OpenKNX/OpenKNX-REG1/doc/Pictures/Assembly-REG1-Dali/Originalgroesse/20240128_120950.jpg

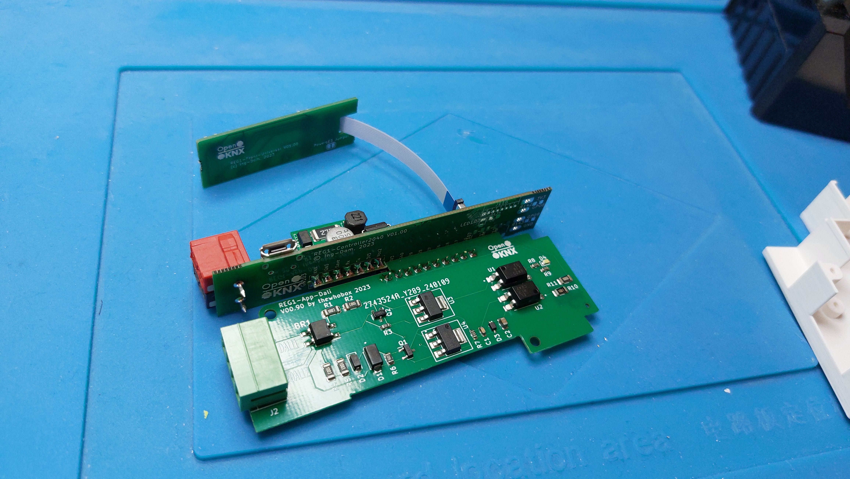
doc/Pictures/Assembly-REG1-Dali/Originalgroesse/20240128_120950.jpg
