OpenKNX/OpenKNX-REG1/doc/Pictures/Assembly-REG1-Eth/Originalgroesse/REG1-Eth_kit_RJ45soldered.jpg

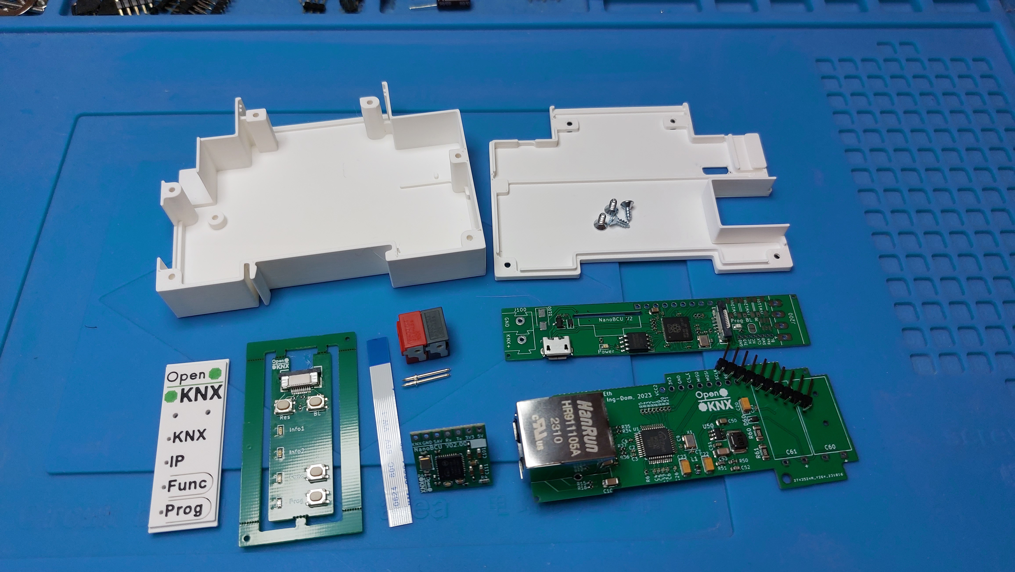
doc/Pictures/Assembly-REG1-Eth/Originalgroesse/REG1-Eth_kit_RJ45soldered.jpg
