OpenKNX/OpenKNX-REG1/README.md

# OpenKNX-REG1

see Wiki: https://github.com/OpenKNX/OpenKNX/wiki/OpenKNX-REG1
