OpenKNX/OpenKNX-REG1/doc/Labels/REG1-Dali_Label.png

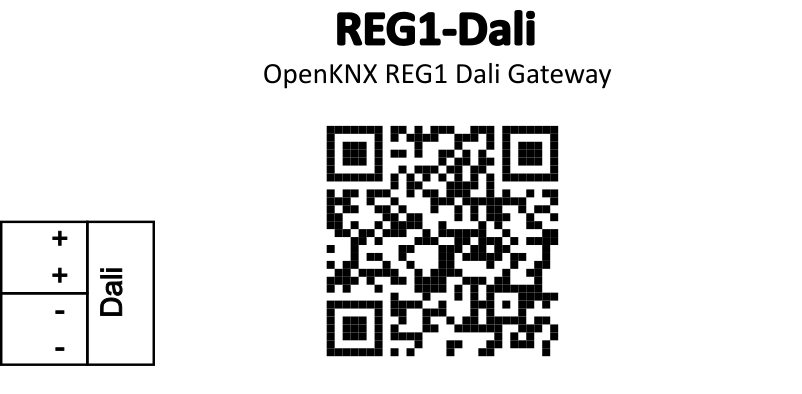
doc/Labels/REG1-Dali_Label.png
