OpenKNX/OpenKNX-REG1/doc/Labels/REG1-SA-4xSELV_Label.png

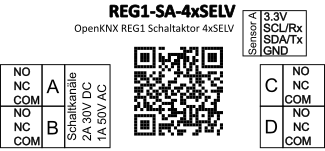
doc/Labels/REG1-SA-4xSELV_Label.png
