OpenKNX/OpenKNX-REG1/doc/Labels/REG1-SEN-Multi_Label.png

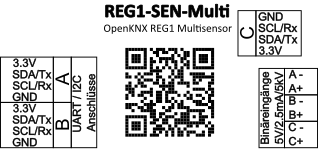
doc/Labels/REG1-SEN-Multi_Label.png
