OpenKNX/OpenKNX-REG1/doc/Pictures/REG1-Controller2040_V00.03_top.jpg

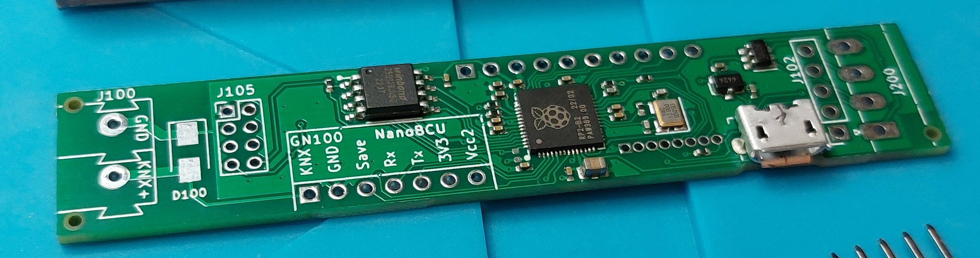
doc/Pictures/REG1-Controller2040_V00.03_top.jpg
