OpenKNX/OpenKNX-REG1/doc/Pictures/REG1-Controller2040_V1_top.jpg

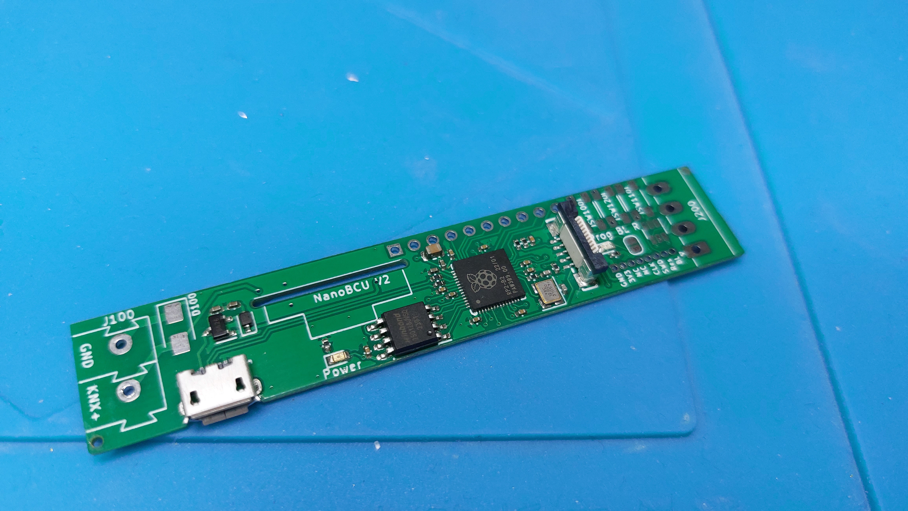
doc/Pictures/REG1-Controller2040_V1_top.jpg
