OpenKNX/OpenKNX-REG1/doc/Pictures/REG1-Frontabdeckung-IP-Router.jpg

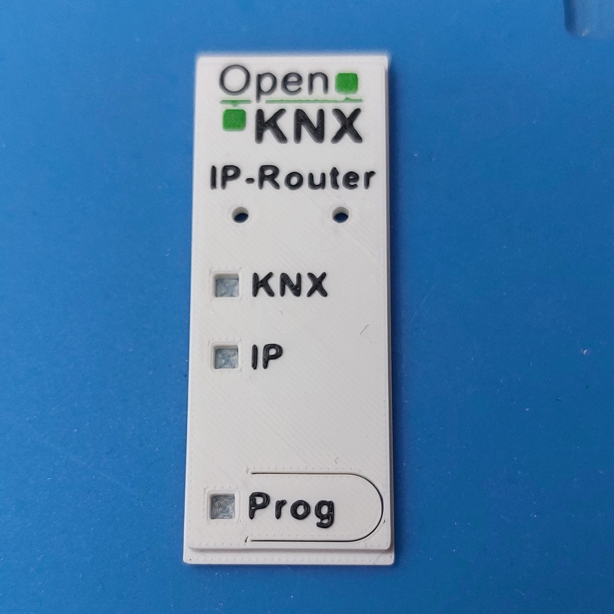
doc/Pictures/REG1-Frontabdeckung-IP-Router.jpg
