OpenKNX/OpenKNX-REG1/doc/Pictures/REG1-Frontabdeckung.jpg

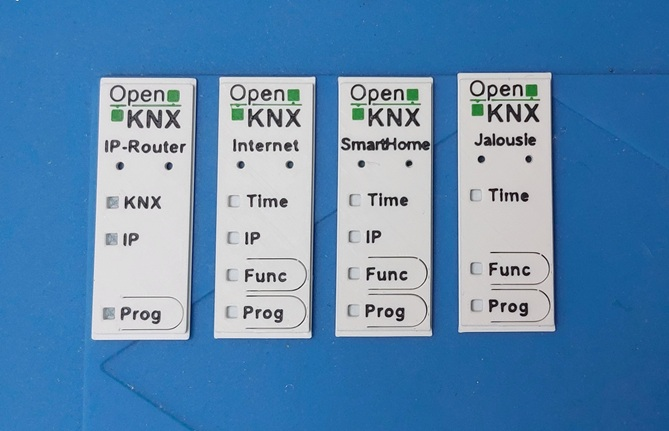
doc/Pictures/REG1-Frontabdeckung.jpg
