OpenKNX/OpenKNX-REG1/doc/REG1-Controller_Messpunkte.png

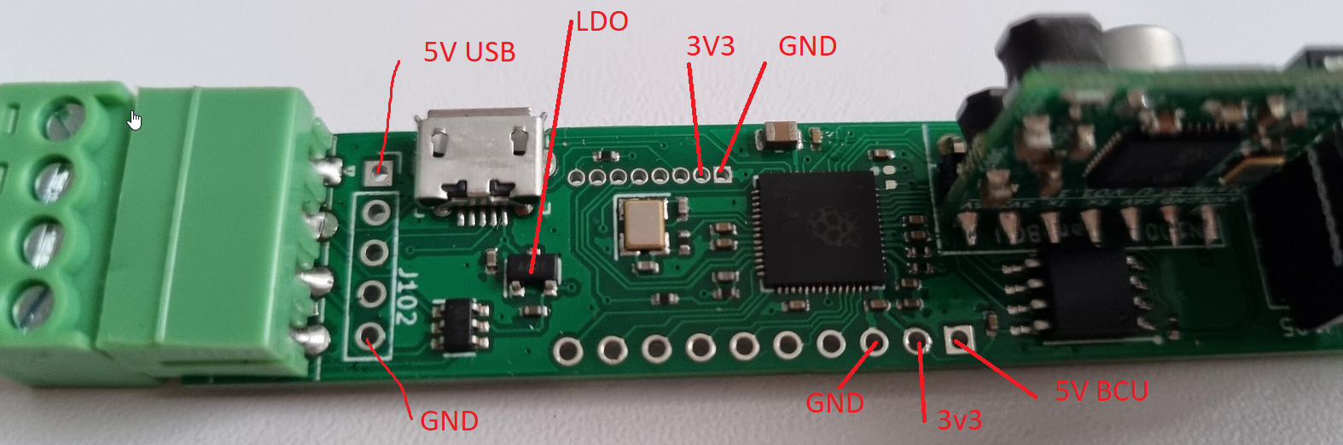
doc/REG1-Controller_Messpunkte.png
