OpenKNX/OpenKNX-REG1/doc/Renderings/OpenKNX_REG1_Base_and_App_Teaser_CATIA_open2.png

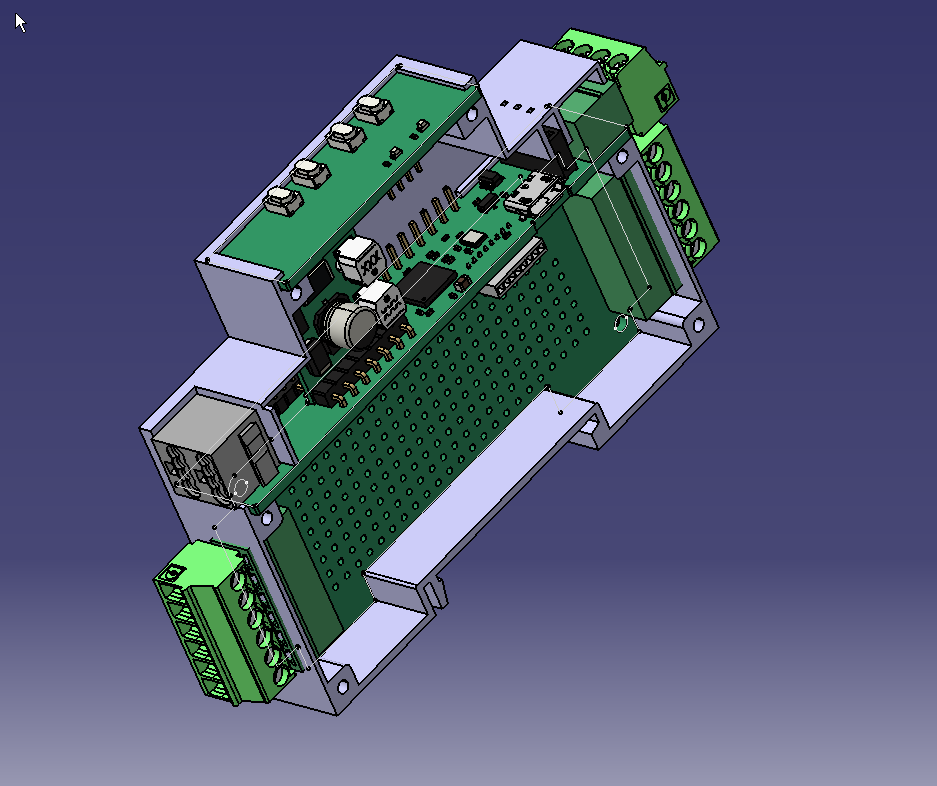
doc/Renderings/OpenKNX_REG1_Base_and_App_Teaser_CATIA_open2.png
