OpenKNX/OpenKNX-REG1/doc/Renderings/OpenKNX_REG1_Base_Teaser_CATIA.png

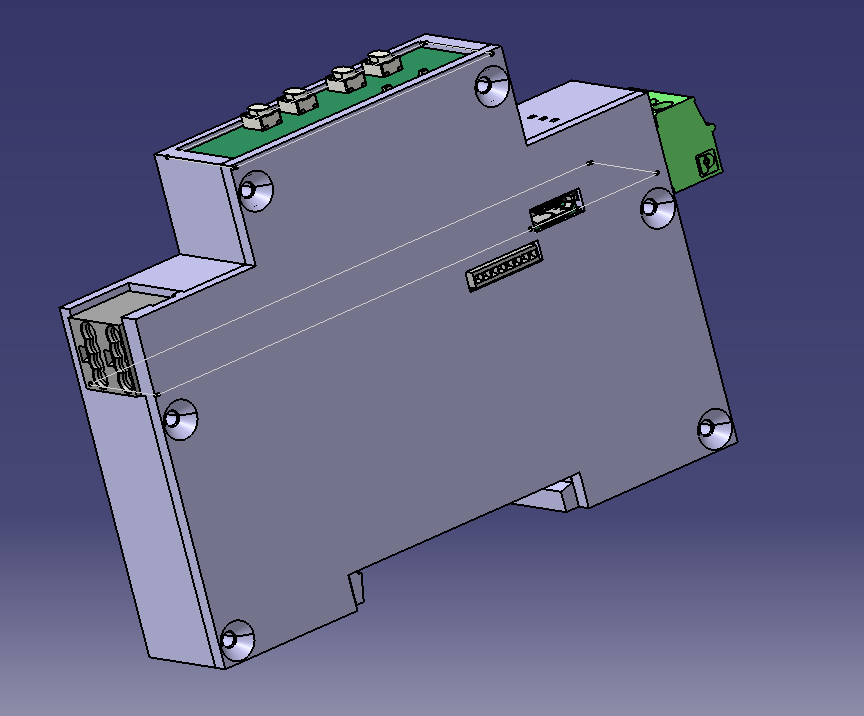
doc/Renderings/OpenKNX_REG1_Base_Teaser_CATIA.png
