OpenKNX/OpenKNX-REG1/doc/Renderings/OpenKNX_REG1_Module_Teaser_CATIA_open.png

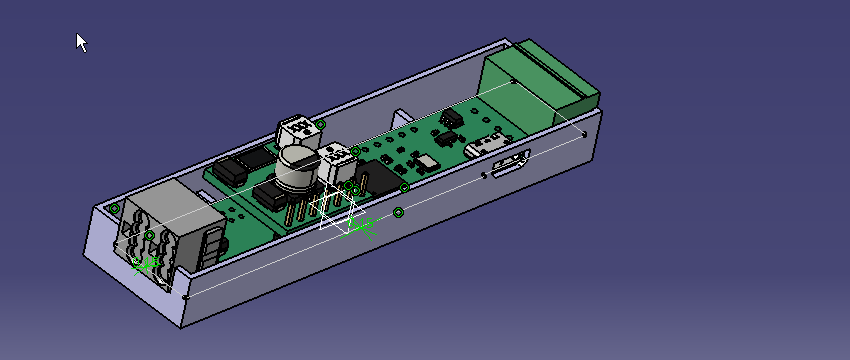
doc/Renderings/OpenKNX_REG1_Module_Teaser_CATIA_open.png
