OpenKNX/OpenKNX-REG1/doc/Renderings/REG1-App-Universal_V01.00_3D_PCB_TOP.png

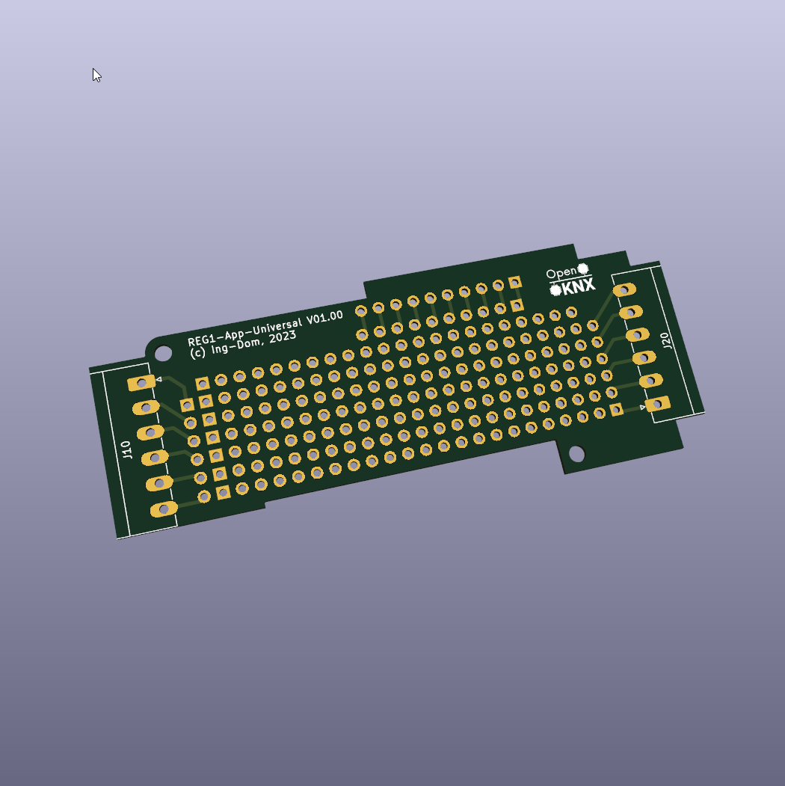
doc/Renderings/REG1-App-Universal_V01.00_3D_PCB_TOP.png
