OpenKNX/OpenKNX-REG1/doc/Renderings/REG1-Controller2040_V00.02_3D_BOT_wo_THT.png

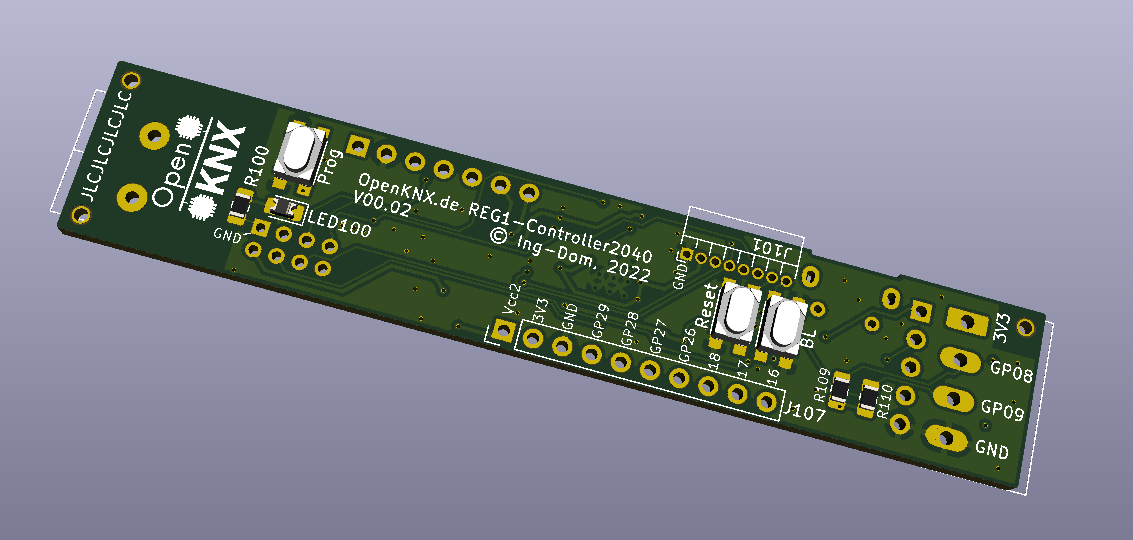
doc/Renderings/REG1-Controller2040_V00.02_3D_BOT_wo_THT.png
