OpenKNX/OpenKNX-REG1/doc/Renderings/REG1-Controller2040_V00.02_3D_TOP.png

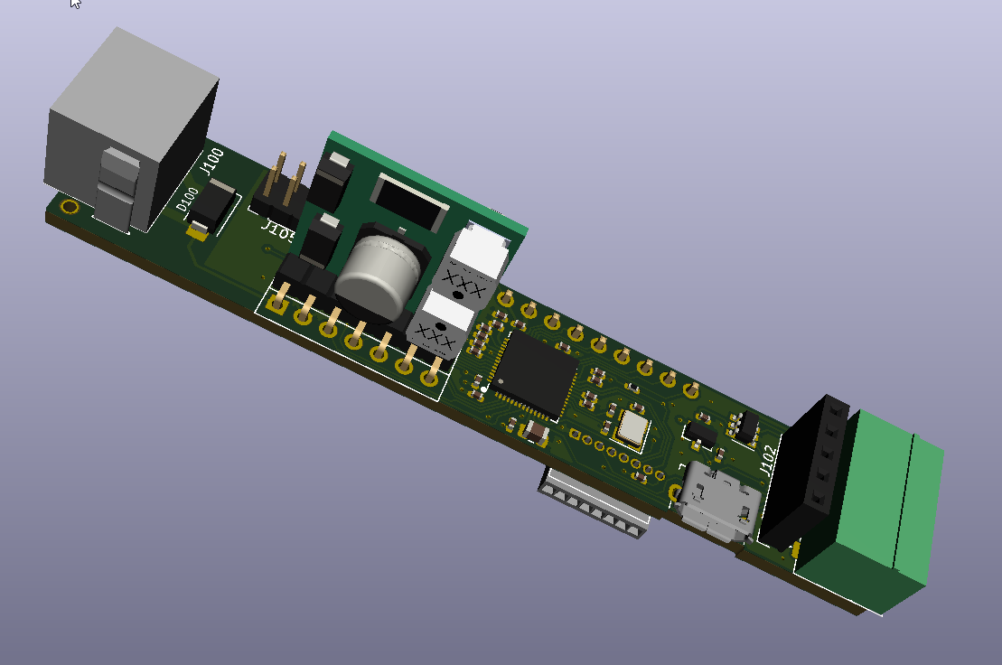
doc/Renderings/REG1-Controller2040_V00.02_3D_TOP.png
