OpenKNX/OpenKNX-REG1/doc/Renderings/REG1-Controller2040_V00.10_3D_wo_THT_BOT.png

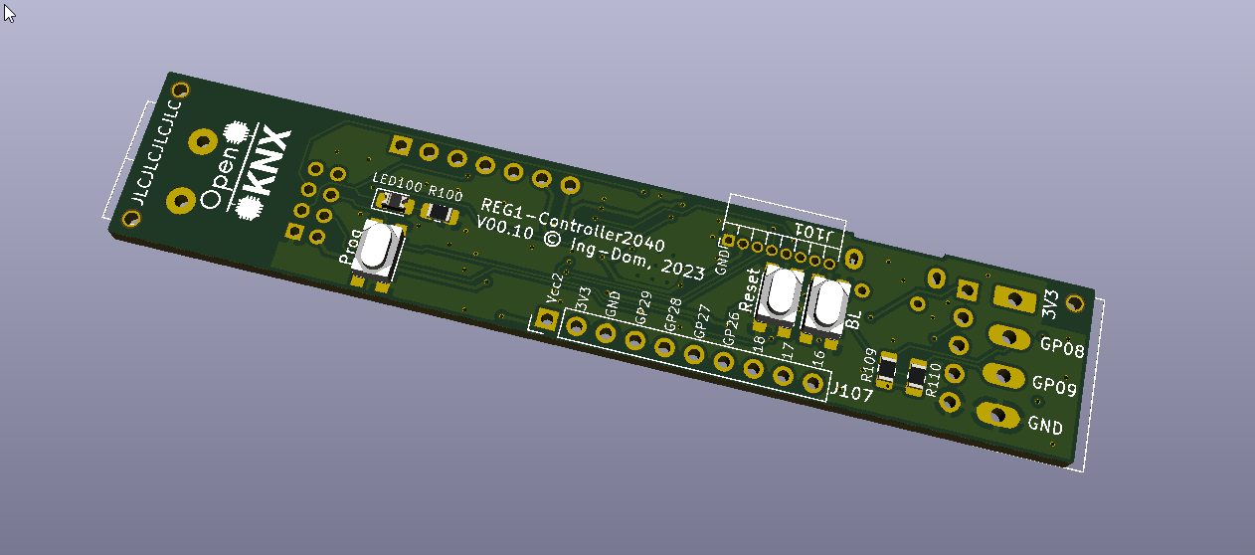
doc/Renderings/REG1-Controller2040_V00.10_3D_wo_THT_BOT.png
