OpenKNX/OpenKNX-REG1/hardware/CAD-Files/V01.2/Base/Reg1_Case_Main_wIO_V01.20.stl

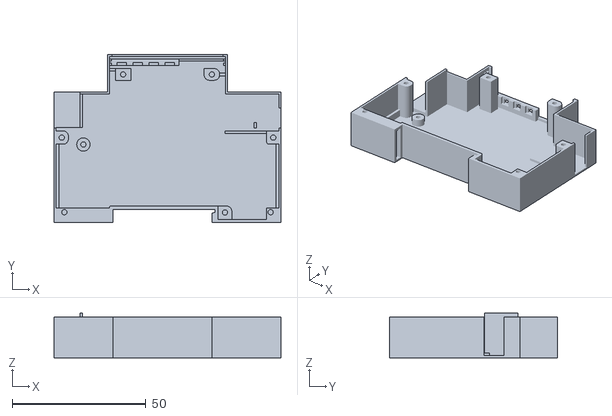
[picture p26: CAD file, 2025-07-13]
hardware/CAD-Files/V01.2/Base/Reg1_Case_Main_wIO_V01.20.stl
85.0 x 63.0 x 16.7
