OpenKNX/OpenKNX-REG1/hardware/CAD-Files/V01.2/LAN-Base/Reg1_CaseIP_Main_ESP_LAN_V01.20a.stl

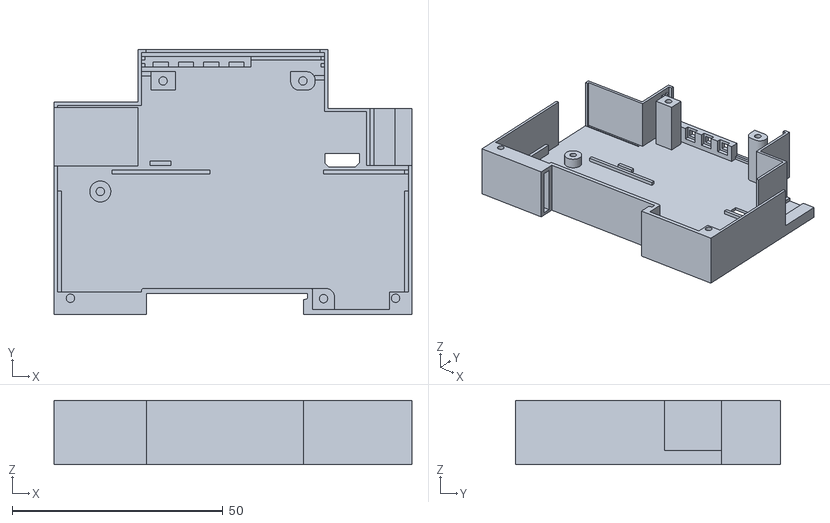
[picture p27: CAD file, 2025-07-31]
hardware/CAD-Files/V01.2/LAN-Base/Reg1_CaseIP_Main_ESP_LAN_V01.20a.stl
85.0 x 63.0 x 15.2
