OpenKNX/OpenKNX-REG1/hardware/CAD-Files/V01.2/SA-SELV/Reg1_Case_Main_wIO_SASELV_V01.20.stl

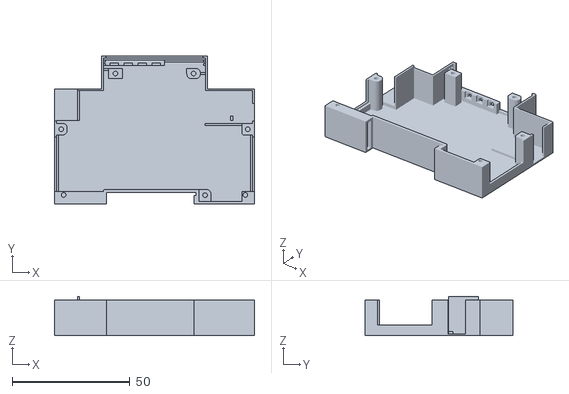
[picture p28: CAD file, 2025-08-14]
hardware/CAD-Files/V01.2/SA-SELV/Reg1_Case_Main_wIO_SASELV_V01.20.stl
85.0 x 63.0 x 16.7
