OpenKNX/OpenKNX-REG1/hardware/CAD-Files/V01.2/LAN-Base/Reg1_CaseIP_Main_ESP_LAN_v01.20.stl

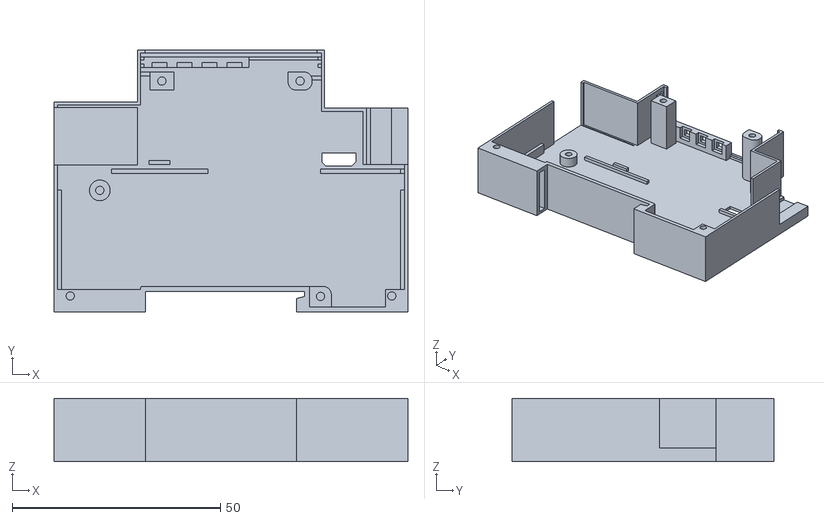
[picture p29: CAD file, 2025-07-13]
hardware/CAD-Files/V01.2/LAN-Base/Reg1_CaseIP_Main_ESP_LAN_v01.20.stl
85.0 x 63.0 x 15.2
