OpenKNX/OpenKNX-REG1/hardware/CAD-Files/V01.2/Dali/Reg1_Case_Cover_wDali_noDebug_noIO_V01.20.stl

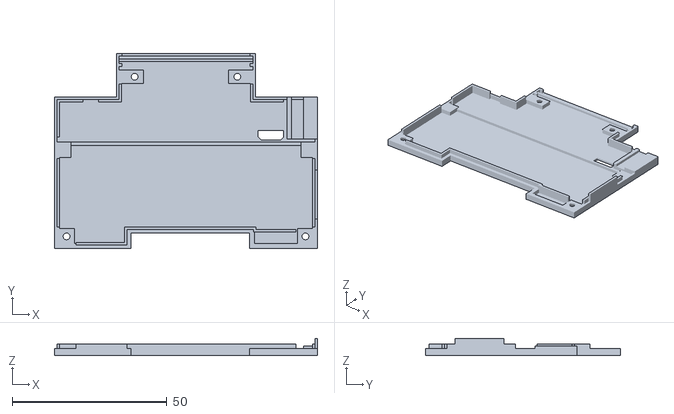
[picture p30: CAD file, 2025-02-02]
hardware/CAD-Files/V01.2/Dali/Reg1_Case_Cover_wDali_noDebug_noIO_V01.20.stl
85.0 x 63.0 x 5.60
