OpenKNX/OpenKNX-REG1/hardware/CAD-Files/V01.2/Reg1_Case_SpringClamp_V01.10.stl

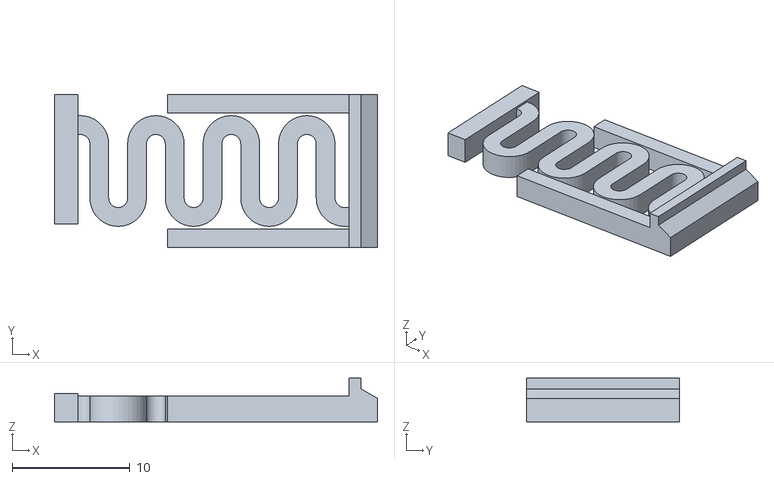
[picture p31: CAD file, 2025-08-14]
hardware/CAD-Files/V01.2/Reg1_Case_SpringClamp_V01.10.stl
27.4 x 13.0 x 3.70
