OpenKNX/OpenKNX-REG1/hardware/EDA-Files/NanoDCU/NanoDCU.step

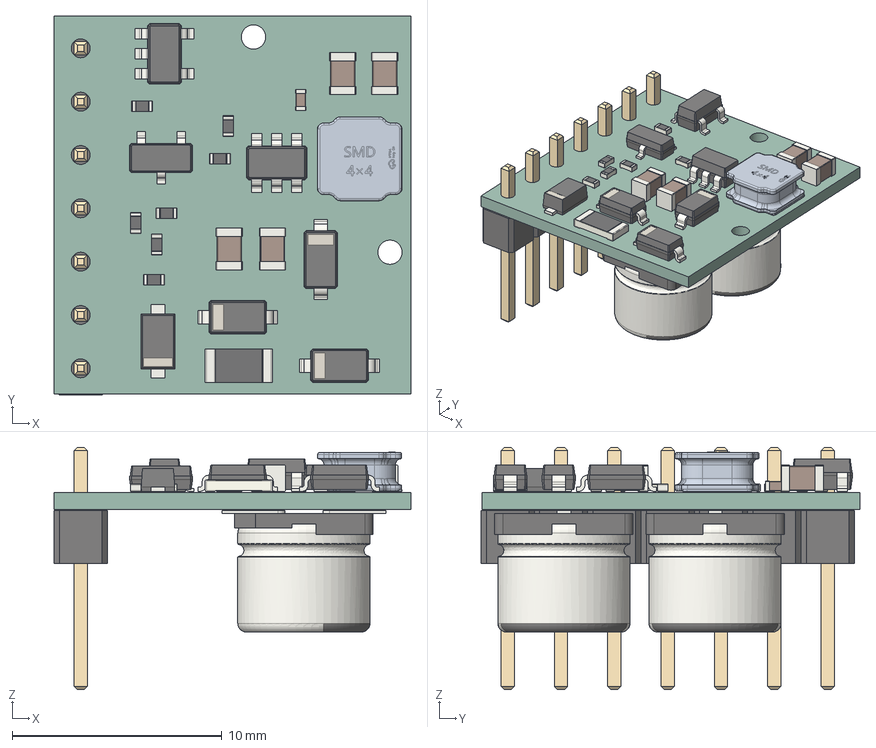
[picture p32: CAD file, 2026-04-14]
hardware/EDA-Files/NanoDCU/NanoDCU.step
17.0 x 18.0 x 11.5 mm
D_SOD_123 x 3
SOT_23_5
R_0402_1005Metric x 7
L1
C_0805_2012Metric x 4
SOT_23
SOT_23_6
Fuse_1206_3216Metric
C_0402_1005Metric
D_SOD_123F
PinHeader_1x07_P254mm_Vertical
CP_Elec_63x58 x 2
NanoDCU_PCB
