OpenKNX/OpenKNX-REG1/hardware/EDA-Files/REG1-App-2xDALI/REG1-App-2xDALI_V00.01.step

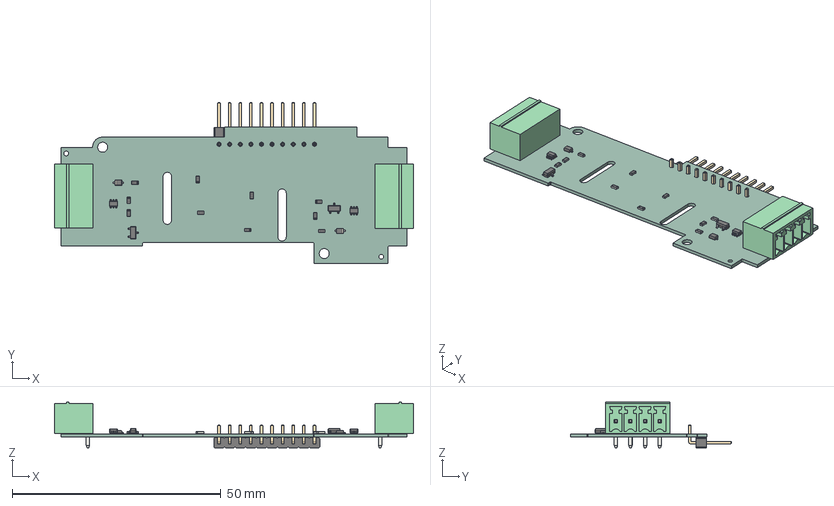
[picture p33: CAD file, 2025-02-02]
hardware/EDA-Files/REG1-App-2xDALI/REG1-App-2xDALI_V00.01.step
86.0 x 38.6 x 11.0 mm
SOT_363_SC_70_6 x 2
R_0603_1608Metric x 10
MC_01x04_G_3_5mm x 2
D_SOD_323F x 2
SOT_23 x 2
PinHeader_1x10_P254mm_Horizontal
REG1-App-2xDALI_PCB
