OpenKNX/OpenKNX-REG1/hardware/EDA-Files/REG1-App-GW-RF2G4/REG1-App-GW-RF2G4_V00.01.step

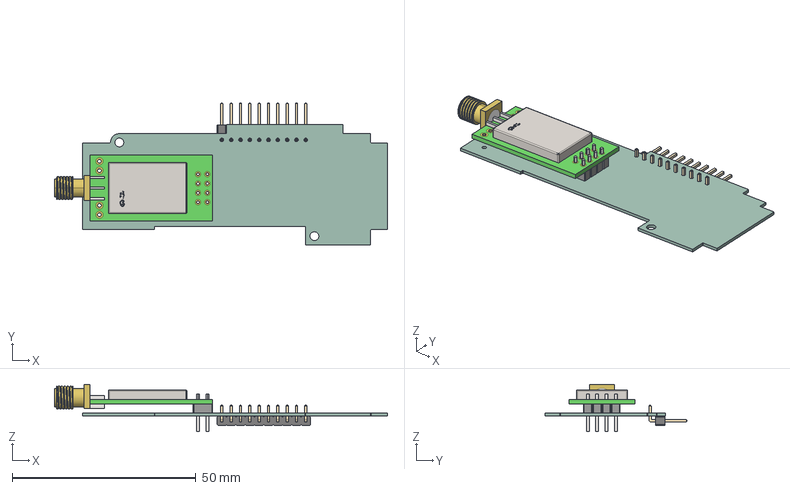
[picture p34: CAD file, 2024-08-03]
hardware/EDA-Files/REG1-App-GW-RF2G4/REG1-App-GW-RF2G4_V00.01.step
90.7 x 38.6 x 12.8 mm
REG1-App-GW-RF2G4 PCB
