OpenKNX/OpenKNX-REG1/hardware/EDA-Files/REG1-App-SA-4xSELV/REG1-App-SA-4xSELV.step

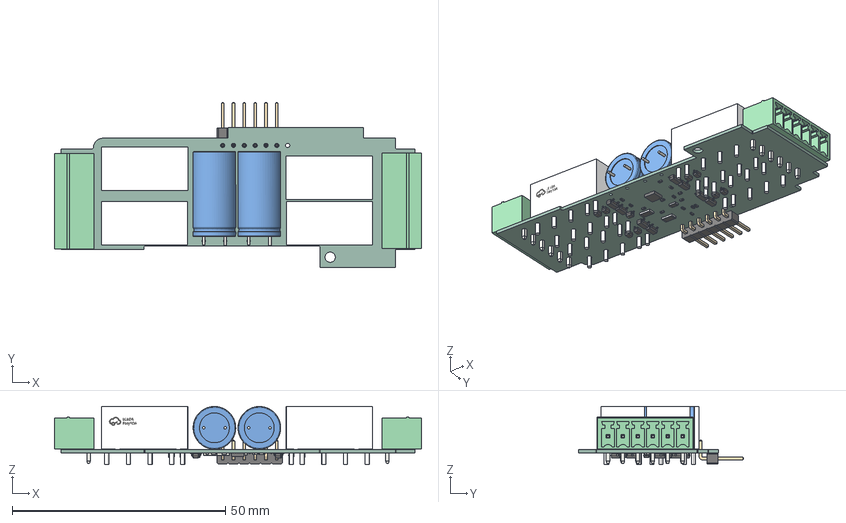
[picture p35: CAD file, 2025-08-14]
hardware/EDA-Files/REG1-App-SA-4xSELV/REG1-App-SA-4xSELV.step
86.0 x 38.6 x 13.6 mm
MC_01x06_G_3_5mm x 2
C_Radial_D100mm_H200mm_P500mm x 2
RELAY-TH_HFD2-X-X-L2-X x 4
PinHeader_1x06_P254mm_Horizontal
R_0402_1005Metric x 14
D_SOD_323 x 9
R_0805_2012Metric
SOT_23 x 8
R_1206_3216Metric x 2
QFN-16-1EP_3x3mm_P0.5mm_EP1.7x1.7mm
REG1-App-SA-4xSELV_PCB
