OpenKNX/OpenKNX-REG1/hardware/EDA-Files/REG1-App-Universal/REG1-App-Universal_V01.10.step

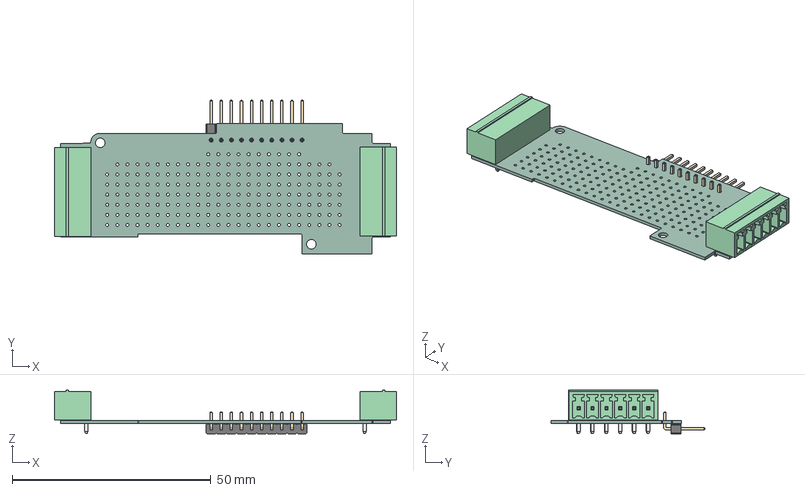
[picture p36: CAD file, 2024-12-03]
hardware/EDA-Files/REG1-App-Universal/REG1-App-Universal_V01.10.step
86.0 x 38.6 x 11.0 mm
MC_01x06_G_3_5mm x 2
PinHeader_1x10_P254mm_Horizontal
REG1-App-Universal_PCB
