OpenKNX/OpenKNX-REG1/hardware/CAD-Files/V01.2/Base/Reg1_Case_Cover_wIO_wDebug_V01.20.stl

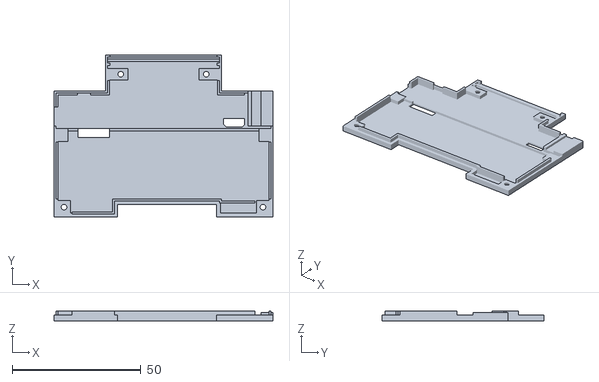
[picture p37: CAD file, 2025-07-13]
hardware/CAD-Files/V01.2/Base/Reg1_Case_Cover_wIO_wDebug_V01.20.stl
85.0 x 63.0 x 3.80
