OpenKNX/OpenKNX-REG1/hardware/CAD-Files/V01.2/Eth/Reg1_Case_Cover_wEth_noDebug_noIO_V01.20.stl

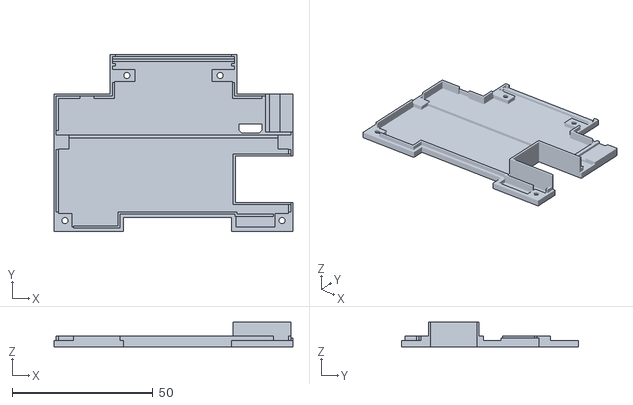
[picture p38: CAD file, 2025-07-13]
hardware/CAD-Files/V01.2/Eth/Reg1_Case_Cover_wEth_noDebug_noIO_V01.20.stl
85.0 x 63.0 x 8.80
