OpenKNX/OpenKNX-REG1/hardware/CAD-Files/V01.2/REG1-Case-Front-Universal_RGB_Diffusor_V01.20.stl

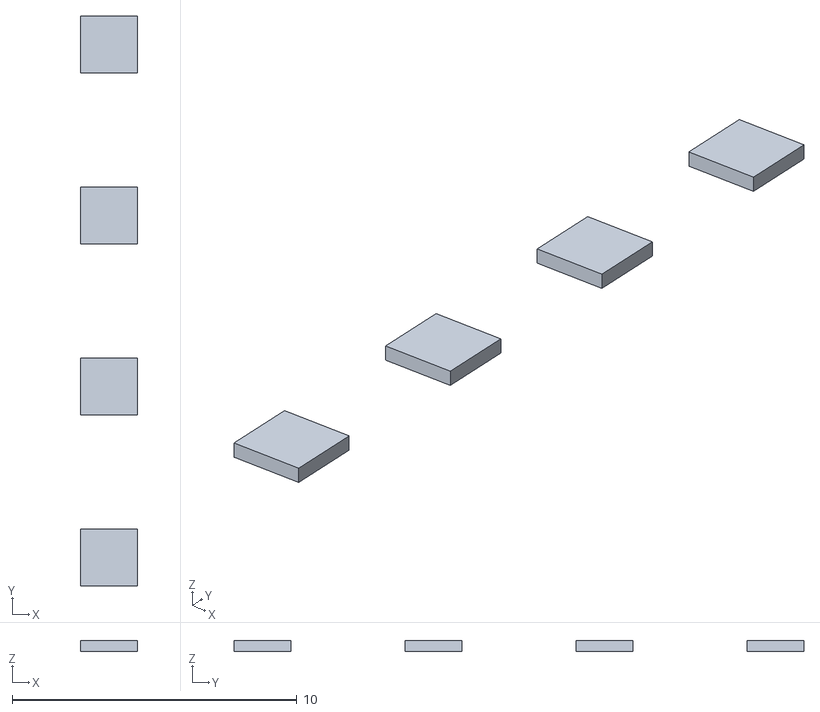
[picture p39: CAD file, 2025-07-13]
hardware/CAD-Files/V01.2/REG1-Case-Front-Universal_RGB_Diffusor_V01.20.stl
2.00 x 20.0 x 0.4
