OpenKNX/OpenKNX-REG1/hardware/CAD-Files/V01.2/REG1-Case-Front-Universal_RGB_V01.20.stl

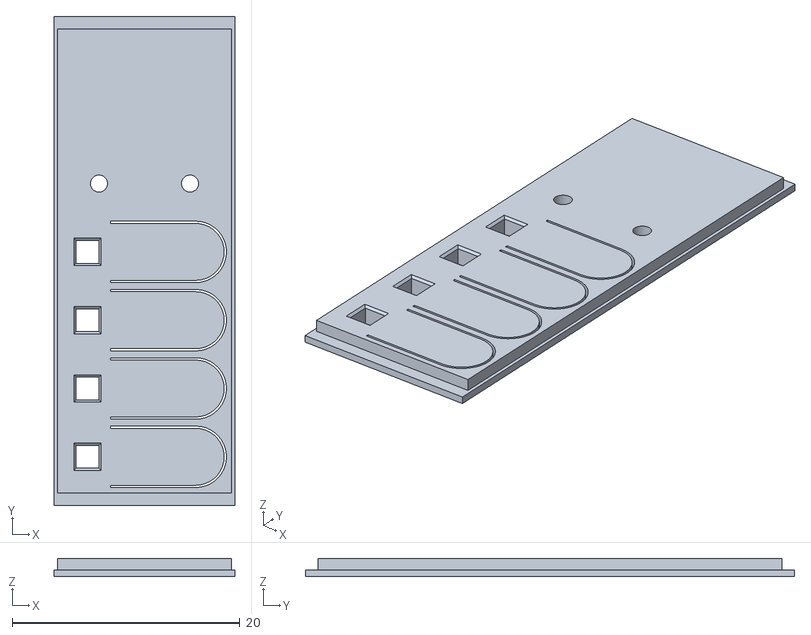
[picture p40: CAD file, 2025-02-02]
hardware/CAD-Files/V01.2/REG1-Case-Front-Universal_RGB_V01.20.stl
15.9 x 43.0 x 1.60
