OpenKNX/OpenKNX-REG1/(list of files, cad)

Other CAD files:
hardware/CAD-Files/V01.2/Eth/Reg1_Case_Main_wEth_noSD_noIO_V01.20.stl
hardware/CAD-Files/V01.2/LAN-Dali/Reg1_CaseIP_Main_LAN-Dali_V01.20.stl
hardware/CAD-Files/V01.2/Universal/Reg1_Case_Main_Universal_V01.20.stl
hardware/CAD-Files/V01.2/Dali/Reg1_Case_Main_wDali_noIO_V01.20.stl
hardware/CAD-Files/V01.2/SEN-Multi/Reg1_Case_Main_wIO_SENMULTI_wRJ11_V01.20.stl
hardware/CAD-Files/V01.2/SEN-Multi/Reg1_Case_Cover_wDebug_SEN-MULTI_RJ11_V01.20.stl
hardware/CAD-Files/V01.2/LAN-Base/Reg1_CaseIP_Cover_ESP_LAN_V01.20.stl
hardware/CAD-Files/V01.2/LAN-Dali/Reg1_CaseIP_Cover_LAN-Dali_V01.20.stl
hardware/CAD-Files/V01.2/SA-SELV/Reg1_Case_Cover_wIO_noDebug_SA-SELV_V01.20.stl
hardware/CAD-Files/V01.2/Universal/Reg1_Case_Cover_Universal_wDebug_V01.20.stl
hardware/CAD-Files/V01.2/Base/Reg1_Case_Cover_wIO_noDebug_V01.20.stl
hardware/CAD-Files/V01.2/Dali/Reg1_Case_Cover_wDali_wDebug_noIO_V01.20.stl
hardware/CAD-Files/V01.2/Eth/Reg1_Case_Cover_wEth_wDebug_noIO_V01.20.stl
hardware/CAD-Files/V01.2/SA-SELV/Reg1_Case_Cover_wIO_wDebug_SA-SELV_V01.20.stl
hardware/CAD-Files/V01.2/SEN-Multi/Reg1_Case_Cover_noDebug_SEN-MULTI_RJ11_V01.20.stl
hardware/CAD-Files/V01.2/Universal/Reg1_Case_Cover_Universal_V01.20.stl
hardware/CAD-Files/V0/REG1-Controller-Module-Case-Bottom.stl
hardware/CAD-Files/V0/REG1-Controller-Module-Case-Top.stl
hardware/CAD-Files/V0/Reg1_Case_Cover.stl
hardware/CAD-Files/V0/Reg1_Case_Cover_SWD.stl
hardware/CAD-Files/V0/Reg1_Main_Case.stl
hardware/CAD-Files/V01/REG1-Case-Front-Universal_V01.00.stl
hardware/CAD-Files/V01/REG1-Case-Front-Universal_V01.00_Base.3mf
hardware/CAD-Files/V01/REG1-Case-Front-Universal_V01.00_Dali.3mf
hardware/CAD-Files/V01/REG1-Case-Front-Universal_V01.00_Eth.3mf
hardware/CAD-Files/V01/REG1-Case-Front-Universal_V01.00_wLogo_wText_all.3mf
hardware/CAD-Files/V01/Reg1_CaseIP_Cover_V01.00.stl
hardware/CAD-Files/V01/Reg1_CaseIP_Cover_wApp_V01.00.stl
hardware/CAD-Files/V01/Reg1_CaseIP_Main_V01.00.stl
hardware/CAD-Files/V01/Reg1_CaseIP_Main_wApp_V01.00.stl
hardware/CAD-Files/V01/Reg1_Case_Cover_wApp_wDebug_wIO_V01.00.stl
hardware/CAD-Files/V01/Reg1_Case_Cover_wDali_noDebug_noIO_V01.00.stl
hardware/CAD-Files/V01/Reg1_Case_Cover_wEth_noDebug_noIO_V01.00.stl
hardware/CAD-Files/V01/Reg1_Case_Cover_wEth_noIO_V01.00.stl
hardware/CAD-Files/V01/Reg1_Case_Cover_wIO_noDebug_V01.00.stl
hardware/CAD-Files/V01/Reg1_Case_Cover_wIO_wDebug_V01.00.stl
hardware/CAD-Files/V01/Reg1_Case_Main_wApp_wIO_V01.00.stl
hardware/CAD-Files/V01/Reg1_Case_Main_wDali_noIO_V01.00.stl
hardware/CAD-Files/V01/Reg1_Case_Main_wEth_wIO_V01.00.stl
hardware/CAD-Files/V01/Reg1_Case_Main_wEth_wSD_noIO_V01.00.stl
hardware/CAD-Files/V01/Reg1_Case_Main_wIO_V01.00.stl
hardware/CAD-Files/V01/Reg1_Case_SpringClamp.stp
