OpenKNX/OpenKNX-REG1/doc/Pictures/Assembly-REG1-Base-IP/Originalgroesse/REG1-Base-IP_Assembly02.jpg

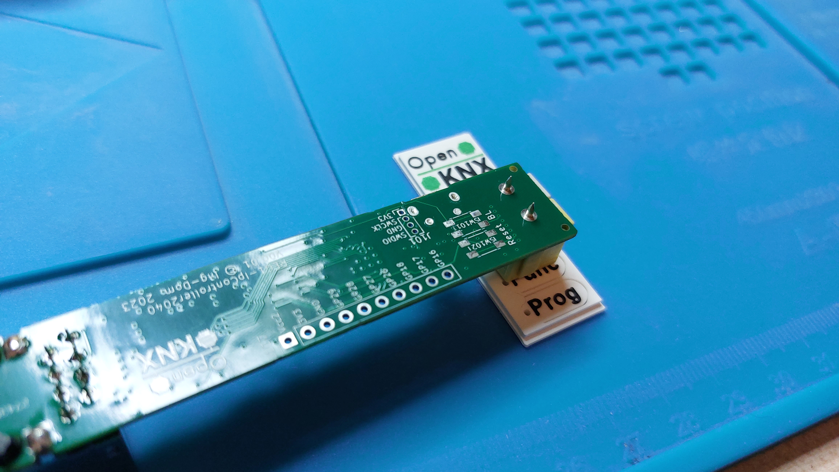
doc/Pictures/Assembly-REG1-Base-IP/Originalgroesse/REG1-Base-IP_Assembly02.jpg
