OpenKNX/OpenKNX-REG1/doc/Pictures/Assembly-REG1-Base-IP/Originalgroesse/REG1-Base-IP_Assembly03.jpg

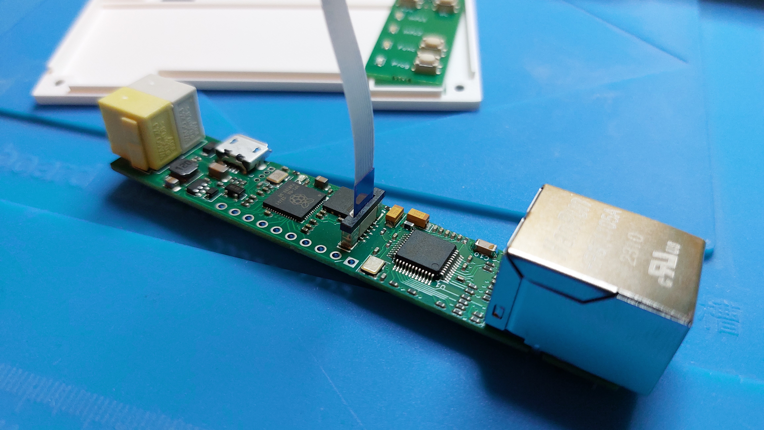
doc/Pictures/Assembly-REG1-Base-IP/Originalgroesse/REG1-Base-IP_Assembly03.jpg
