OpenKNX/OpenKNX-REG1/doc/Pictures/Assembly-REG1-Base-IP/REG1-Base-IP.jpg

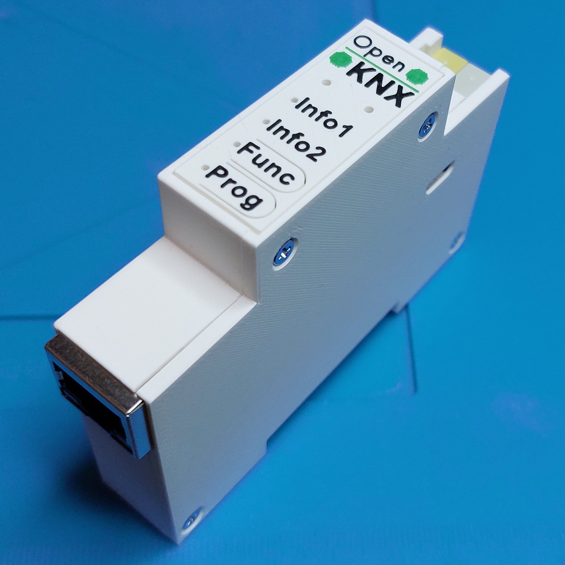
doc/Pictures/Assembly-REG1-Base-IP/REG1-Base-IP.jpg
