OpenKNX/OpenKNX-REG1/doc/Pictures/Assembly-REG1-Base/20221120_205541 (Mittel).jpg

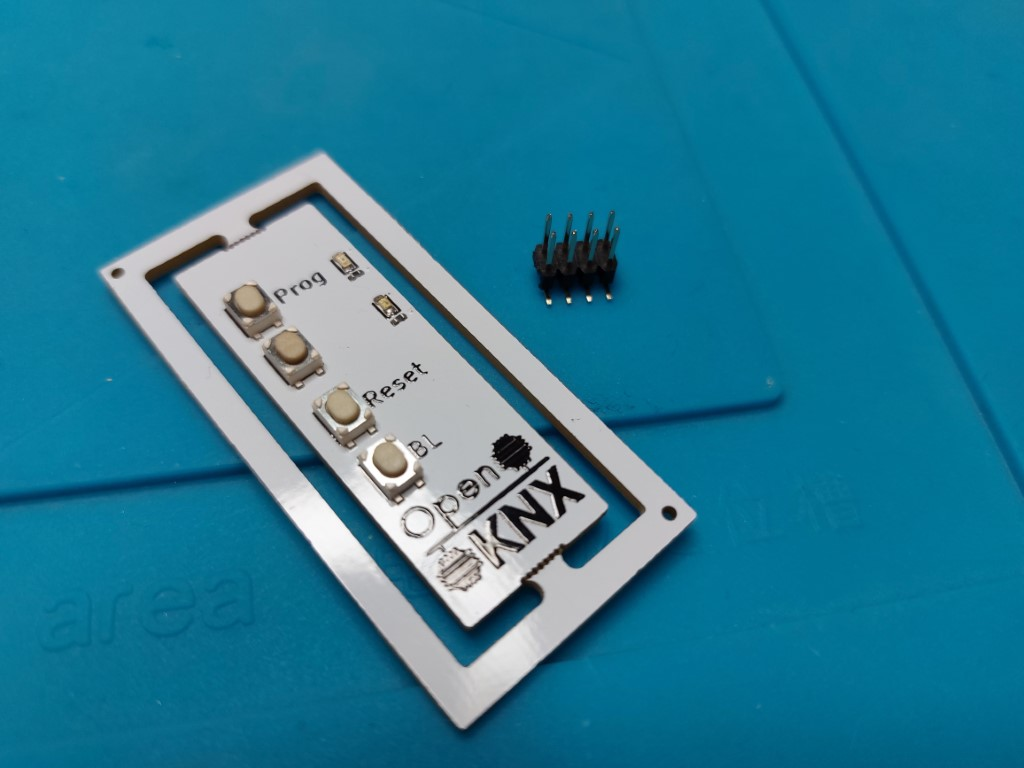
doc/Pictures/Assembly-REG1-Base/20221120_205541 (Mittel).jpg
