OpenKNX/OpenKNX-REG1/doc/Pictures/Assembly-REG1-Base/20221120_210241 (Mittel).jpg

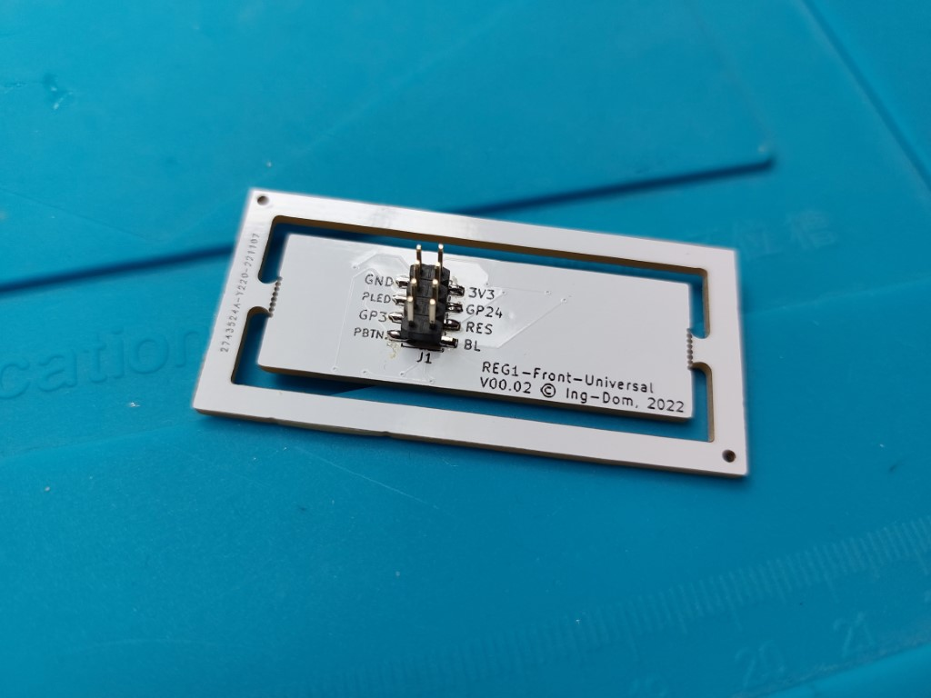
doc/Pictures/Assembly-REG1-Base/20221120_210241 (Mittel).jpg
