OpenKNX/OpenKNX-REG1/doc/Pictures/Assembly-REG1-Base/20221121_093125.jpg

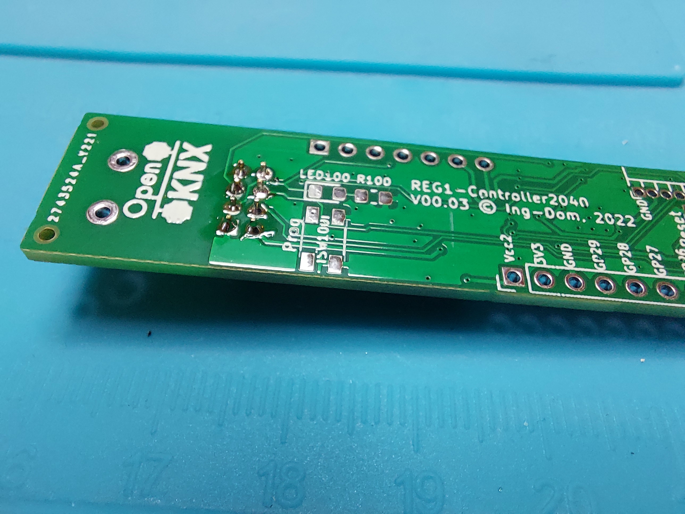
doc/Pictures/Assembly-REG1-Base/20221121_093125.jpg
