OpenKNX/OpenKNX-REG1/doc/Pictures/Assembly-REG1-Base/20221121_113550 (Mittel).jpg

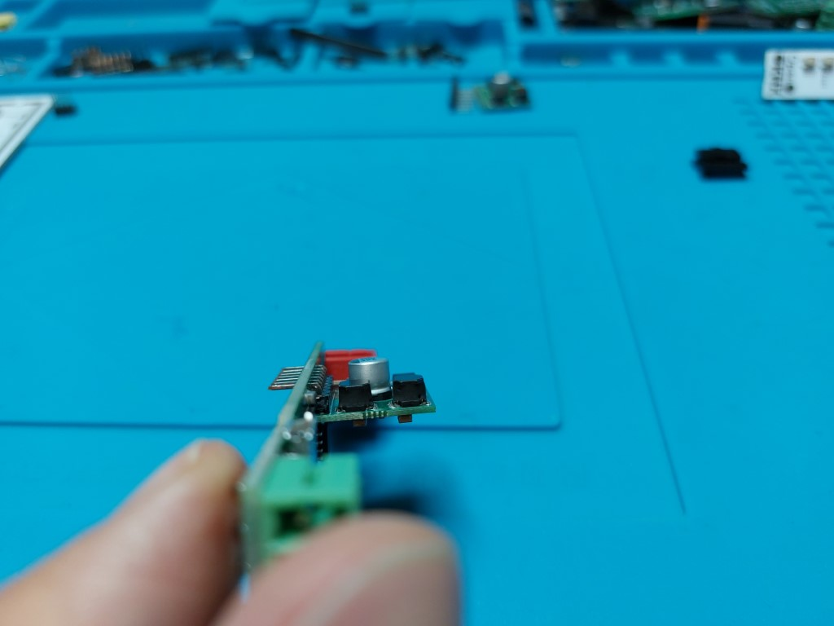
doc/Pictures/Assembly-REG1-Base/20221121_113550 (Mittel).jpg
