OpenKNX/OpenKNX-REG1/doc/Pictures/Assembly-REG1-Base/20221121_114242 (Mittel).jpg

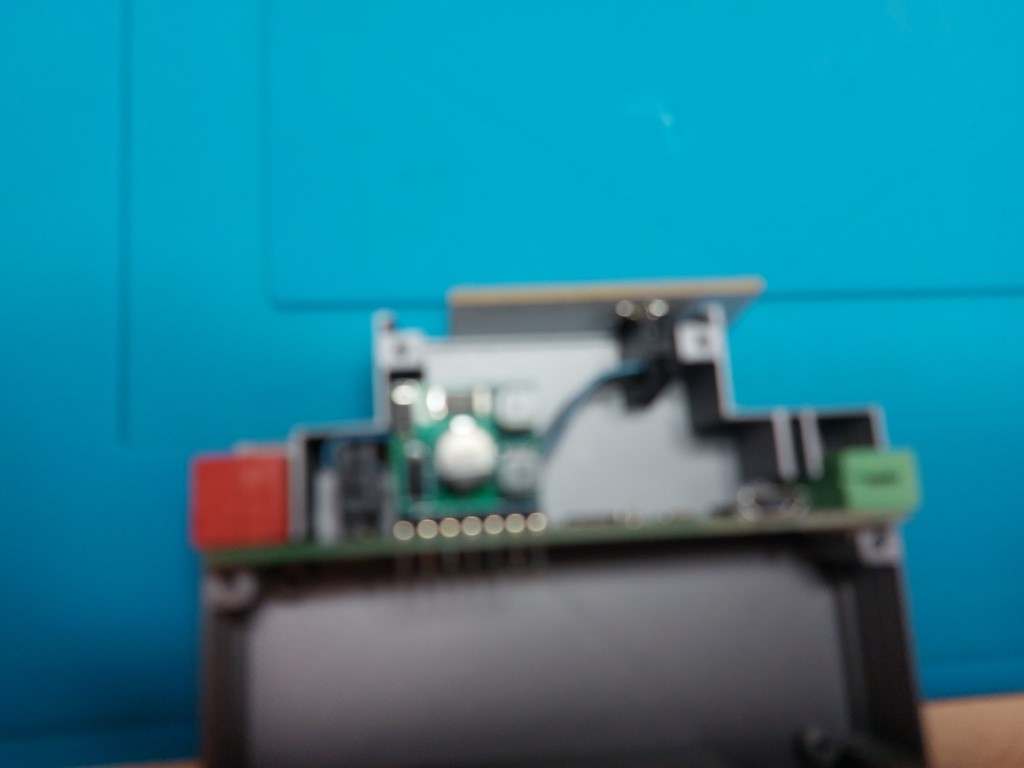
doc/Pictures/Assembly-REG1-Base/20221121_114242 (Mittel).jpg
