OpenKNX/OpenKNX-REG1/doc/Pictures/Assembly-REG1-Base/IMG_20221104_085111029 (Mittel).jpg

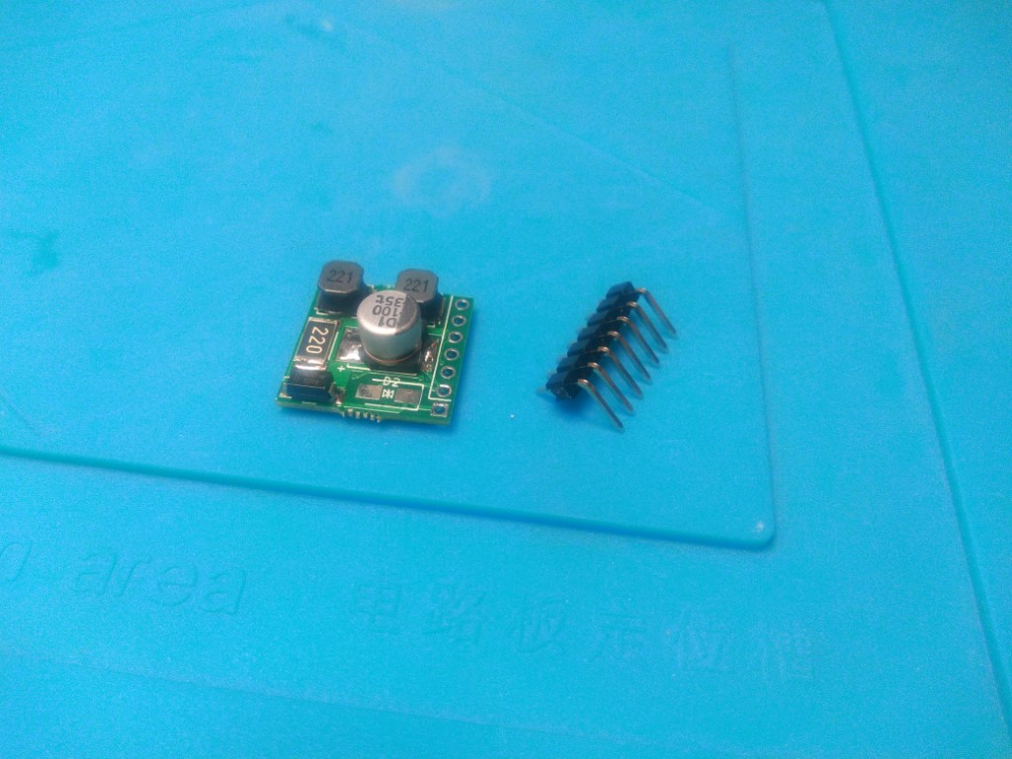
doc/Pictures/Assembly-REG1-Base/IMG_20221104_085111029 (Mittel).jpg
