OpenKNX/OpenKNX-REG1/doc/Pictures/Assembly-REG1-Base/REG1-Base-V0.jpg

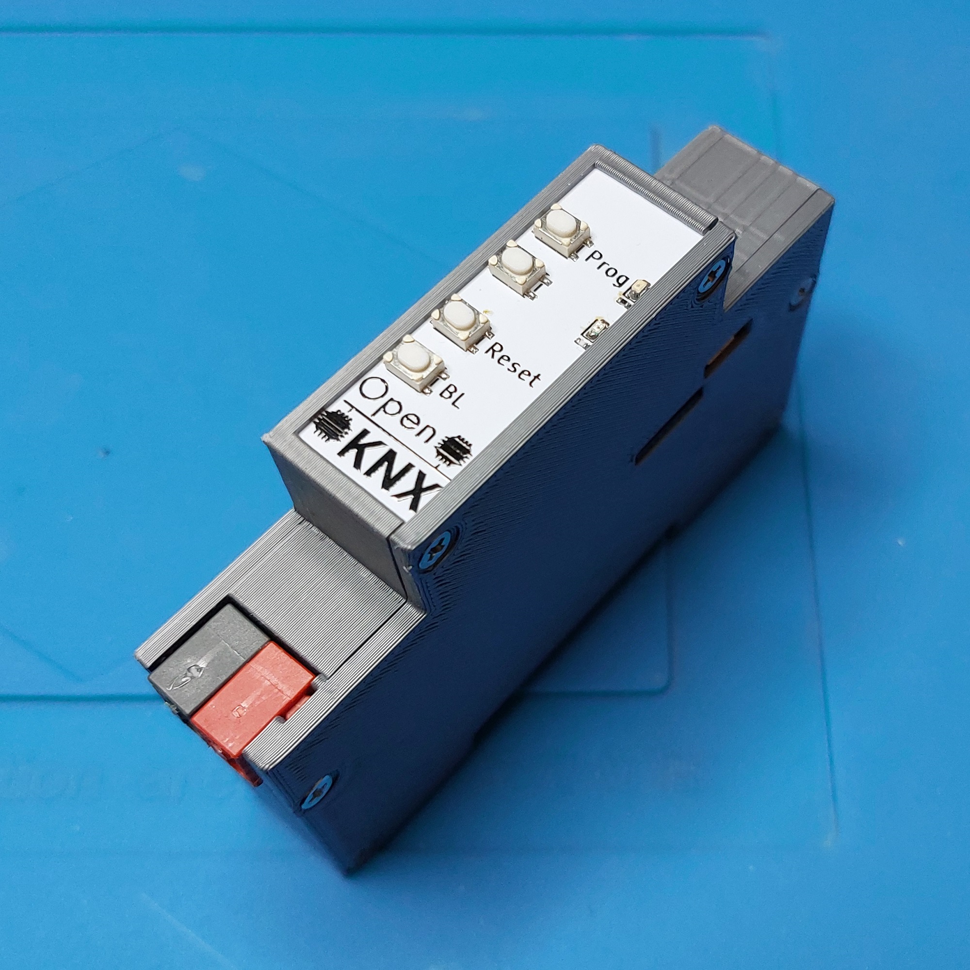
doc/Pictures/Assembly-REG1-Base/REG1-Base-V0.jpg
