OpenKNX/OpenKNX-REG1/doc/Pictures/Assembly-REG1-Dali/Originalgroesse/20231205_174253.jpg

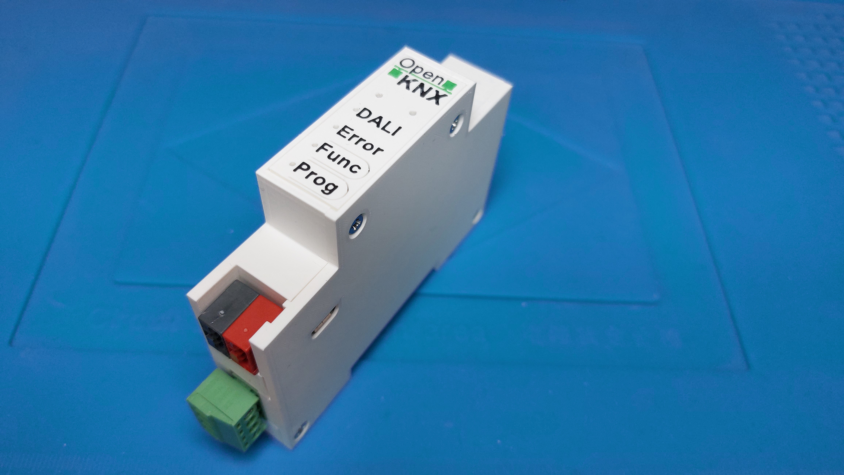
doc/Pictures/Assembly-REG1-Dali/Originalgroesse/20231205_174253.jpg
