OpenKNX/OpenKNX-REG1/doc/Pictures/Assembly-REG1-Dali/Originalgroesse/20240128_120023.jpg

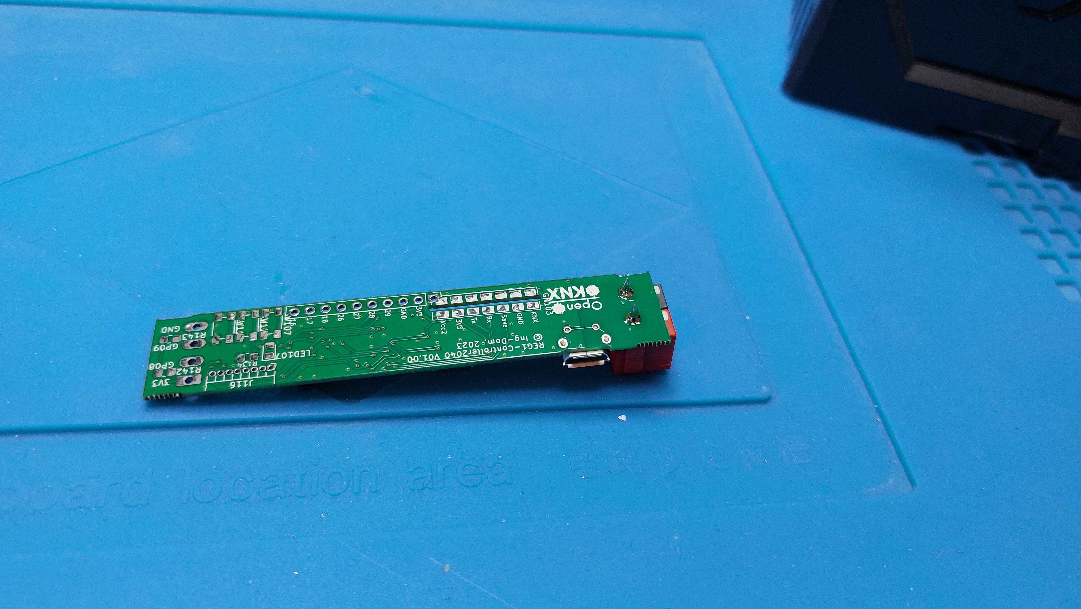
doc/Pictures/Assembly-REG1-Dali/Originalgroesse/20240128_120023.jpg
