OpenKNX/OpenKNX-REG1/doc/Pictures/Assembly-REG1-Dali/Originalgroesse/20240128_121149.jpg

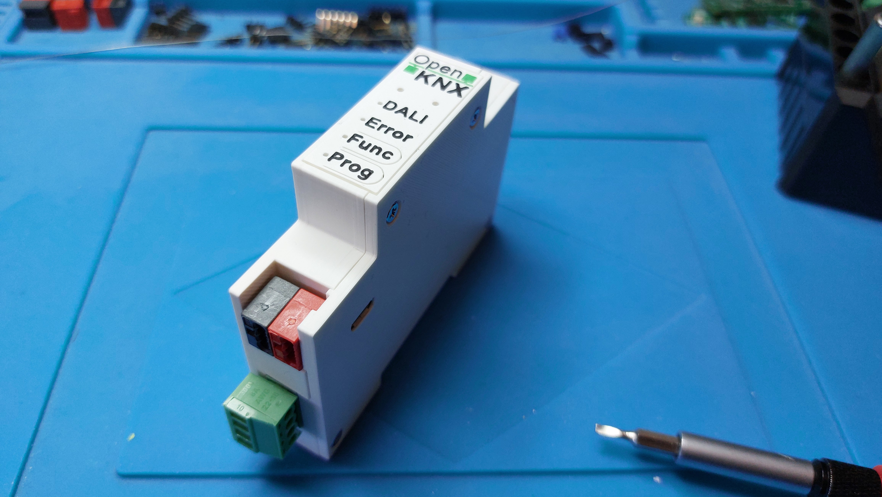
doc/Pictures/Assembly-REG1-Dali/Originalgroesse/20240128_121149.jpg
