OpenKNX/OpenKNX-REG1/doc/Pictures/Assembly-REG1-Dali/REG1-Dali.jpg

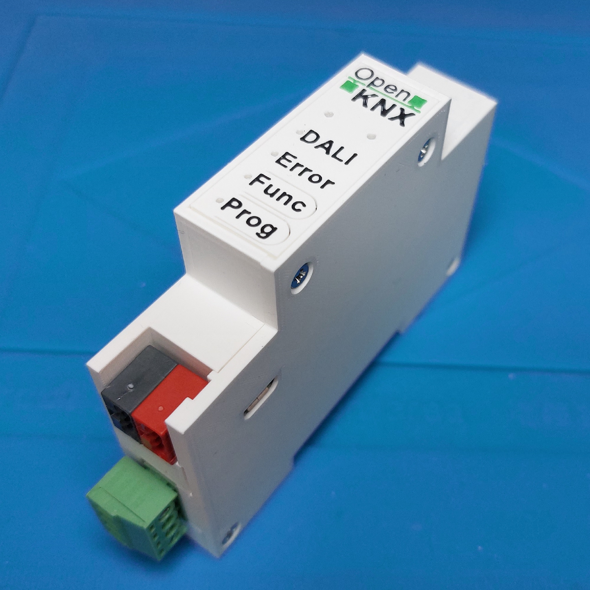
doc/Pictures/Assembly-REG1-Dali/REG1-Dali.jpg
