OpenKNX/OpenKNX-REG1/doc/Pictures/Assembly-REG1-Dali/REG1-Dali_V01.20.jpg

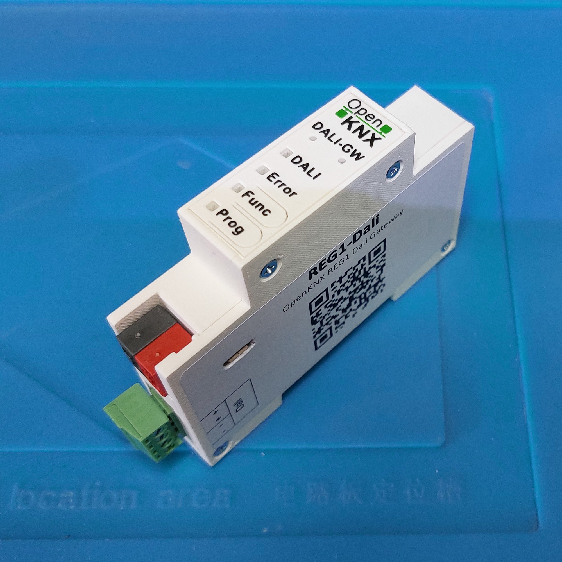
doc/Pictures/Assembly-REG1-Dali/REG1-Dali_V01.20.jpg
