OpenKNX/OpenKNX-REG1/doc/Pictures/Assembly-REG1-Eth/Originalgroesse/REG1-Eth_Assembly02.jpg

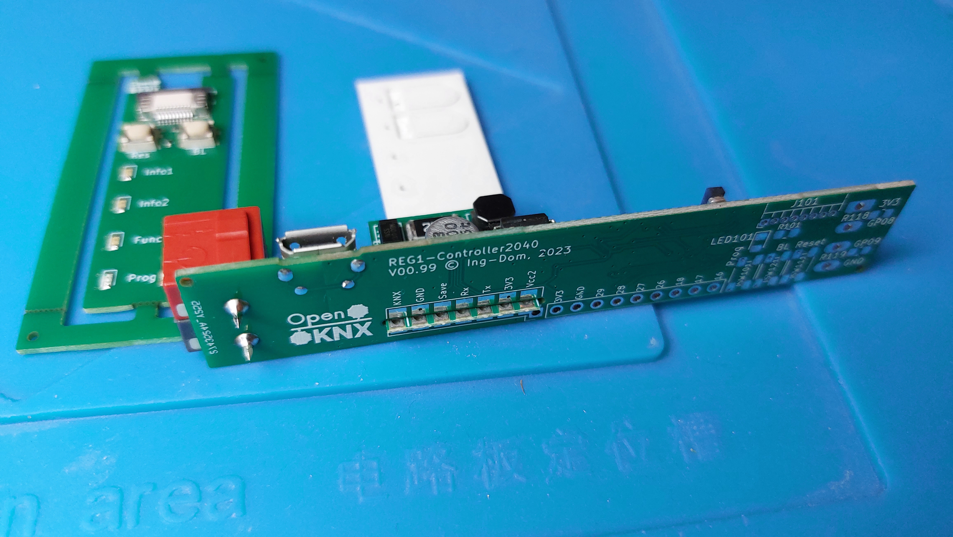
doc/Pictures/Assembly-REG1-Eth/Originalgroesse/REG1-Eth_Assembly02.jpg
