OpenKNX/OpenKNX-REG1/doc/Pictures/Assembly-REG1-Eth/Originalgroesse/REG1-Eth_Assembly03.jpg

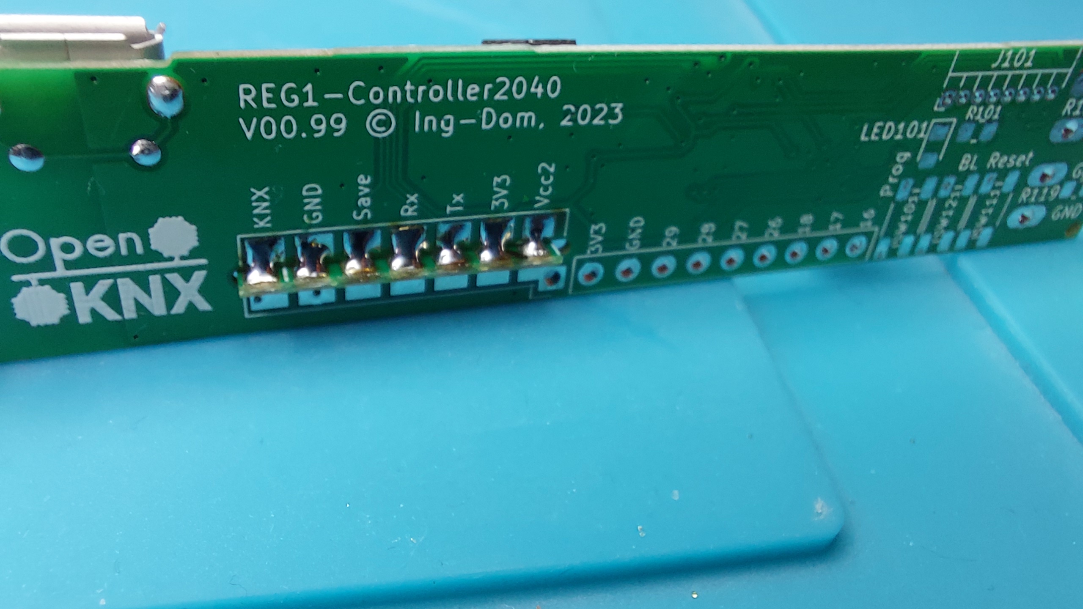
doc/Pictures/Assembly-REG1-Eth/Originalgroesse/REG1-Eth_Assembly03.jpg
