OpenKNX/OpenKNX-REG1/doc/Pictures/Assembly-REG1-Eth/REG1-Eth.jpg

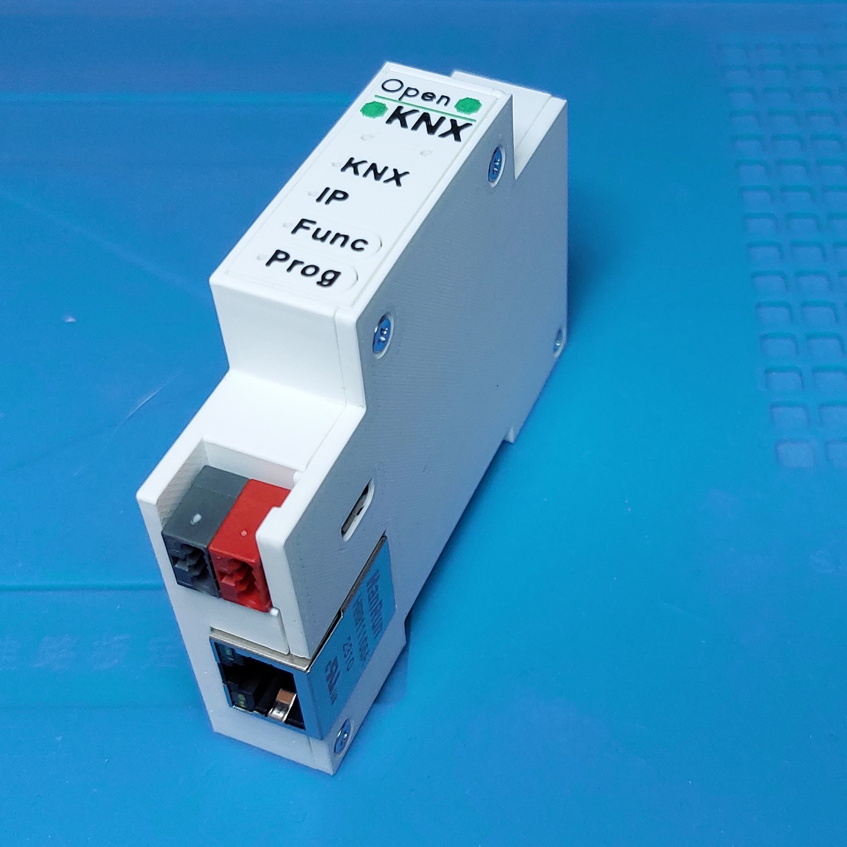
doc/Pictures/Assembly-REG1-Eth/REG1-Eth.jpg
