OpenKNX/OpenKNX-REG1/doc/Pictures/Assembly-REG1-LAN-Base/REG1-LAN-Base.jpg

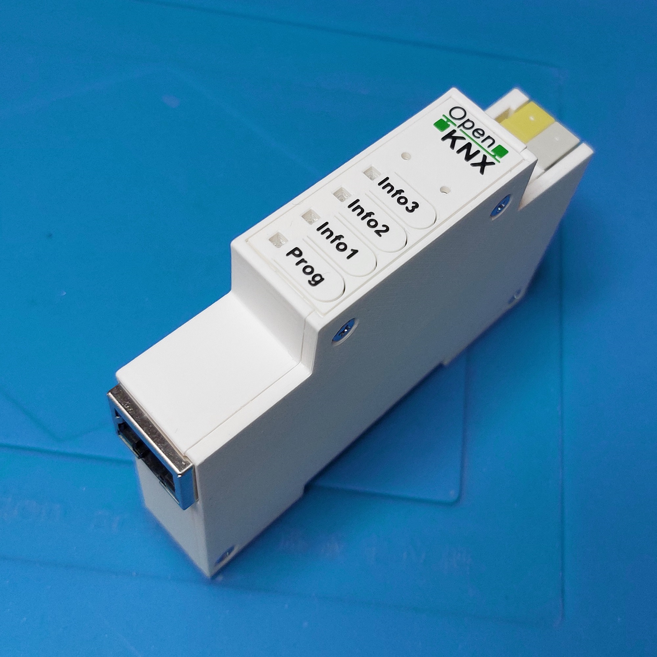
doc/Pictures/Assembly-REG1-LAN-Base/REG1-LAN-Base.jpg
