OpenKNX/OpenKNX-REG1/doc/Pictures/Assembly-REG1-LAN-Base/REG1-LAN-Base_kit.jpg

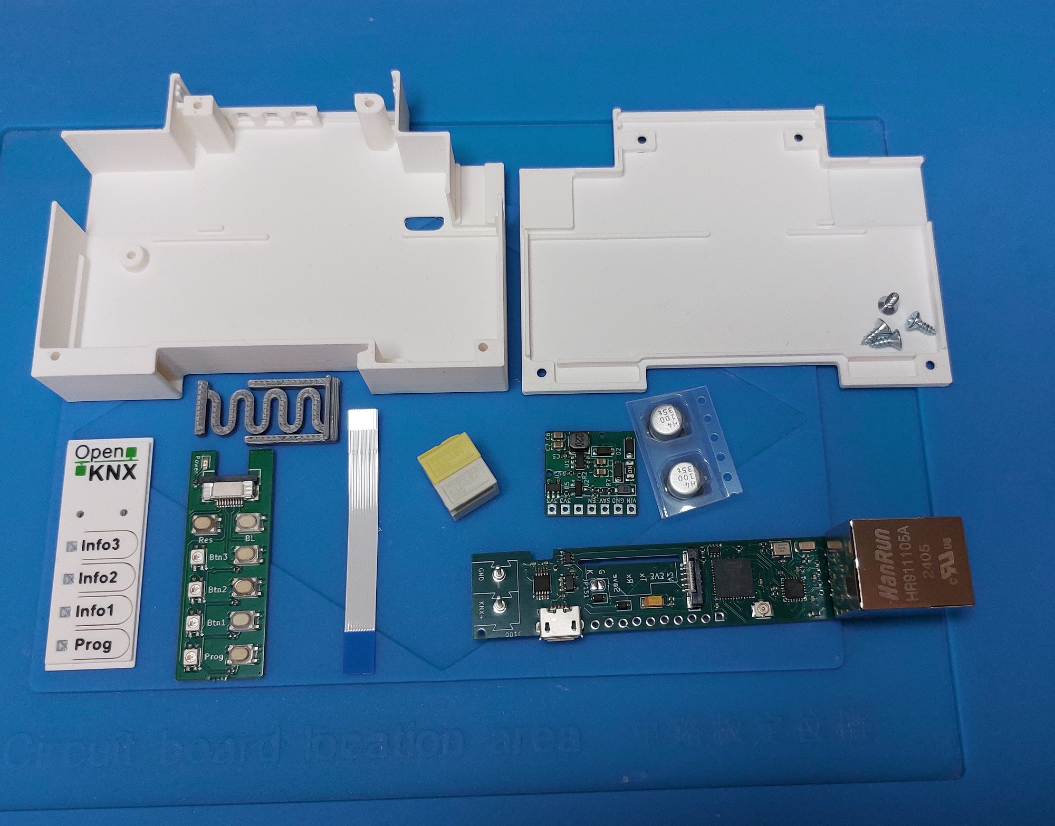
doc/Pictures/Assembly-REG1-LAN-Base/REG1-LAN-Base_kit.jpg
