OpenKNX/OpenKNX-REG1/doc/Pictures/Assembly-REG1-LAN-TP-Base/REG1-LAN-TP-Base.Assembly03.jpg

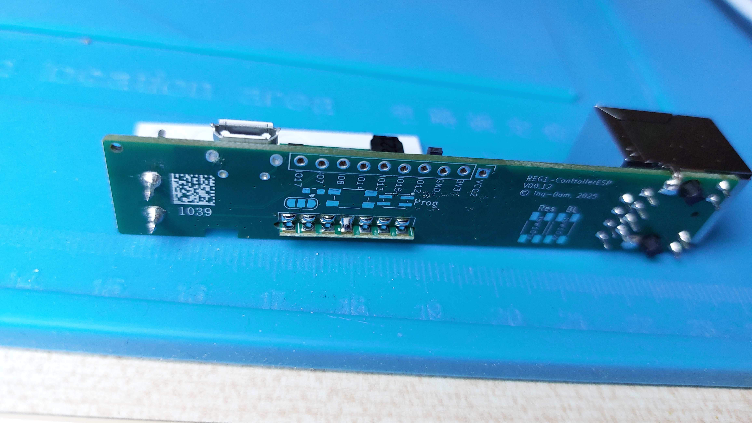
doc/Pictures/Assembly-REG1-LAN-TP-Base/REG1-LAN-TP-Base.Assembly03.jpg
