OpenKNX/OpenKNX-REG1/doc/Pictures/Assembly-REG1-LAN-TP-Base/REG1-LAN-TP-Base.Assembly05.jpg

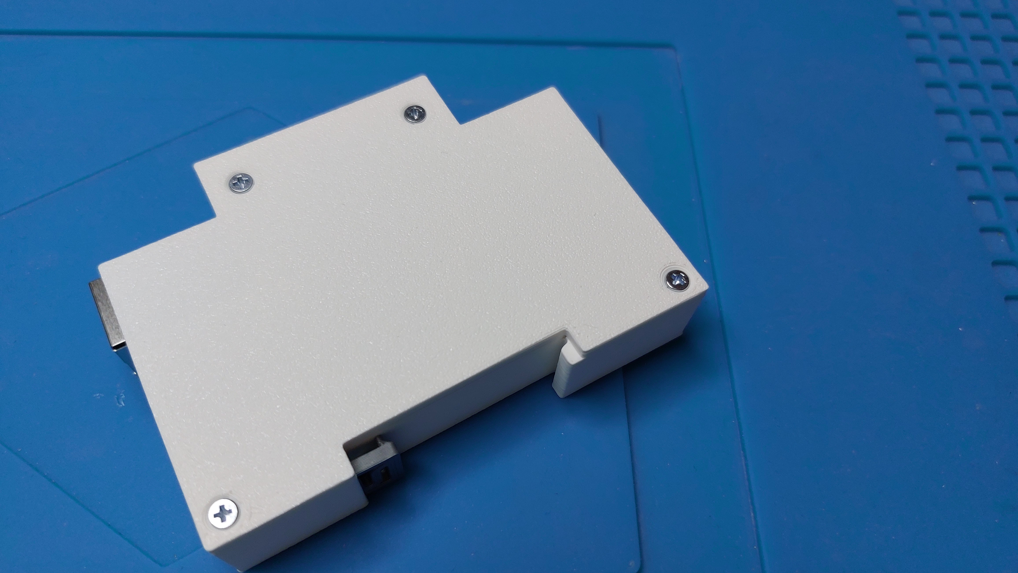
doc/Pictures/Assembly-REG1-LAN-TP-Base/REG1-LAN-TP-Base.Assembly05.jpg
