OpenKNX/OpenKNX-REG1/doc/Pictures/Assembly-REG1-SA-4xSELV/REG1-SA-4xSELV_Assembly20.jpg

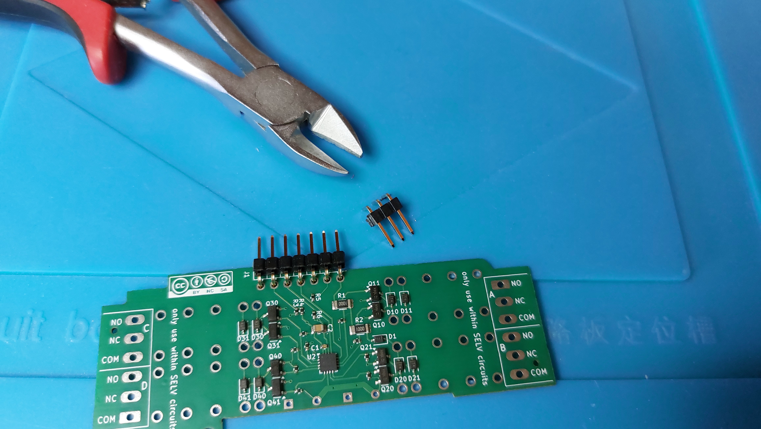
doc/Pictures/Assembly-REG1-SA-4xSELV/REG1-SA-4xSELV_Assembly20.jpg
