OpenKNX/OpenKNX-REG1/doc/Pictures/Assembly-REG1-SEN-Multi/Originalgroesse/REG1-SEN-Multi_Assembly01.jpg

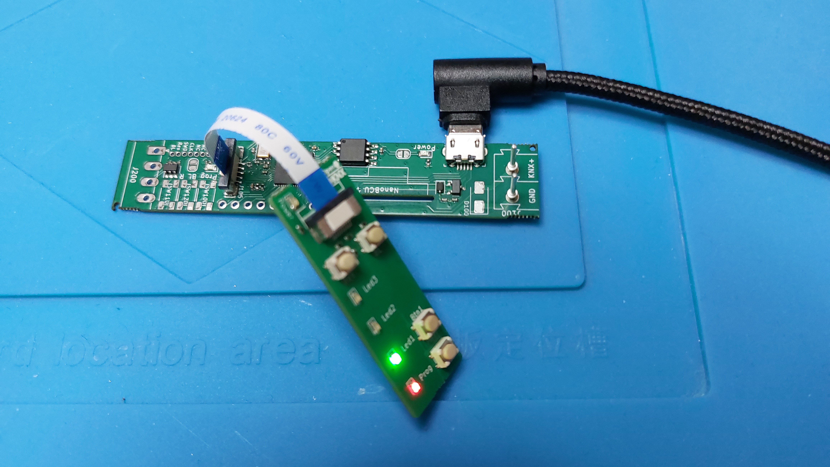
doc/Pictures/Assembly-REG1-SEN-Multi/Originalgroesse/REG1-SEN-Multi_Assembly01.jpg
