OpenKNX/OpenKNX-REG1/doc/Pictures/Assembly-REG1-SEN-Multi/Originalgroesse/REG1-SEN-Multi_Assembly11.jpg

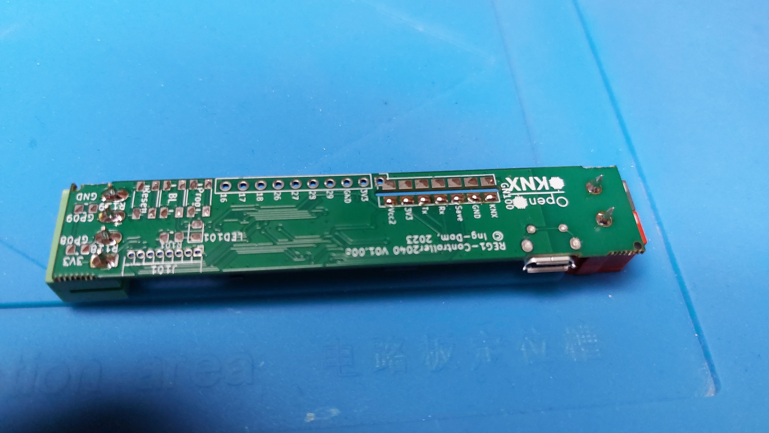
doc/Pictures/Assembly-REG1-SEN-Multi/Originalgroesse/REG1-SEN-Multi_Assembly11.jpg
