OpenKNX/OpenKNX-REG1/doc/Pictures/Assembly-REG1-SEN-Multi/REG1-SEN-Multi_kit.jpg

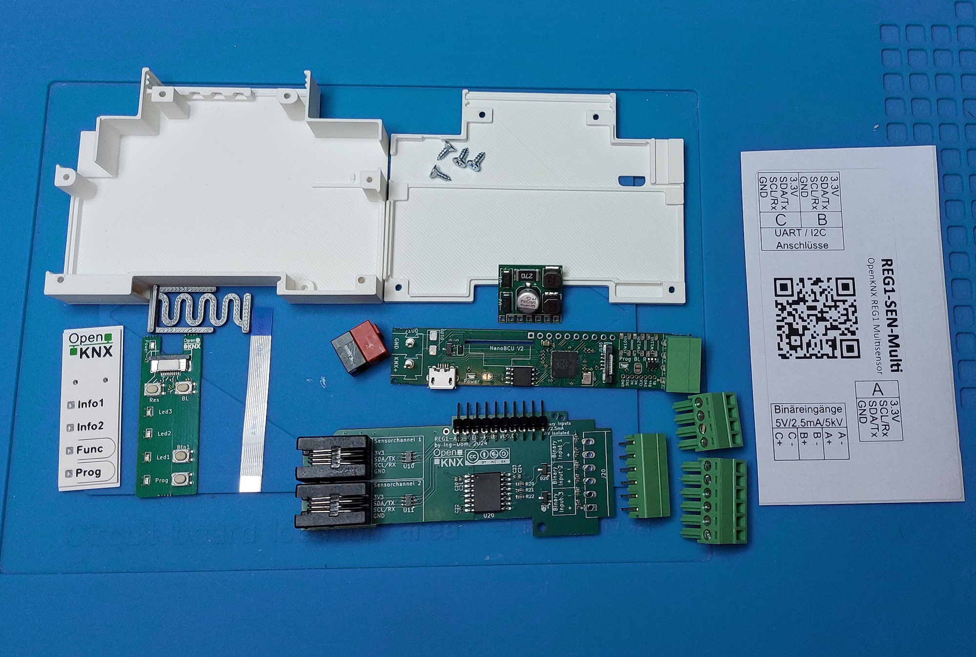
doc/Pictures/Assembly-REG1-SEN-Multi/REG1-SEN-Multi_kit.jpg
