OpenKNX/OpenKNX-REG1/doc/Pictures/Assembly-REG1-Universal/REG1-Universal_kit.jpg

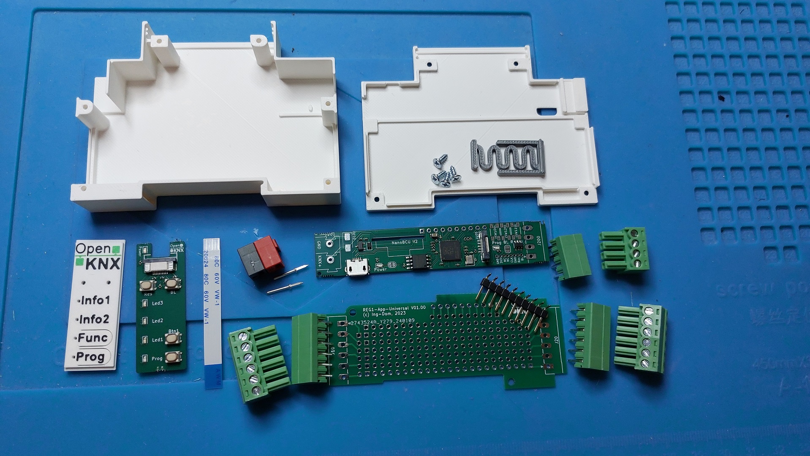
doc/Pictures/Assembly-REG1-Universal/REG1-Universal_kit.jpg
