OpenKNX/OpenKNX-REG1/doc/REG1-App-SEN-Multi_V01.00.sch.pdf

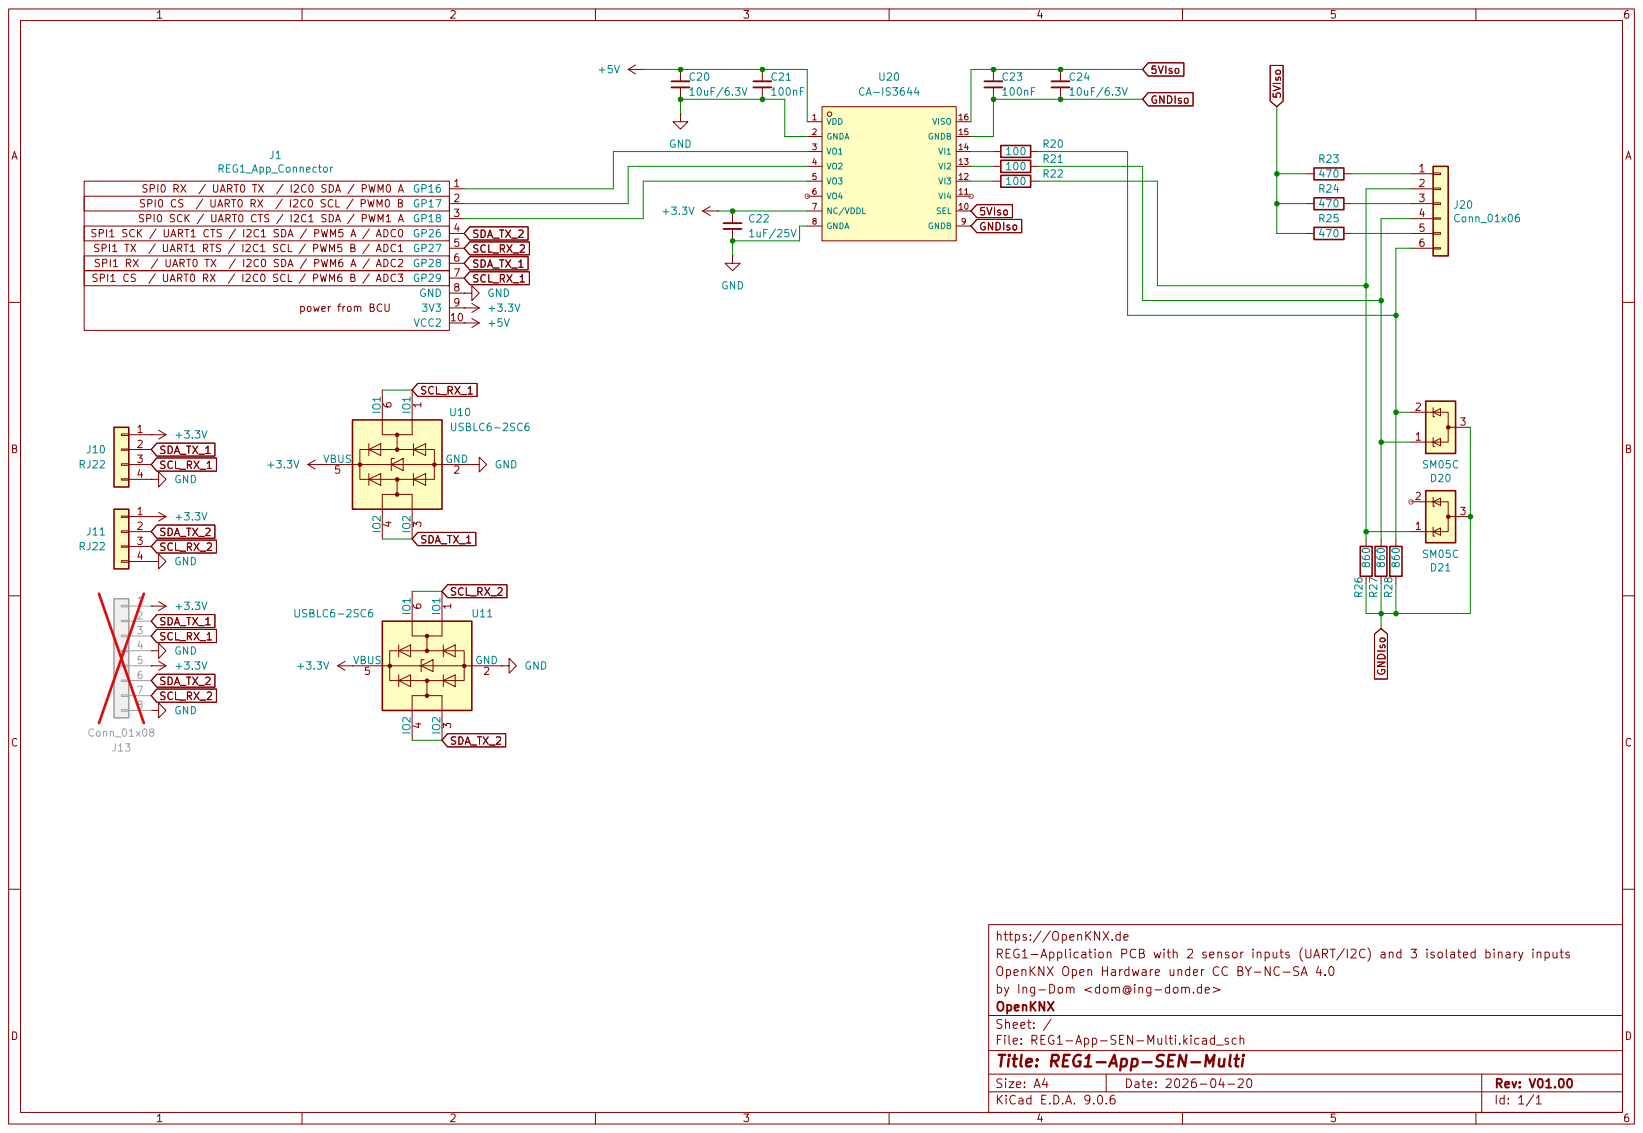
[picture p150: page 1]
