OpenKNX/OpenKNX-REG1/doc/REG1-Front-RGB_V00.01.sch.pdf

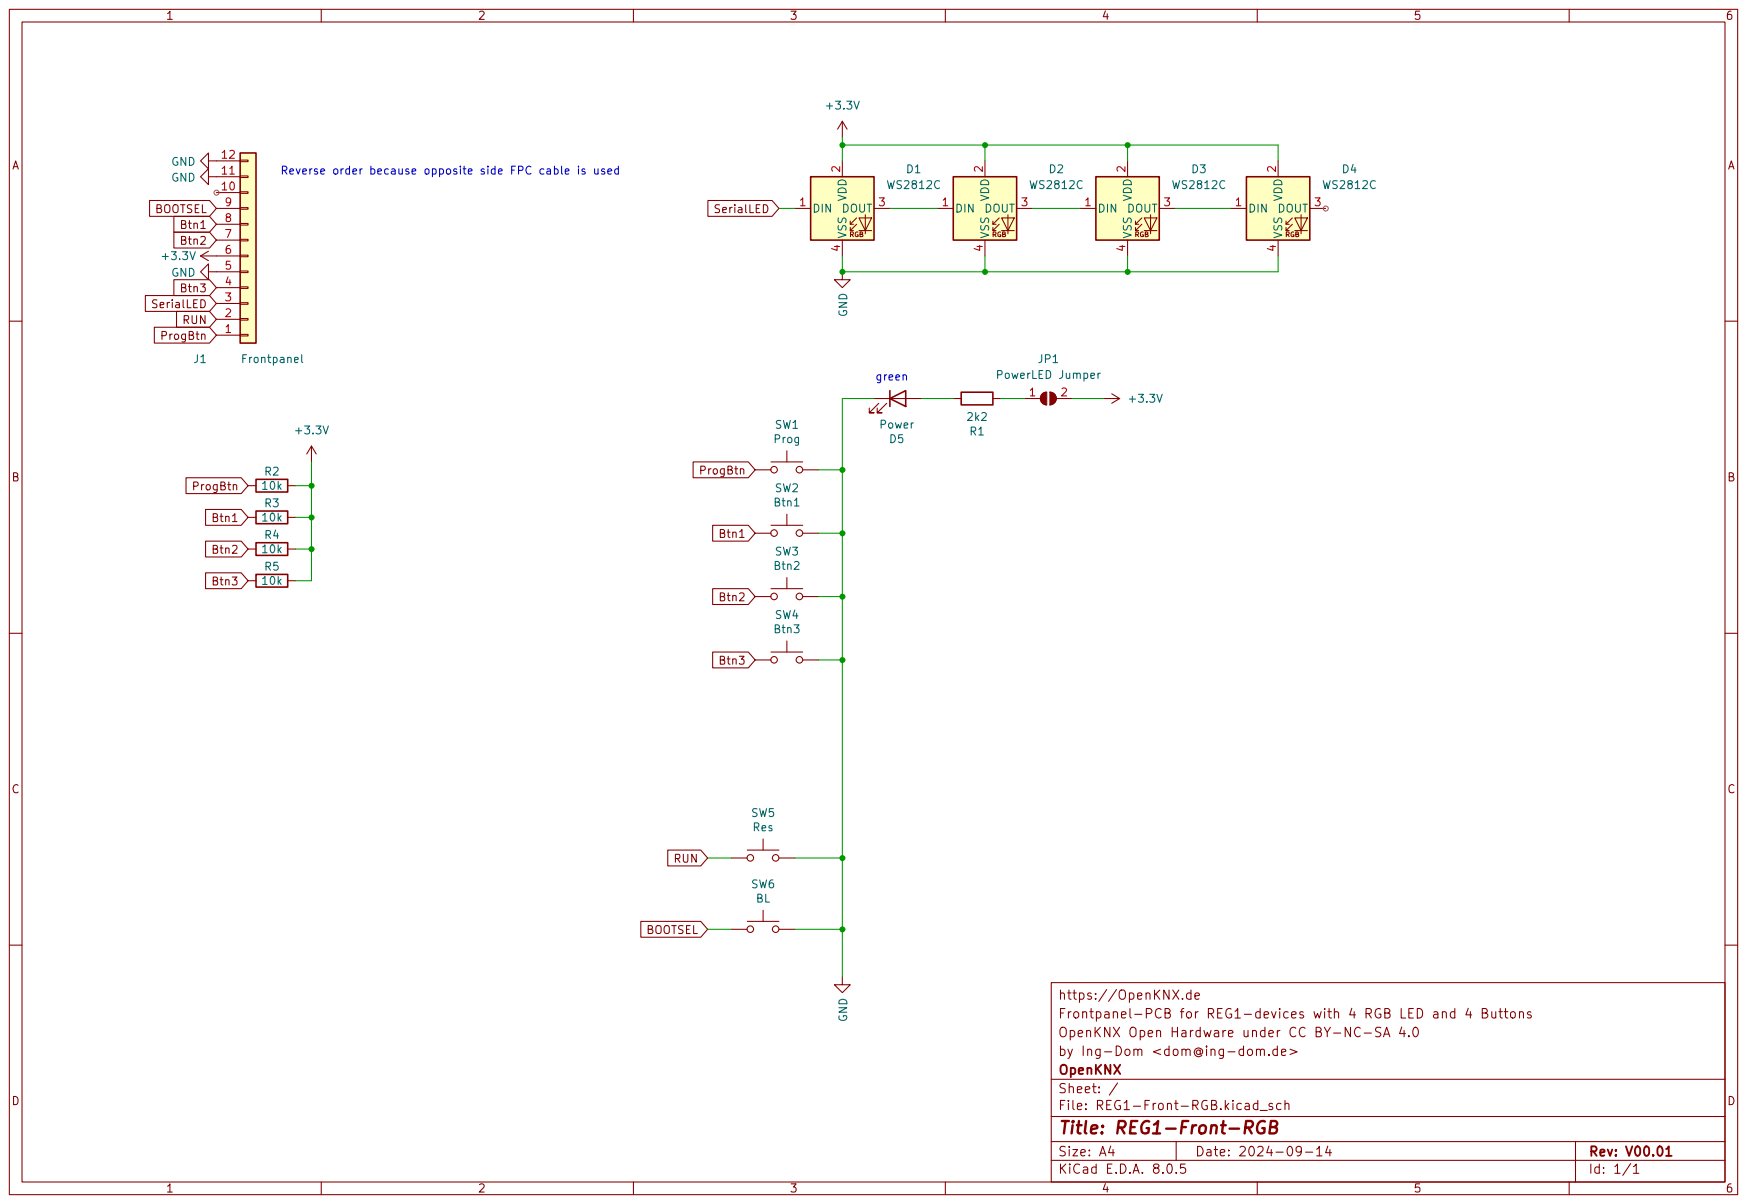
[picture p151: page 1]
