OpenKNX/OpenKNX-REG1/doc/NanoDCU_V00.02.sch.pdf

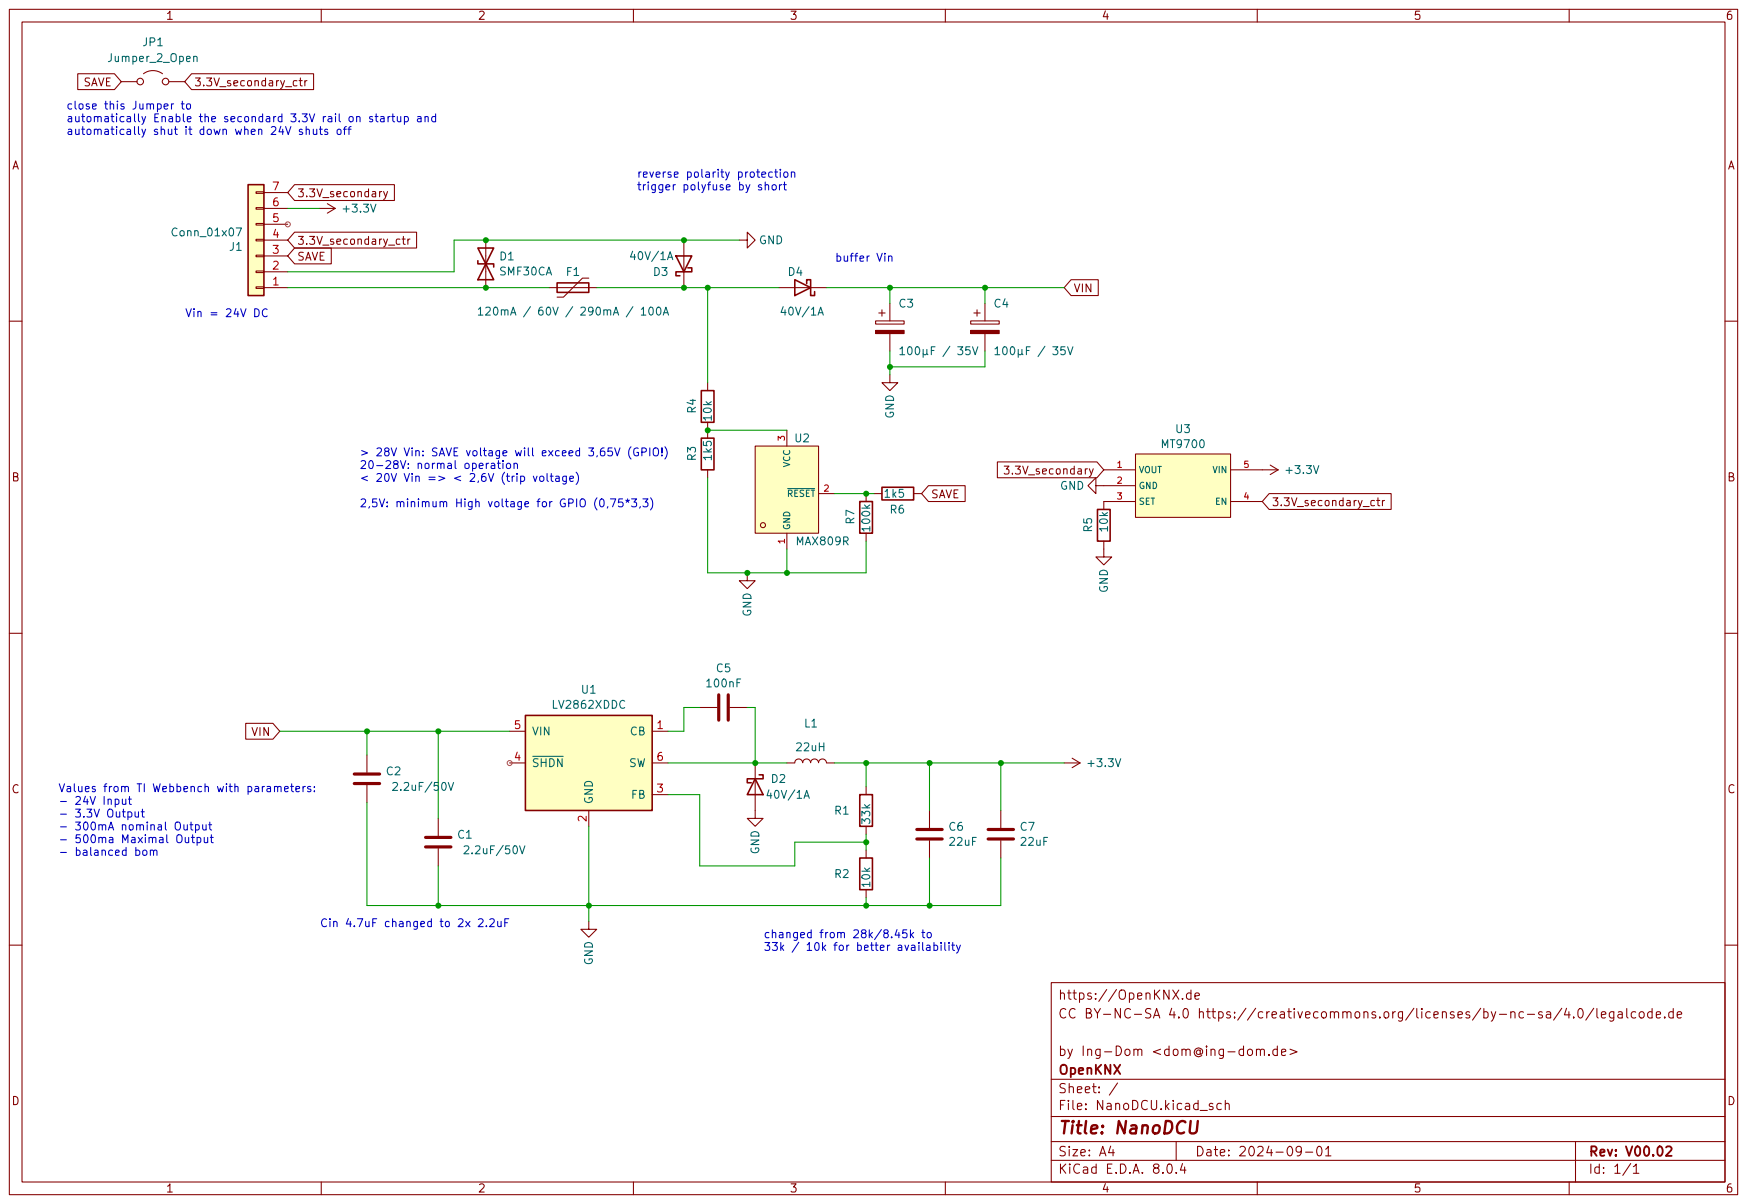
[picture p152: page 1]
