OpenKNX/OpenKNX-REG1/doc/REG1-App-SA-4xSELV_V00.02.sch.pdf

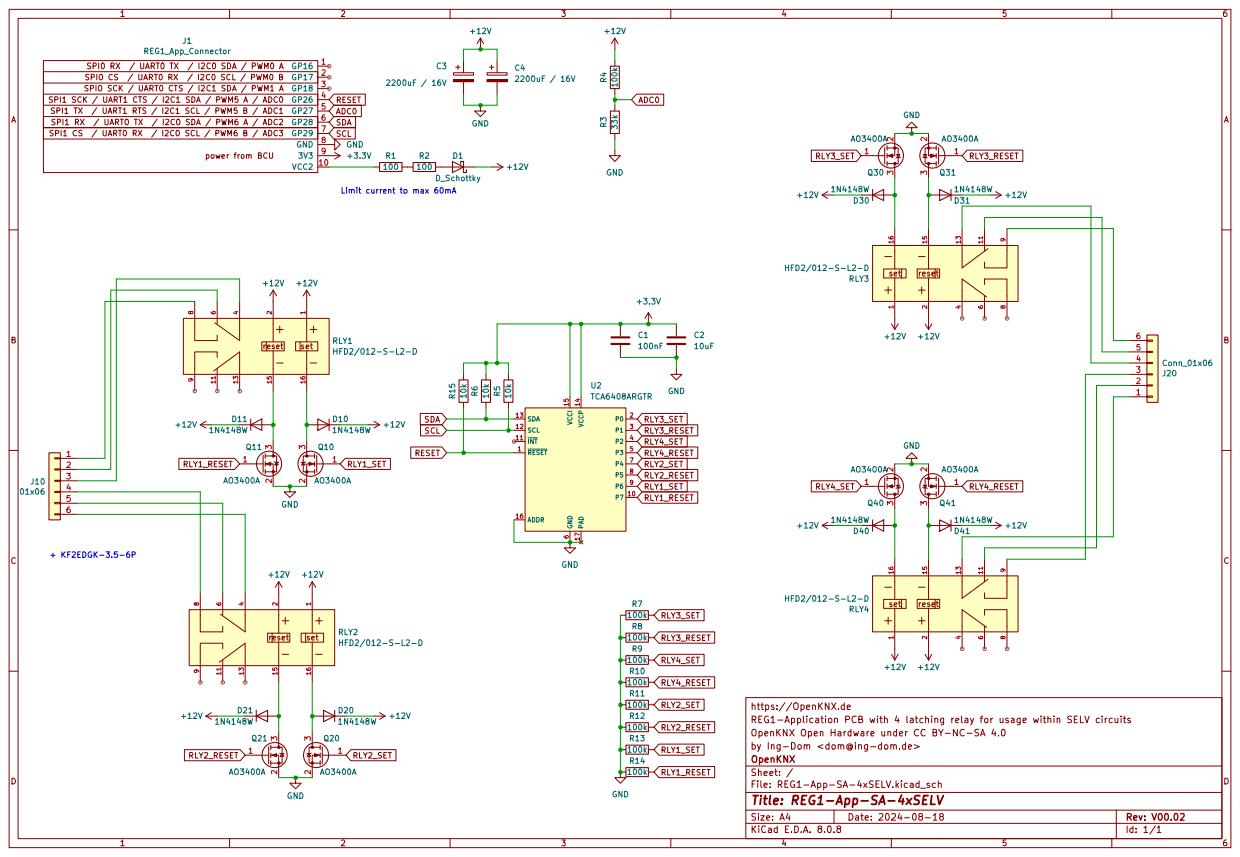
[picture p153: page 1]
