OpenKNX/OpenKNX-REG1/doc/REG1-Controller2040_V01.01.sch.pdf

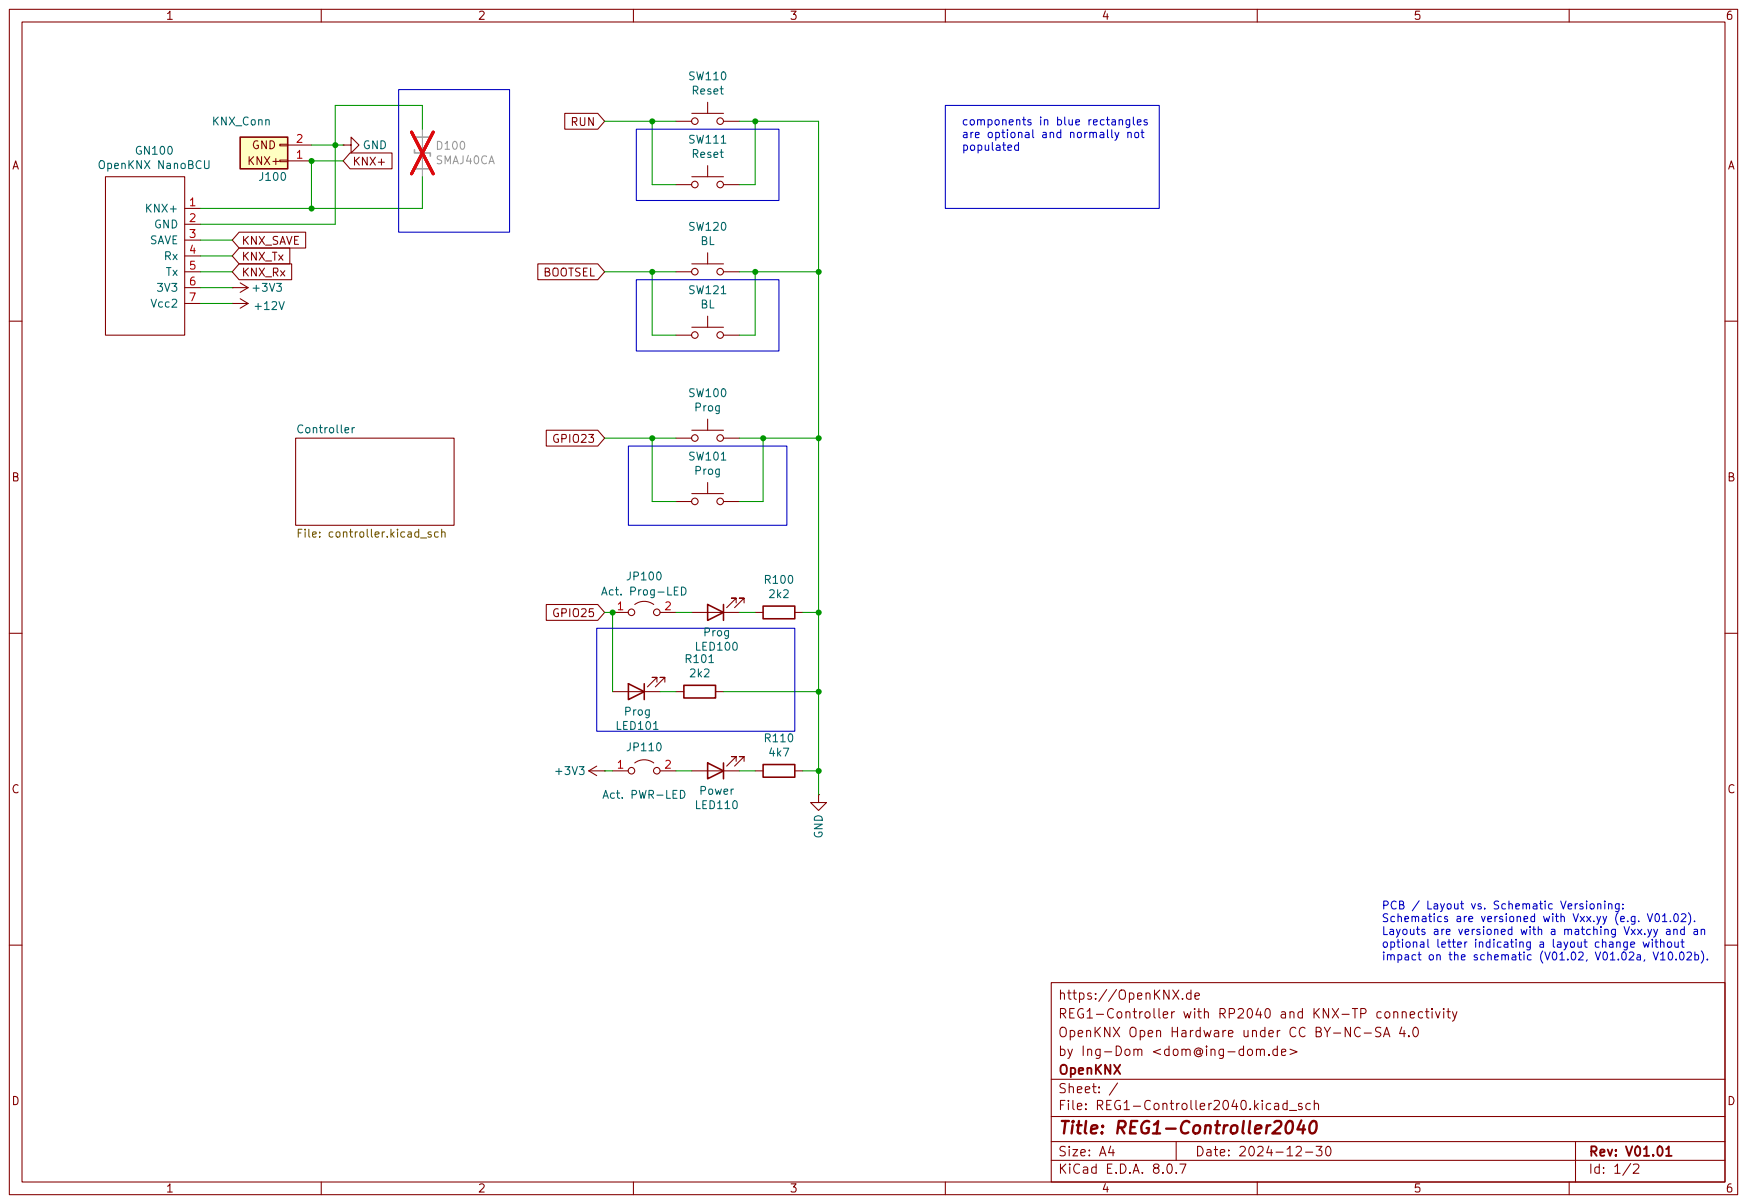
[picture p154: page 1]

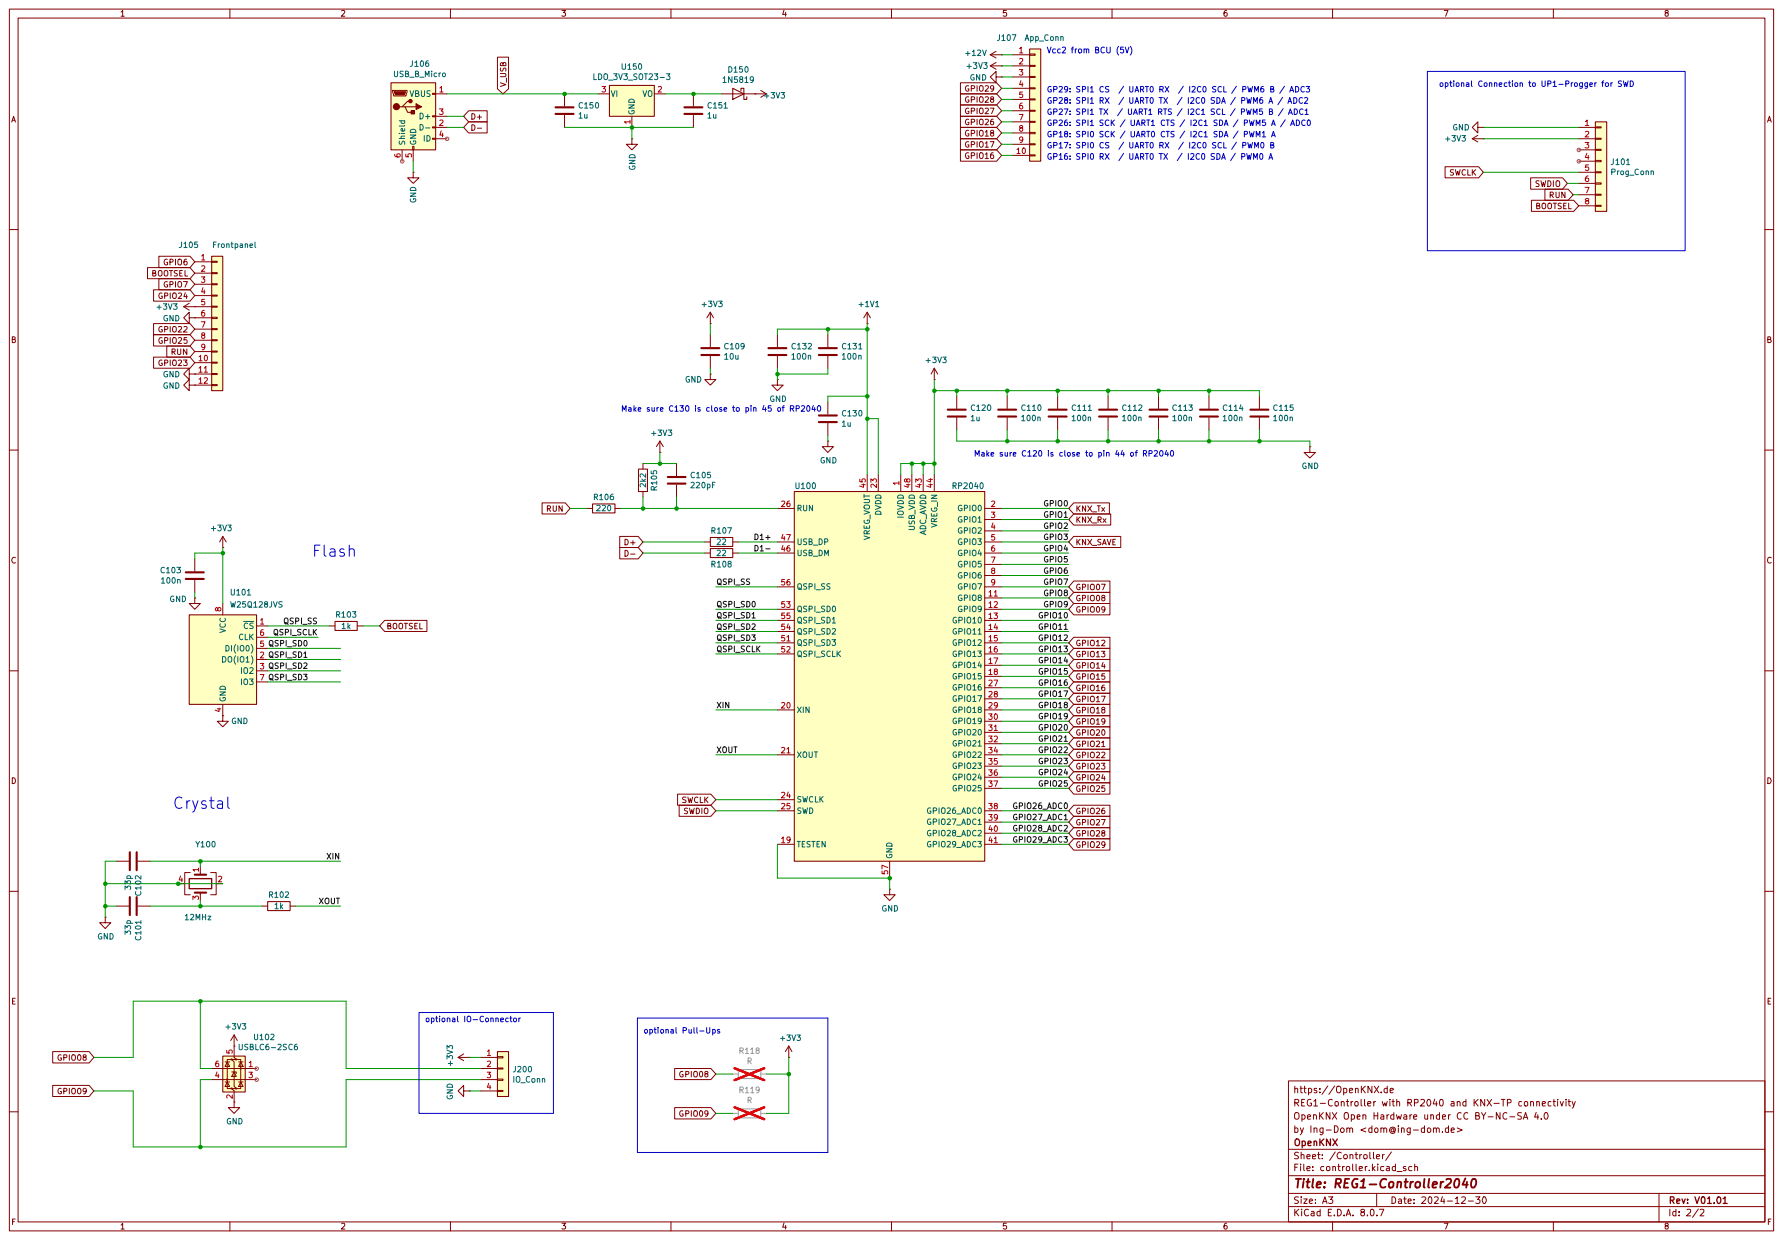
[picture p155: page 2]
