OpenKNX/OpenKNX-REG1/doc/REG1-App-2xDALI_V00.01.sch.pdf

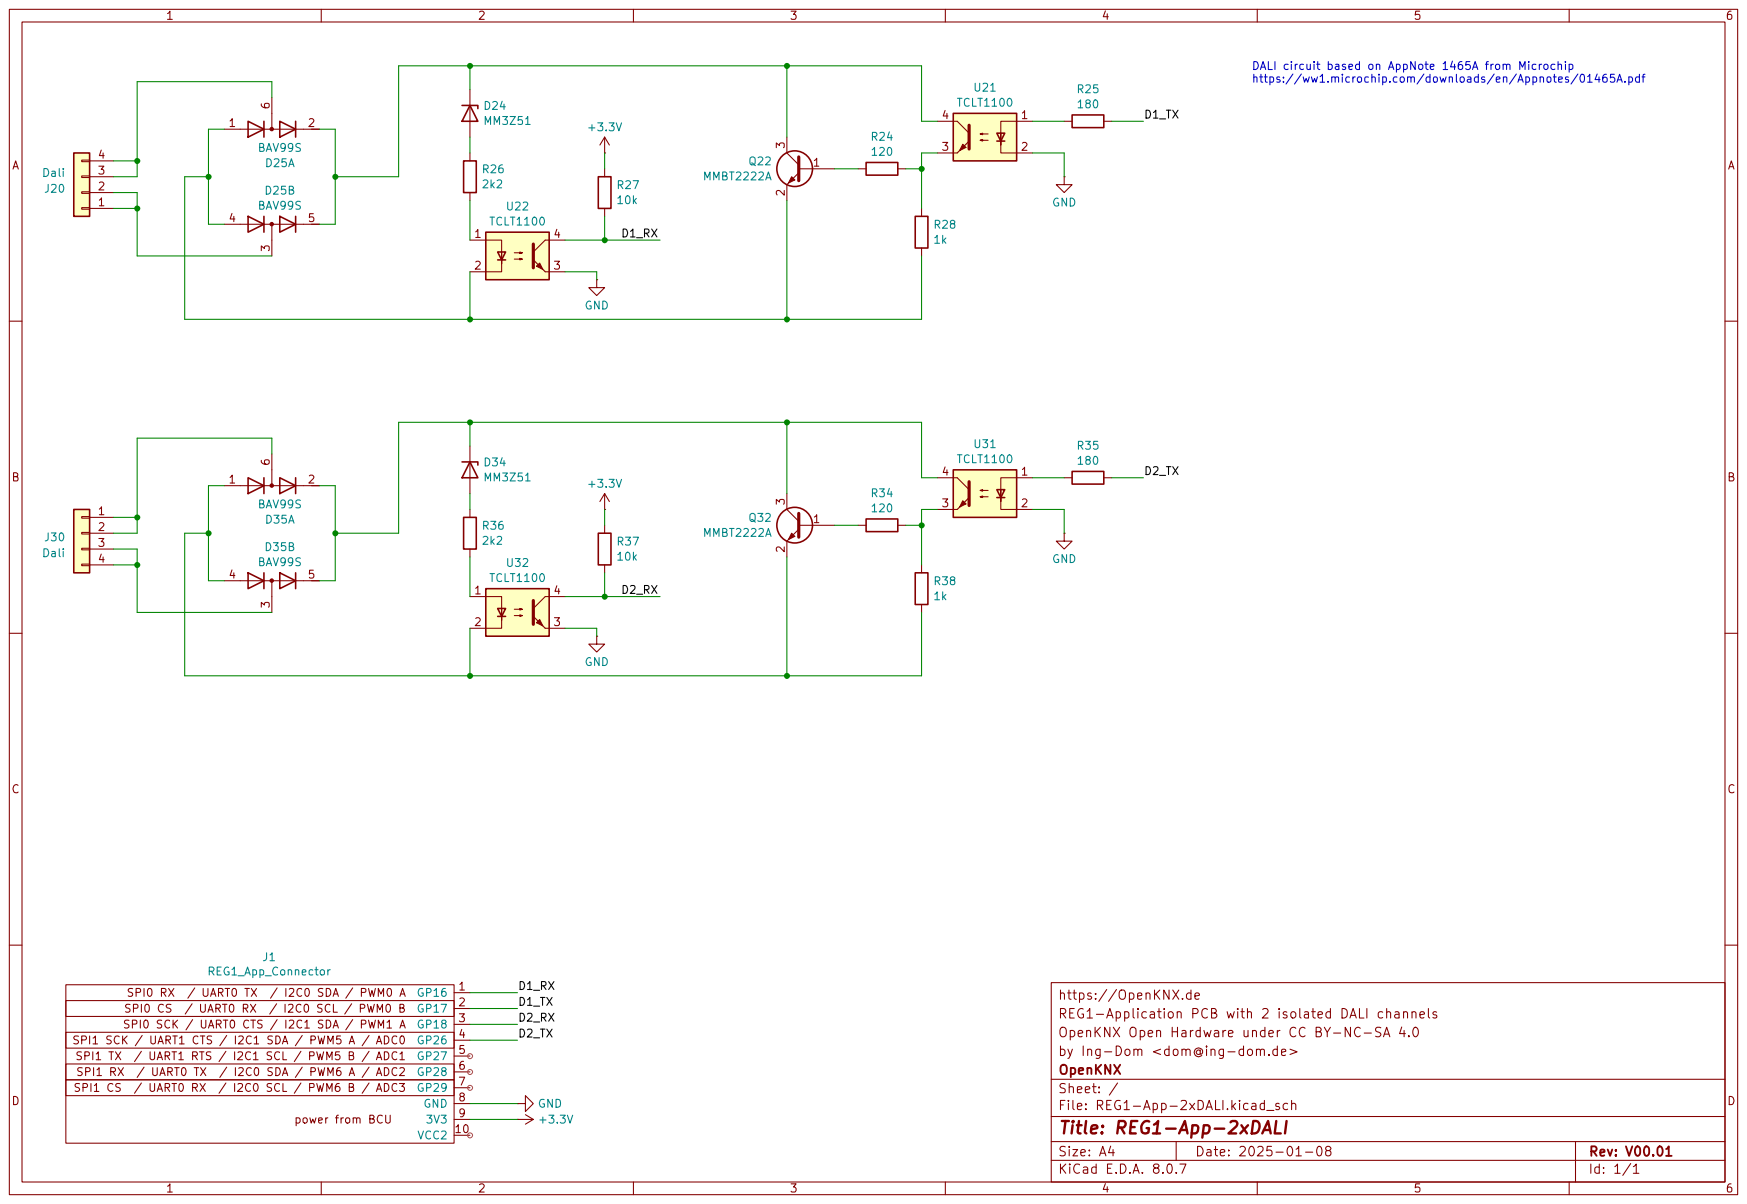
[picture p156: page 1]
