OpenKNX/OpenKNX-REG1/doc/REG1-Front-Universal_V01.01.sch.pdf

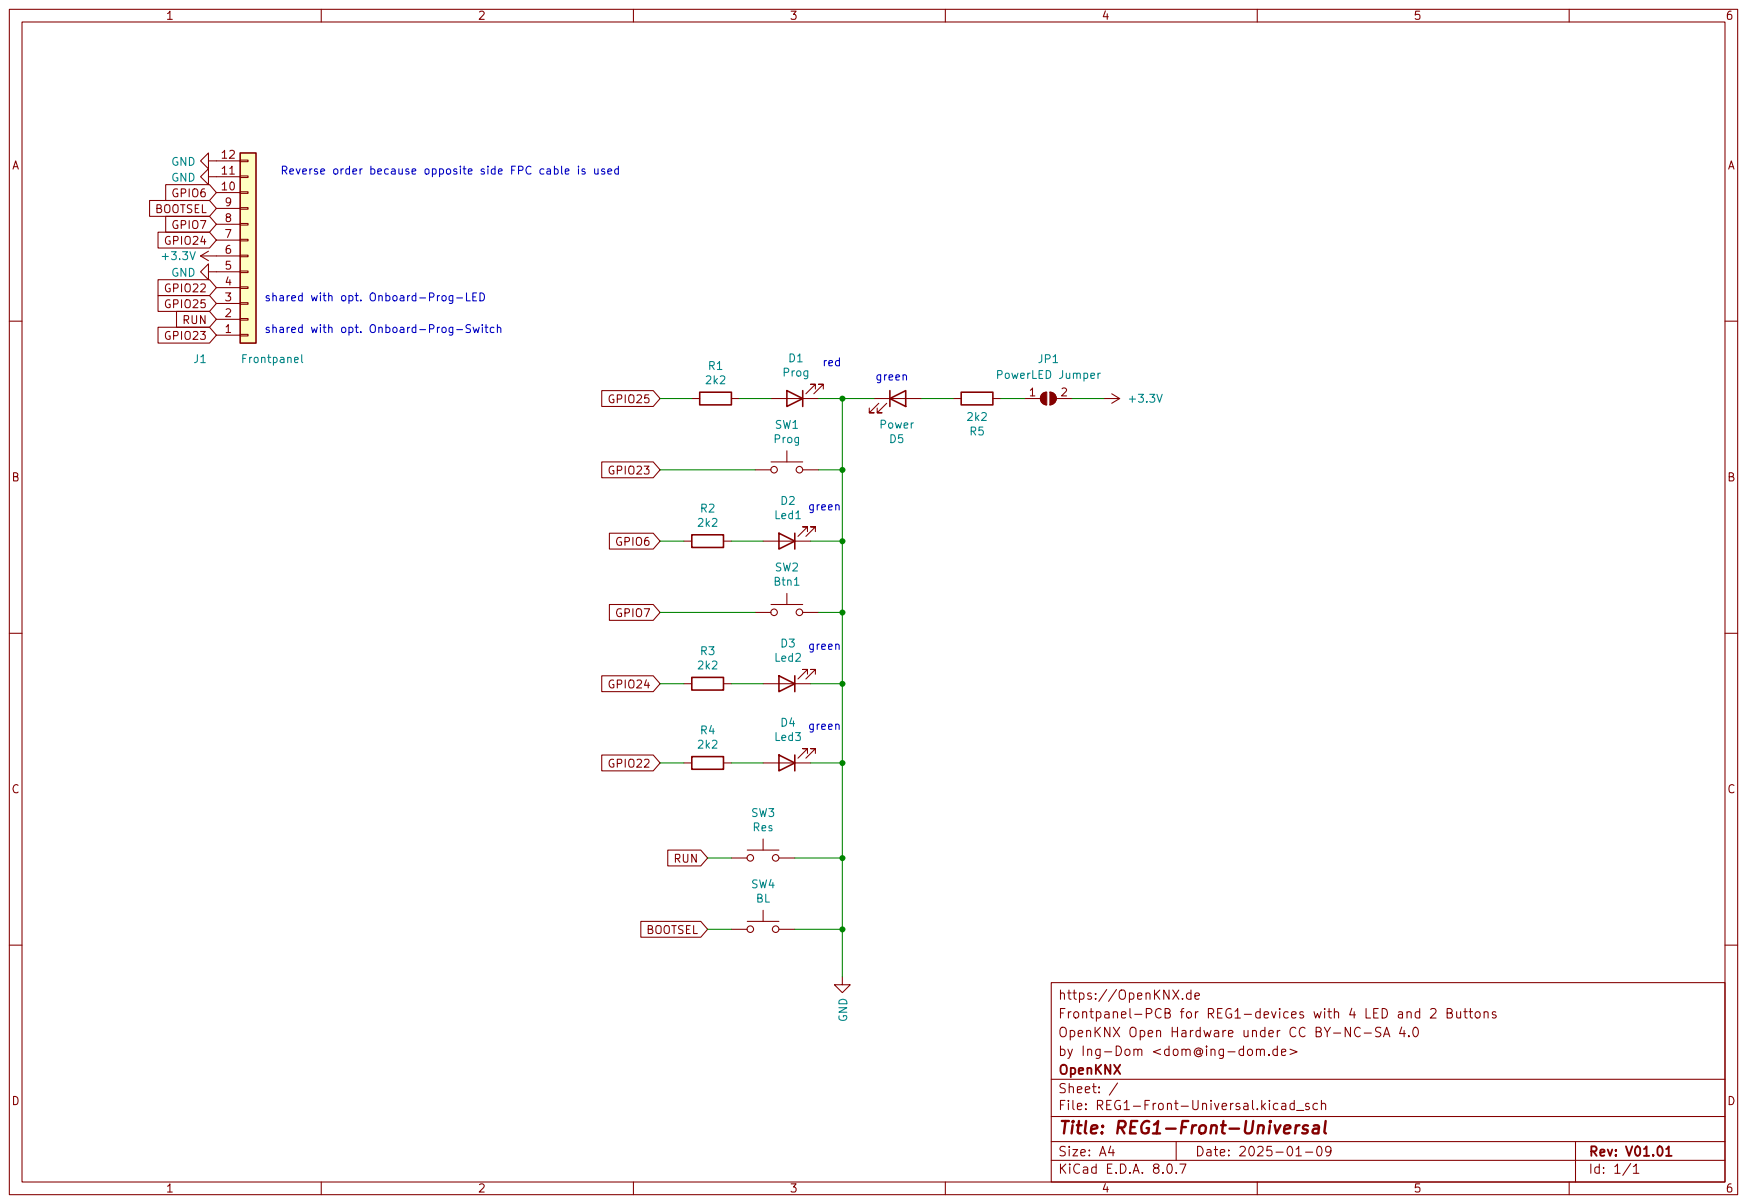
[picture p157: page 1]
