OpenKNX/OpenKNX-REG1/doc/REG1-App-Universal_V01.10.sch.pdf

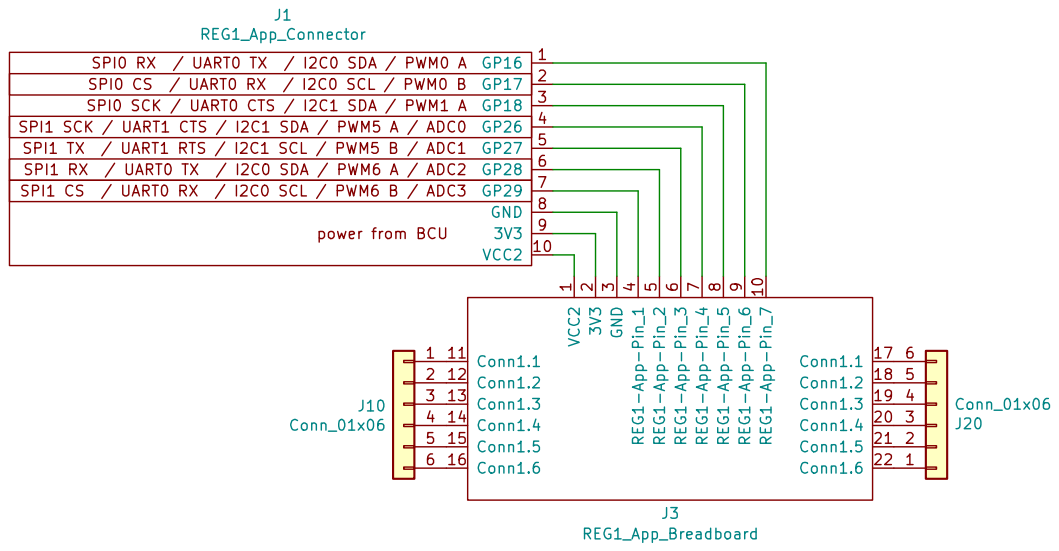
[picture p158: page 1]
