OpenKNX/OpenKNX-REG1/doc/REG1-App-GW-RF2G4_V00.01.sch.pdf

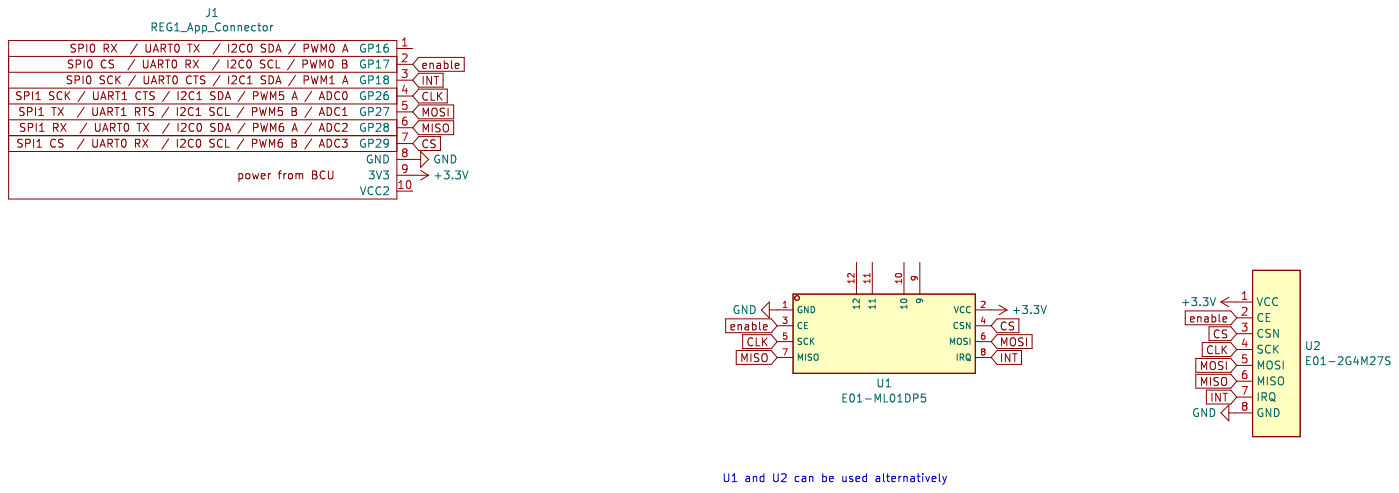
[picture p159: page 1]
