OpenKNX/OpenKNX-REG1/doc/REG1-App-Eth_V01.00.sch.pdf

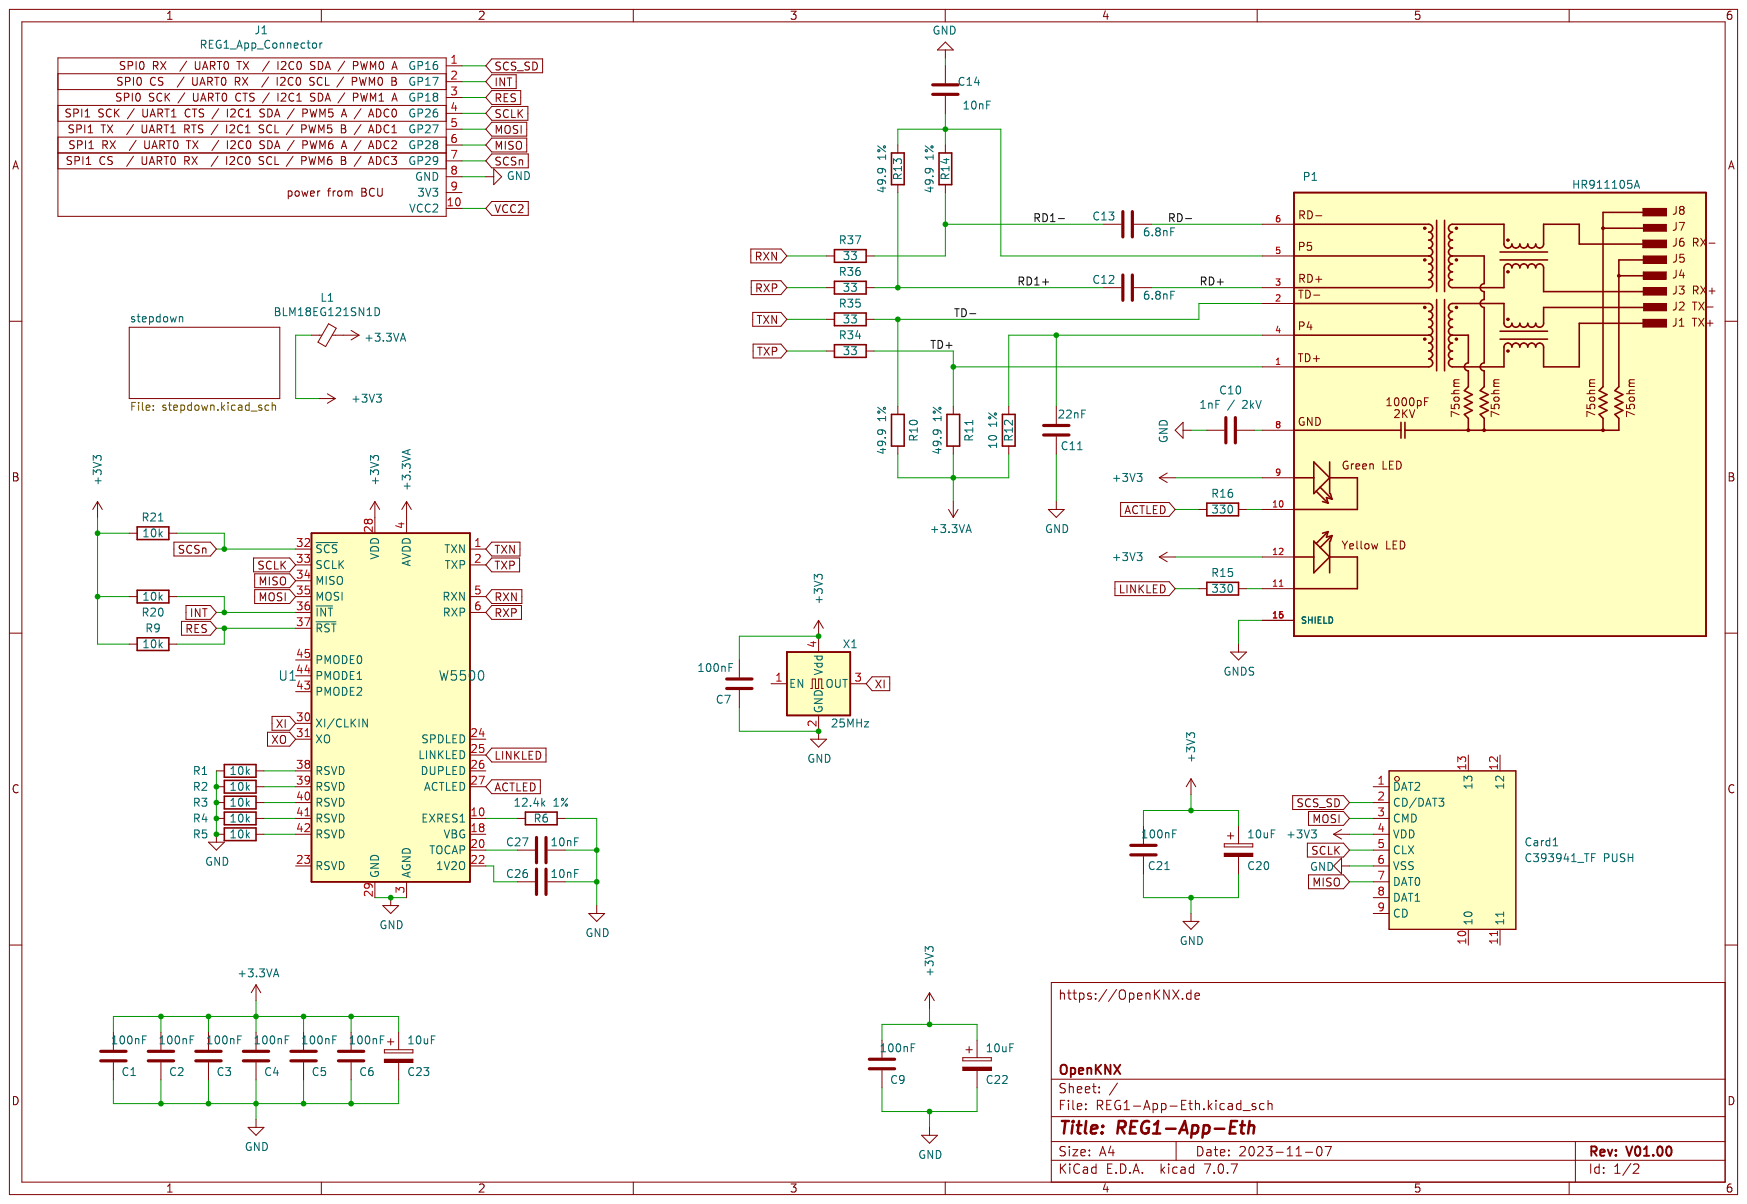
[picture p160: page 1]

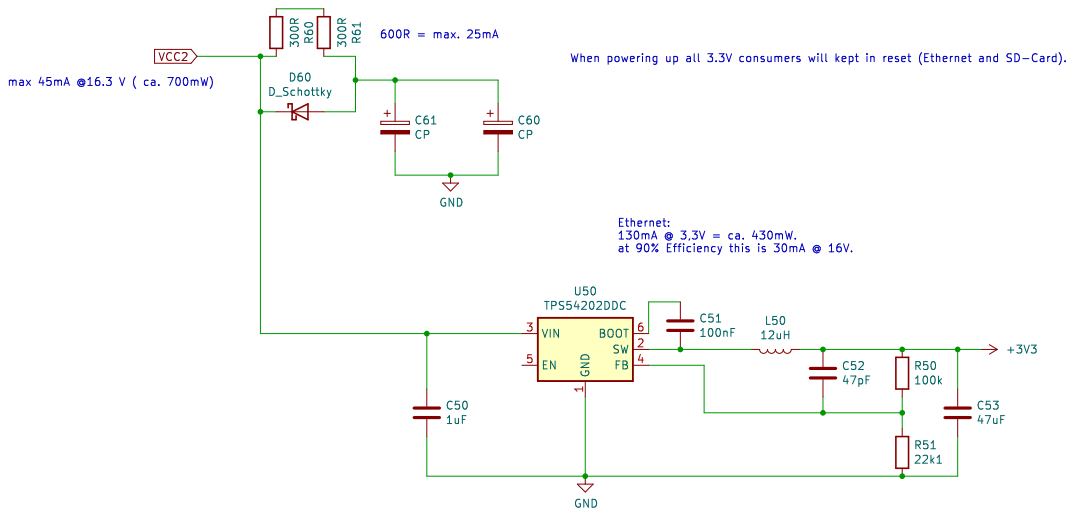
[picture p161: page 2]
