OpenKNX/OpenKNX-REG1/doc/REG1-IpController2040_V01.00.sch.pdf

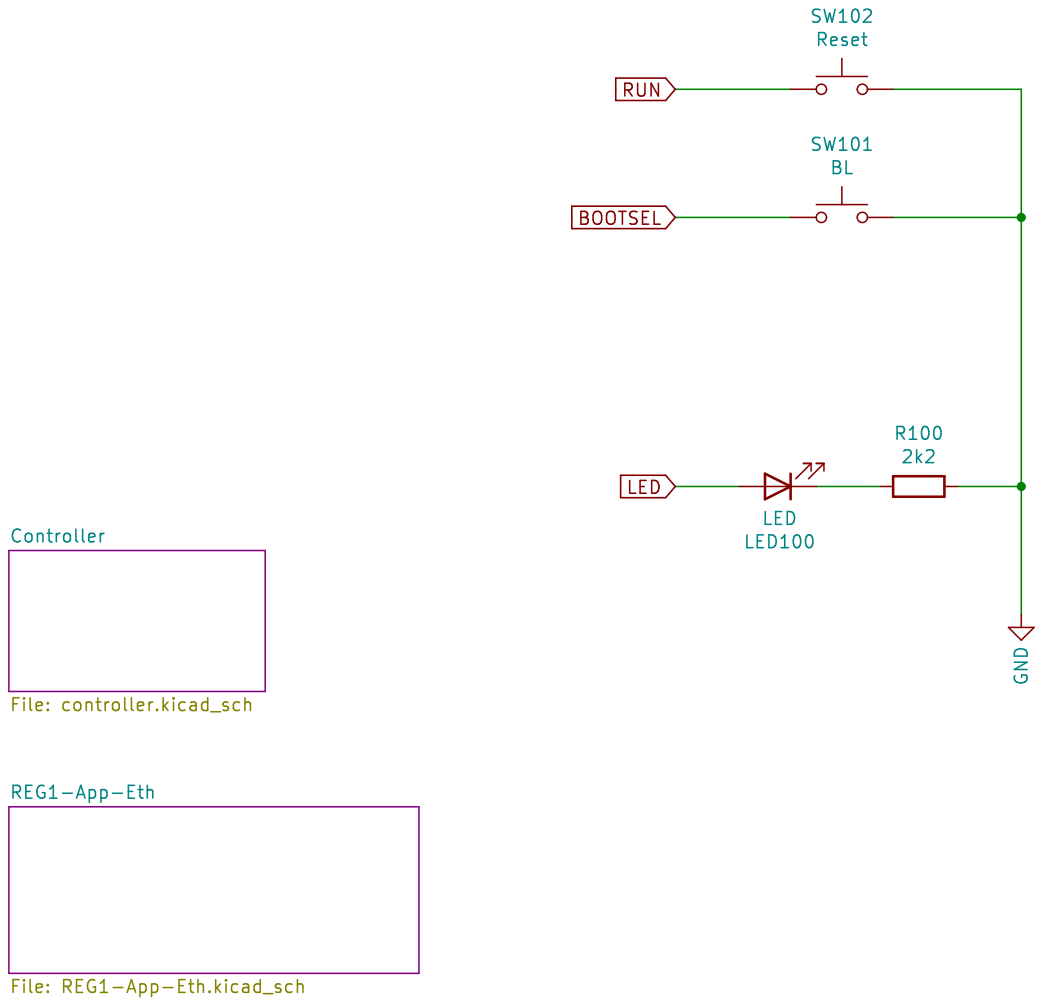
[picture p162: page 1]

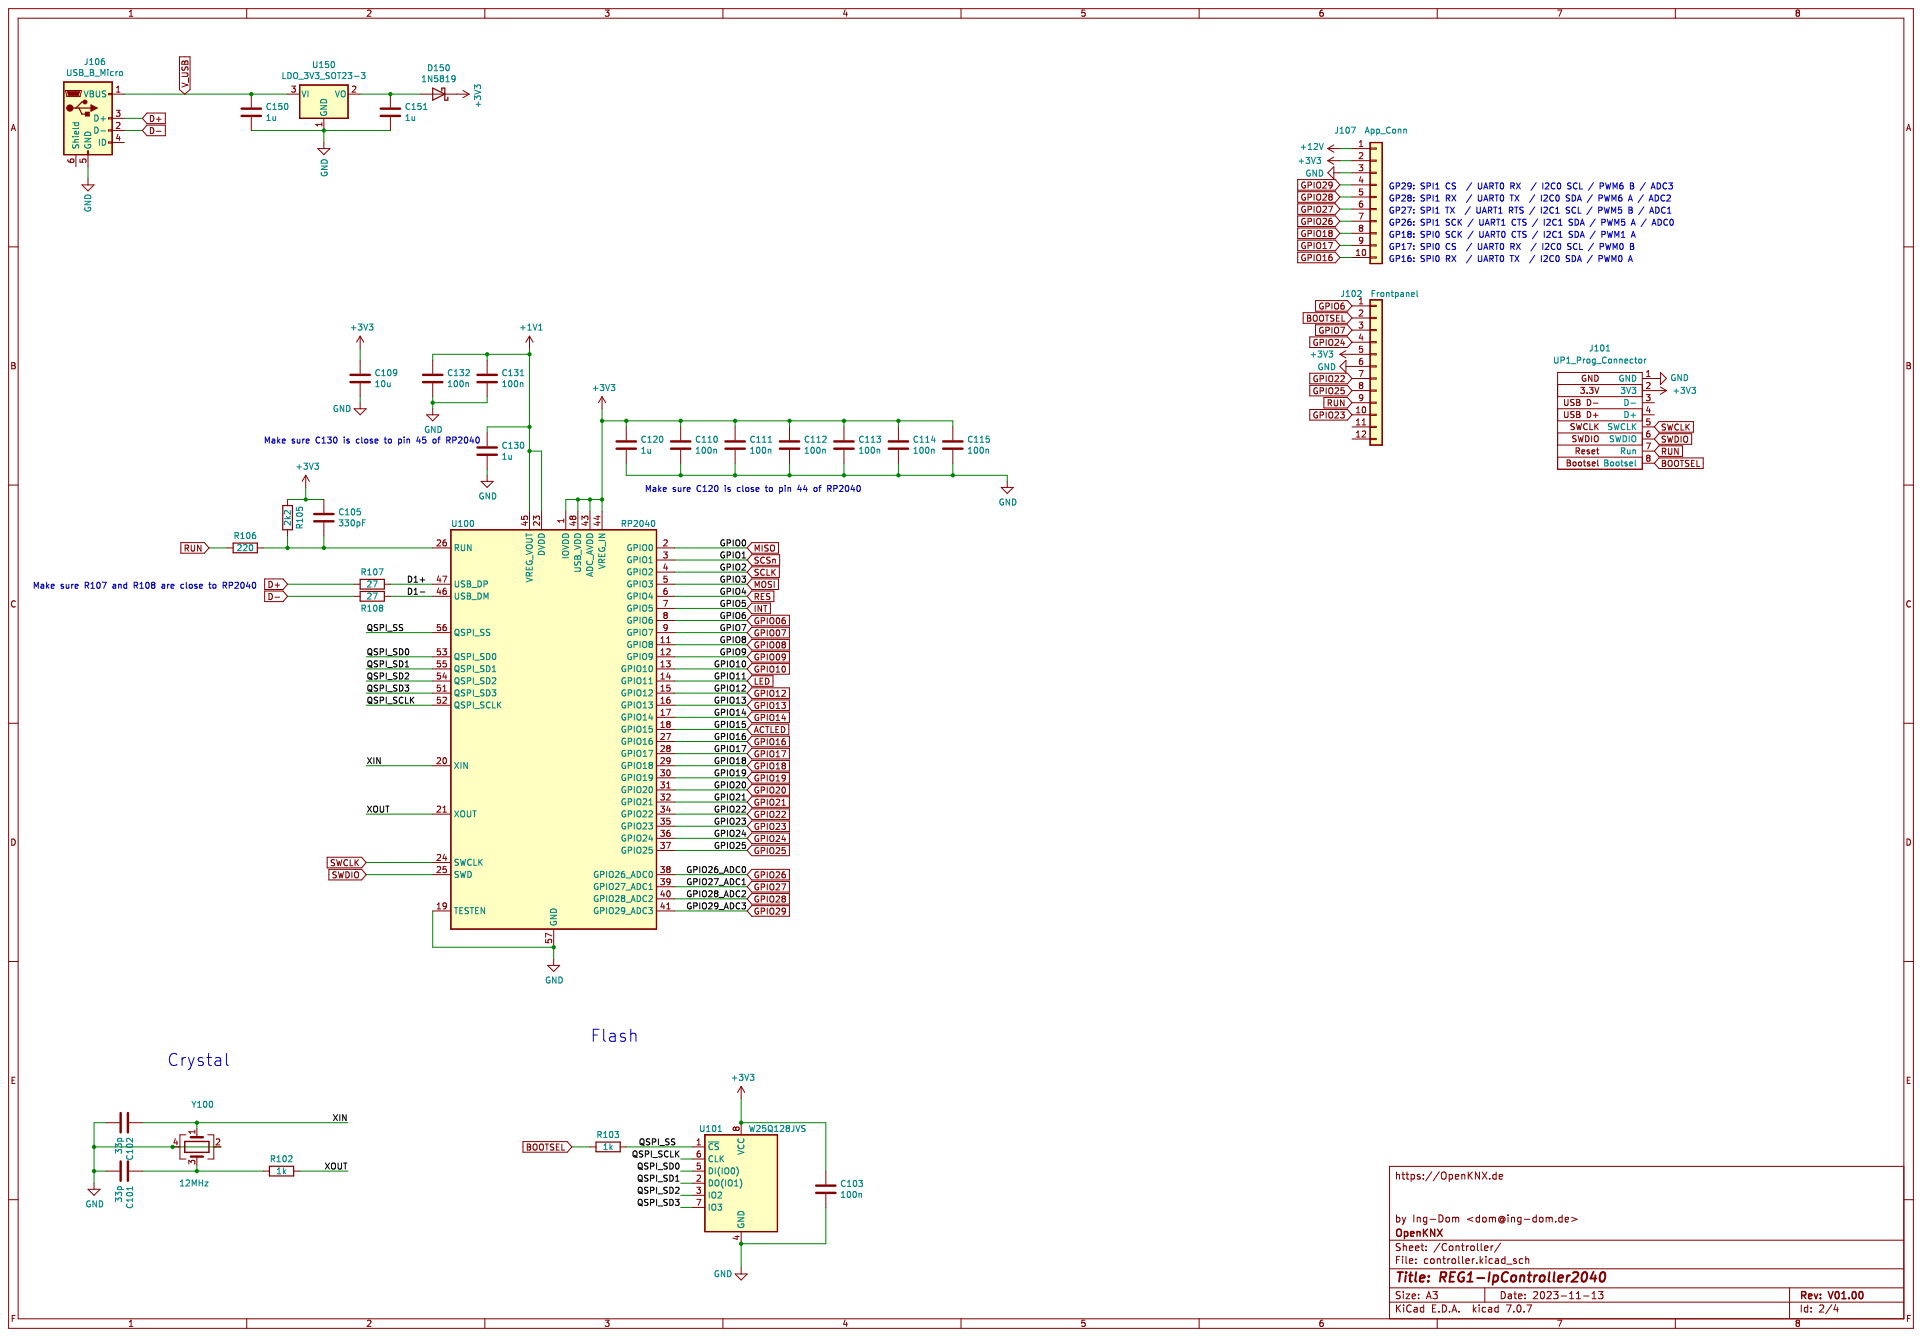
[picture p163: page 2]

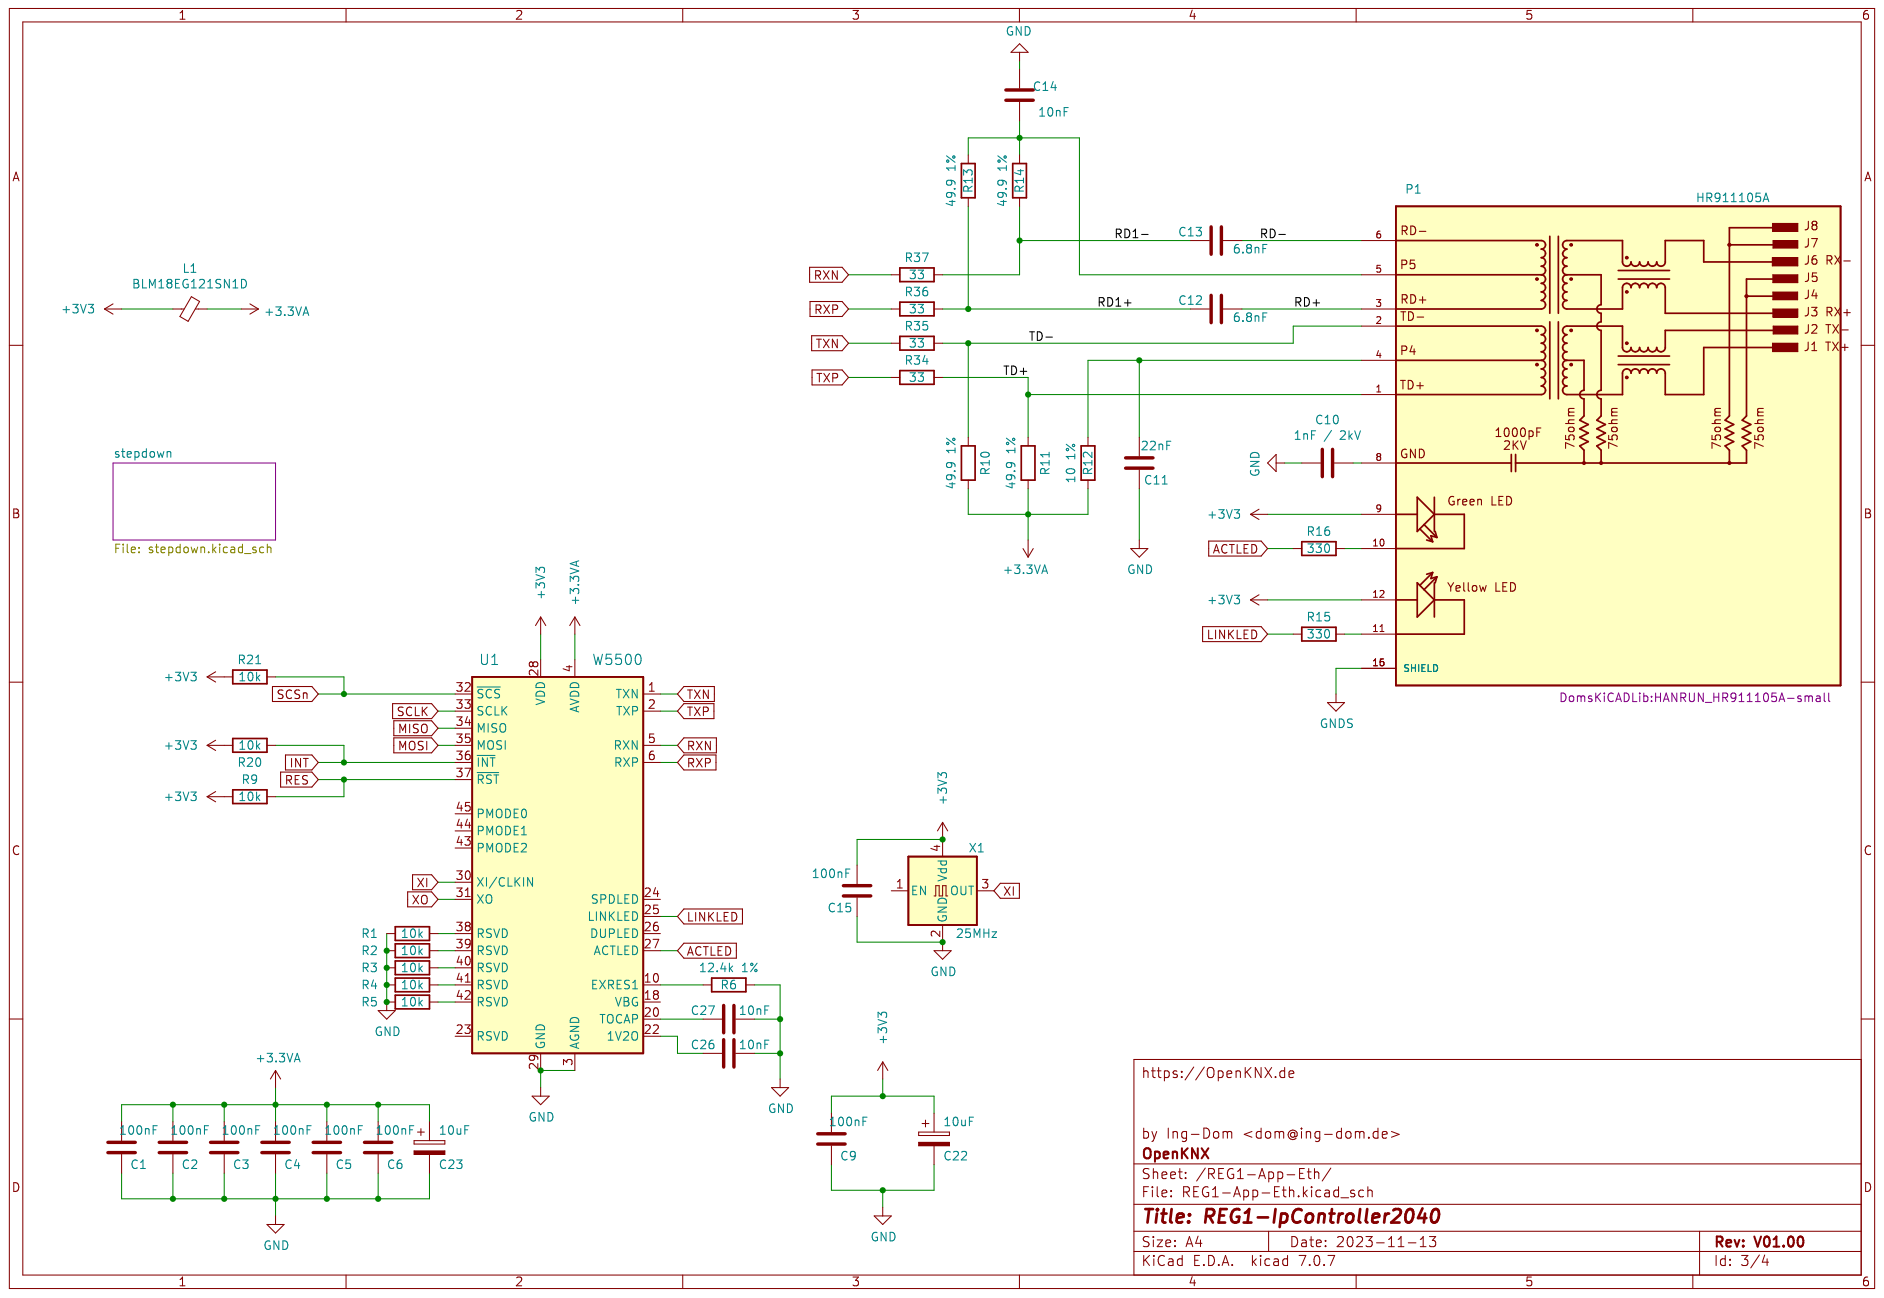
[picture p164: page 3]

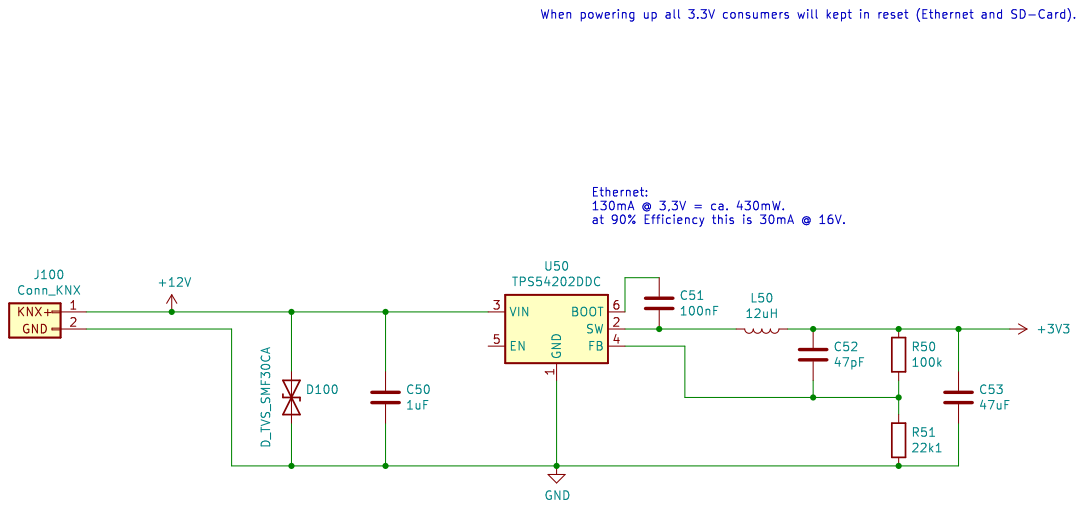
[picture p165: page 4]
