OpenKNX/OpenKNX-REG1/doc/REG1-Controller-ESP/REG1-ControllerESP_V00.30.sch.pdf

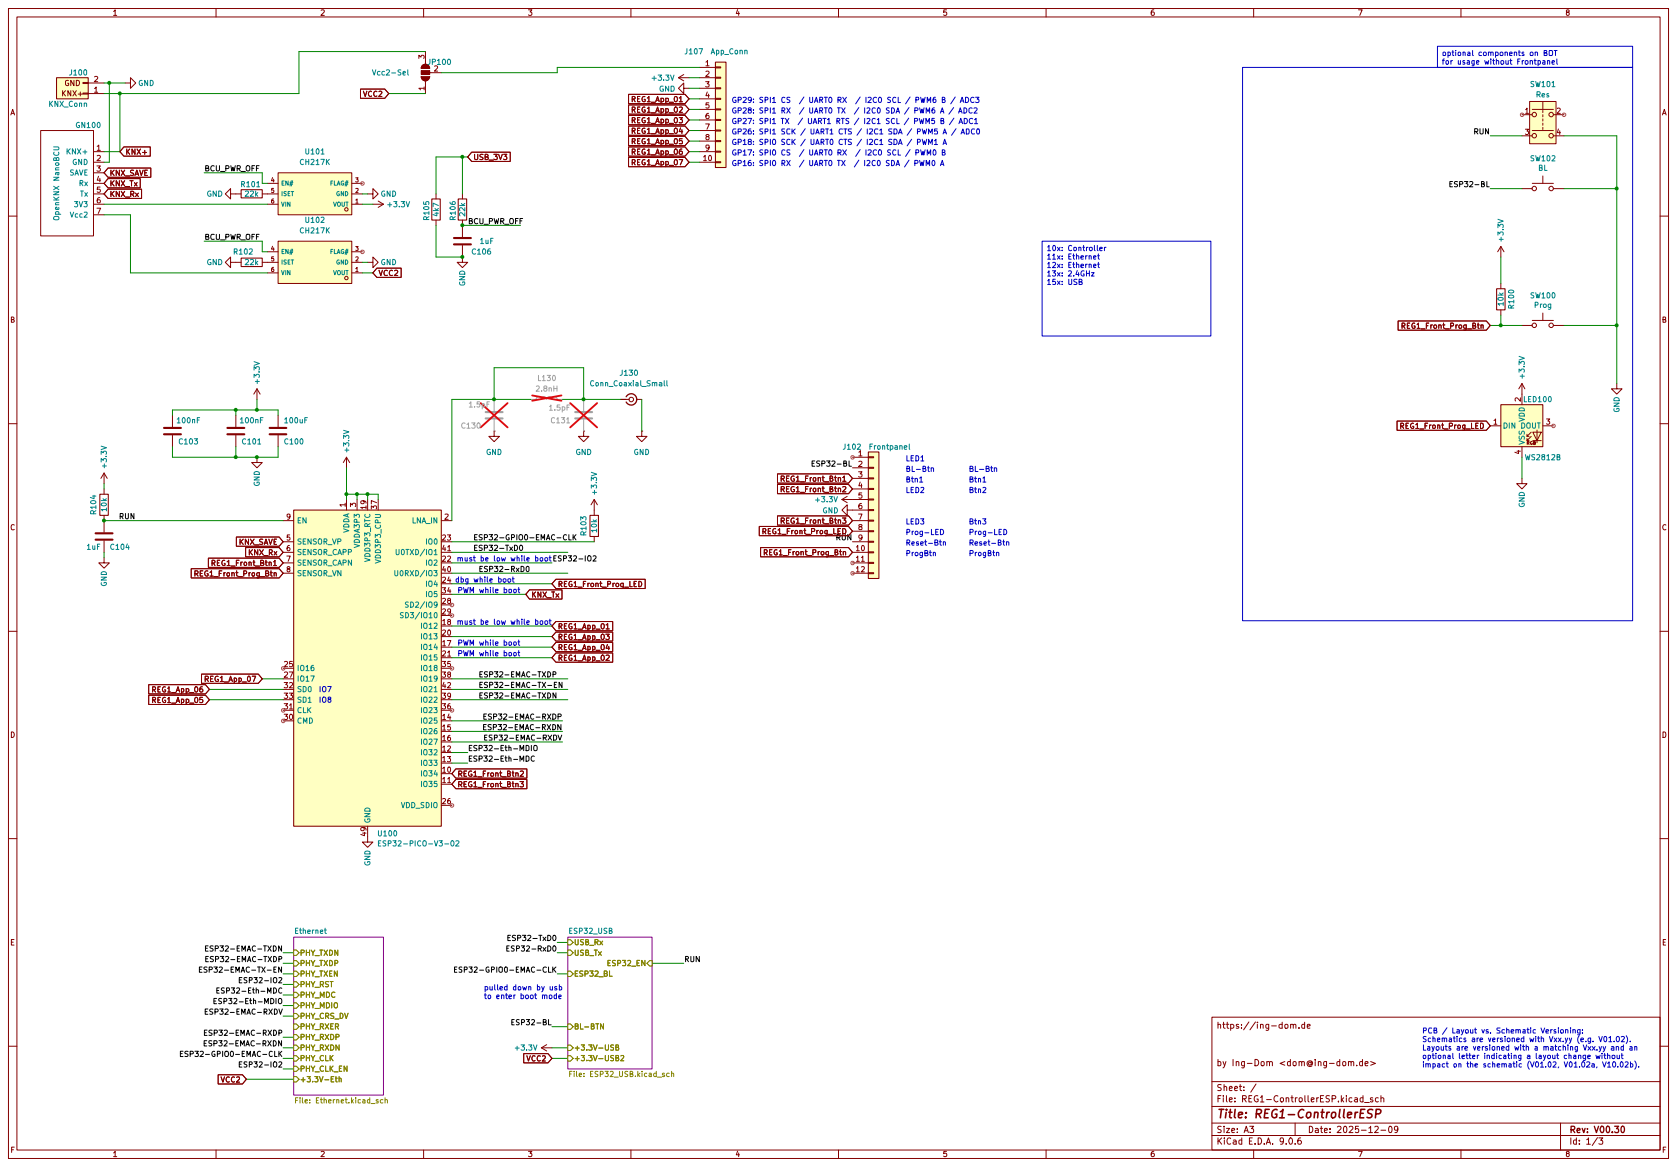
[picture p166: page 1]

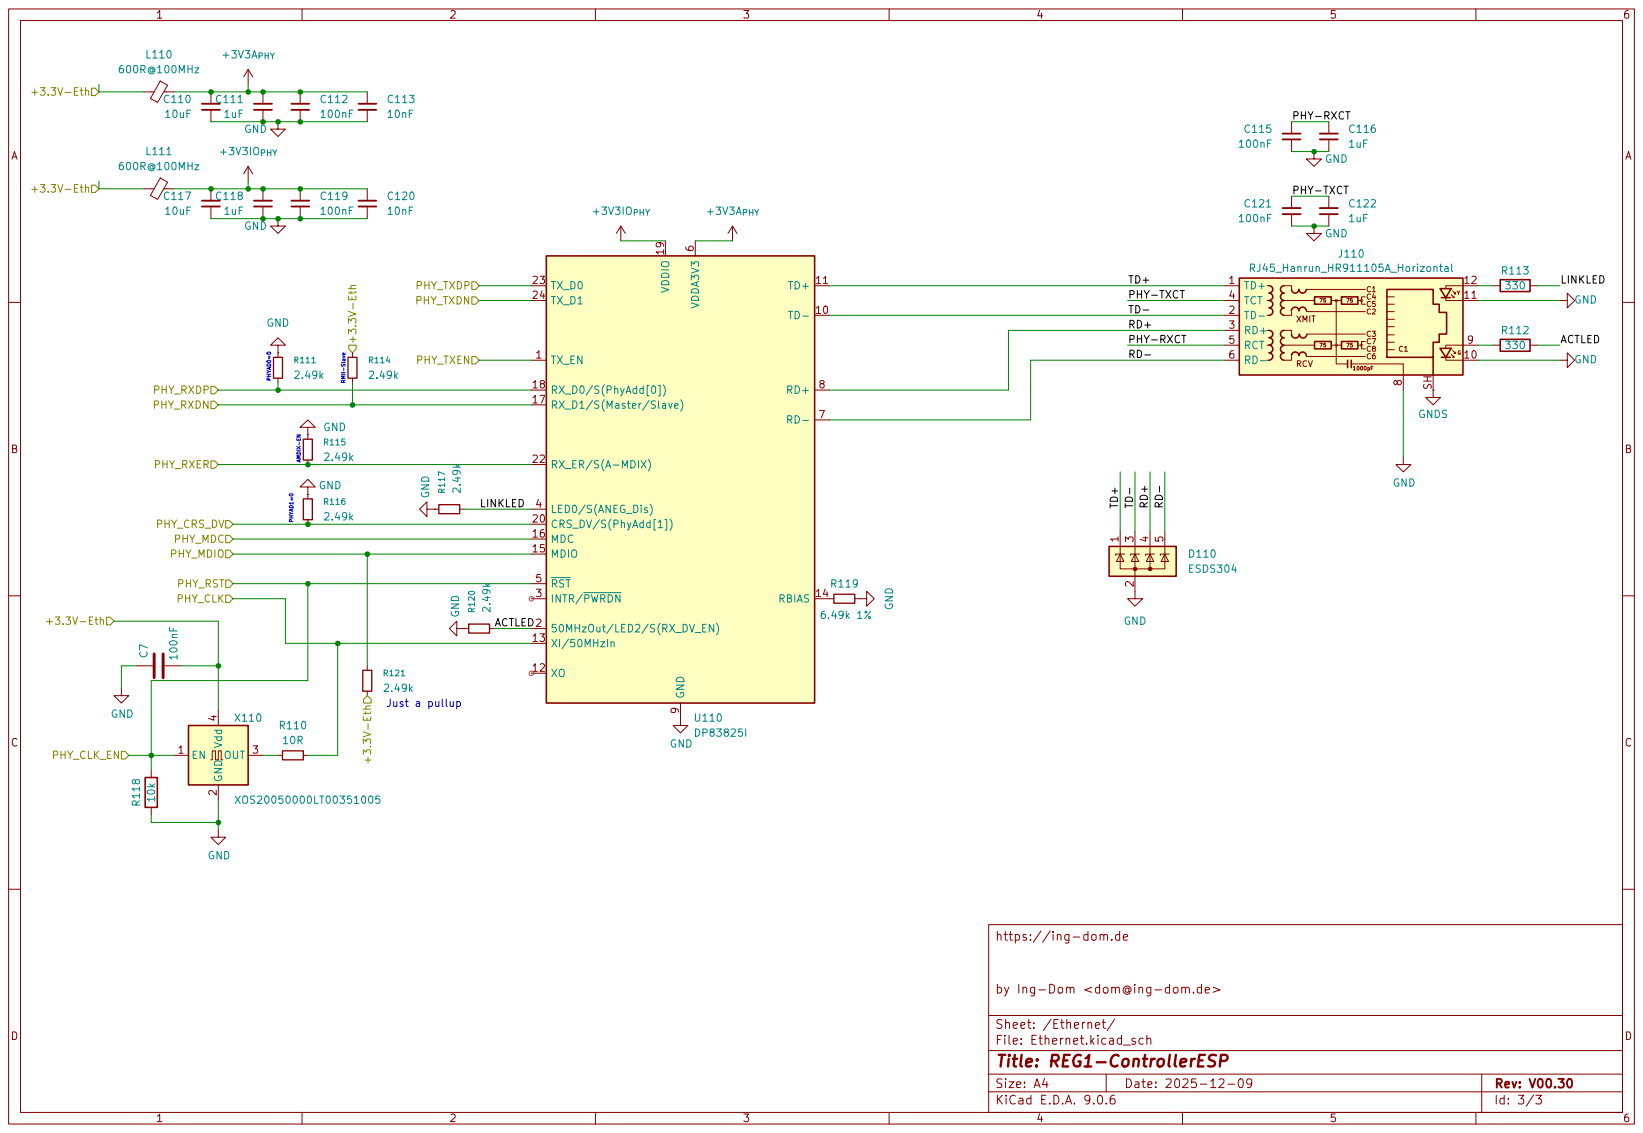
[picture p167: page 2]

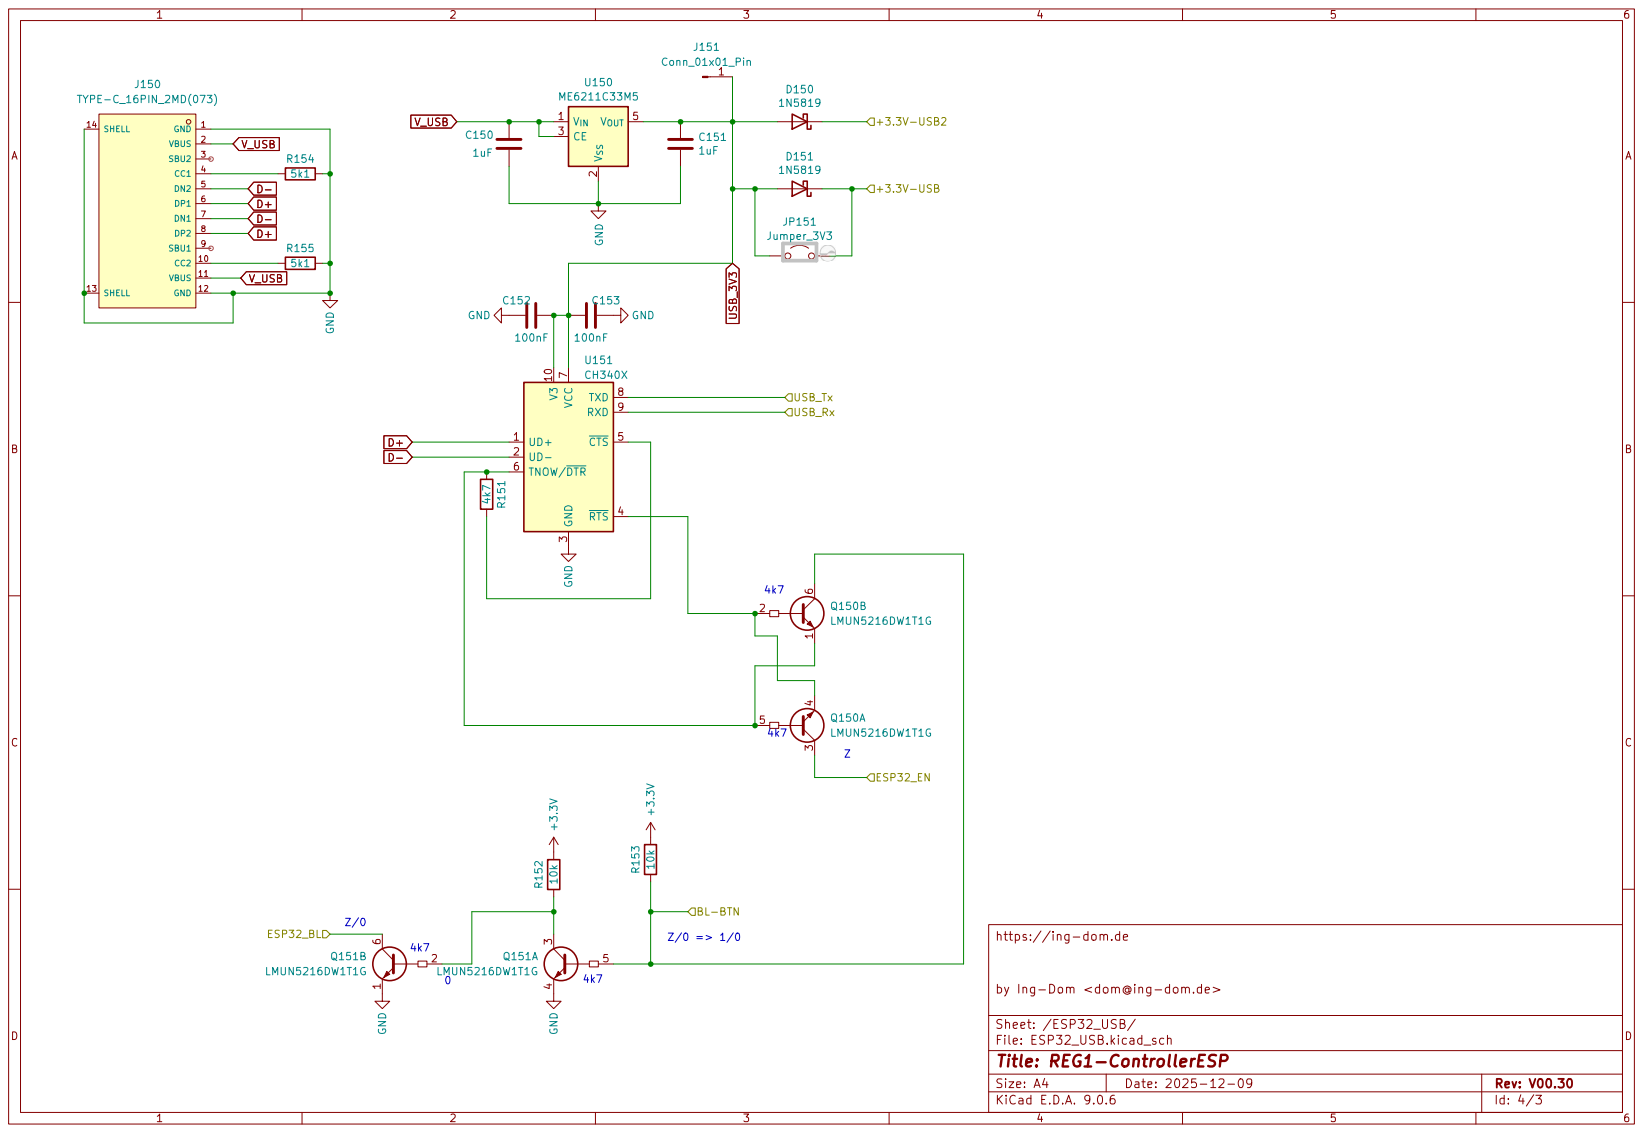
[picture p168: page 3]
