OpenKNX/OpenKNX-REG1/doc/REG1-Controller-ESP/REG1-IpTpControllerESP-Devboard_V00.11.sch.pdf

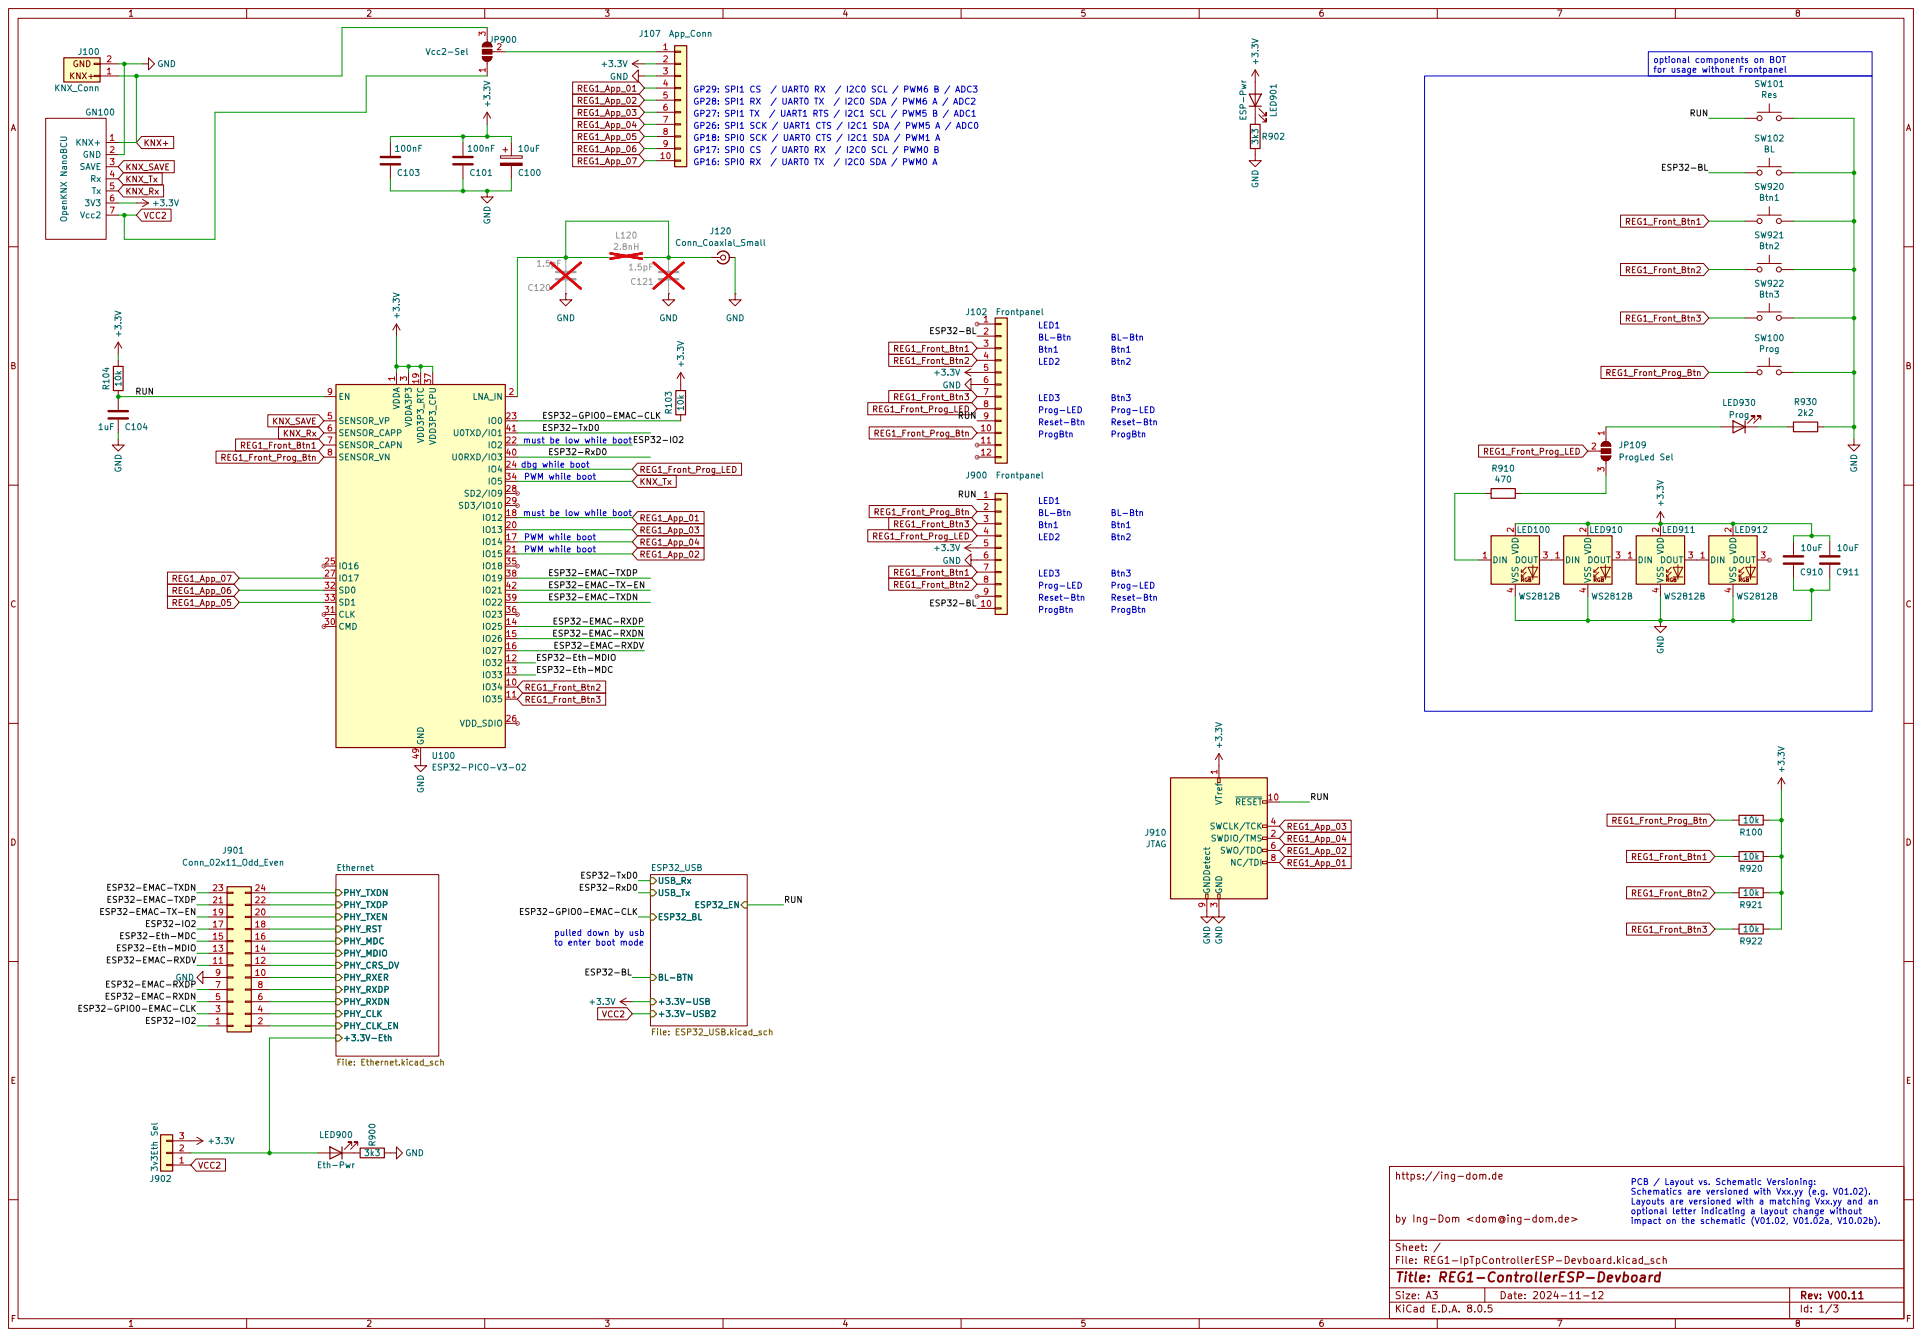
[picture p169: page 1]

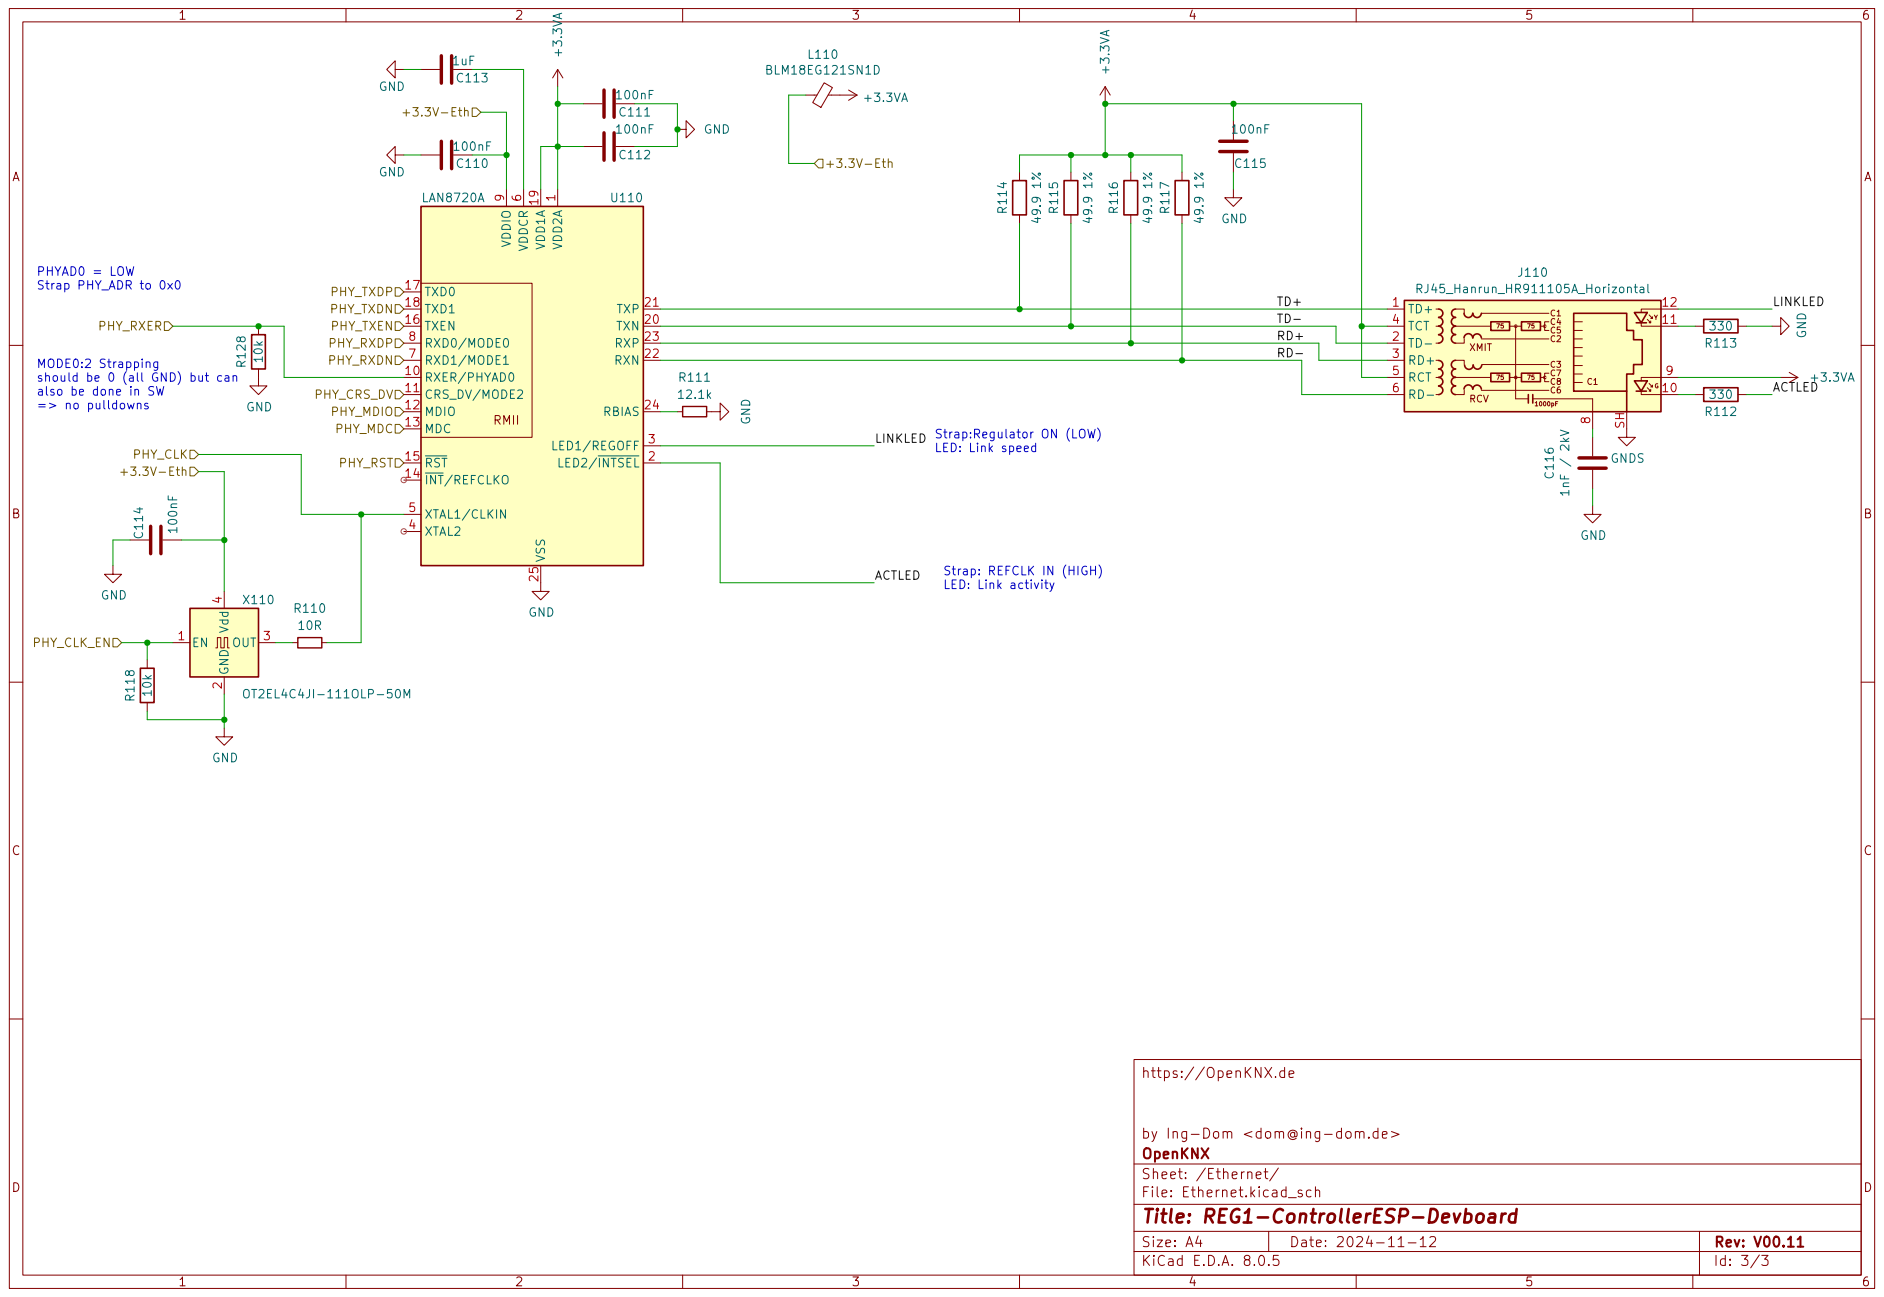
[picture p170: page 2]

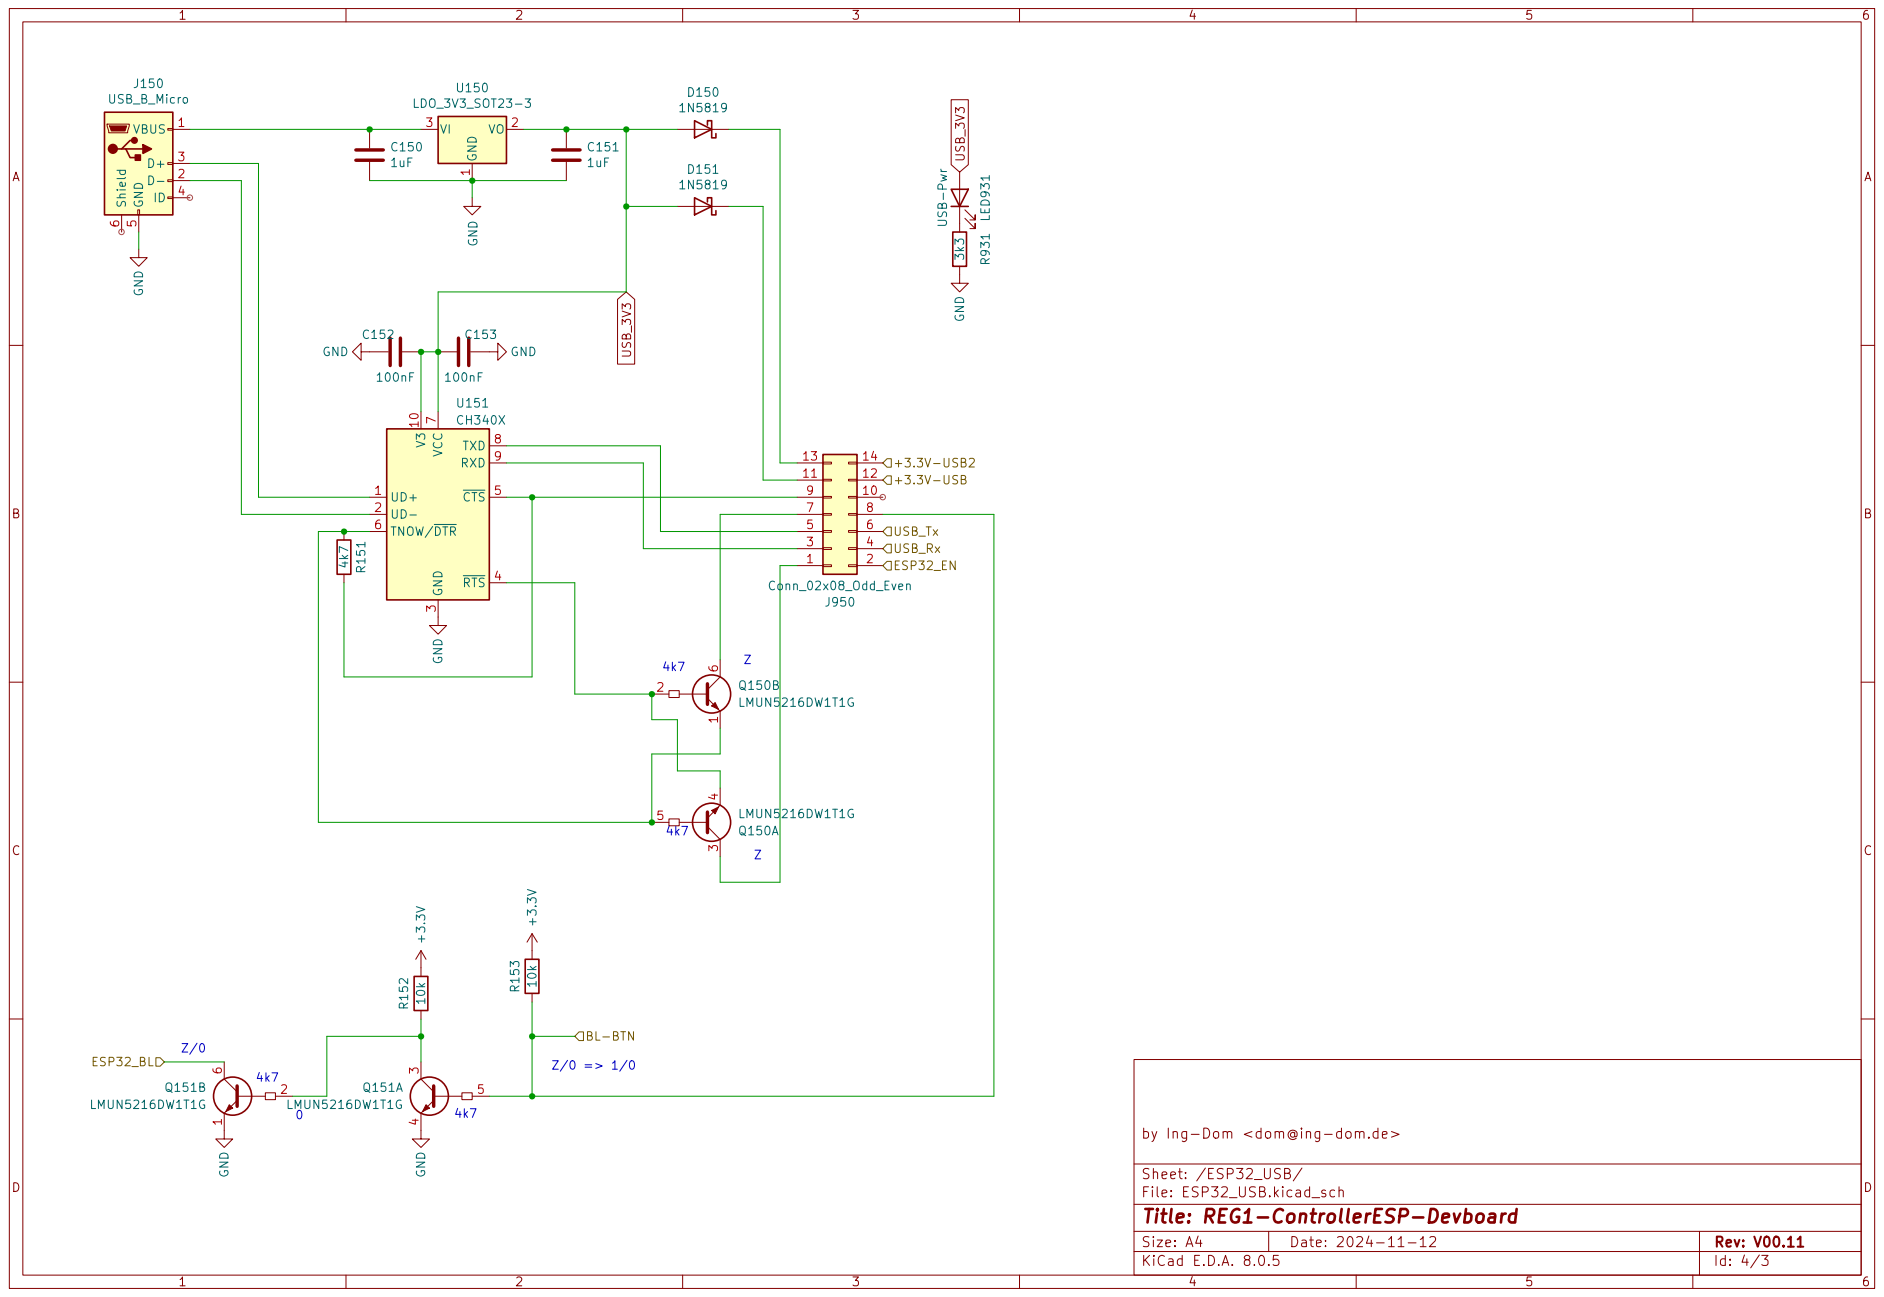
[picture p171: page 3]
