OpenKNX/OpenKNX-REG1/doc/REG1-App-SEN-Multi_V00.02.sch.pdf

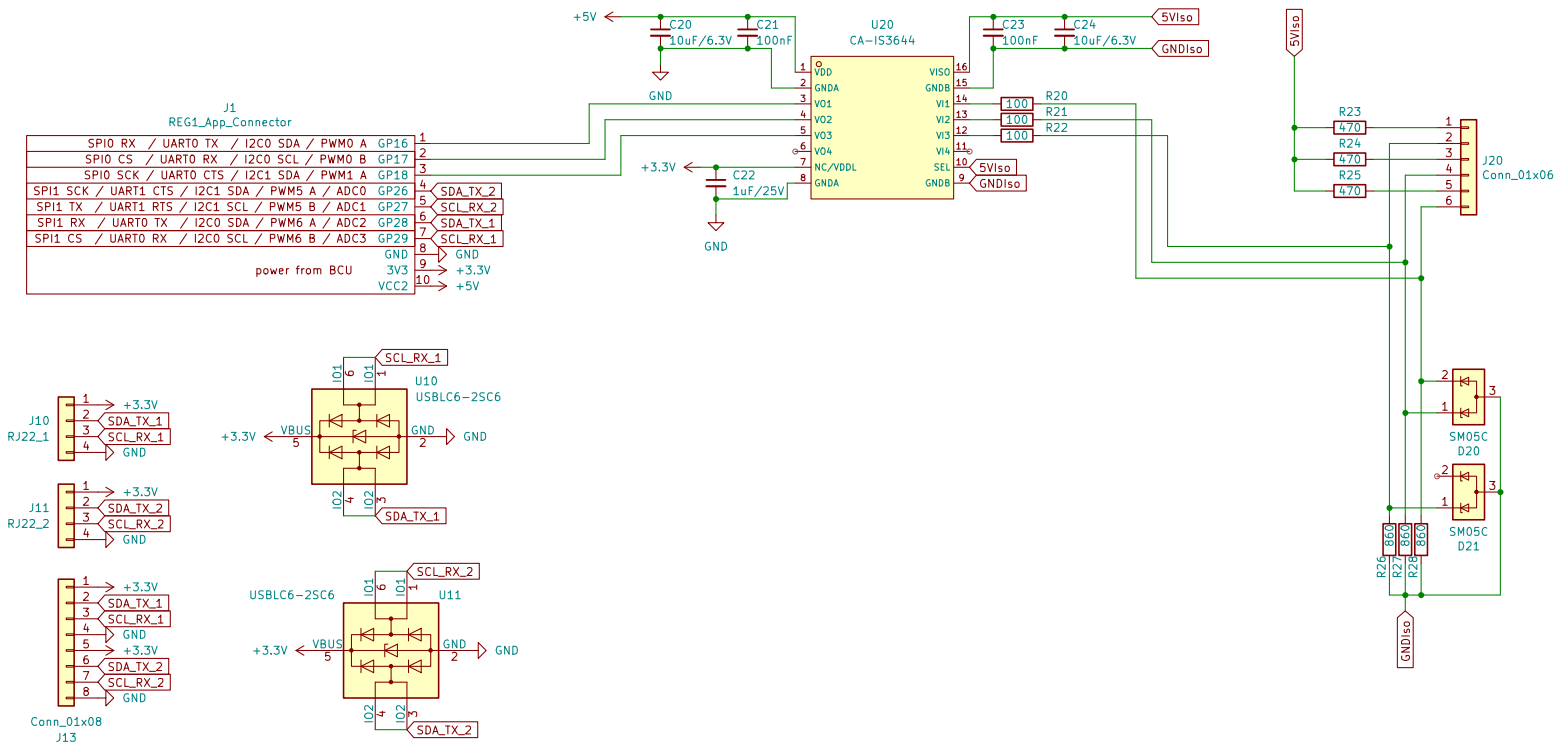
[picture p172: page 1]
