OpenKNX/OpenKNX-REG1/doc/REG1-Controller2040_V00.99.sch.pdf

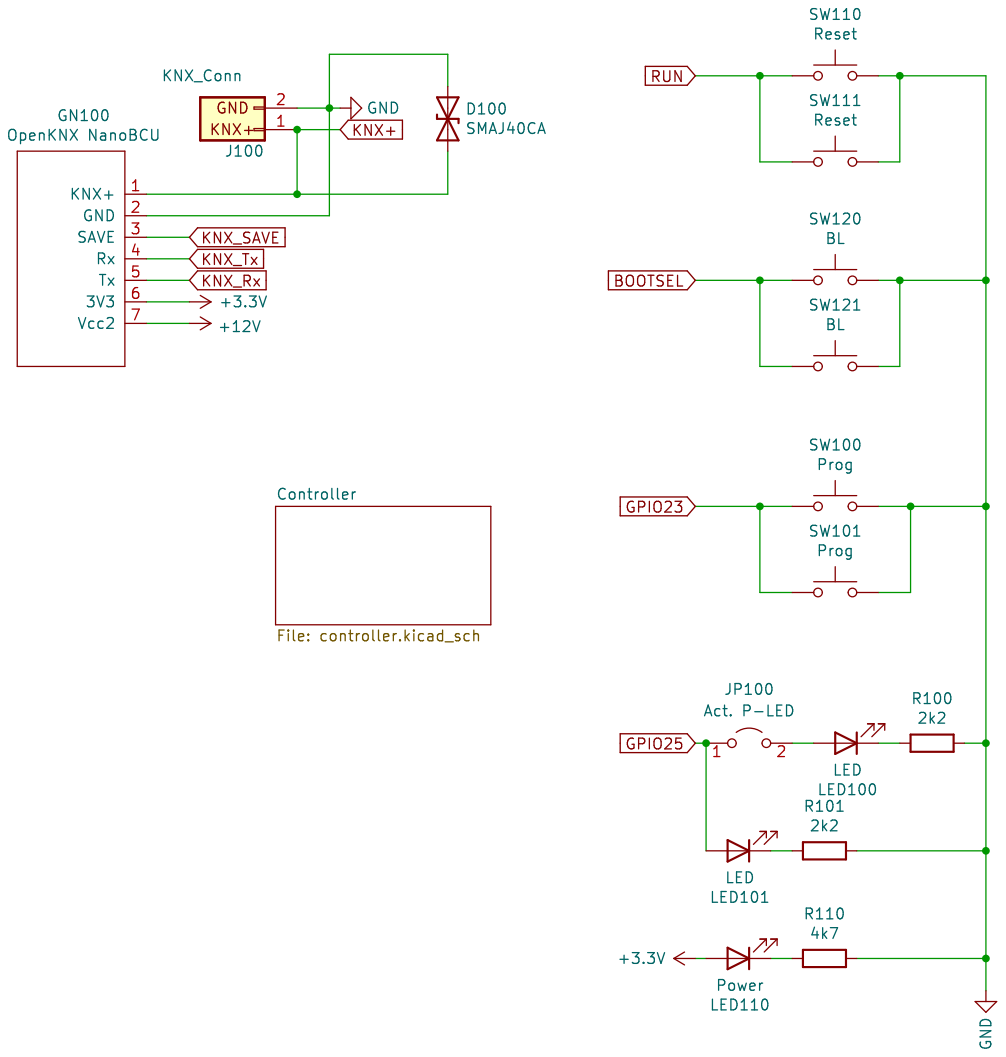
[picture p173: page 1]

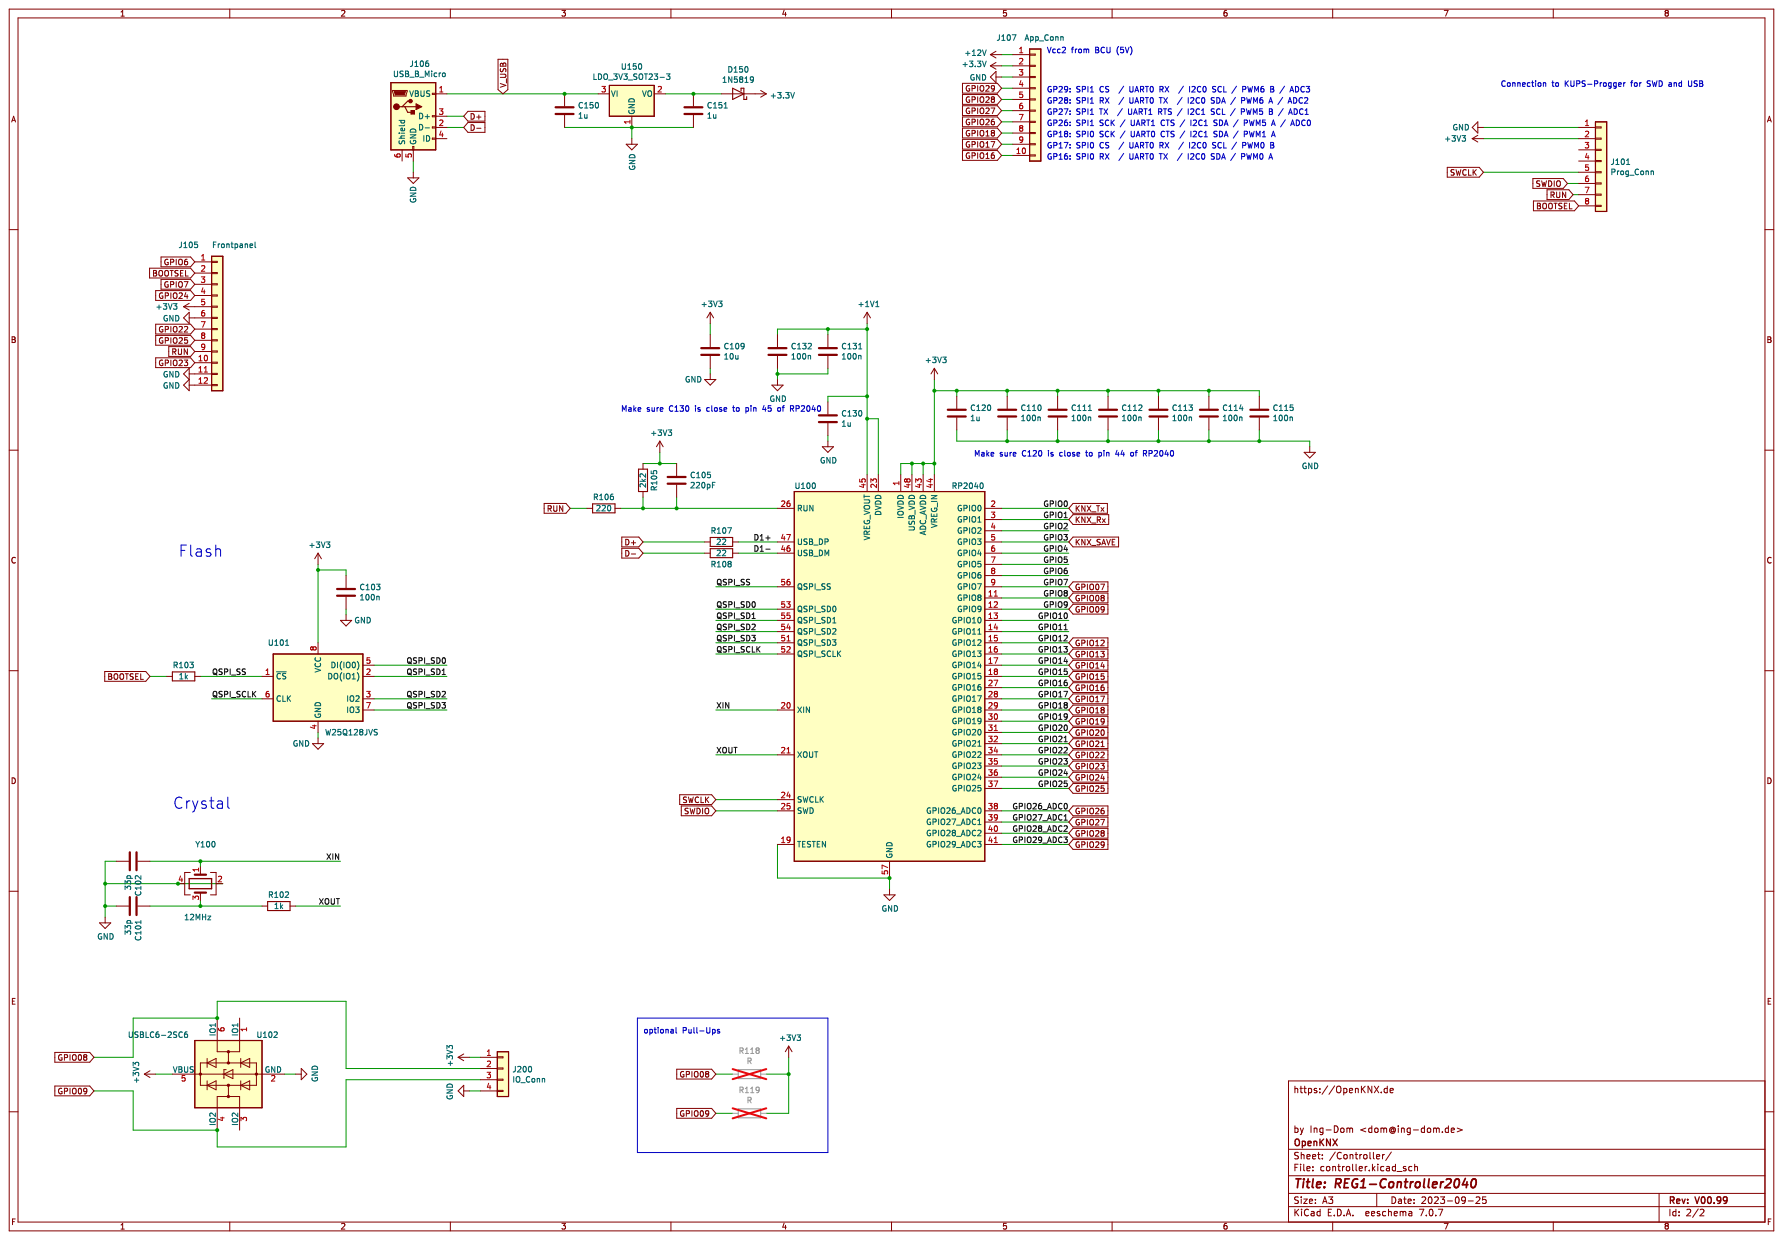
[picture p174: page 2]
