OpenKNX/OpenKNX-REG1/doc/REG1-Controller2040_V01.00.sch.pdf

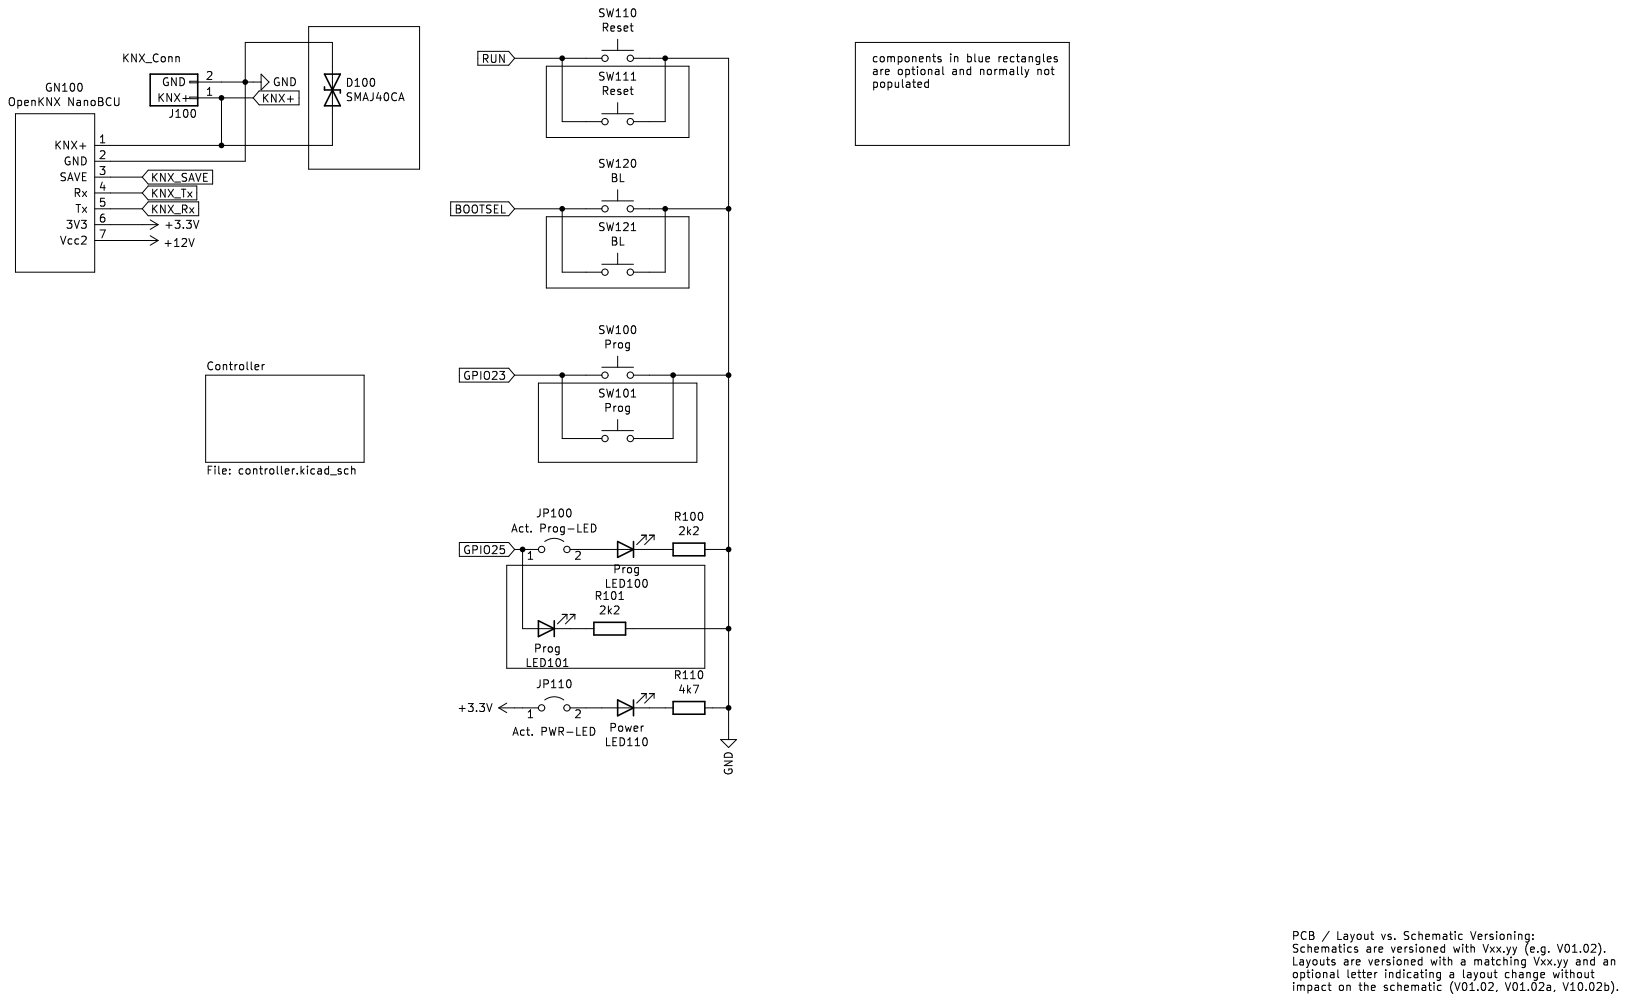
[picture p175: page 1]

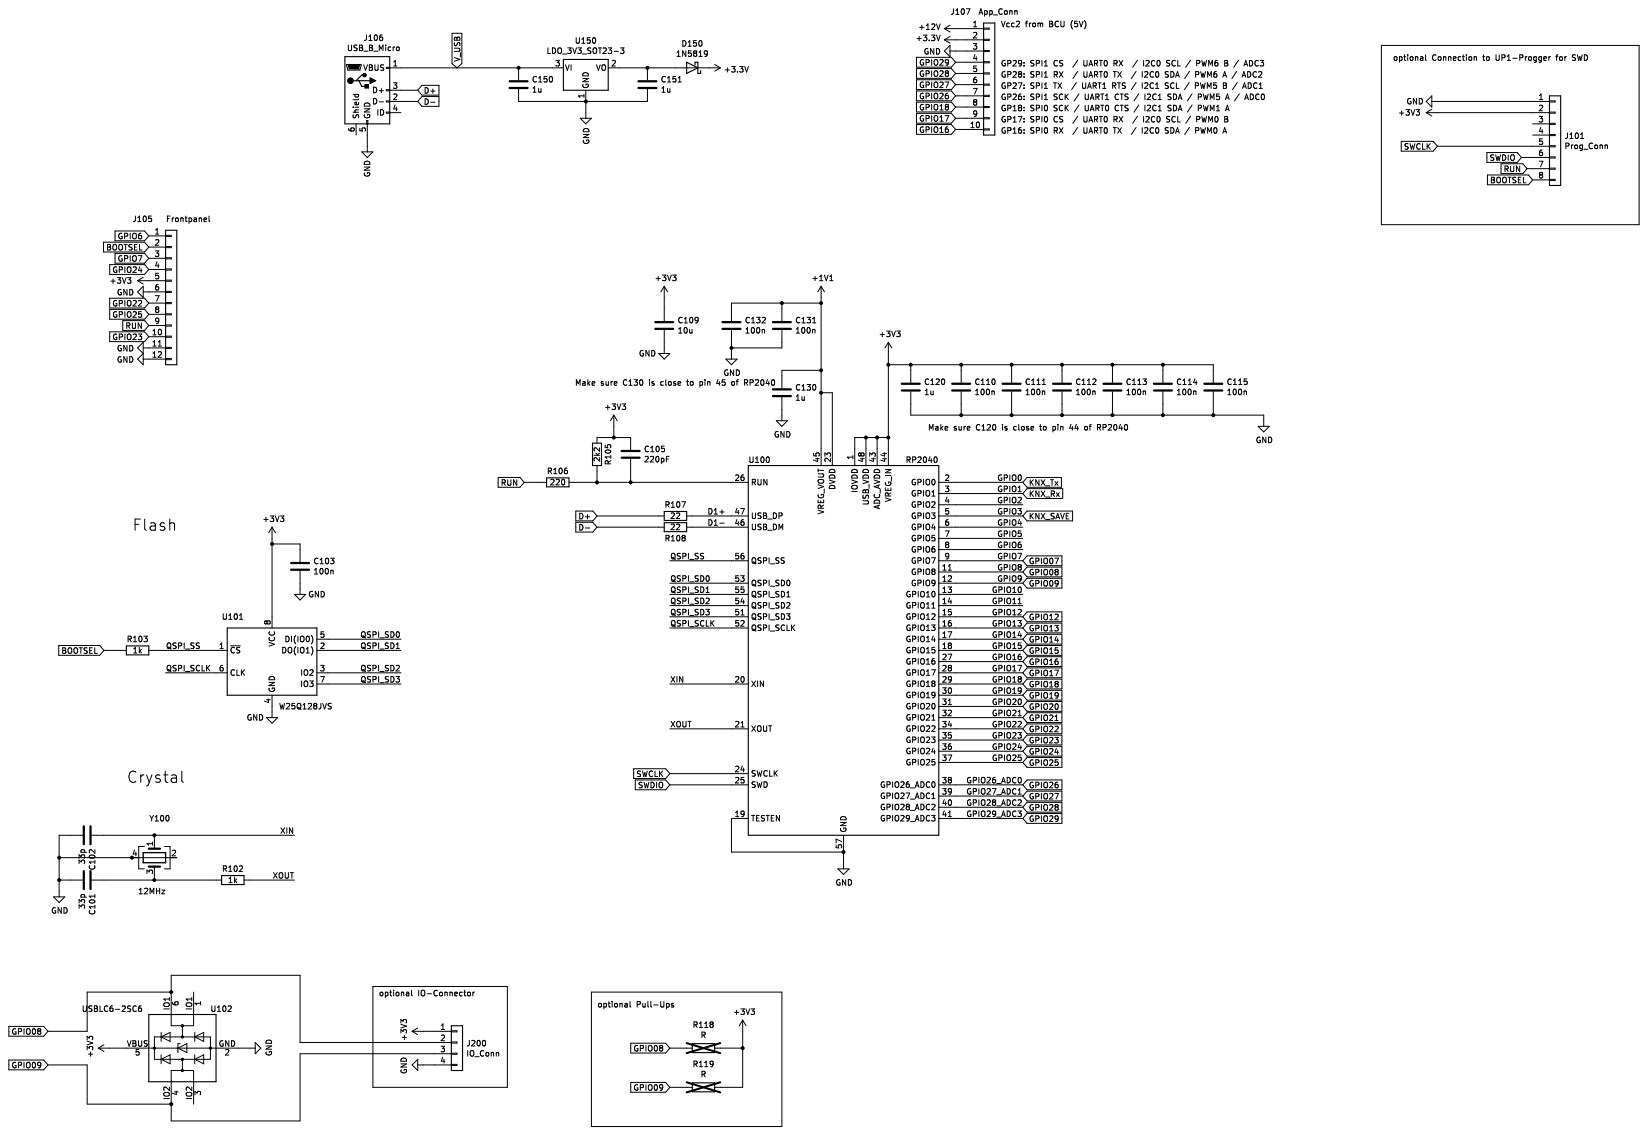
[picture p176: page 2]
