OpenKNX/OpenKNX-REG1/doc/REG1-App-Universal_V00.10.sch.pdf

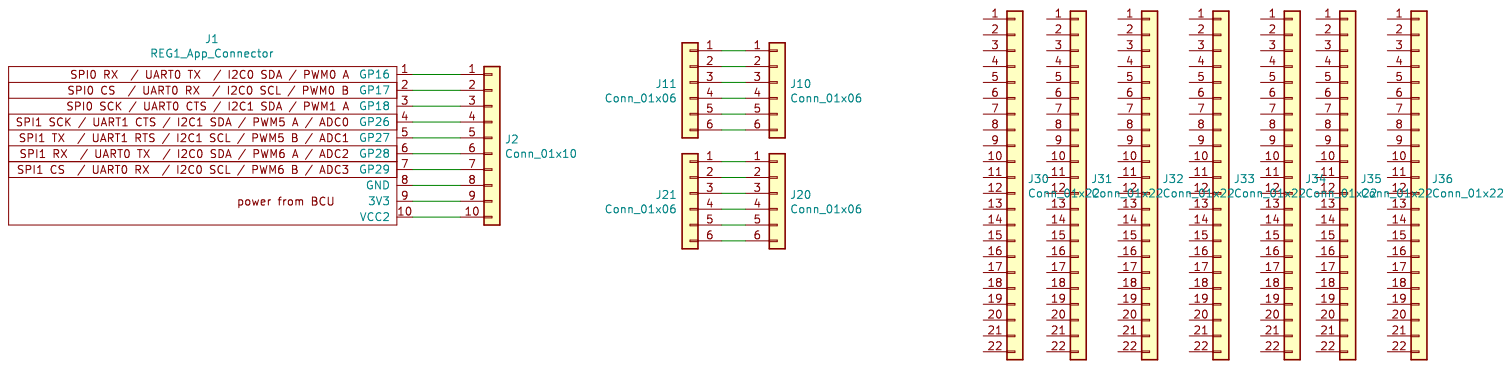
[picture p177: page 1]
