OpenKNX/OpenKNX-REG1/doc/REG1-Controller2040_V00.10.sch.pdf

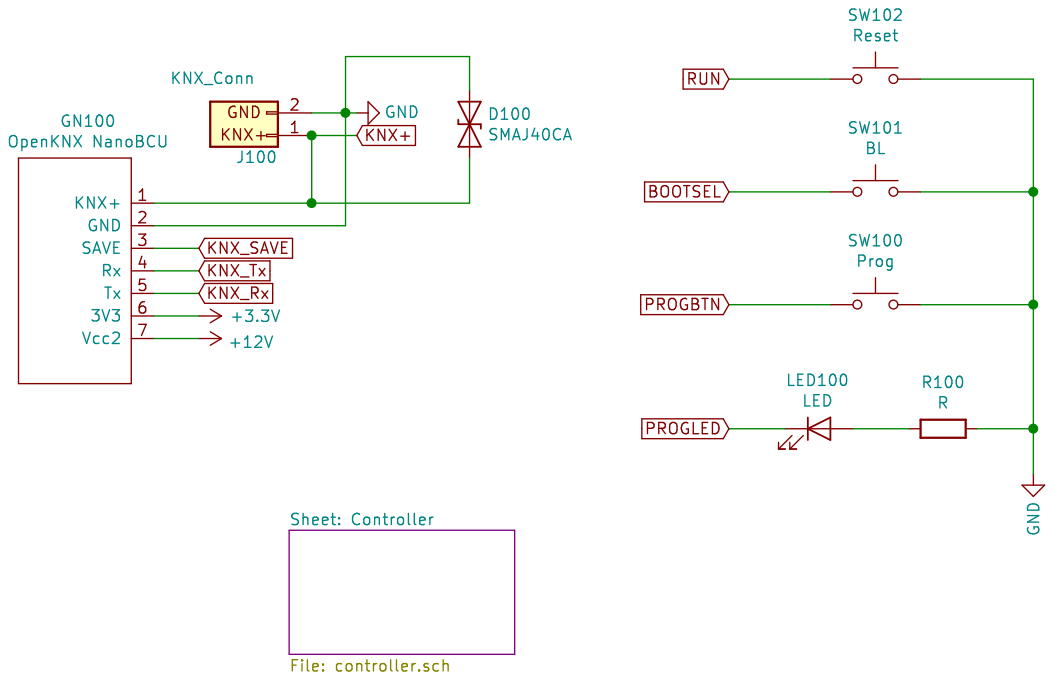
[picture p178: page 1]

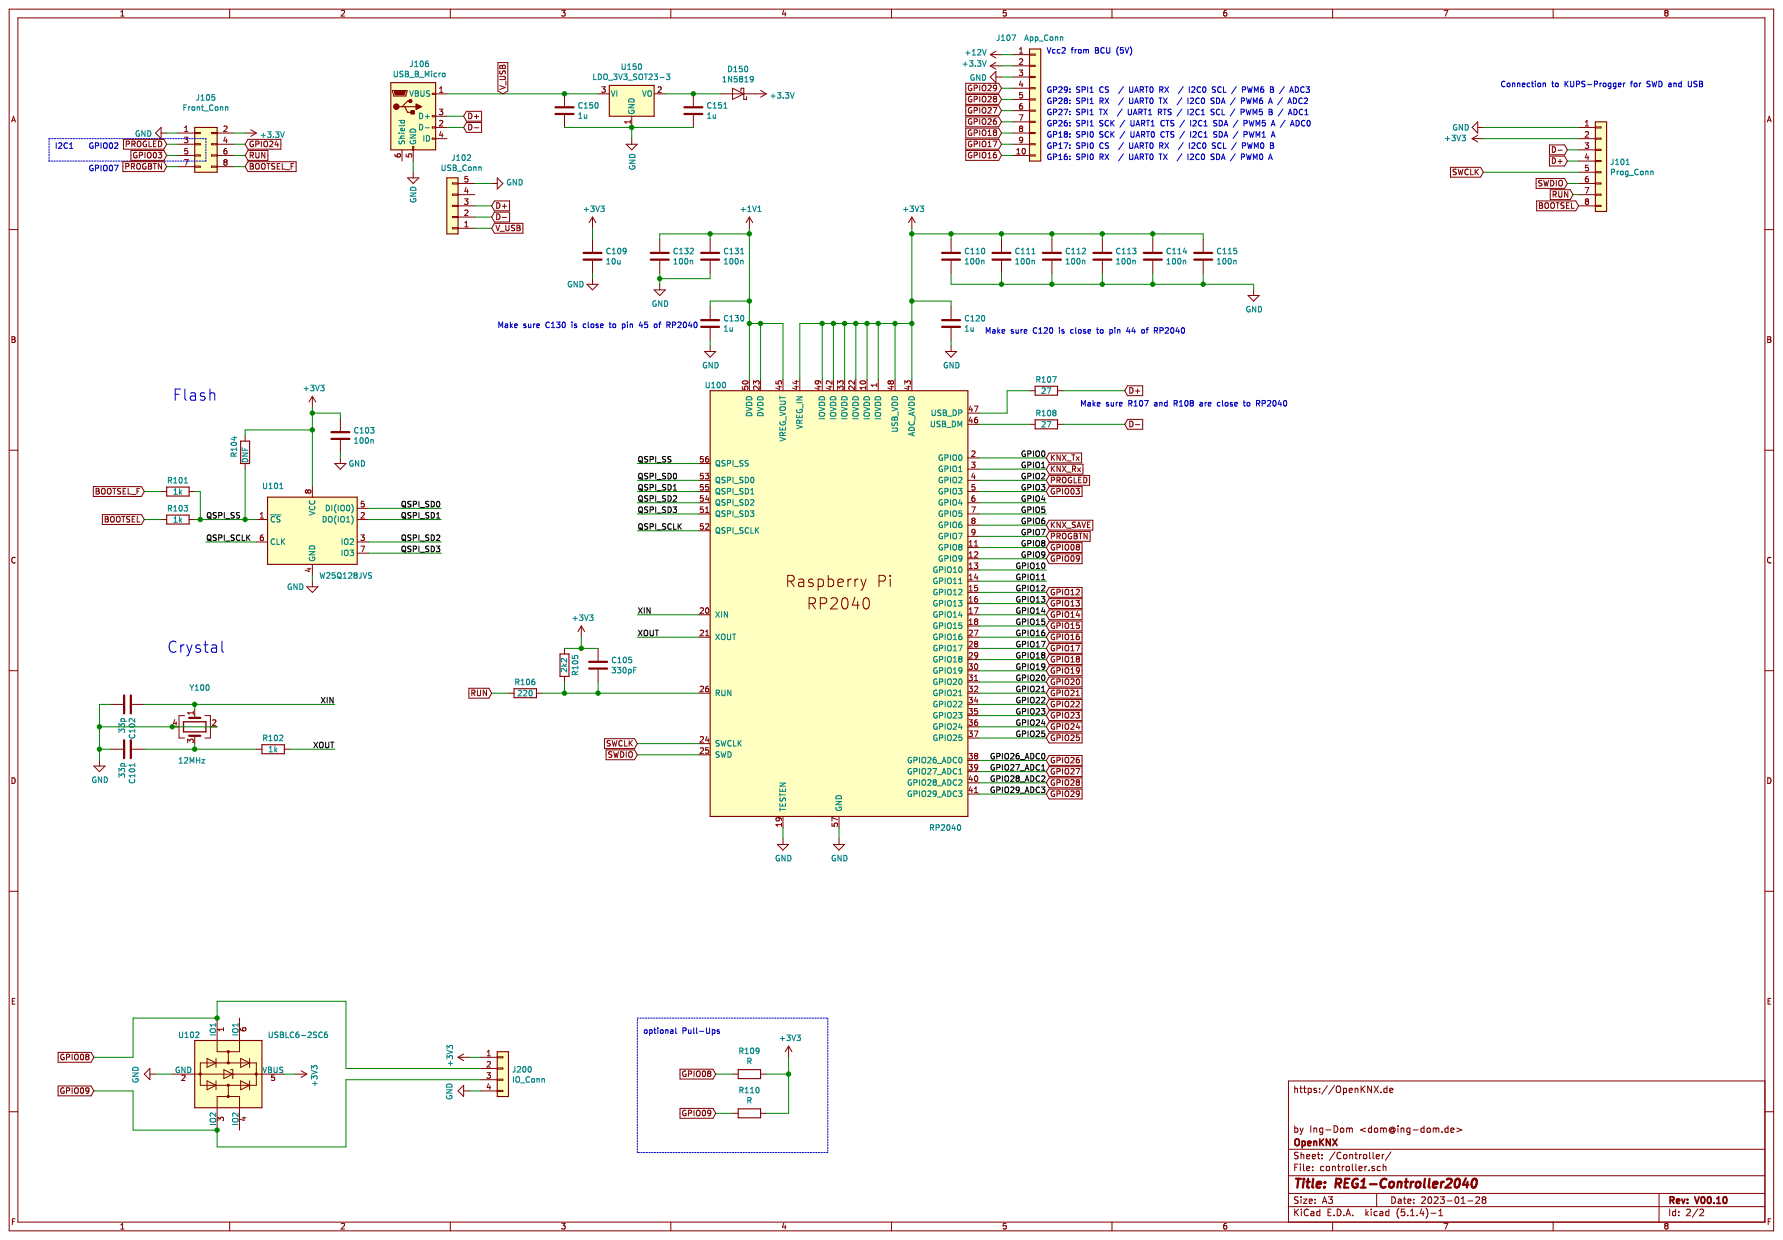
[picture p179: page 2]
