OpenKNX/OpenKNX-REG1/doc/REG1-App-Universal_V00.02.sch.pdf

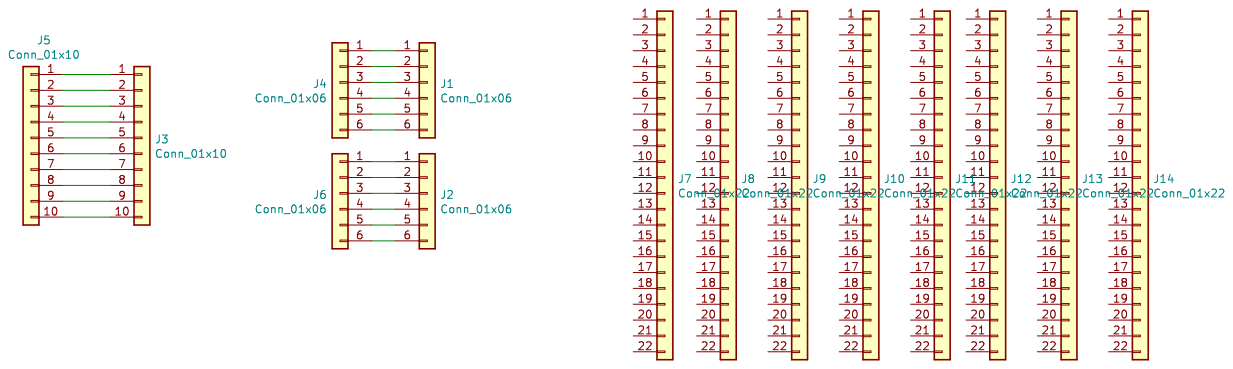
[picture p180: page 1]
