OpenKNX/OpenKNX-REG1/doc/REG1-Controller2040_V00.03.sch.pdf

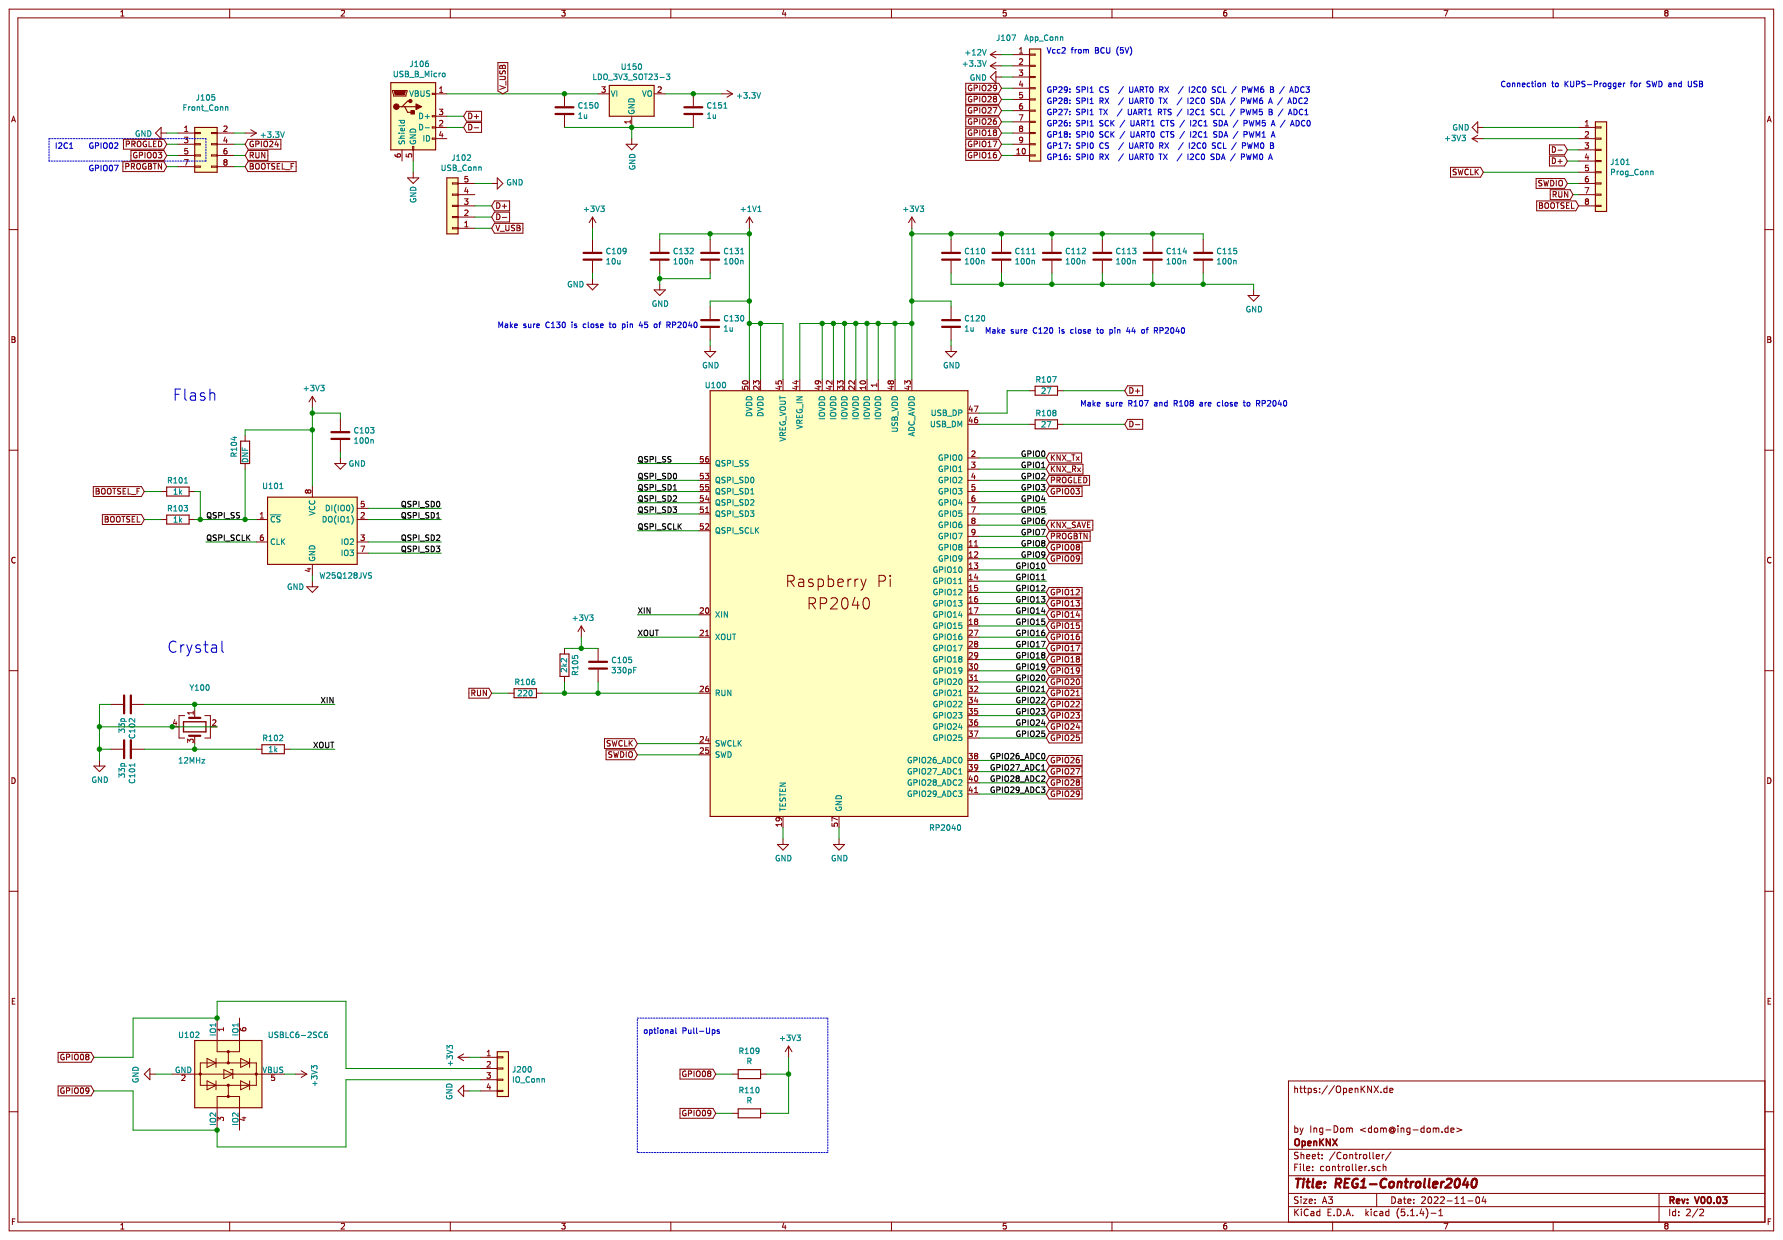
[picture p181: page 2]
