OpenKNX/OpenKNX-REG1/doc/REG1-Front-Universal_V00.02.sch.pdf

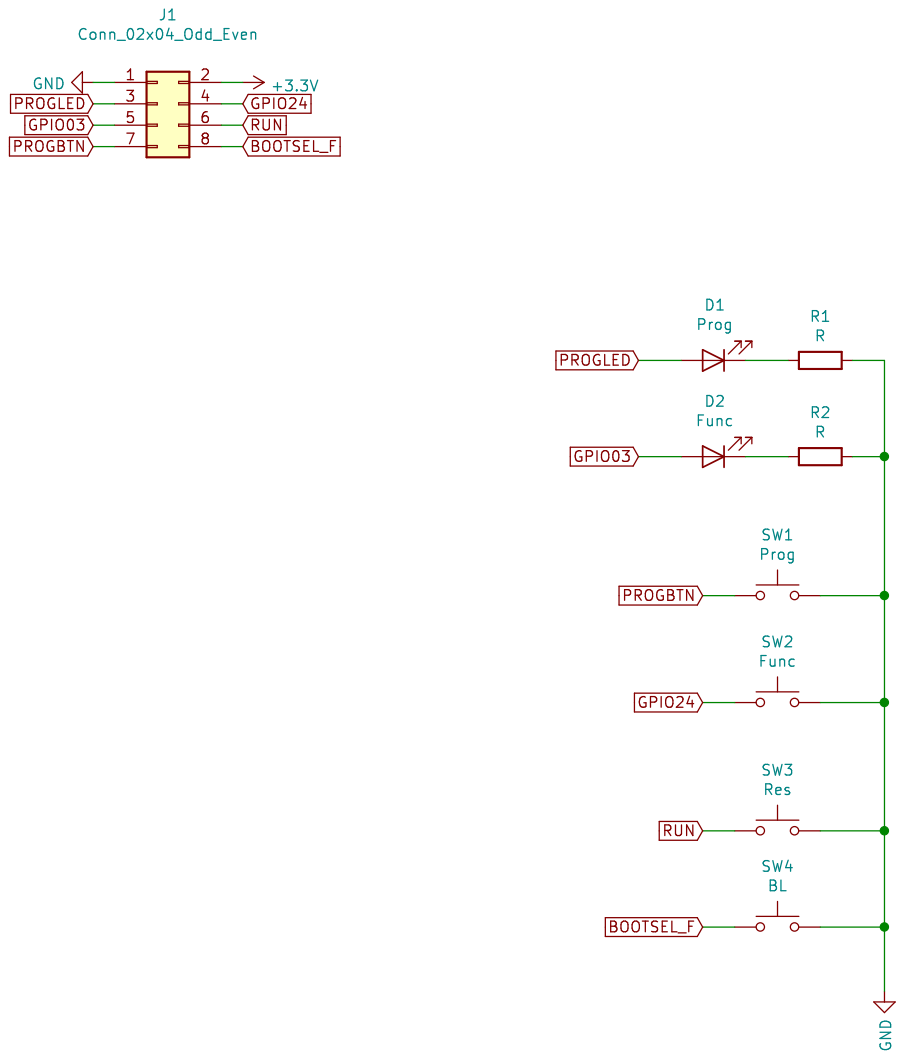
[picture p182: page 1]
