OpenKNX/OpenKNX-REG1/doc/REG1-Controller2040_V00.01.sch.pdf

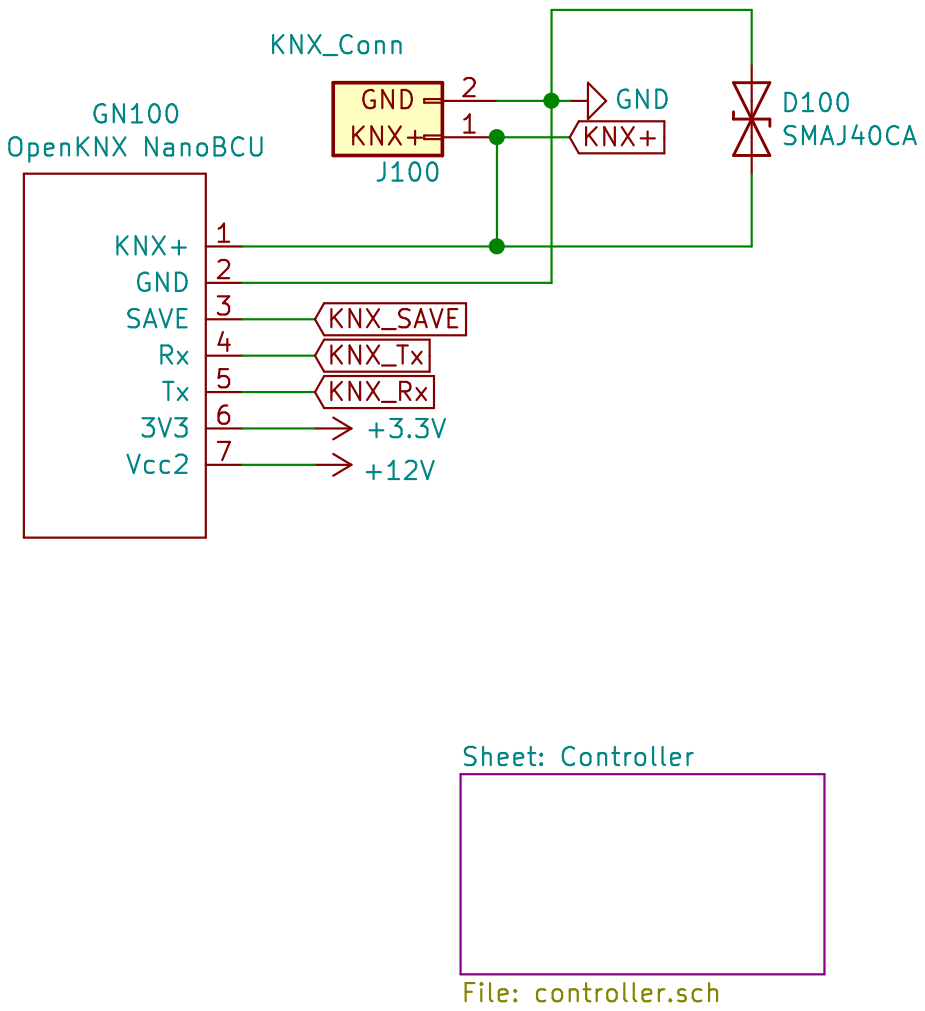
[picture p183: page 1]

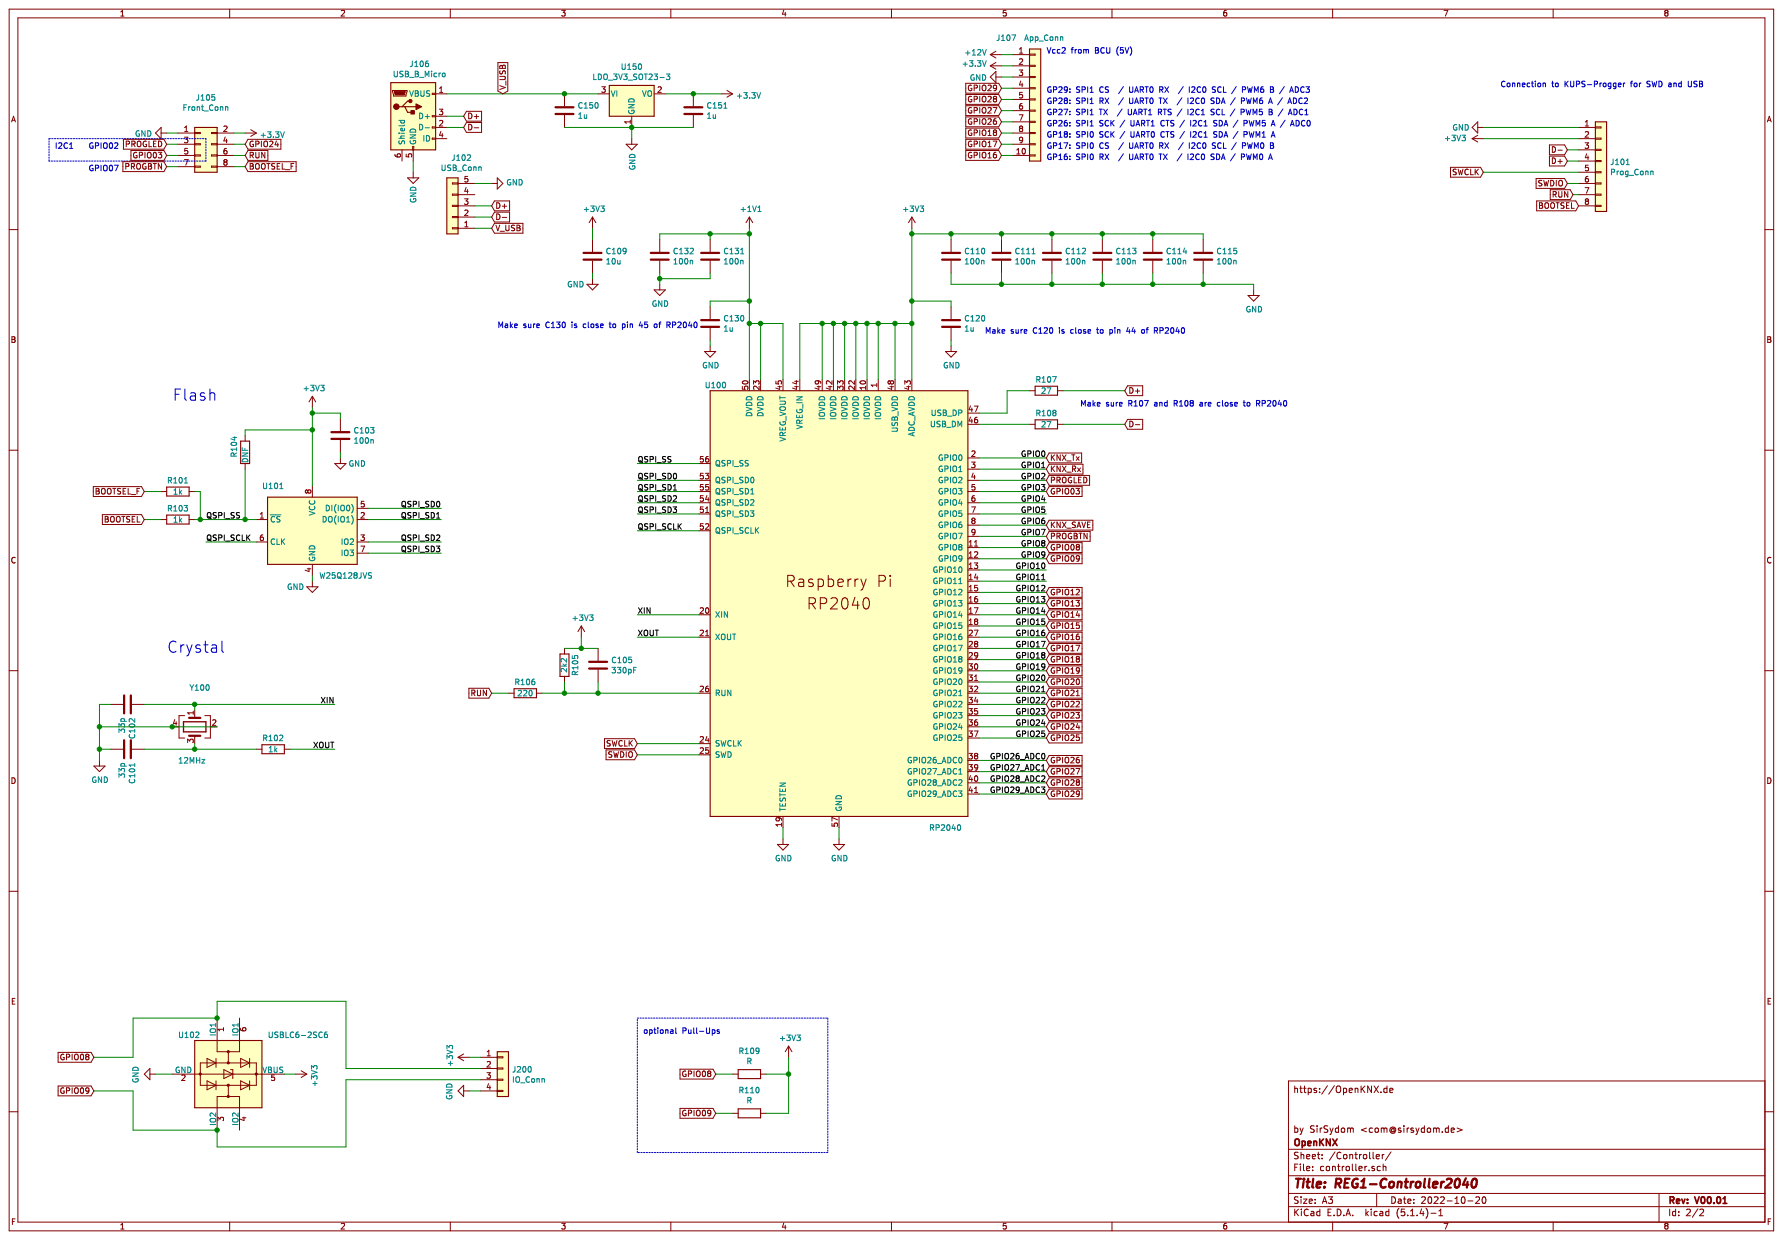
[picture p184: page 2]
