OpenKNX/OpenKNX-REG1/doc/REG1-Controller2040_V00.02.sch.pdf

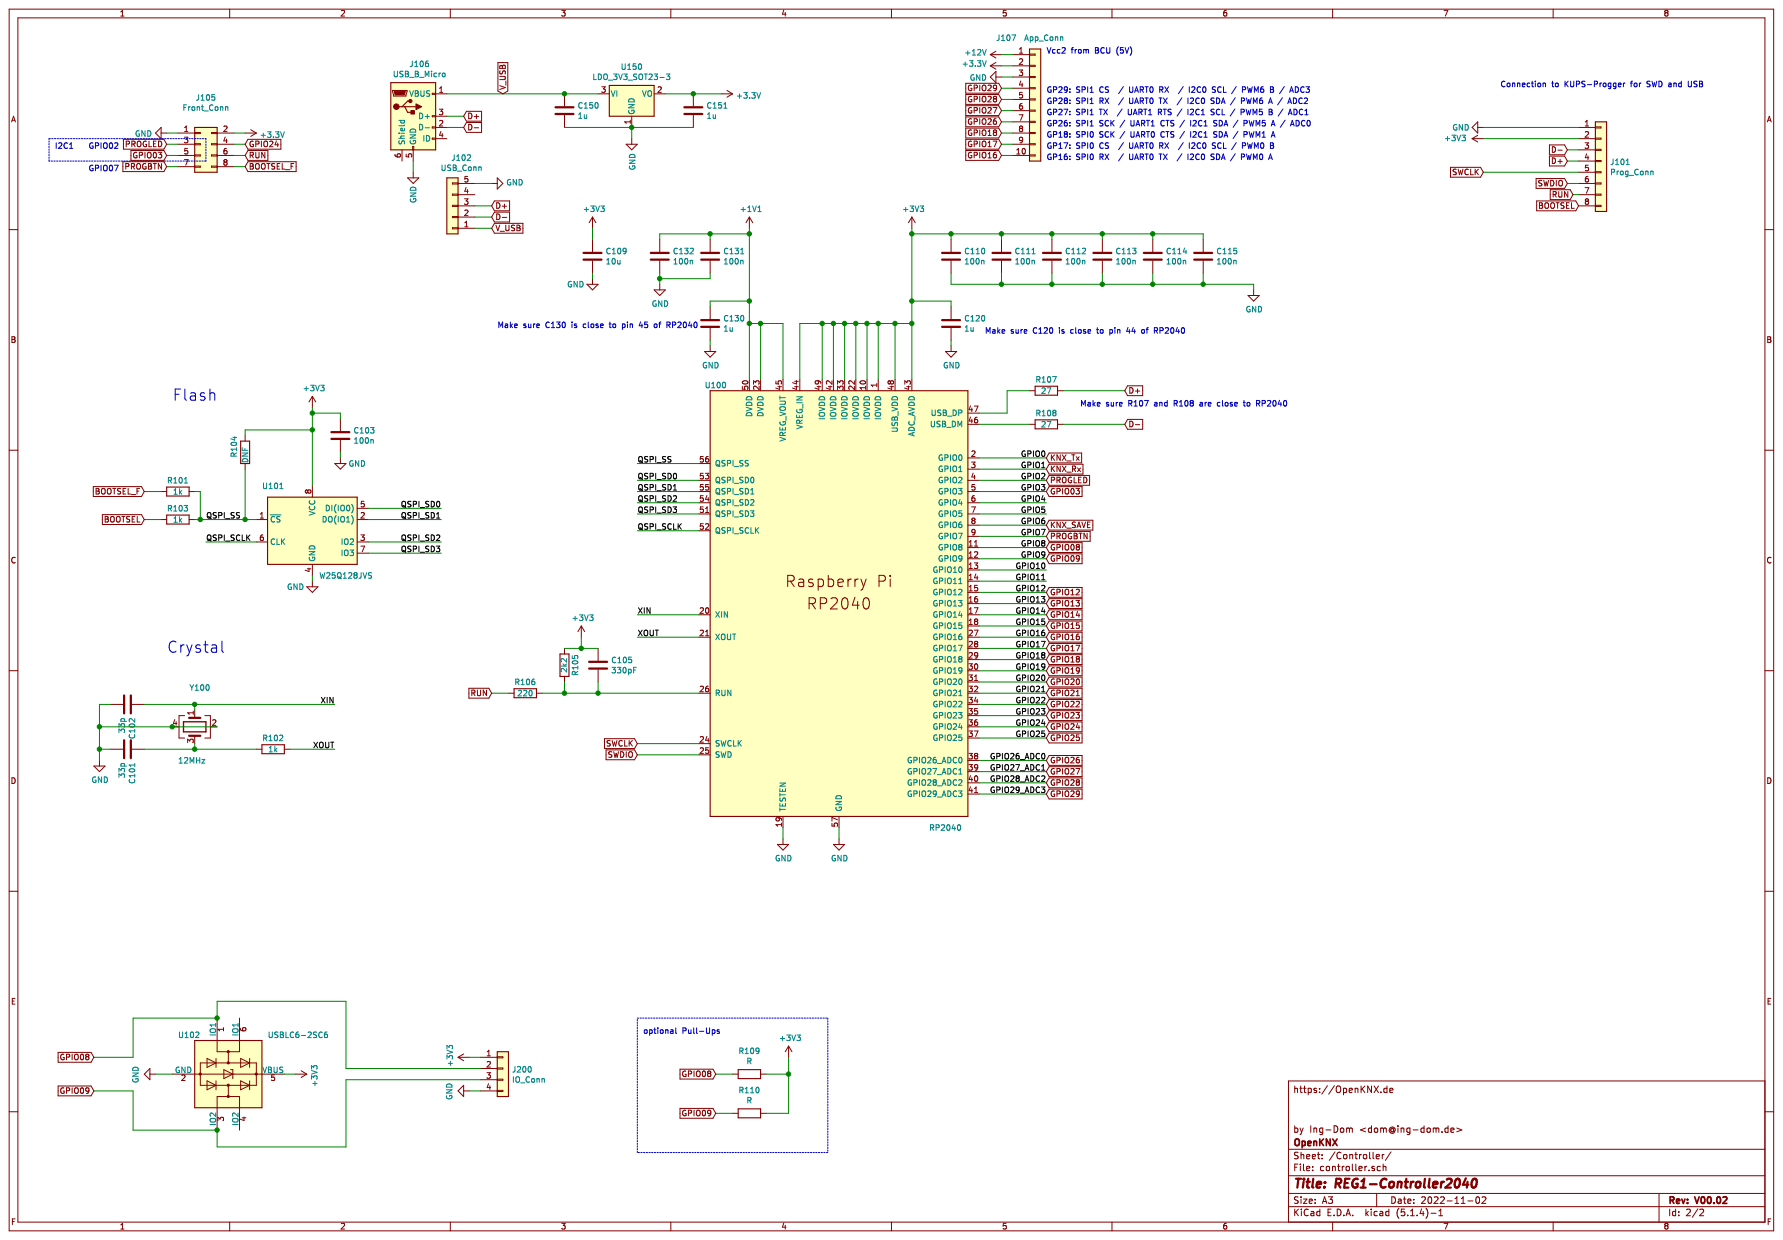
[picture p185: page 2]
