OpenKNX/OpenKNX-REG1/doc/REG1-Controller-ESP/REG1-ControllerESP_V00.11.sch.pdf

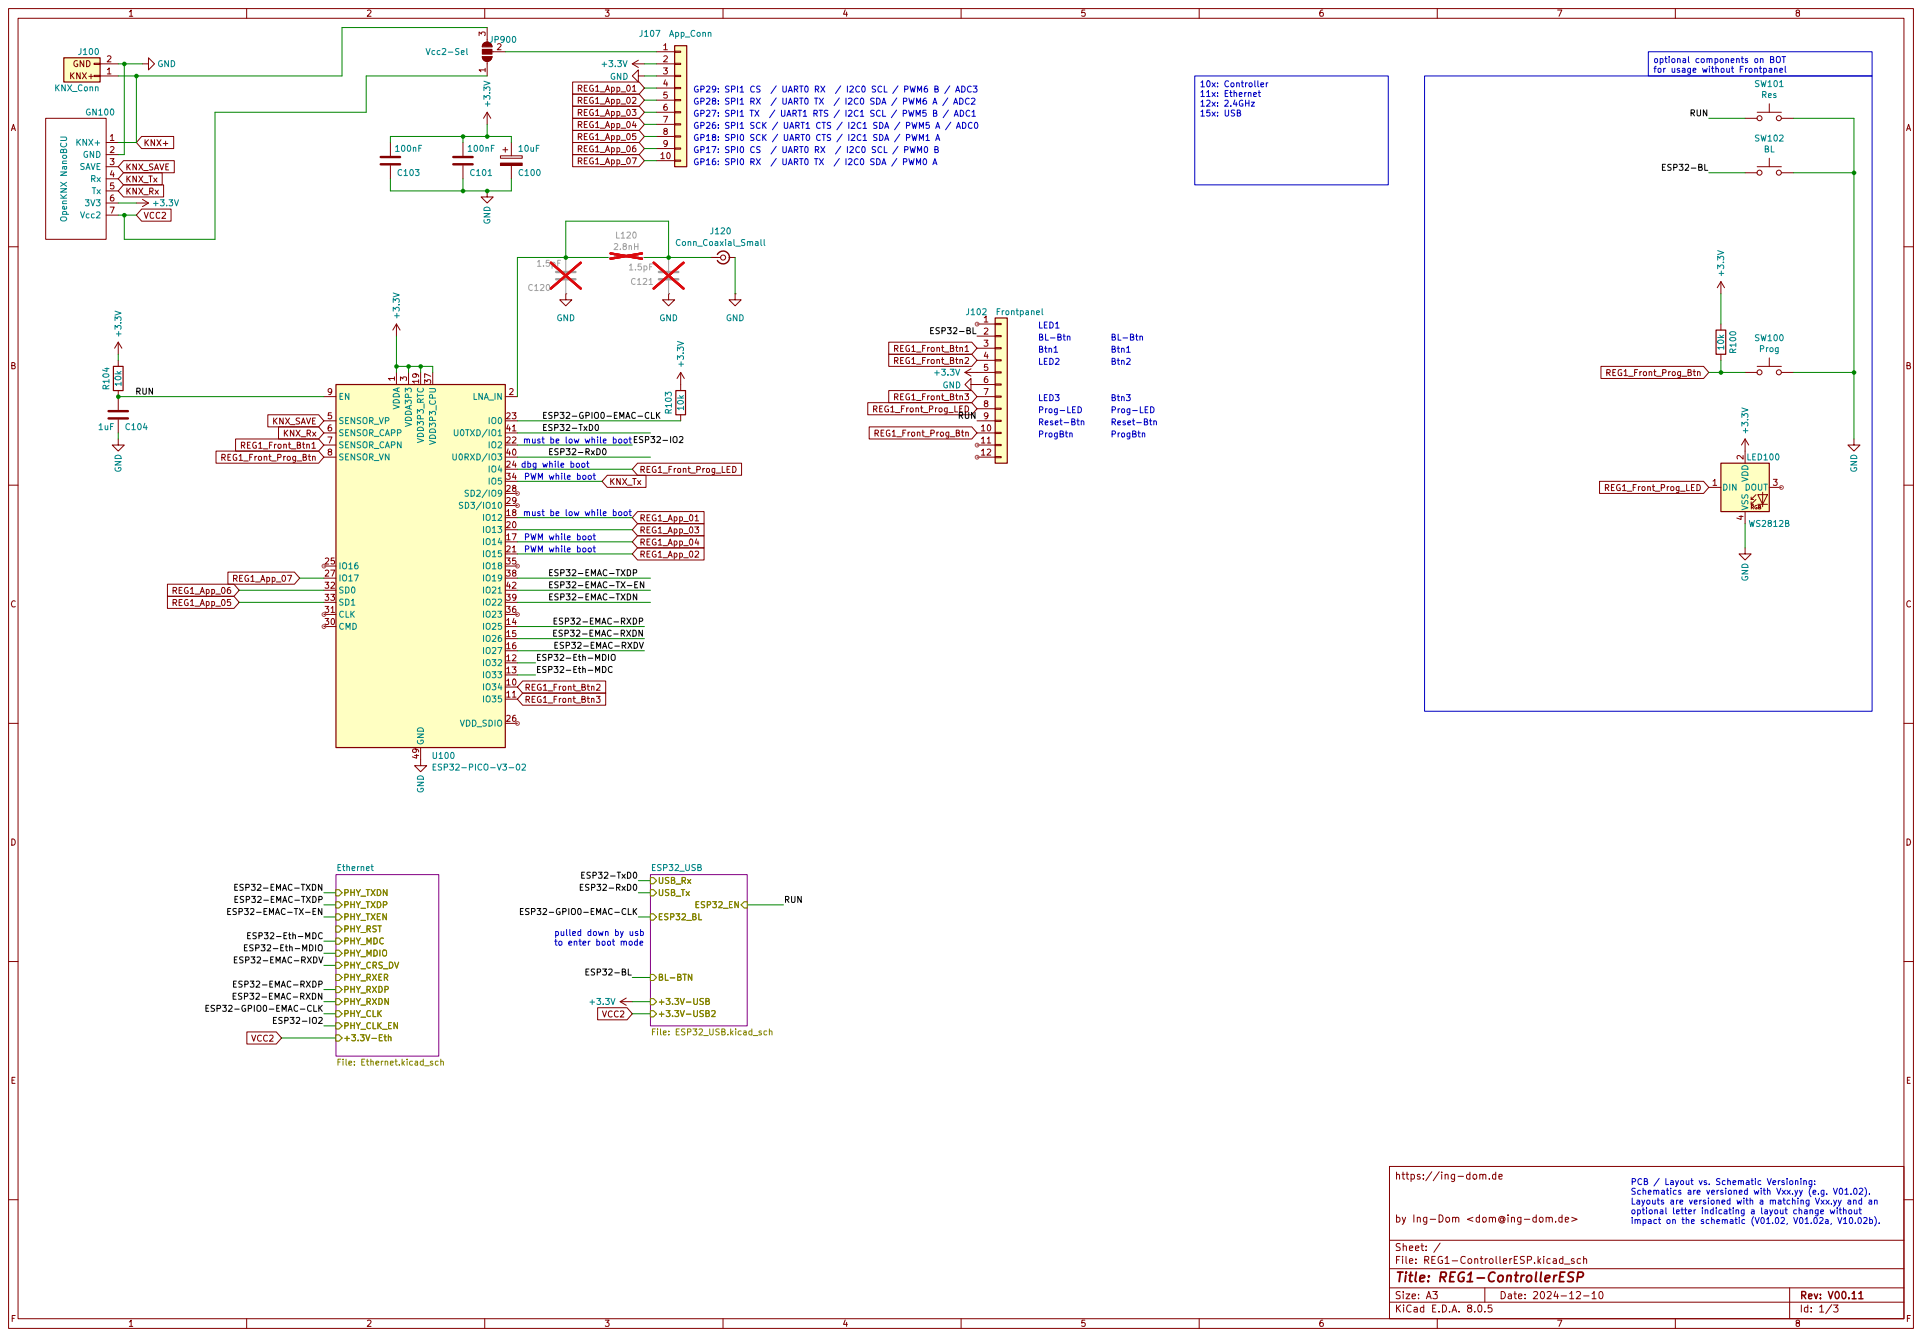
[picture p186: page 1]

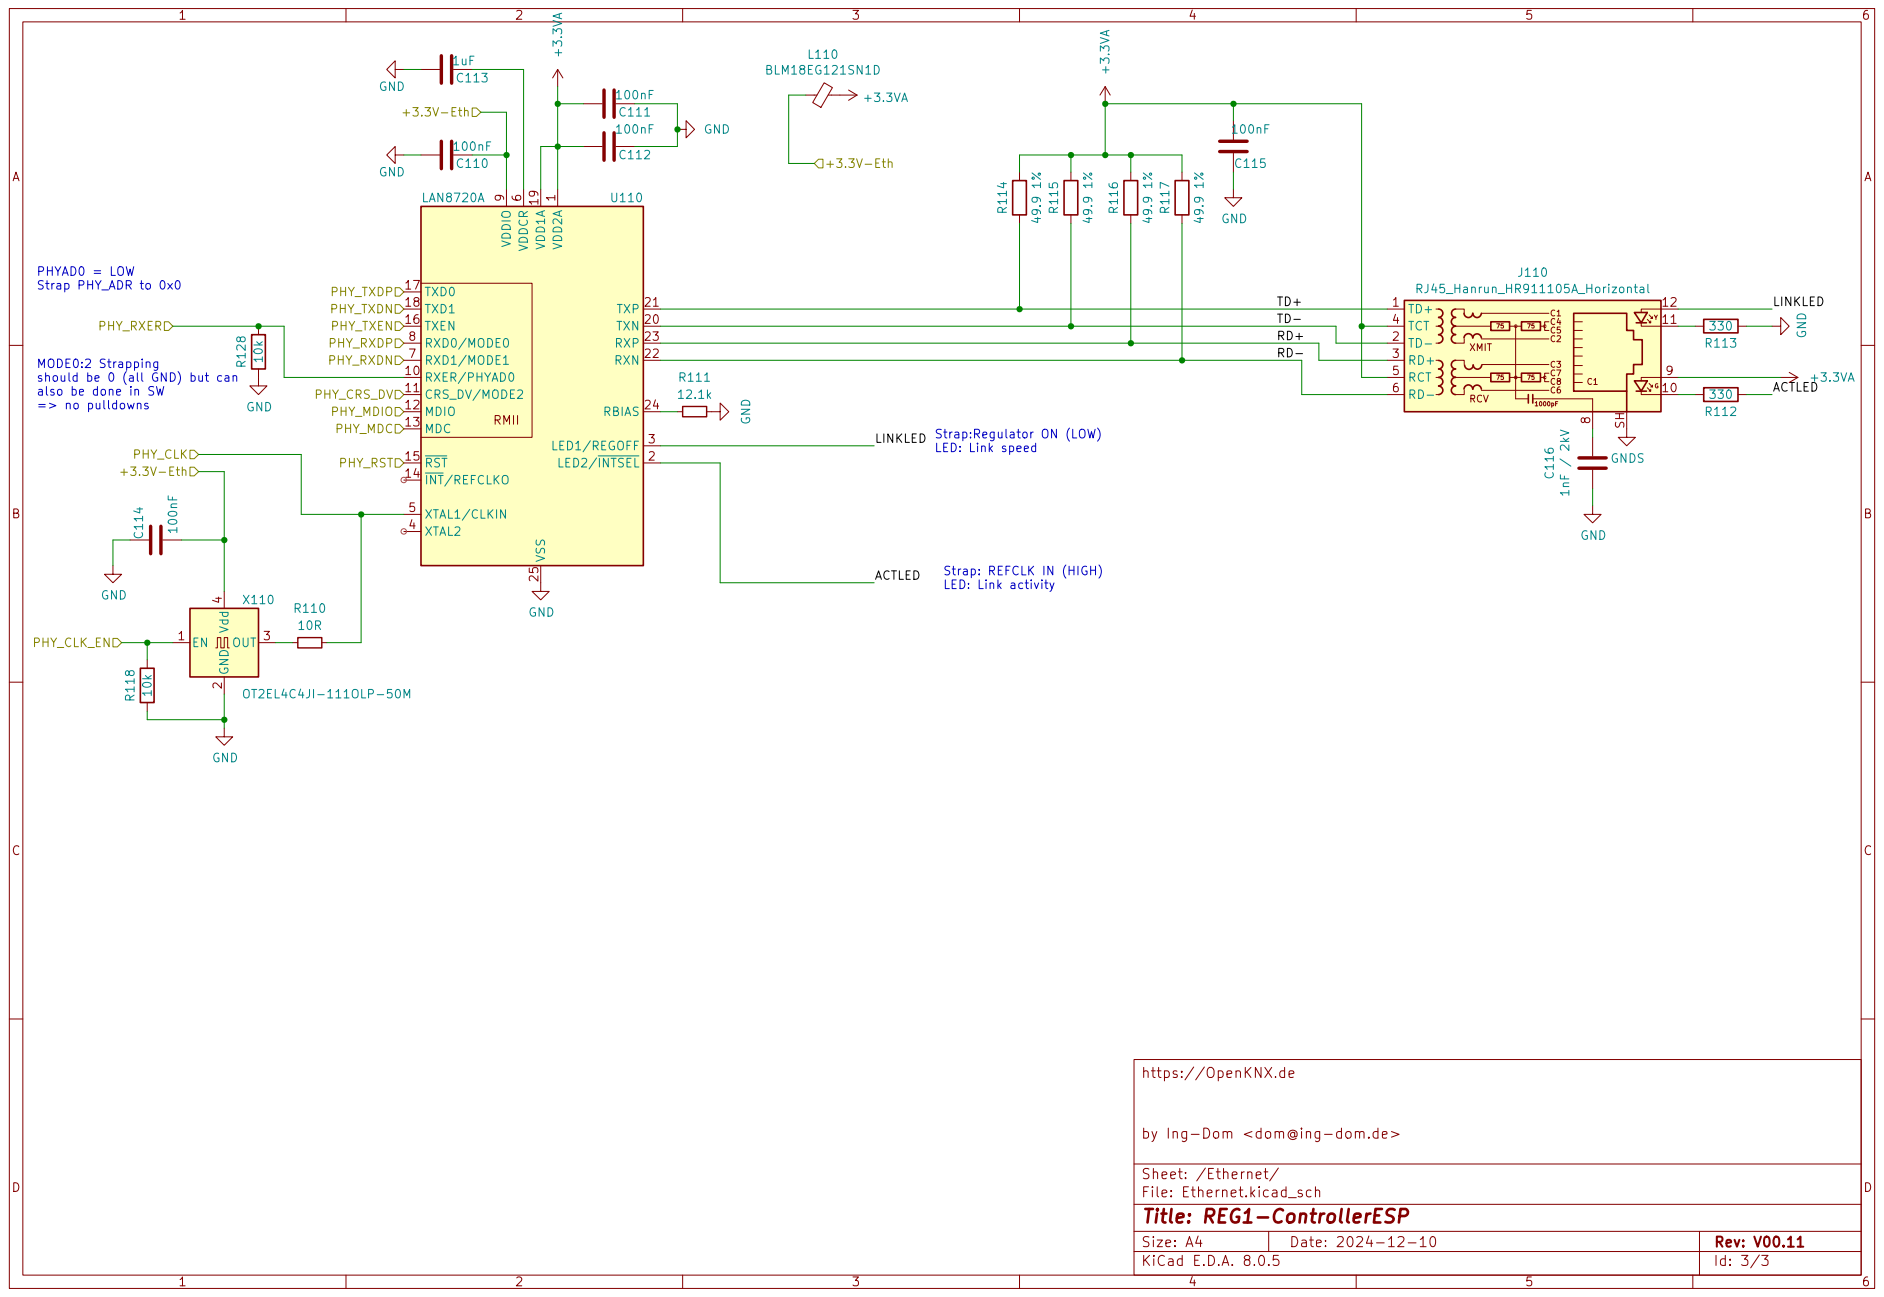
[picture p187: page 2]

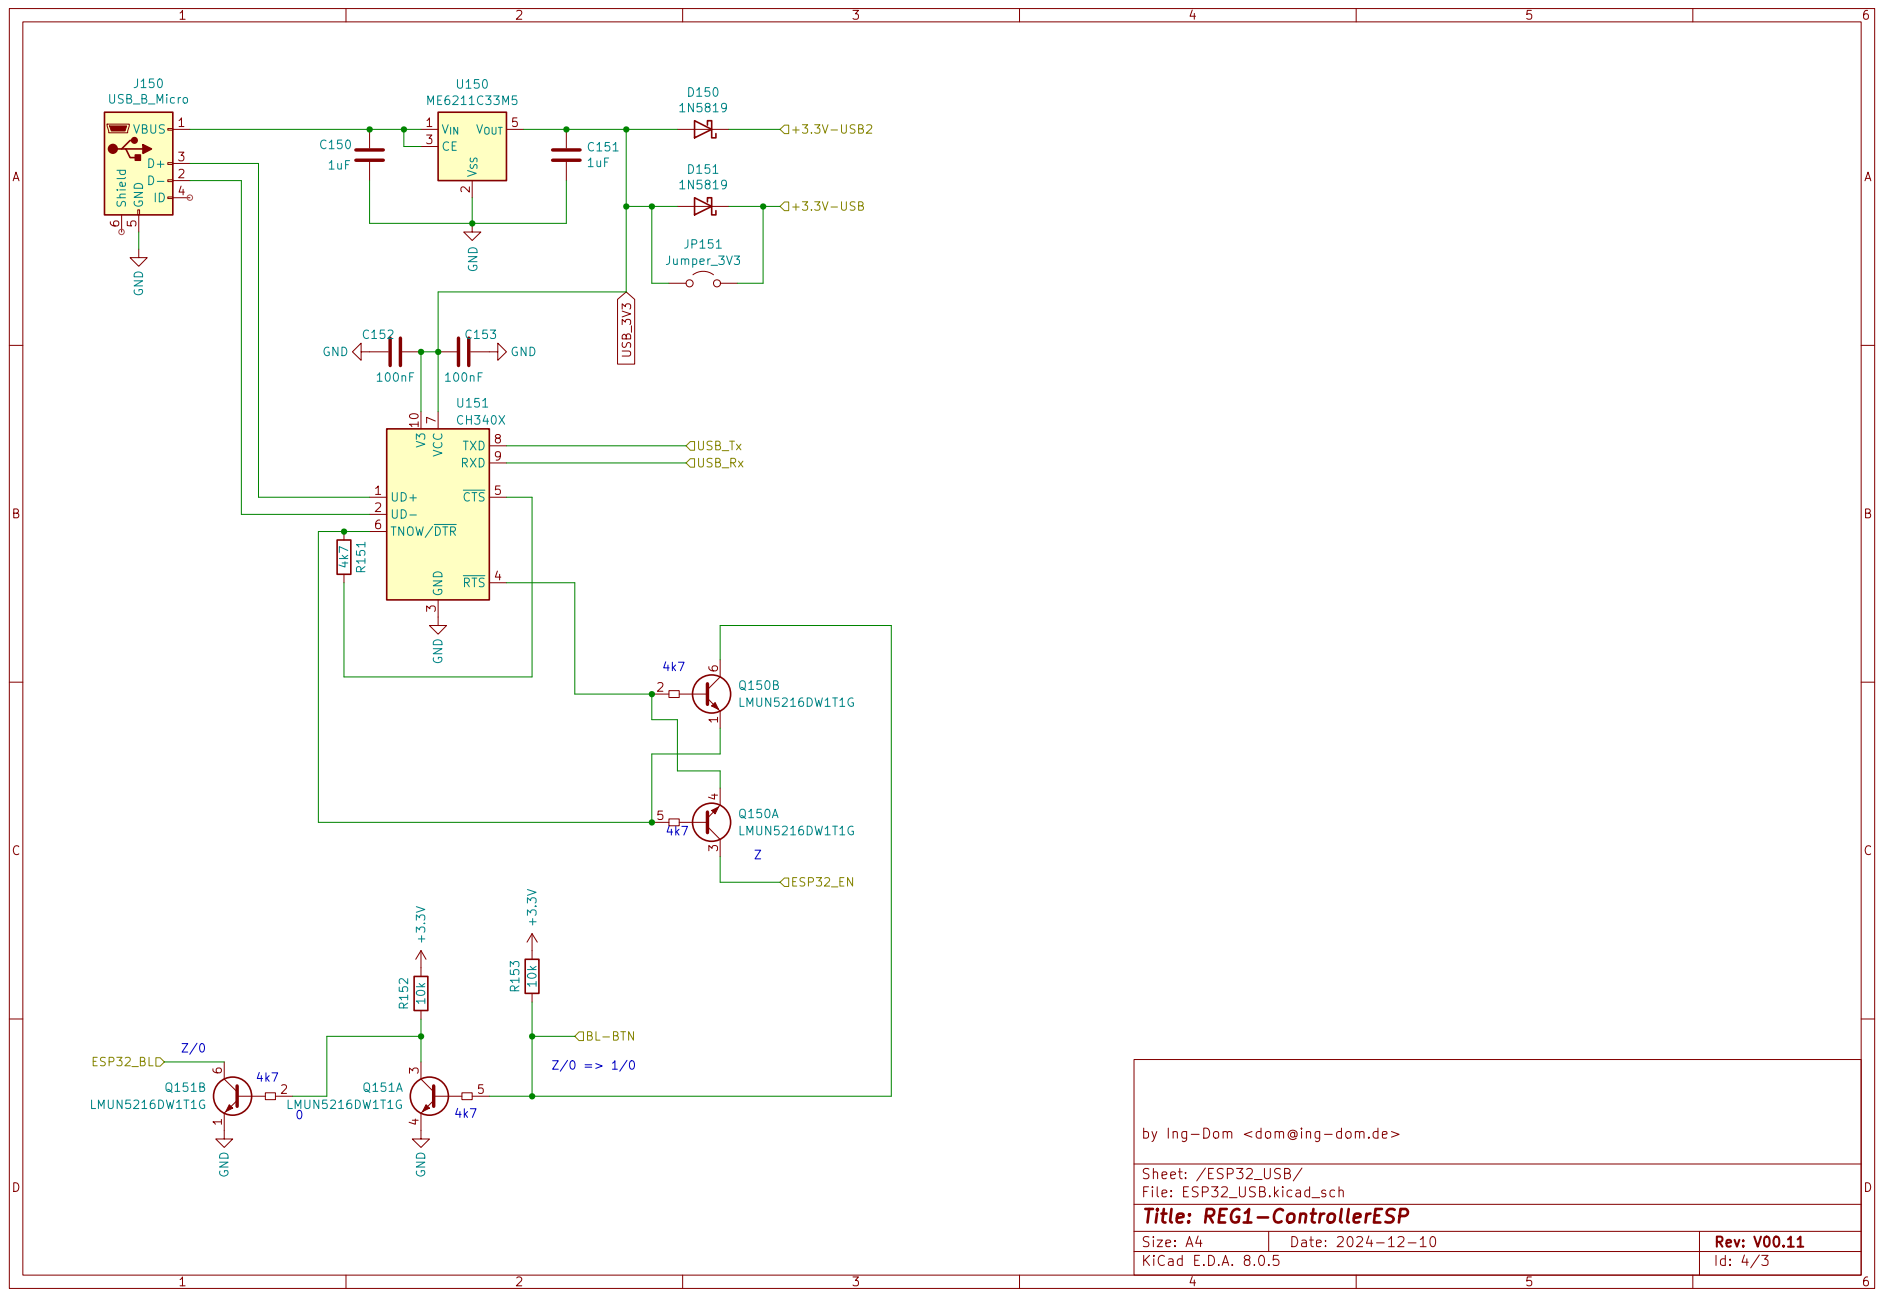
[picture p188: page 3]
