OpenKNX/OpenKNX-REG1/doc/REG1-Controller-ESP/REG1-ControllerESP_V00.12.sch.pdf

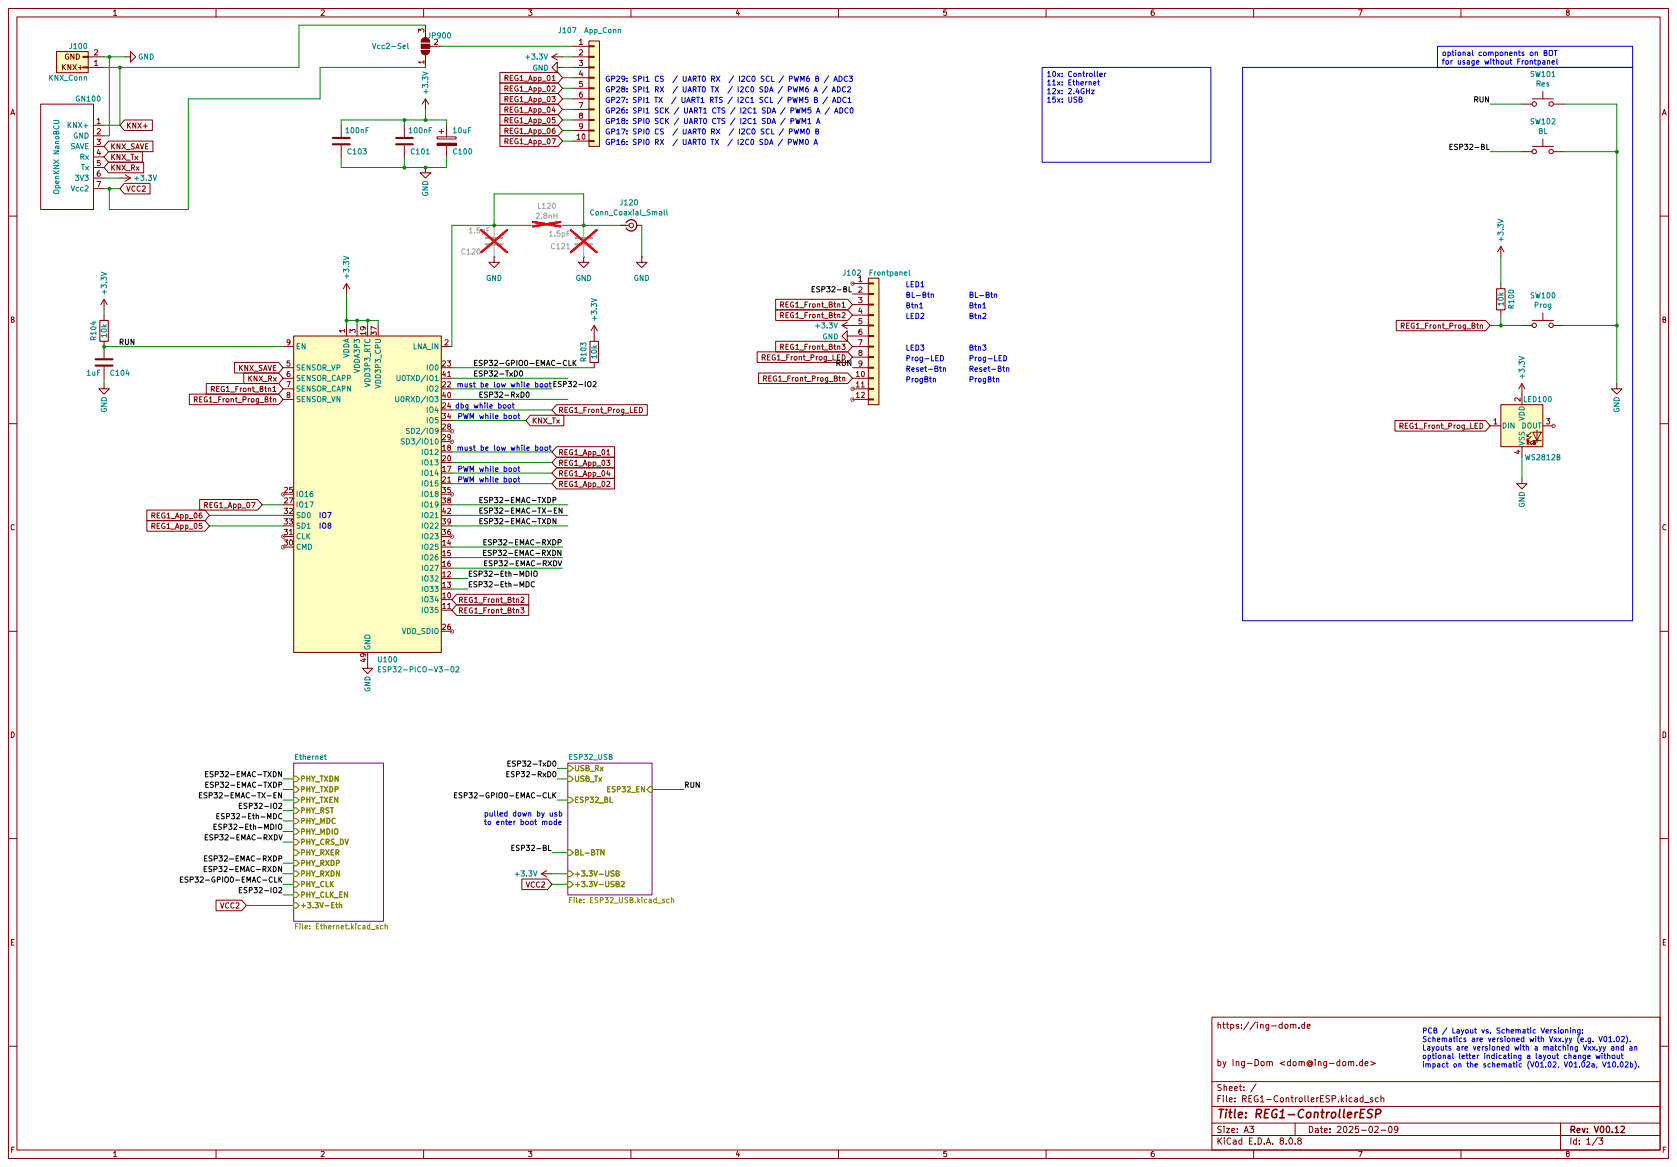
[picture p189: page 1]

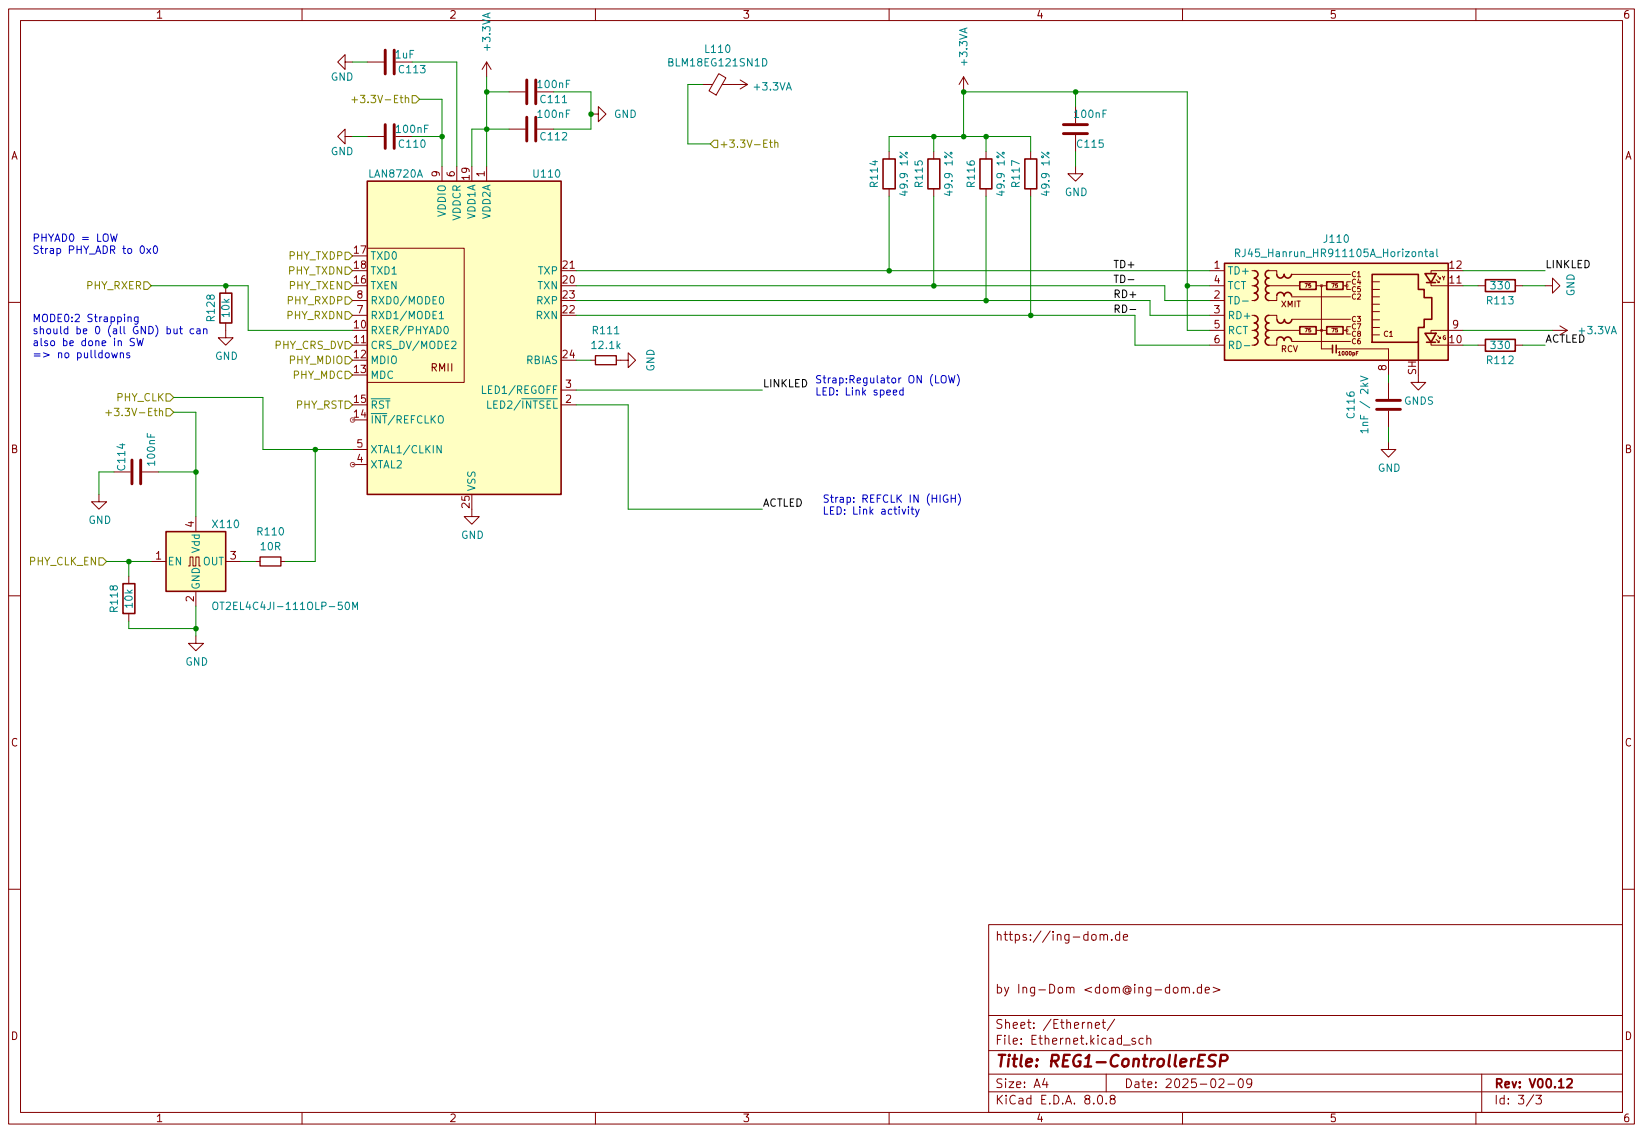
[picture p190: page 2]

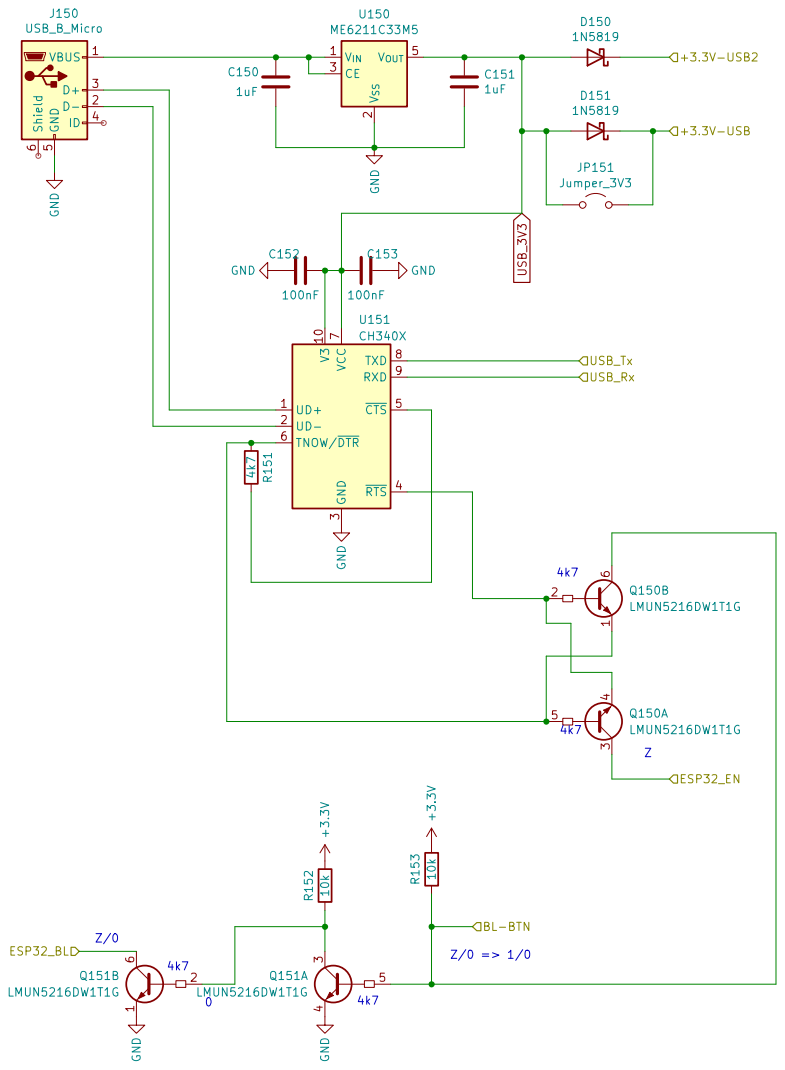
[picture p191: page 3]
