OpenKNX/OpenKNX-REG1/doc/REG1-Controller-ESP/REG1-ControllerESP_V00.20.sch.pdf

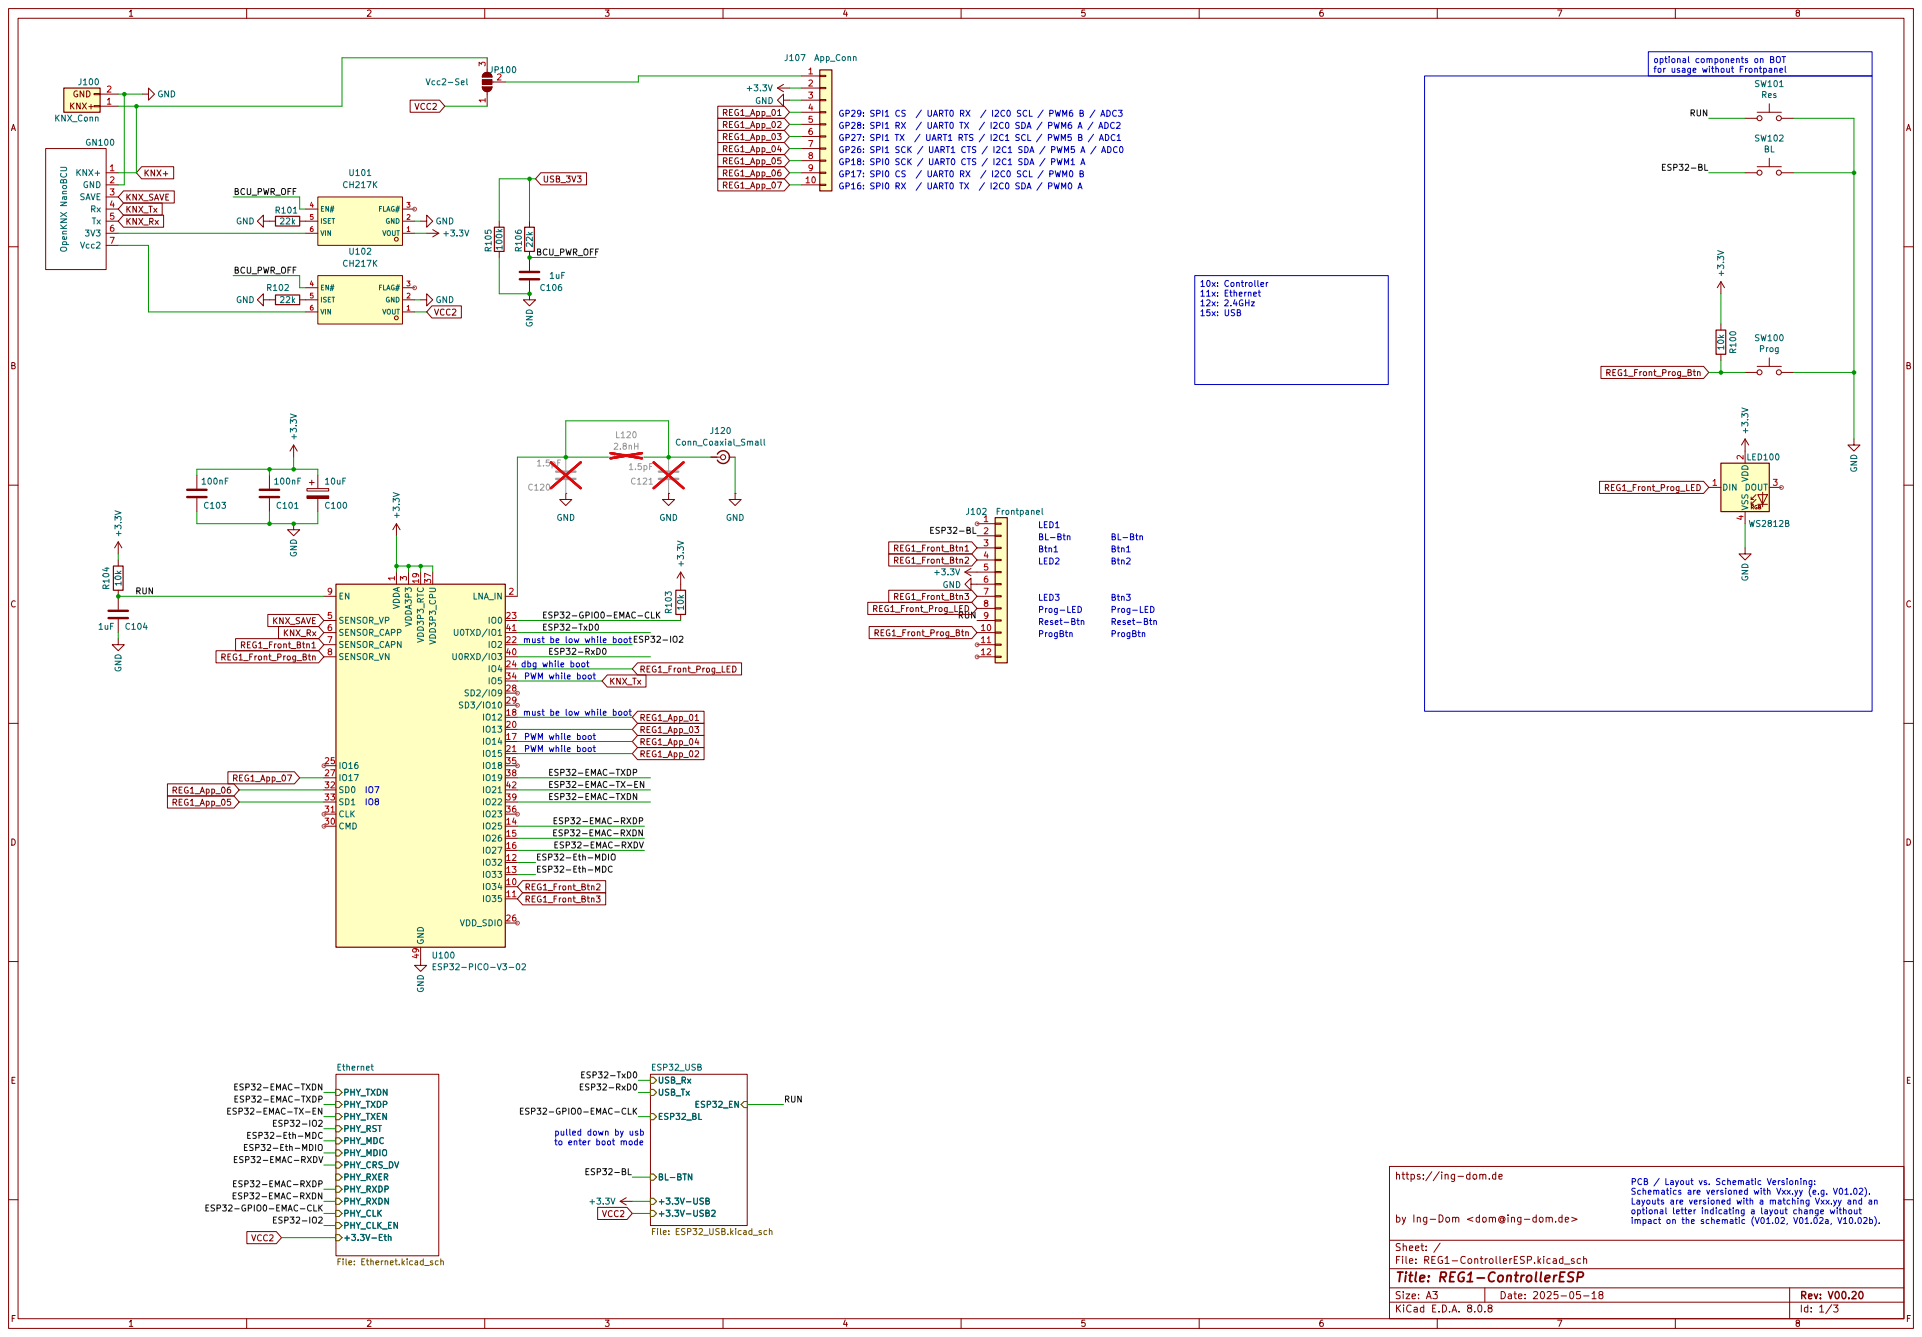
[picture p192: page 1]

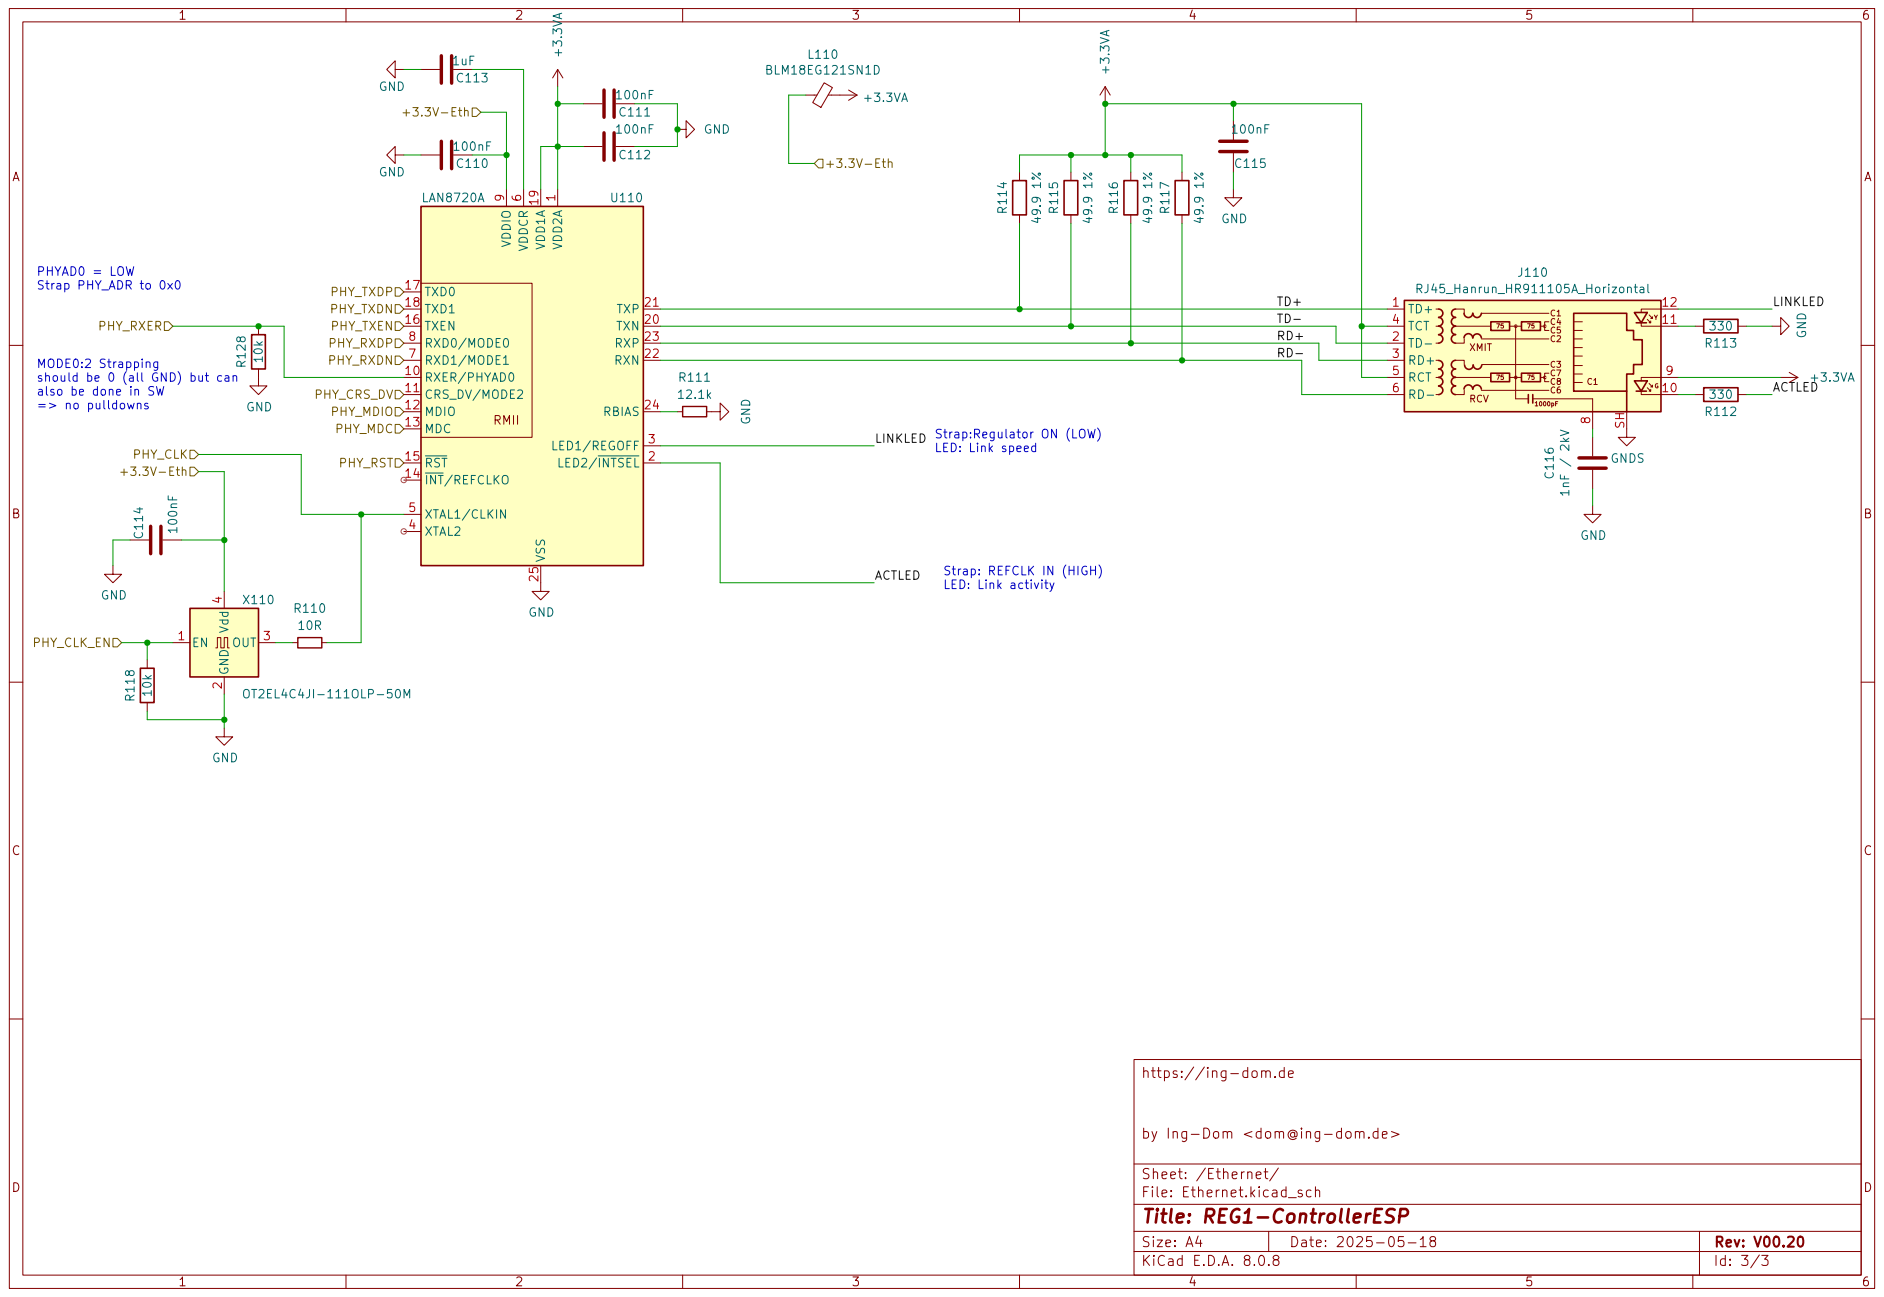
[picture p193: page 2]

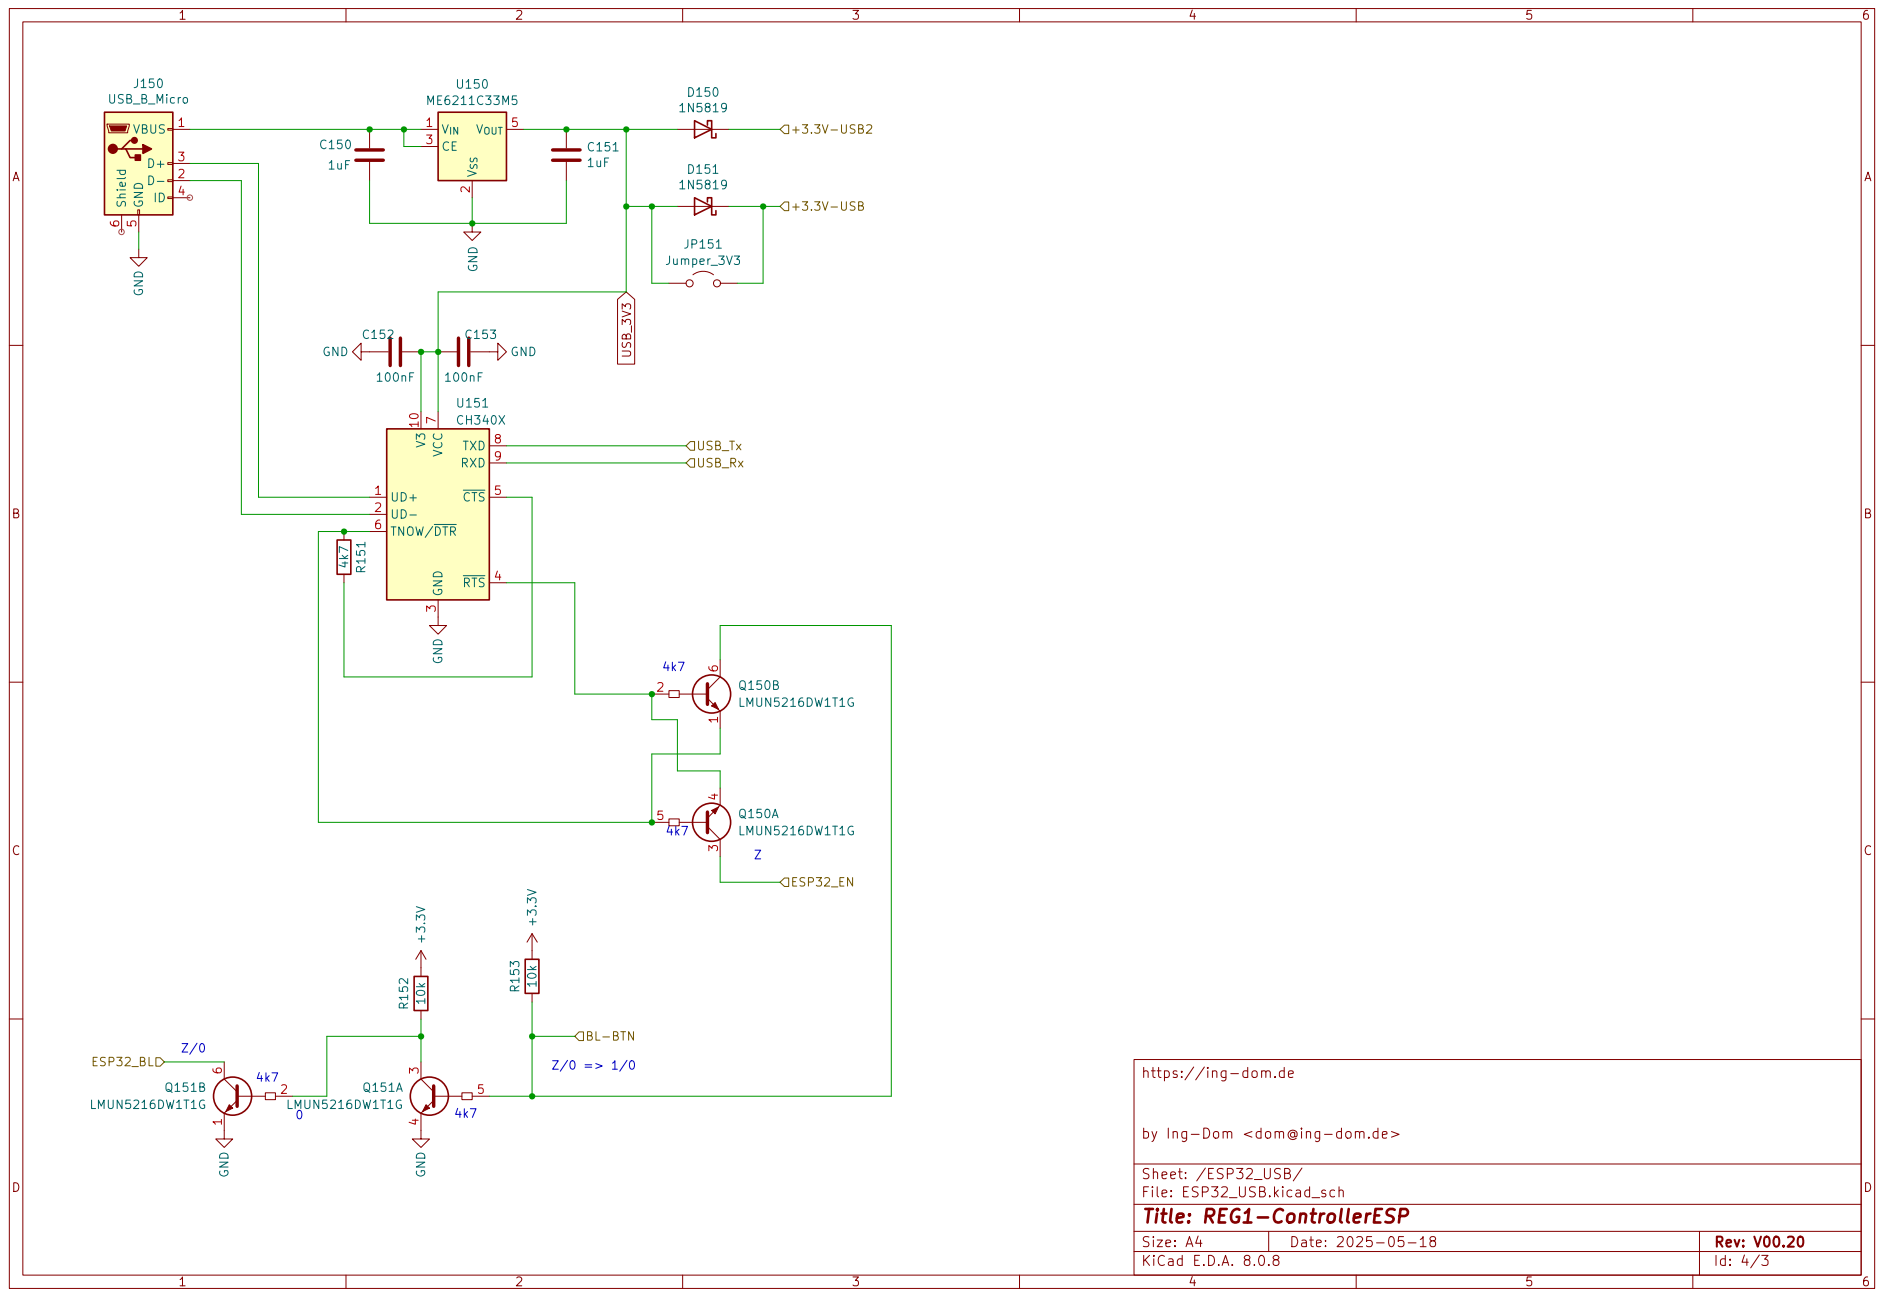
[picture p194: page 3]
