OpenKNX/OpenKNX-REG1/doc/REG1-Controller-ESP/REG1-ControllerESP_V00.21.sch.pdf

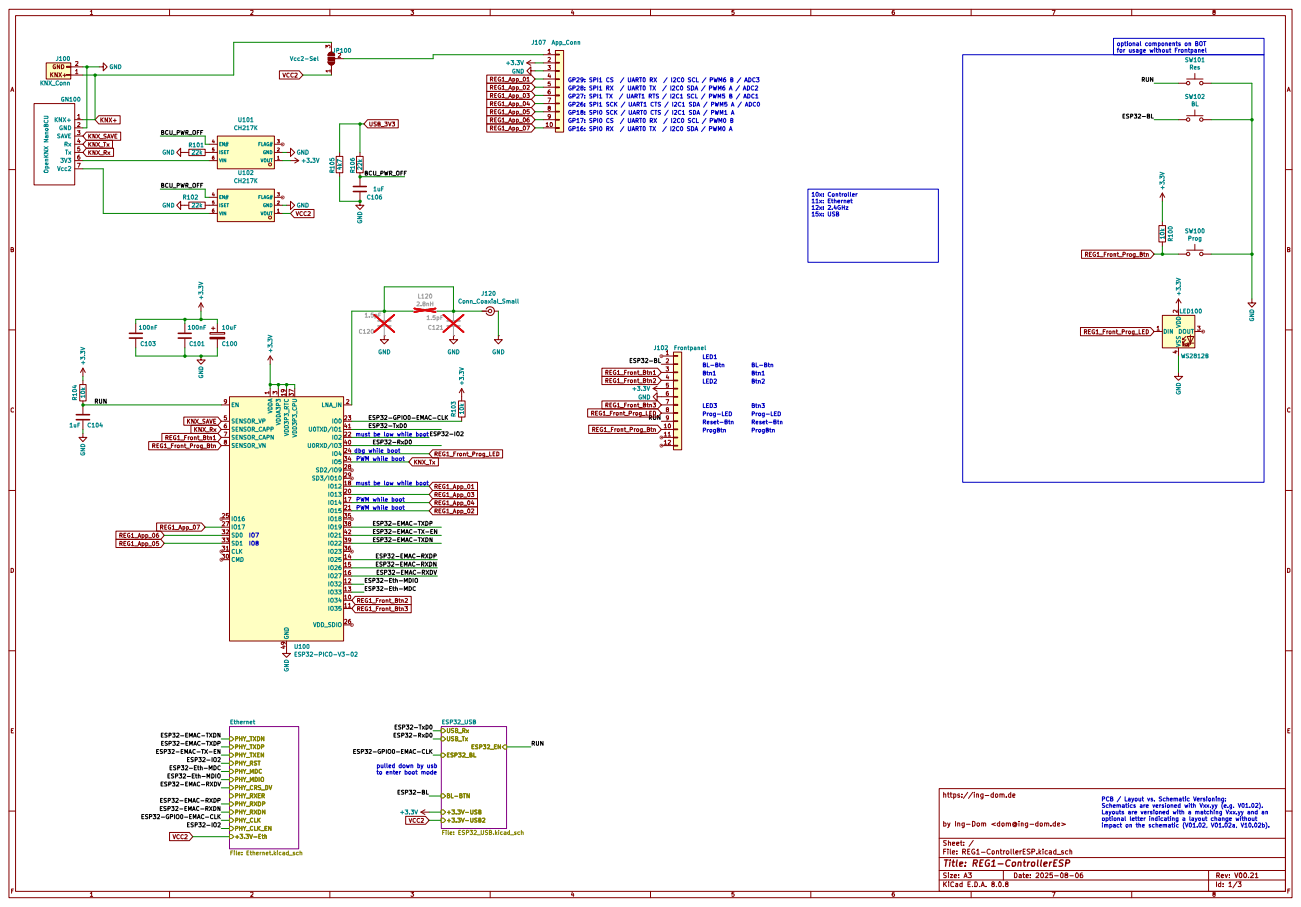
[picture p195: page 1]

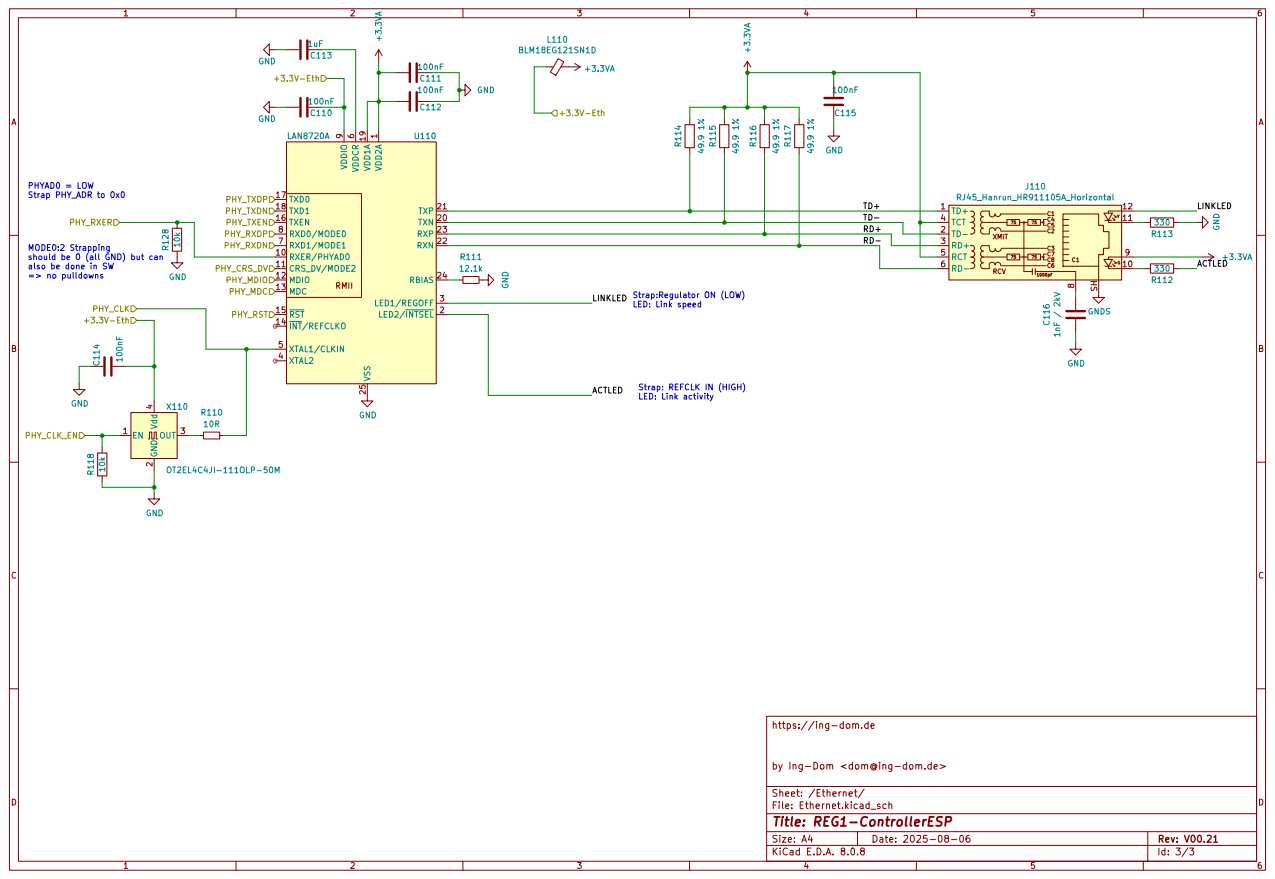
[picture p196: page 2]

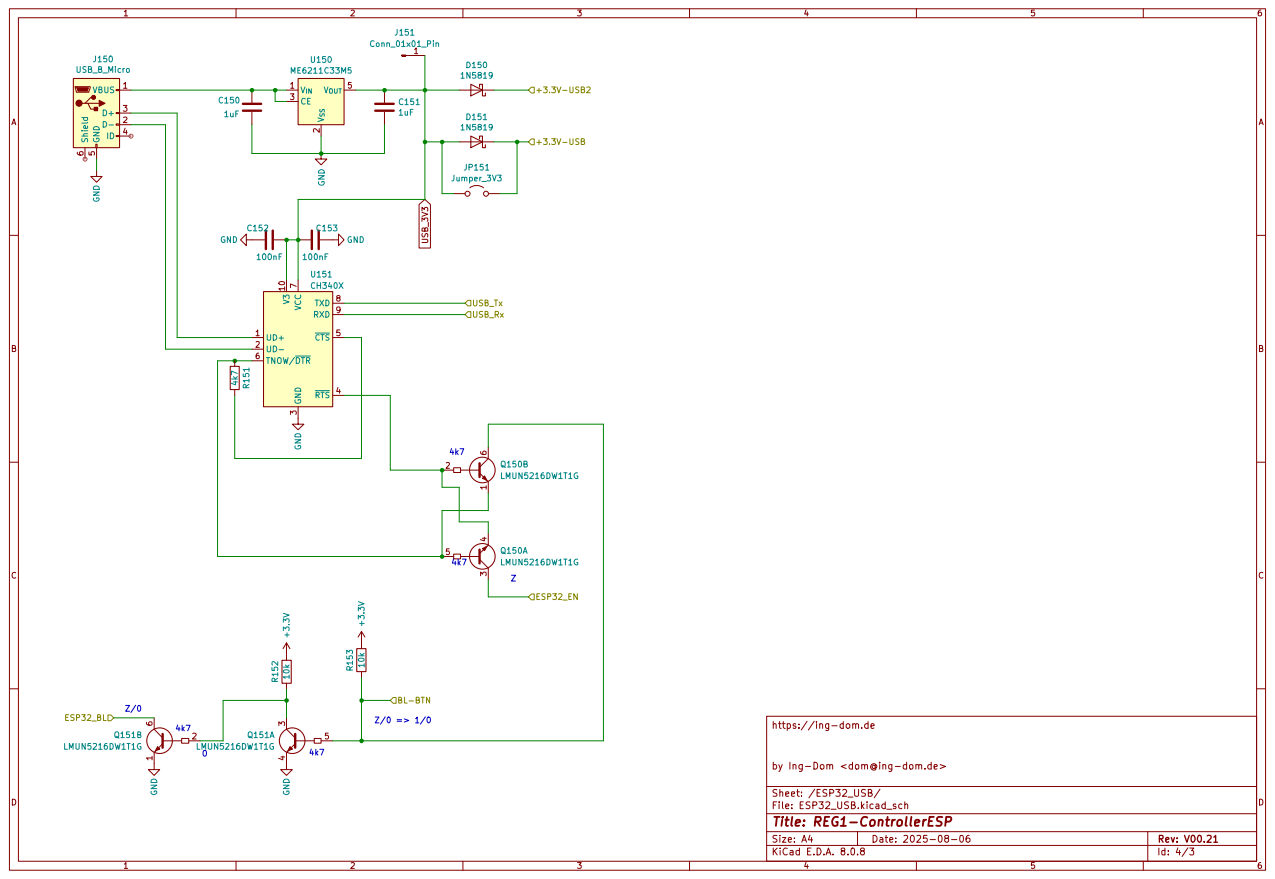
[picture p197: page 3]
