OpenKNX/OpenKNX-REG1/doc/REG1-Controller-ESP/REG1-IpTpControllerESP-Devboard_V00.02.sch.pdf

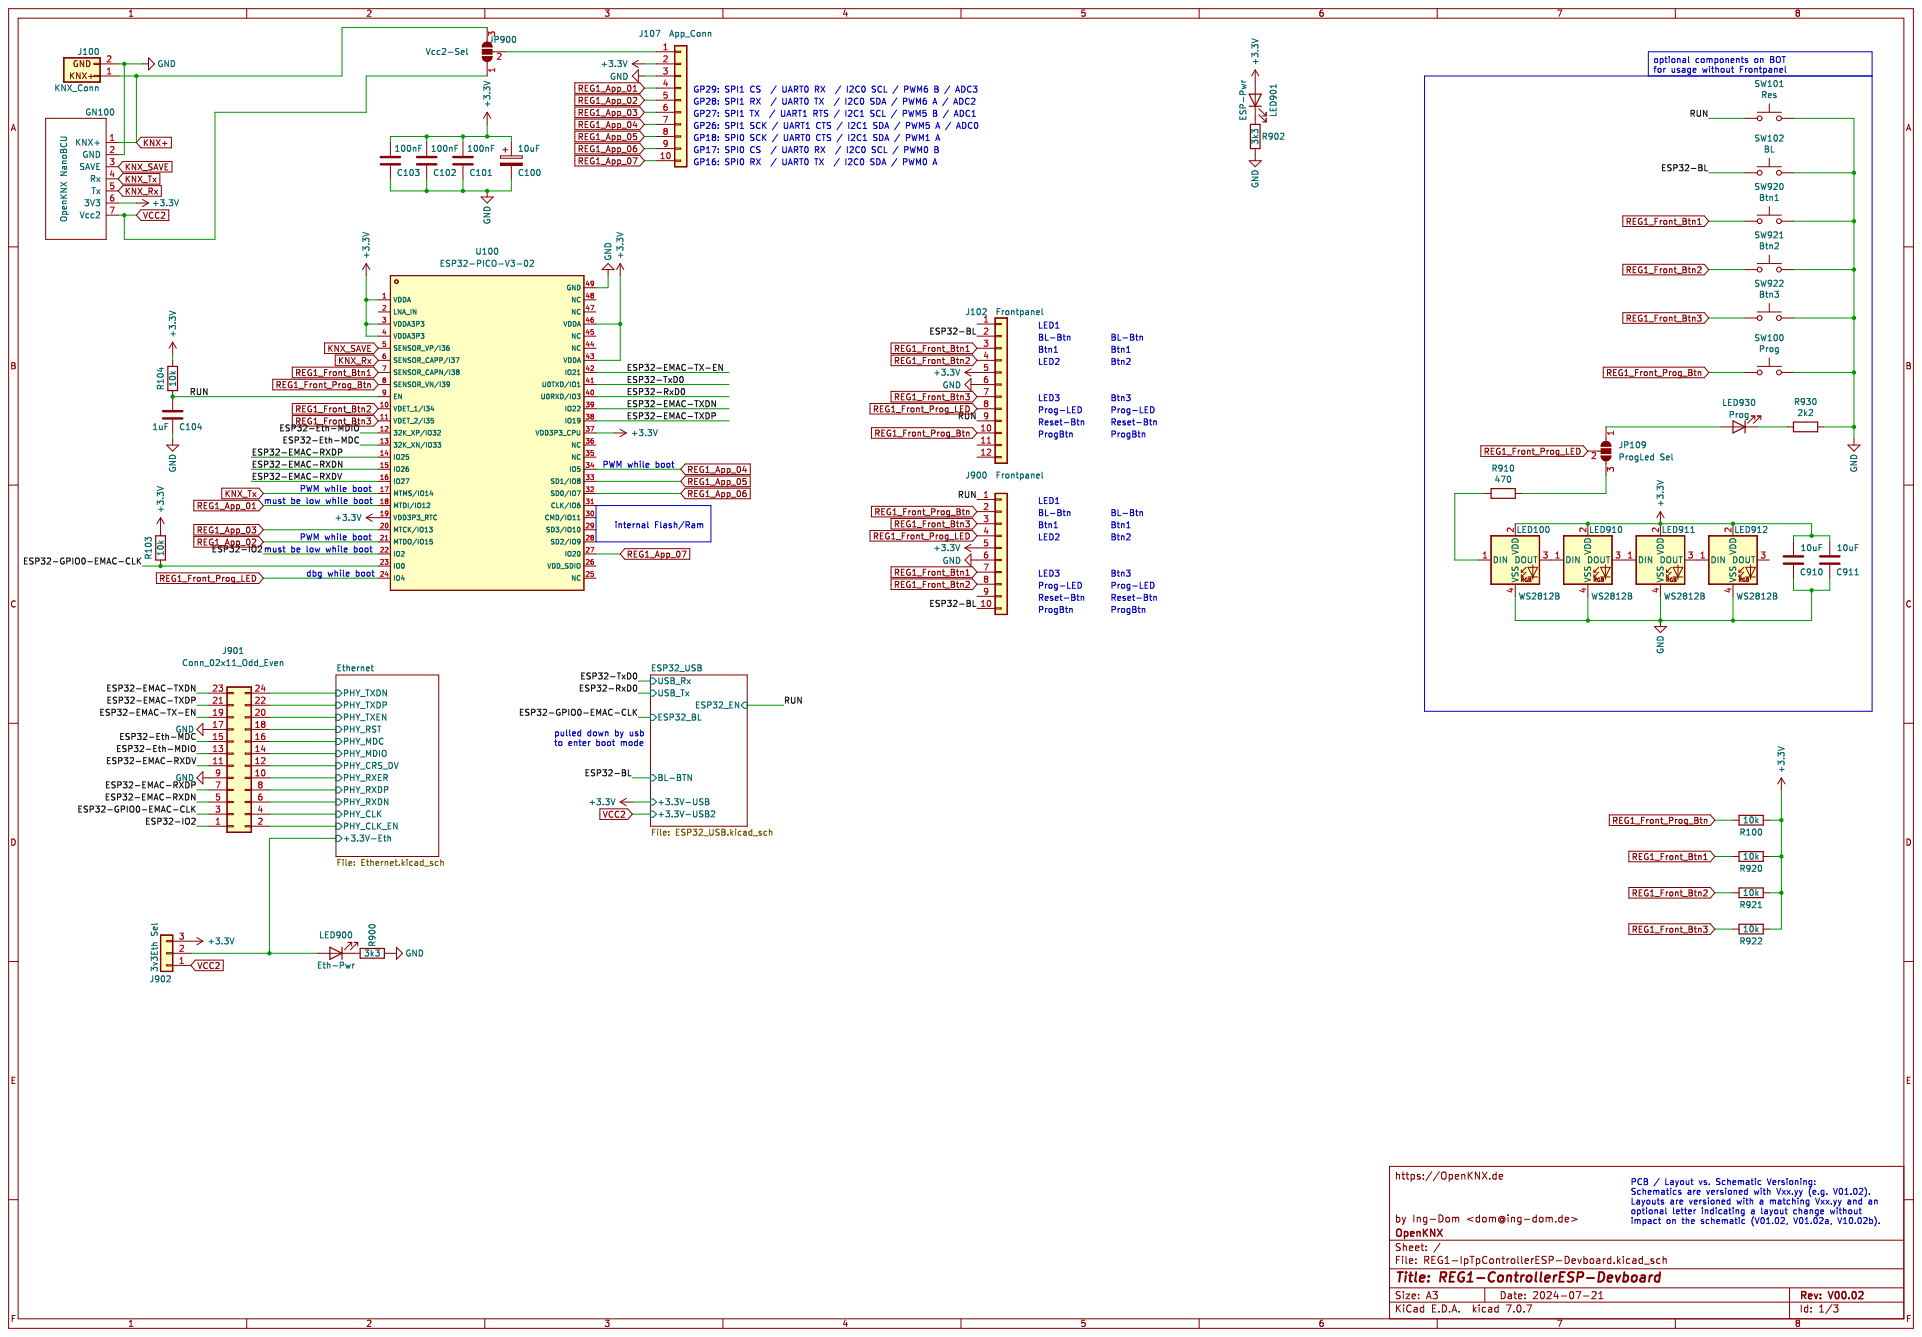
[picture p198: page 1]

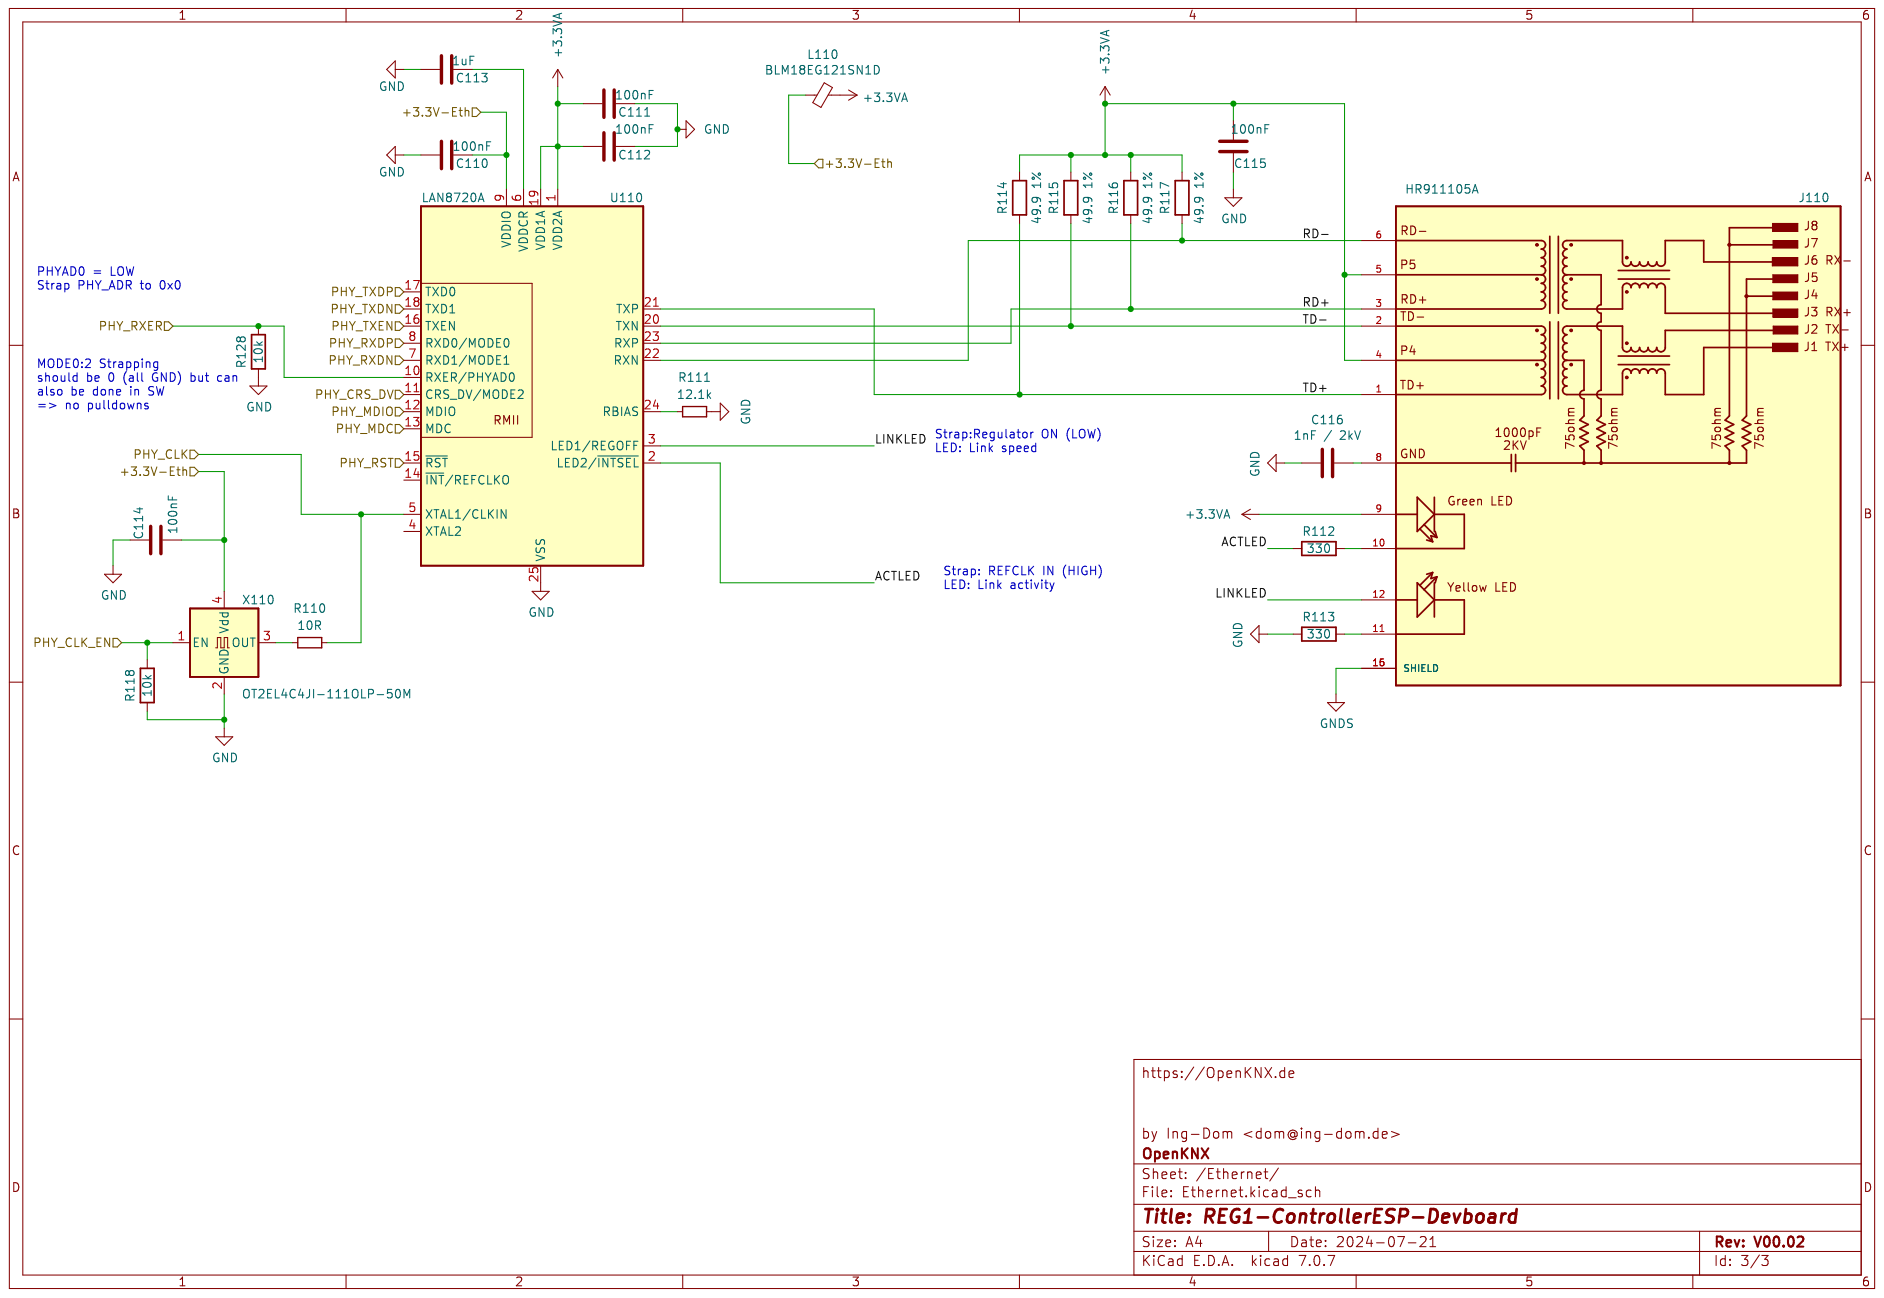
[picture p199: page 2]

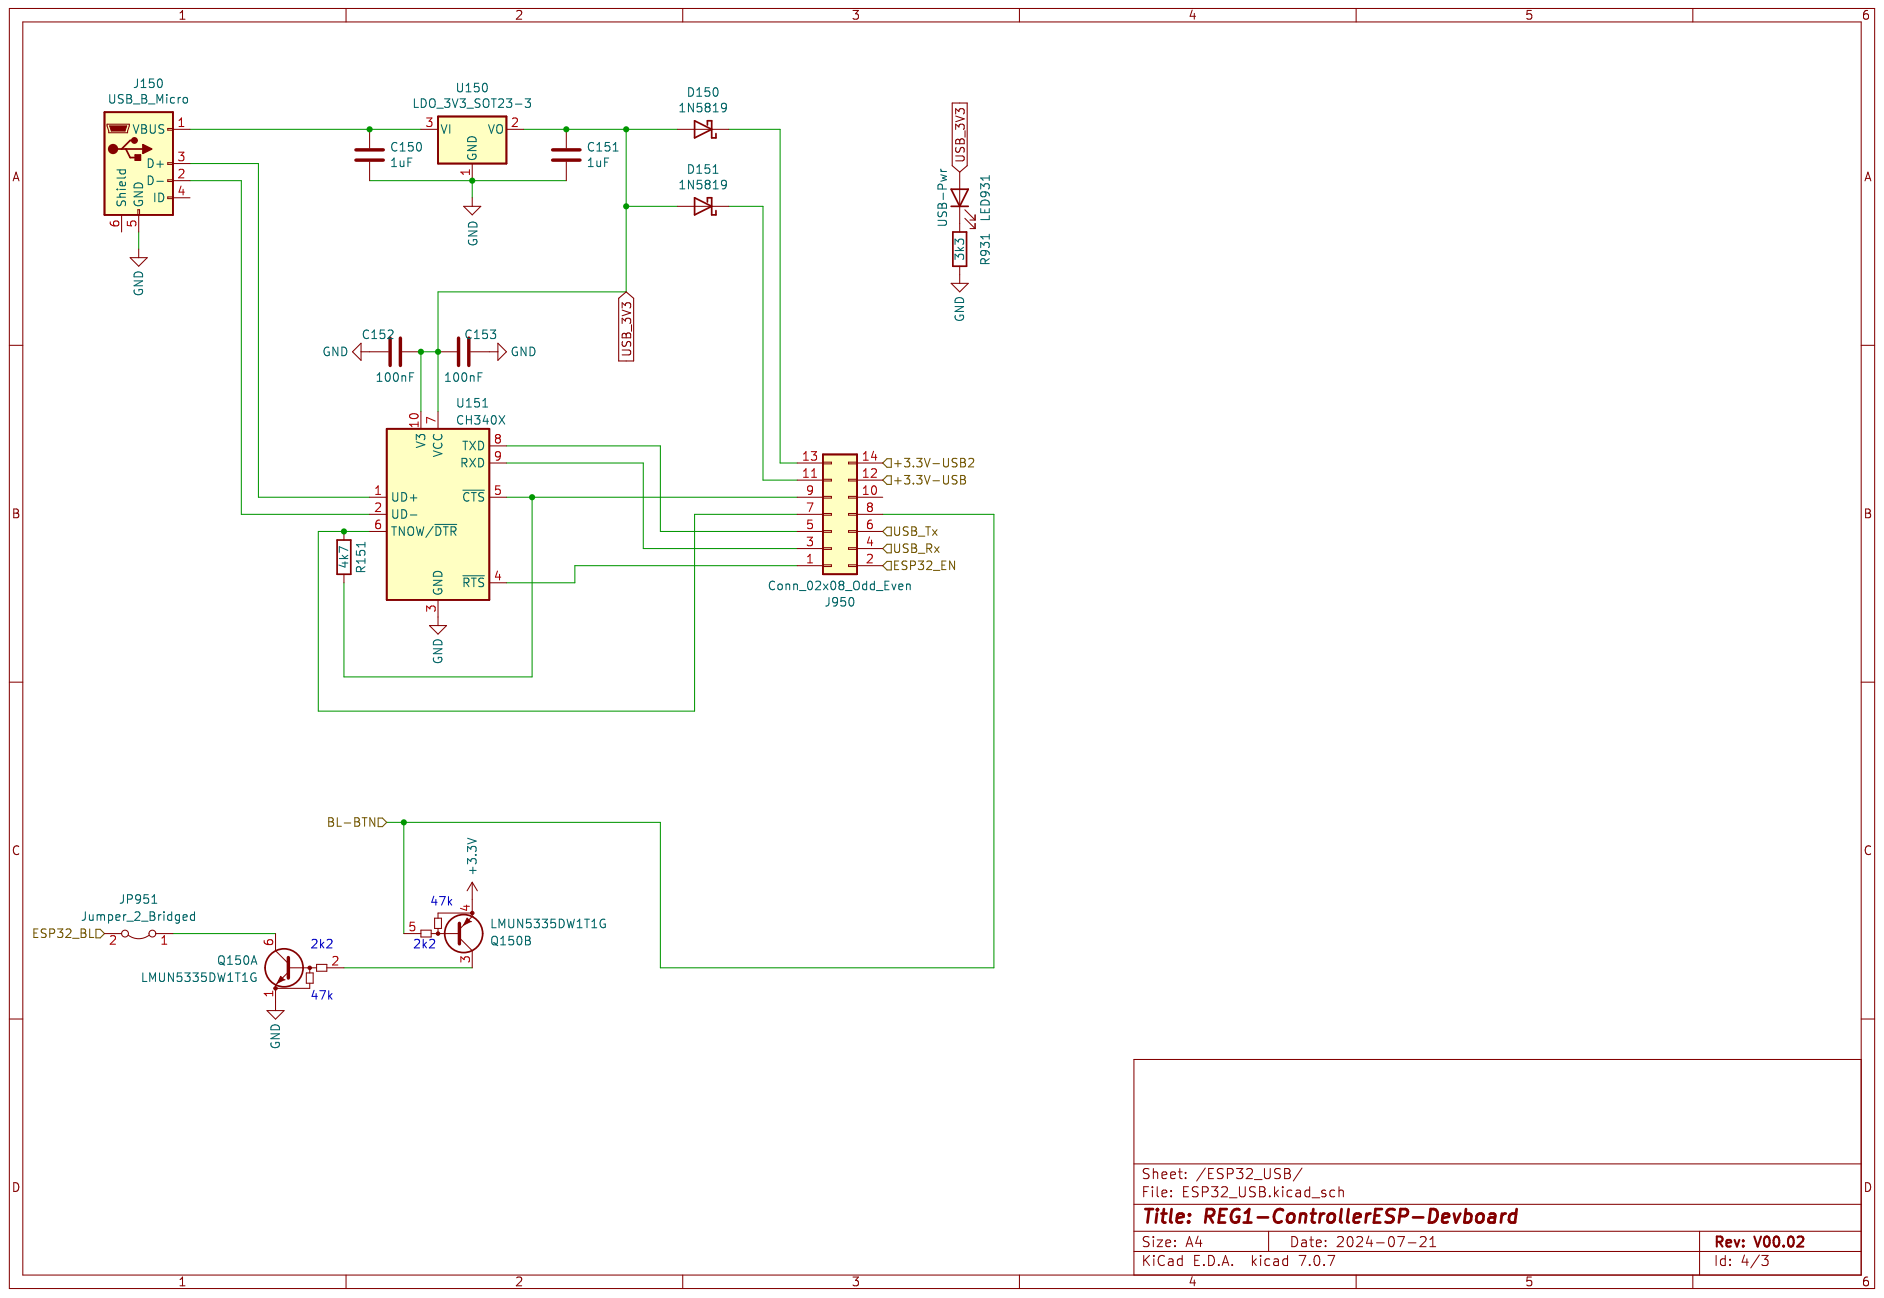
[picture p200: page 3]
