OpenKNX/OpenKNX-REG1/hardware/EDA-Files/REG1-App-SEN-Multi/REG1-App-SEN-Multi.kicad_pcb

## KiCad design hardware/EDA-Files/REG1-App-SEN-Multi/REG1-App-SEN-Multi.kicad_pcb (2026-05-01)

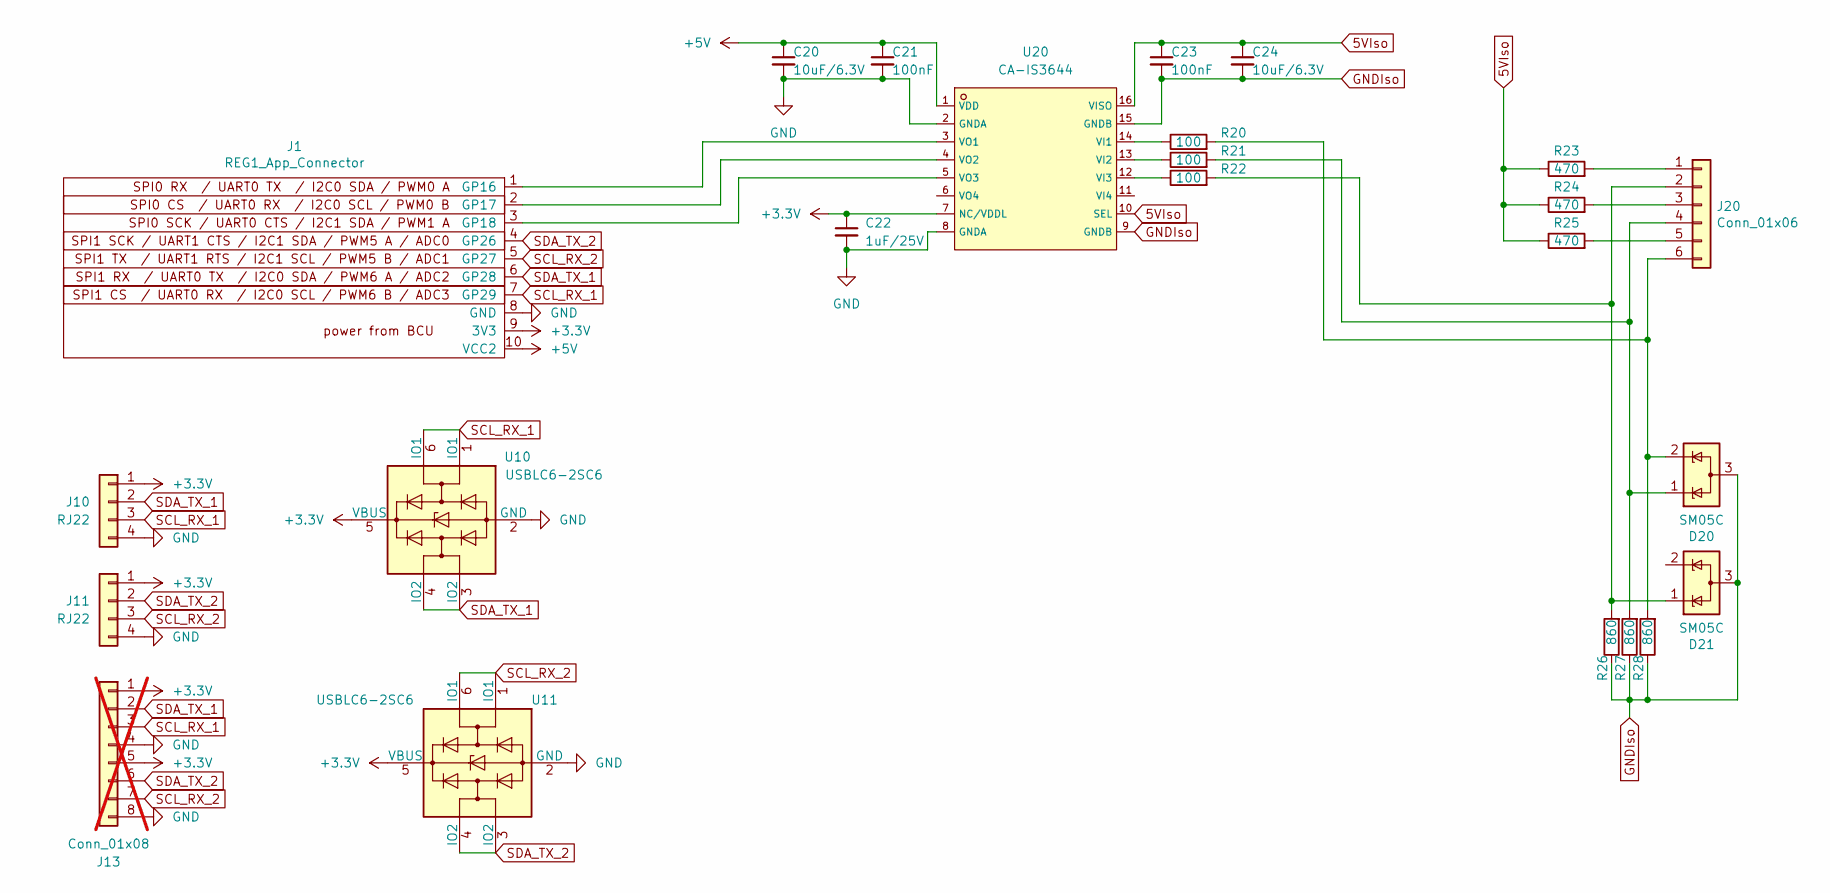
[picture p201: schematic REG1-App-SEN-Multi.kicad_sch]

Parts:
C20, C24: 10uF/6.3V; C_0402_1005Metric
C21, C23: 100nF; C_0402_1005Metric
C22: 1uF/25V; C_0402_1005Metric
D20, D21: SM05C; SOT-23
J1: REG1_App_Connector; PinHeader_1x10_P2.54mm_Horizontal
J10, J11: RJ22
J13: Conn_01x08; CONN-TH_8P-P2.54_DIBO_DB2ERC-2.54-8P-GN; not fitted
J20: Conn_01x06; PhoenixContact_MC_1,5_6-G-3.5_1x06_P3.50mm_Horizontal
R20, R21, R22: 100; R_0603_1608Metric
R23, R24, R25: 470; R_0603_1608Metric
R26, R27, R28: 860; R_0603_1608Metric
U10, U11: USBLC6-2SC6; SOT-23-6
U20: CA-IS3644; WSOIC-16_L10.3-W7.5-P1.27-LS10.3-BL

Connections:
5VIso: C23.1, C24.1, R23.1, R24.1, R25.1, U20.10 (SEL), U20.16 (VISO)
+3.3V: C22.1, J1.9 (3V3), J10.1, J11.1, J13.1, J13.5, U10.5 (VBUS), U11.5 (VBUS), U20.7 (NC/VDDL)
+5V: C20.1, C21.1, J1.10 (VCC2), U20.1 (VDD)
GND: C20.2, C21.2, C22.2, J1.8 (GND), J10.4, J11.4, J13.4, J13.8, U10.2 (GND), U11.2 (GND), U20.2 (GNDA), U20.8 (GNDA)
GNDIso: C23.2, C24.2, D20.3 (A), D21.3 (A), R26.1, R27.1, R28.1, U20.9 (GNDB), U20.15 (GNDB)
unnamed: J1.1 (GP16), U20.3 (VO1)
unnamed: J1.2 (GP17), U20.4 (VO2)
unnamed: J1.3 (GP18), U20.5 (VO3)
unnamed: J20.1, R23.2
unnamed: D21.1 (K), J20.2, R22.2, R26.2
unnamed: J20.3, R24.2
unnamed: D20.1 (K), J20.4, R21.2, R27.2
unnamed: J20.5, R25.2
unnamed: D20.2 (K), J20.6, R20.2, R28.2
unnamed: R20.1, U20.14 (VI1)
unnamed: R21.1, U20.13 (VI2)
unnamed: R22.1, U20.12 (VI3)
SCL_RX_1: J1.7 (GP29), J10.3, J13.3, U10.1 (IO1), U10.6 (IO1)
SCL_RX_2: J1.5 (GP27), J11.3, J13.7, U11.1 (IO1), U11.6 (IO1)
SDA_TX_1: J1.6 (GP28), J10.2, J13.2, U10.3 (IO2), U10.4 (IO2)
SDA_TX_2: J1.4 (GP26), J11.2, J13.6, U11.3 (IO2), U11.4 (IO2)

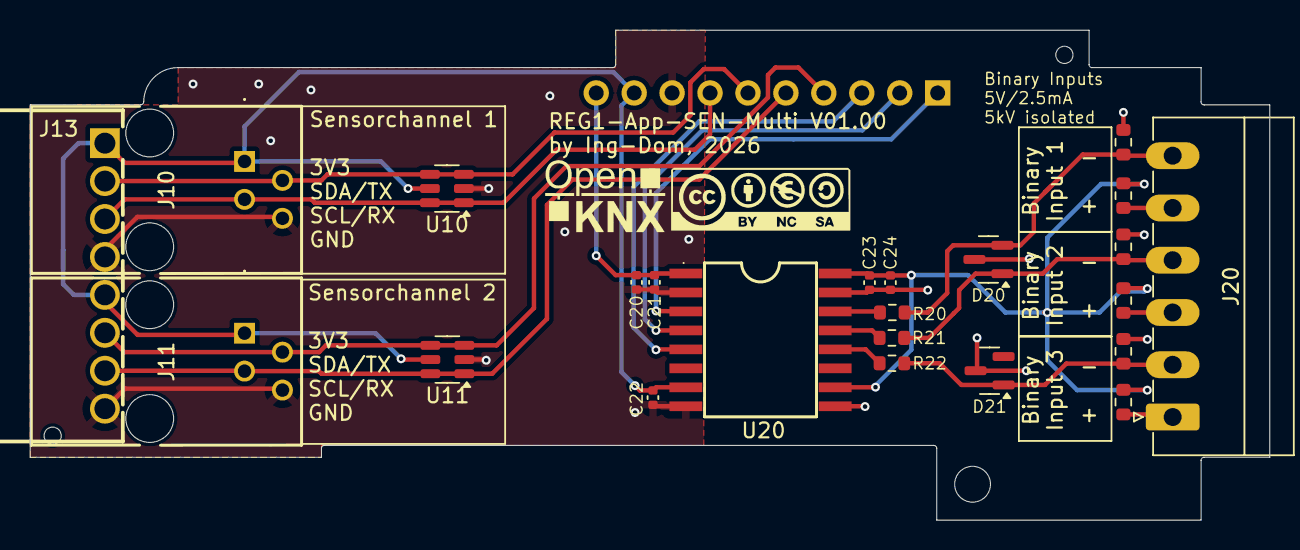
[picture p202: board REG1-App-SEN-Multi.kicad_pcb from above]

Board: 2 copper layers, 83.0 x 32.8 mm, 24 parts (1 on the bottom side), 21 nets.
