OpenKNX/OpenKNX-REG1/hardware/EDA-Files/REG1-Front-RGB/REG1-Front-RGB.kicad_pcb

## KiCad design hardware/EDA-Files/REG1-Front-RGB/REG1-Front-RGB.kicad_pcb (2026-04-14)

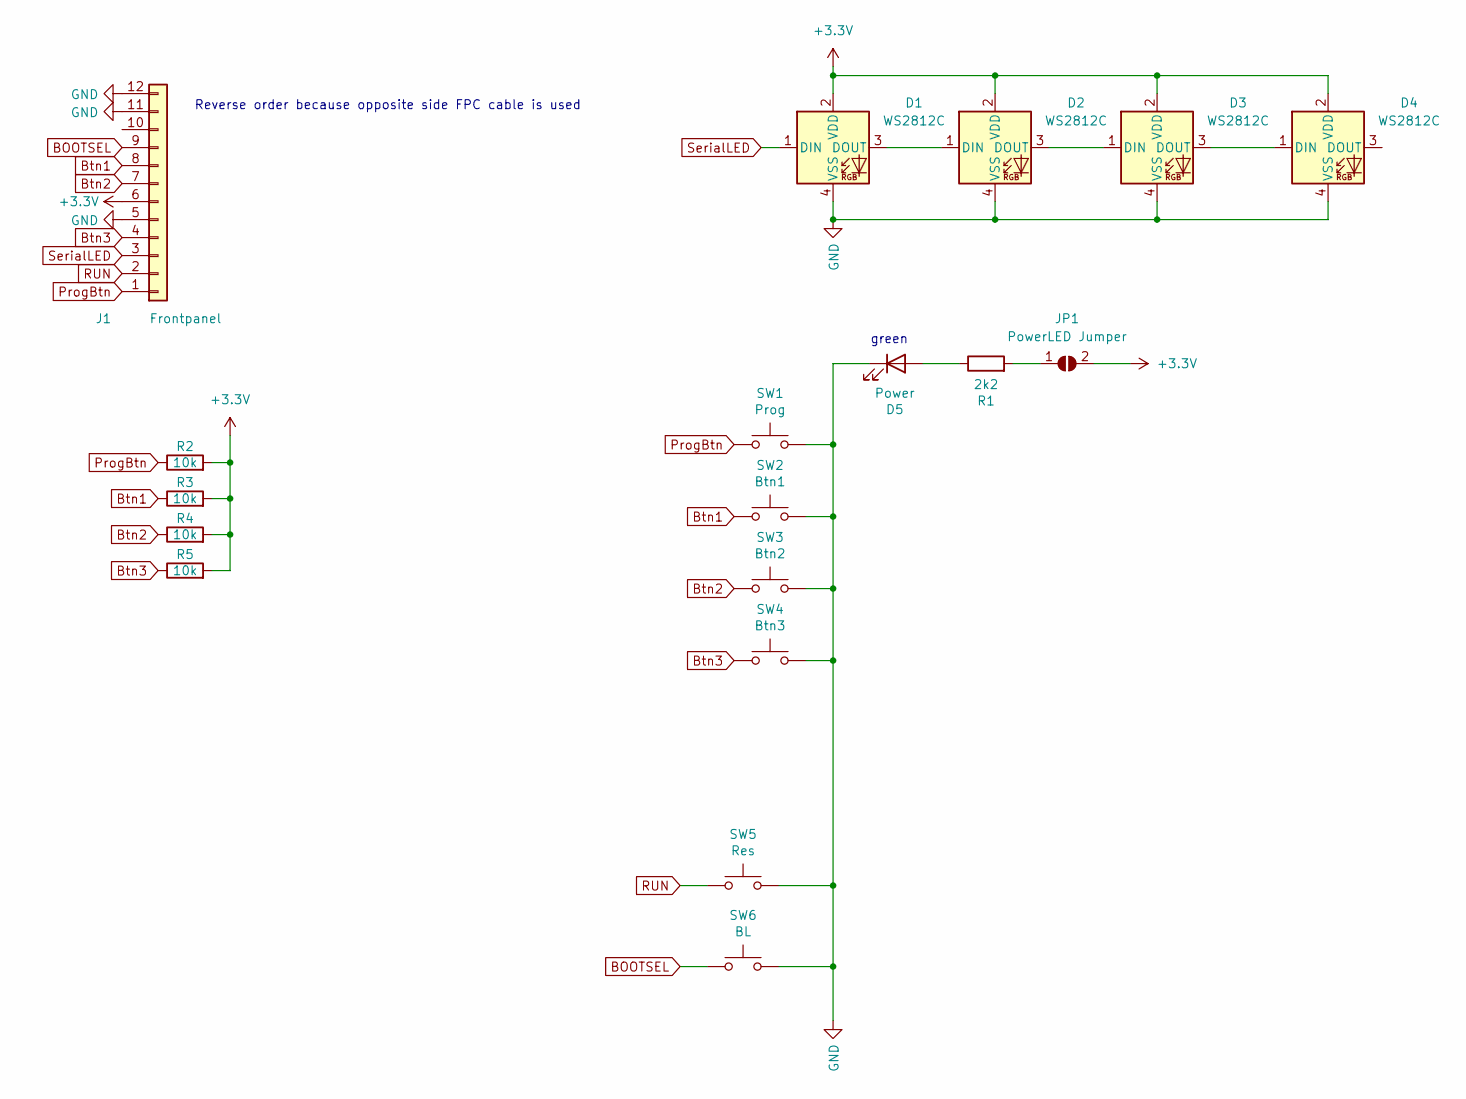
[picture p203: schematic REG1-Front-RGB.kicad_sch]

Parts:
D1, D2, D3, D4: WS2812C; LED-SMD_4P-L2.7-W2.4-TL_WS2812C-2427_Handsolder
D5: Power; LED_0603_1608Metric
J1: Frontpanel; C11050_FPC-SMD_P0.5-10P_LSXJ-H2.0-10P
JP1: PowerLED Jumper; SolderJumper-2_P1.3mm_Open_RoundedPad1.0x1.5mm
R1: 2k2; R_0402_1005Metric
R2, R3, R4, R5: 10k; R_0402_1005Metric
SW1: Prog; C455282_SW-SMD_4P-L4.2-W3.3-P2.15-LS5.1
SW2: Btn1; C455282_SW-SMD_4P-L4.2-W3.3-P2.15-LS5.1
SW3: Btn2; C455282_SW-SMD_4P-L4.2-W3.3-P2.15-LS5.1
SW4: Btn3; C455282_SW-SMD_4P-L4.2-W3.3-P2.15-LS5.1
SW5: Res; C455282_SW-SMD_4P-L4.2-W3.3-P2.15-LS5.1
SW6: BL; C455282_SW-SMD_4P-L4.2-W3.3-P2.15-LS5.1

Connections:
+3.3V: D1.2 (VDD), D2.2 (VDD), D3.2 (VDD), D4.2 (VDD), J1.6, JP1.2 (B), R2.2, R3.2, R4.2, R5.2
BOOTSEL: J1.9, SW6.1
Btn1: J1.8, R3.1, SW2.1
Btn2: J1.7, R4.1, SW3.1
Btn3: J1.4, R5.1, SW4.1
GND: D1.4 (VSS), D2.4 (VSS), D3.4 (VSS), D4.4 (VSS), D5.1 (K), J1.5, J1.11, J1.12, SW1.2, SW2.2, SW3.2, SW4.2, SW5.2, SW6.2
unnamed: D1.3 (DOUT), D2.1 (DIN)
unnamed: D2.3 (DOUT), D3.1 (DIN)
unnamed: D3.3 (DOUT), D4.1 (DIN)
unnamed: D5.2 (A), R1.1
unnamed: JP1.1 (A), R1.2
ProgBtn: J1.1, R2.1, SW1.1
RUN: J1.2, SW5.1
SerialLED: D1.1 (DIN), J1.3

Notes on the sheet:
green
Reverse order because opposite side FPC cable is used

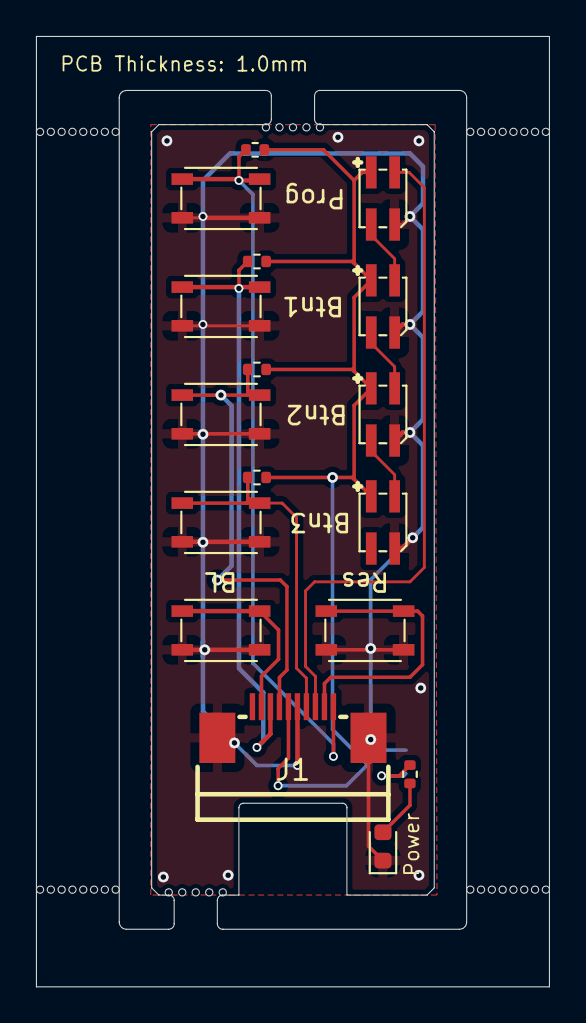
[picture p204: board REG1-Front-RGB.kicad_pcb from above]

Board: 2 copper layers, 28.5 x 52.8 mm, 24 parts (1 on the bottom side), 14 nets.

Other parts of the board:
e: VAL**; mouse-bite-5.00mm-frame
e#2: VAL**; mouse-bite-5.00mm-frame
mouse-bite: mouse-bite-2.00mm-slot_1side
mouse-bite#2, mouse-bite#3: VAL**; mouse-bite-5.00mm-frame
mouse-bite#4: mouse-bite-2.00mm-slot_1side
