OpenKNX/OpenKNX-REG1/hardware/EDA-Files/NanoDCU/NanoDCU.kicad_pcb

## KiCad design hardware/EDA-Files/NanoDCU/NanoDCU.kicad_pcb (2026-04-14)

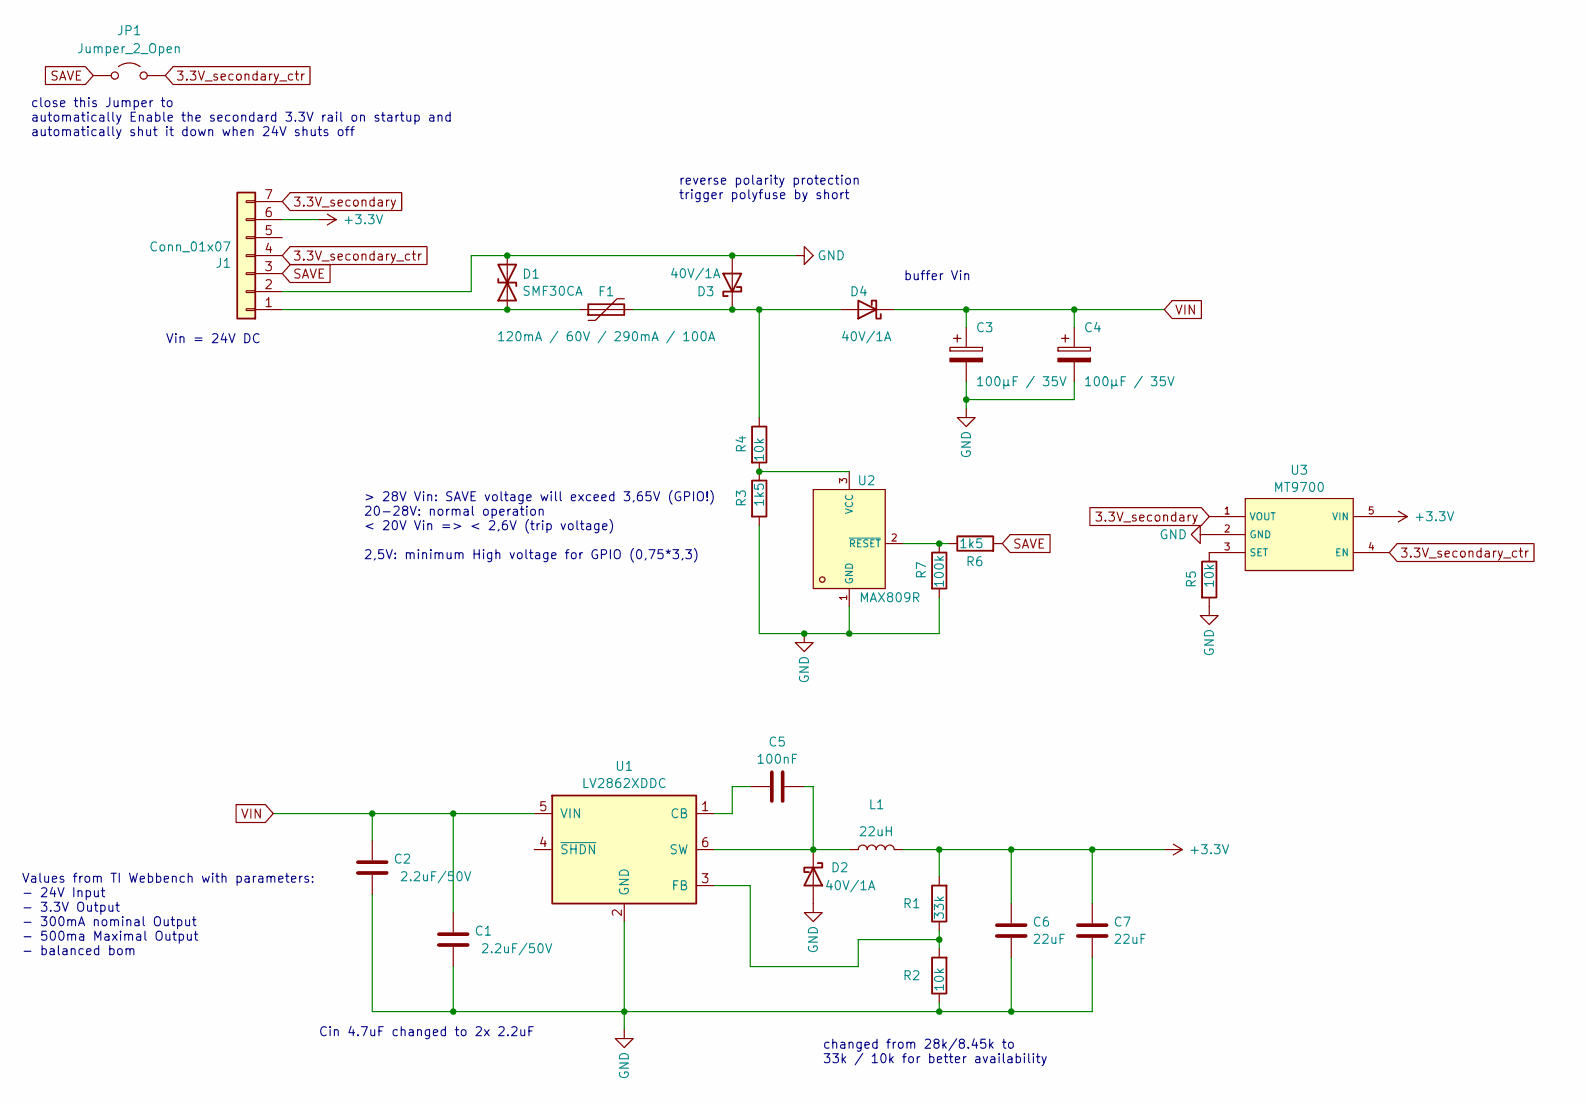
[picture p205: schematic NanoDCU.kicad_sch]

Parts:
C1, C2: 2.2uF/50V; C_0805_2012Metric
C3, C4: 100µF / 35V; CP_Elec_6.3x5.8
C5: 100nF; C_0402_1005Metric
C6, C7: 22uF; C_0805_2012Metric
D1: SMF30CA; D_SOD-123F
D2, D3, D4: 40V/1A; D_SOD-123
F1: 120mA / 60V / 290mA / 100A; Fuse_1206_3216Metric
J1: Conn_01x07; PinHeader_1x07_P2.54mm_Vertical
JP1: Jumper_2_Open; SolderJumper-2_P1.3mm_Open_RoundedPad1.0x1.5mm
L1: 22uH; L_Sunlord_SWPA4020
R1: 33k; R_0402_1005Metric
R2, R4, R5: 10k; R_0402_1005Metric
R3, R6: 1k5; R_0402_1005Metric
R7: 100k; R_0402_1005Metric
U1: LV2862XDDC; SOT-23-6
U2: MAX809R; SOT-23
U3: MT9700; SOT-23-5

Connections:
3.3V_secondary: J1.7, U3.1 (VOUT)
3.3V_secondary_ctr: J1.4, JP1.2 (B), U3.4 (EN)
+3.3V: C6.1, C7.1, J1.6, L1.2, R1.2, U3.5 (VIN)
GND: C1.2, C2.2, C3.2, C4.2, C6.2, C7.2, D1.2 (A2), D2.2 (A), D3.2 (A), J1.2, R2.1, R3.2, R5.2, R7.2, U1.2 (GND), U2.1 (GND), U3.2 (GND)
unnamed: D1.1 (A1), F1.1, J1.1
unnamed: C5.2, D2.1 (K), L1.1, U1.6 (SW)
unnamed: D3.1 (K), D4.2 (A), F1.2, R4.1
unnamed: C5.1, U1.1 (CB)
unnamed: R1.1, R2.2, U1.3 (FB)
unnamed: R3.1, R4.2, U2.3 (VCC)
unnamed: R6.1, R7.1, U2.2 (~RESET)
unnamed: R5.1, U3.3 (SET)
SAVE: J1.3, JP1.1 (A), R6.2
VIN: C1.1, C2.1, C3.1, C4.1, D4.1 (K), U1.5 (VIN)

Notes on the sheet:
> 28V Vin: SAVE voltage will exceed 3,65V (GPIO!) 20-28V: normal operation < 20V Vin => < 2,6V (trip voltage) 2,5V: minimum High voltage for GPIO (0,75*3,3)
changed from 28k/8.45k to 33k / 10k for better availability
reverse polarity protection trigger polyfuse by short
close this Jumper to automatically Enable the secondard 3.3V rail on startup and automatically shut it down when 24V shuts off
Cin 4.7uF changed to 2x 2.2uF
Vin = 24V DC
buffer Vin
Values from TI Webbench with parameters: - 24V Input - 3.3V Output - 300mA nominal Output - 500ma Maximal Output - balanced bom

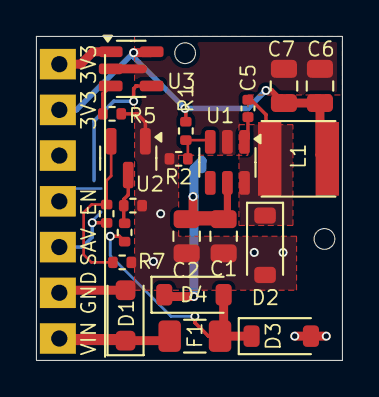
[picture p206: board NanoDCU.kicad_pcb from above]

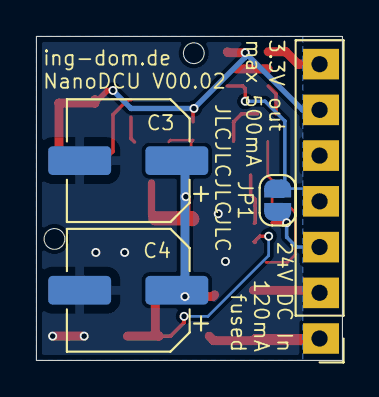
[picture p207: board NanoDCU.kicad_pcb from below]

Board: 2 copper layers, 17.0 x 18.0 mm, 25 parts (4 on the bottom side), 14 nets.
