OpenKNX/OpenKNX-REG1/hardware/EDA-Files/REG1-App-SA-4xSELV/REG1-App-SA-4xSELV.kicad_pcb

## KiCad design hardware/EDA-Files/REG1-App-SA-4xSELV/REG1-App-SA-4xSELV.kicad_pcb (2025-08-14)

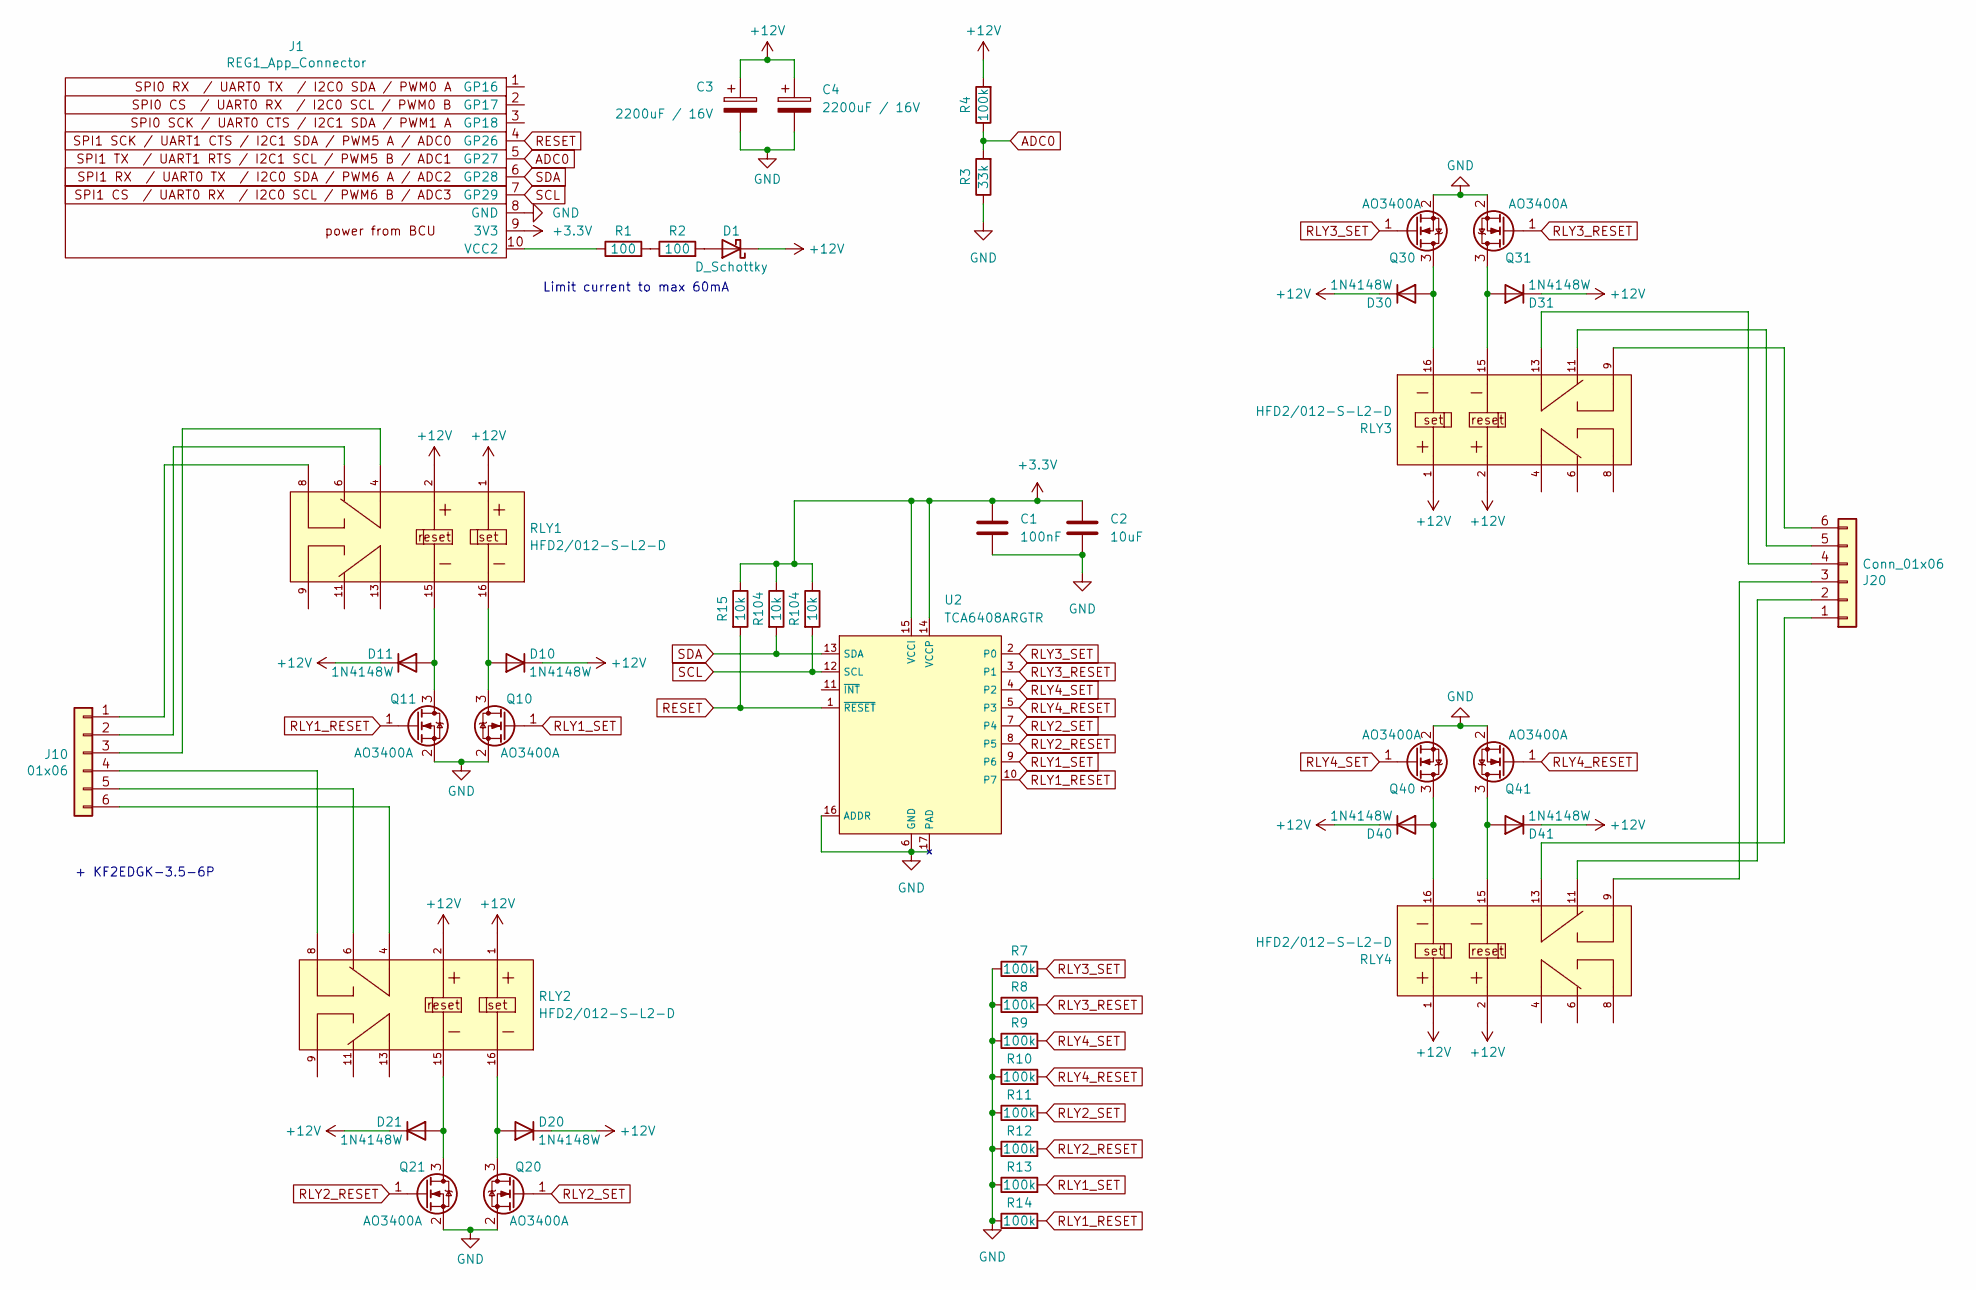
[picture p208: schematic REG1-App-SA-4xSELV.kicad_sch]

Parts:
C1: 100nF; R_0402_1005Metric
C2: 10uF; R_0805_2012Metric
C3, C4: 2200uF / 16V; CP_Radial_D10.0mm_H20.0mm_P5.00mm_Horizontal
D1: D_Schottky; D_SOD-323
D10, D11, D20, D21, D30, D31, D40, D41: 1N4148W; D_SOD-323
J1: REG1_App_Connector; PinHeader_1x10_P2.54mm_Horizontal
J10: 01x06; PhoenixContact_MC_1,5_6-G-3.5_1x06_P3.50mm_Horizontal
J20: Conn_01x06; PhoenixContact_MC_1,5_6-G-3.5_1x06_P3.50mm_Horizontal
Q10, Q11, Q20, Q21, Q30, Q31, Q40, Q41: AO3400A; SOT-23
R1, R2: 100; R_1206_3216Metric
R3: 33k; R_0402_1005Metric
R4, R7, R8, R9, R10, R11, R12, R13, R14: 100k; R_0402_1005Metric
R15, R104: 10k; R_0402_1005Metric
RLY1, RLY2, RLY3, RLY4: HFD2/012-S-L2-D; RELAY-TH_HFD2-X-X-L2-X
U2: TCA6408ARGTR; QFN-16-1EP_3x3mm_P0.5mm_EP1.7x1.7mm

Connections:
+3.3V: C1.1, C2.1, J1.9 (3V3), R15.1, U2.14 (VCCP), U2.15 (VCCI); also elsewhere on the board
+12V: C3.1, C4.1, D1.1 (K), D10.1 (K), D11.1 (K), D20.1 (K), D21.1 (K), D30.1 (K), D31.1 (K), D40.1 (K), D41.1 (K), R4.2, RLY1.1, RLY1.2, RLY2.1, RLY2.2, RLY3.1, RLY3.2, RLY4.1, RLY4.2
ADC0: J1.5 (GP27), R3.2, R4.1
GND: C1.2, C2.2, C3.2, C4.2, J1.8 (GND), Q10.2 (S), Q11.2 (S), Q20.2 (S), Q21.2 (S), Q30.2 (S), Q31.2 (S), Q40.2 (S), Q41.2 (S), R3.1, R7.1, R8.1, R9.1, R10.1, R11.1, R12.1, R13.1, R14.1, U2.6 (GND), U2.16 (ADDR), U2.17 (PAD)
unnamed: D1.2 (A), R2.2
unnamed: D10.2 (A), Q10.3 (D), RLY1.16
unnamed: D11.2 (A), Q11.3 (D), RLY1.15
unnamed: D20.2 (A), Q20.3 (D), RLY2.16
unnamed: D21.2 (A), Q21.3 (D), RLY2.15
unnamed: D30.2 (A), Q30.3 (D), RLY3.16
unnamed: D31.2 (A), Q31.3 (D), RLY3.15
unnamed: D40.2 (A), Q40.3 (D), RLY4.16
unnamed: D41.2 (A), Q41.3 (D), RLY4.15
unnamed: J1.10 (VCC2), R1.1
unnamed: J10.1, RLY1.8
unnamed: J10.2, RLY1.6
unnamed: J10.3, RLY1.4
unnamed: J10.4, RLY2.8
unnamed: J10.5, RLY2.6
unnamed: J10.6, RLY2.4
unnamed: J20.1, RLY4.13
unnamed: J20.2, RLY4.11
unnamed: J20.3, RLY4.9
unnamed: J20.4, RLY3.13
unnamed: J20.5, RLY3.11
unnamed: J20.6, RLY3.9
unnamed: R1.2, R2.1
RESET: J1.4 (GP26), R15.2, U2.1 (~RESET)
RLY1_RESET: Q11.1 (G), R14.2, U2.10 (P7)
RLY1_SET: Q10.1 (G), R13.2, U2.9 (P6)
RLY2_RESET: Q21.1 (G), R12.2, U2.8 (P5)
RLY2_SET: Q20.1 (G), R11.2, U2.7 (P4)
RLY3_RESET: Q31.1 (G), R8.2, U2.3 (P1)
RLY3_SET: Q30.1 (G), R7.2, U2.2 (P0)
RLY4_RESET: Q41.1 (G), R10.2, U2.5 (P3)
RLY4_SET: Q40.1 (G), R9.2, U2.4 (P2)
SCL: J1.7 (GP29), U2.12 (SCL); also elsewhere on the board
SDA: J1.6 (GP28), U2.13 (SDA); also elsewhere on the board

Notes on the sheet:
+ KF2EDGK-3.5-6P
Limit current to max 60mA

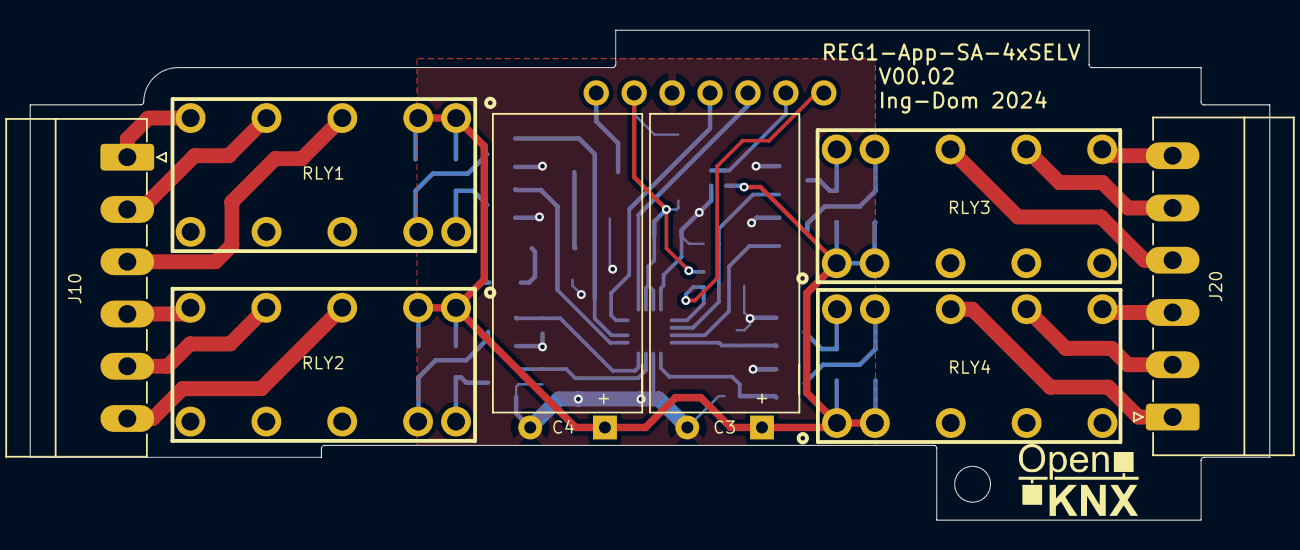
[picture p209: board REG1-App-SA-4xSELV.kicad_pcb from above]

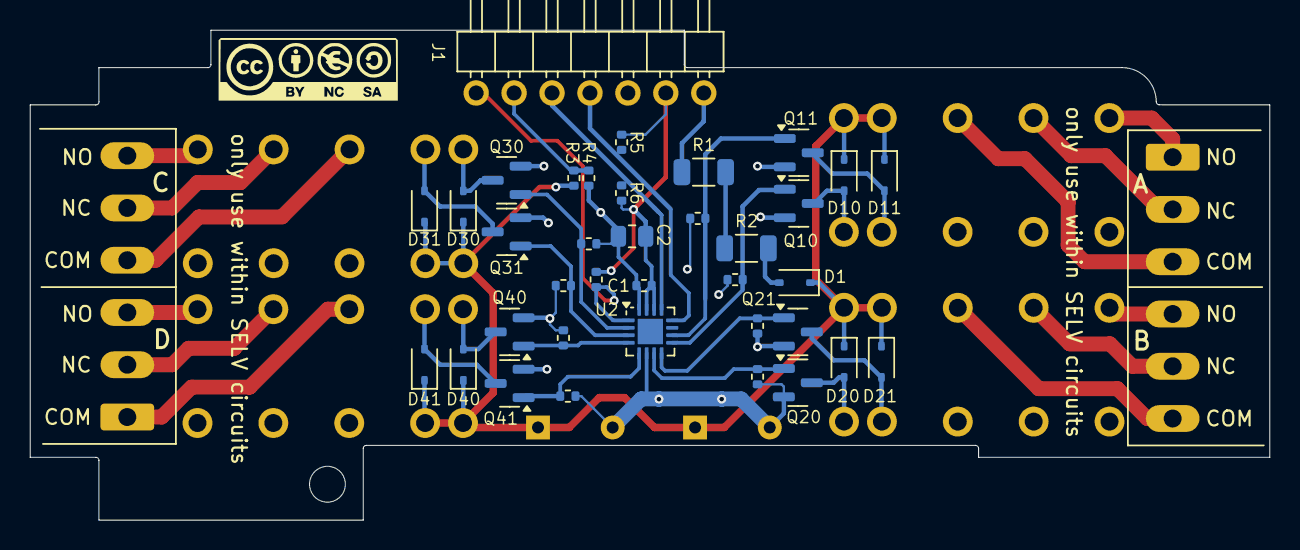
[picture p210: board REG1-App-SA-4xSELV.kicad_pcb from below]

Board: 2 copper layers, 83.0 x 32.8 mm, 45 parts (37 on the bottom side), 38 nets.

Other parts of the board:
G1: LOGO; CC-BY-NY-SA_12x4
R5, R6: 10k; R_0402_1005Metric

Their connections:
+3.3V: R5.1, R6.1; also elsewhere on the board
SCL: R5.2; also elsewhere on the board
SDA: R6.2; also elsewhere on the board
