OpenKNX/OpenKNX-REG1/hardware/EDA-Files/REG1-Controller2040/REG1-Controller2040.kicad_pcb

## KiCad design hardware/EDA-Files/REG1-Controller2040/REG1-Controller2040.kicad_pcb (2025-02-05)

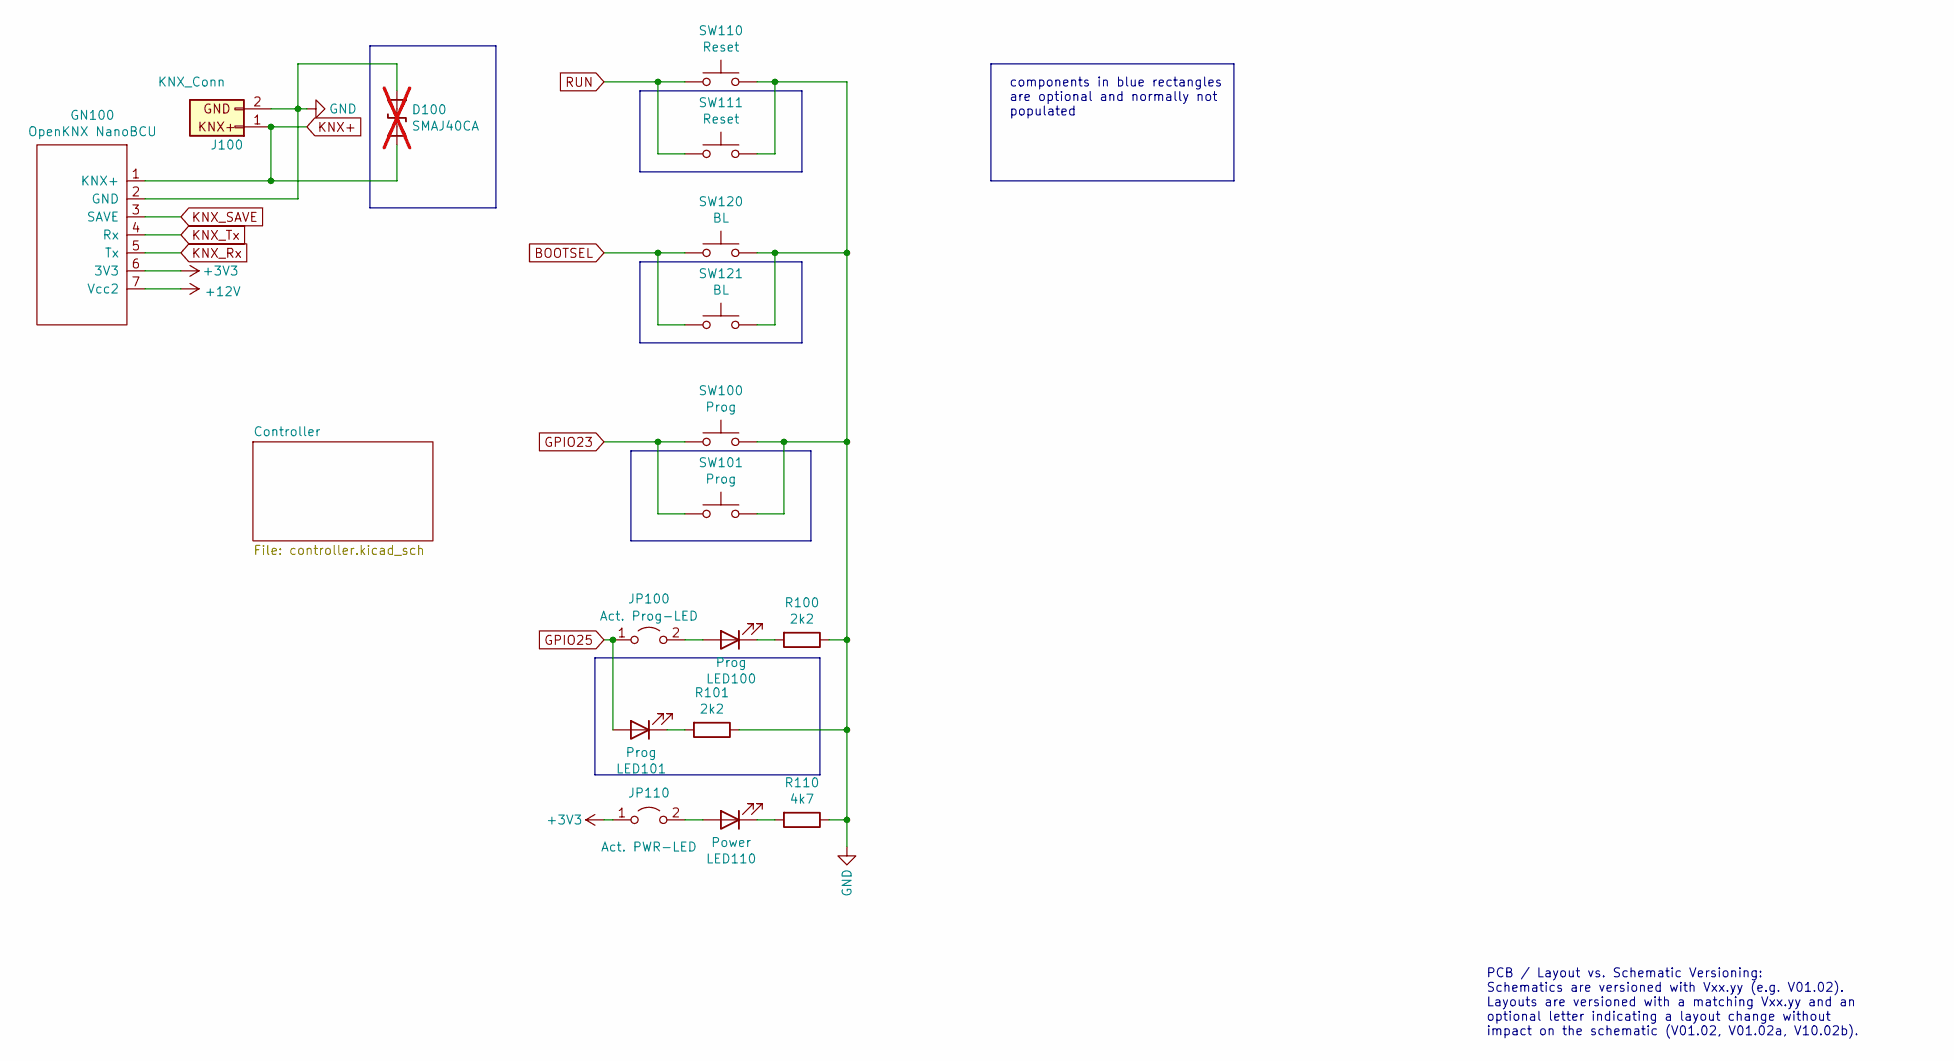
[picture p211: schematic REG1-Controller2040.kicad_sch]

Parts:
D100: SMAJ40CA; D_SMA; not fitted
GN100: OpenKNX NanoBCU; NanoBCU2_Vertical_Slot_double
J100: KNX_Conn; KNX_Connector
JP100: Act. Prog-LED; SolderJumper-2_P1.3mm_Open_RoundedPad1.0x1.5mm
JP110: Act. PWR-LED; SolderJumper-2_P1.3mm_Open_RoundedPad1.0x1.5mm
LED100: Prog; D_0603_1608Metric
LED101: Prog; D_0805_2012Metric_Pad1.15x1.40mm_HandSolder
LED110: Power; D_0603_1608Metric
R100: 2k2; R_0402_1005Metric
R101: 2k2; R_0805_2012Metric_Pad1.20x1.40mm_HandSolder
R110: 4k7; R_0402_1005Metric
SW100, SW101: Prog; C455282_SW-SMD_4P-L4.2-W3.3-P2.15-LS5.1_Handsolder
SW110, SW111: Reset; C455282_SW-SMD_4P-L4.2-W3.3-P2.15-LS5.1_Handsolder
SW120, SW121: BL; C455282_SW-SMD_4P-L4.2-W3.3-P2.15-LS5.1_Handsolder

Connections:
+3V3: GN100.6 (3V3), JP110.1 (A); also elsewhere on the board
+12V: GN100.7 (Vcc2); also elsewhere on the board
BOOTSEL: SW120.1, SW121.1; also elsewhere on the board
GND: D100.1 (A1), GN100.2 (GND), J100.2, R100.1, R101.1, R110.1, SW100.2, SW101.2, SW110.2, SW111.2, SW120.2, SW121.2; also elsewhere on the board
GPIO23: SW100.1, SW101.1; also elsewhere on the board
GPIO25: JP100.1 (A), LED101.2 (A); also elsewhere on the board
KNX+: D100.2 (A2), GN100.1 (KNX+), J100.1
KNX_Rx: GN100.5 (Tx); also elsewhere on the board
KNX_SAVE: GN100.3 (SAVE); also elsewhere on the board
KNX_Tx: GN100.4 (Rx); also elsewhere on the board
unnamed: JP100.2 (B), LED100.2 (A)
unnamed: JP110.2 (B), LED110.2 (A)
unnamed: LED100.1 (K), R100.2
unnamed: LED101.1 (K), R101.2
unnamed: LED110.1 (K), R110.2
RUN: SW110.1, SW111.1; also elsewhere on the board

Notes on the sheet:
components in blue rectangles are optional and normally not populated
PCB / Layout vs. Schematic Versioning: Schematics are versioned with Vxx.yy (e.g. V01.02). Layouts are versioned with a matching Vxx.yy and an optional letter indicating a layout change without impact on the schematic (V01.02, V01.02a, V10.02b).
