OpenKNX/OpenKNX-REG1/hardware/EDA-Files/REG1-Controller2040/REG1-Controller2040.kicad_pcb

## KiCad design hardware/EDA-Files/REG1-Controller2040/REG1-Controller2040.kicad_pcb (continued)

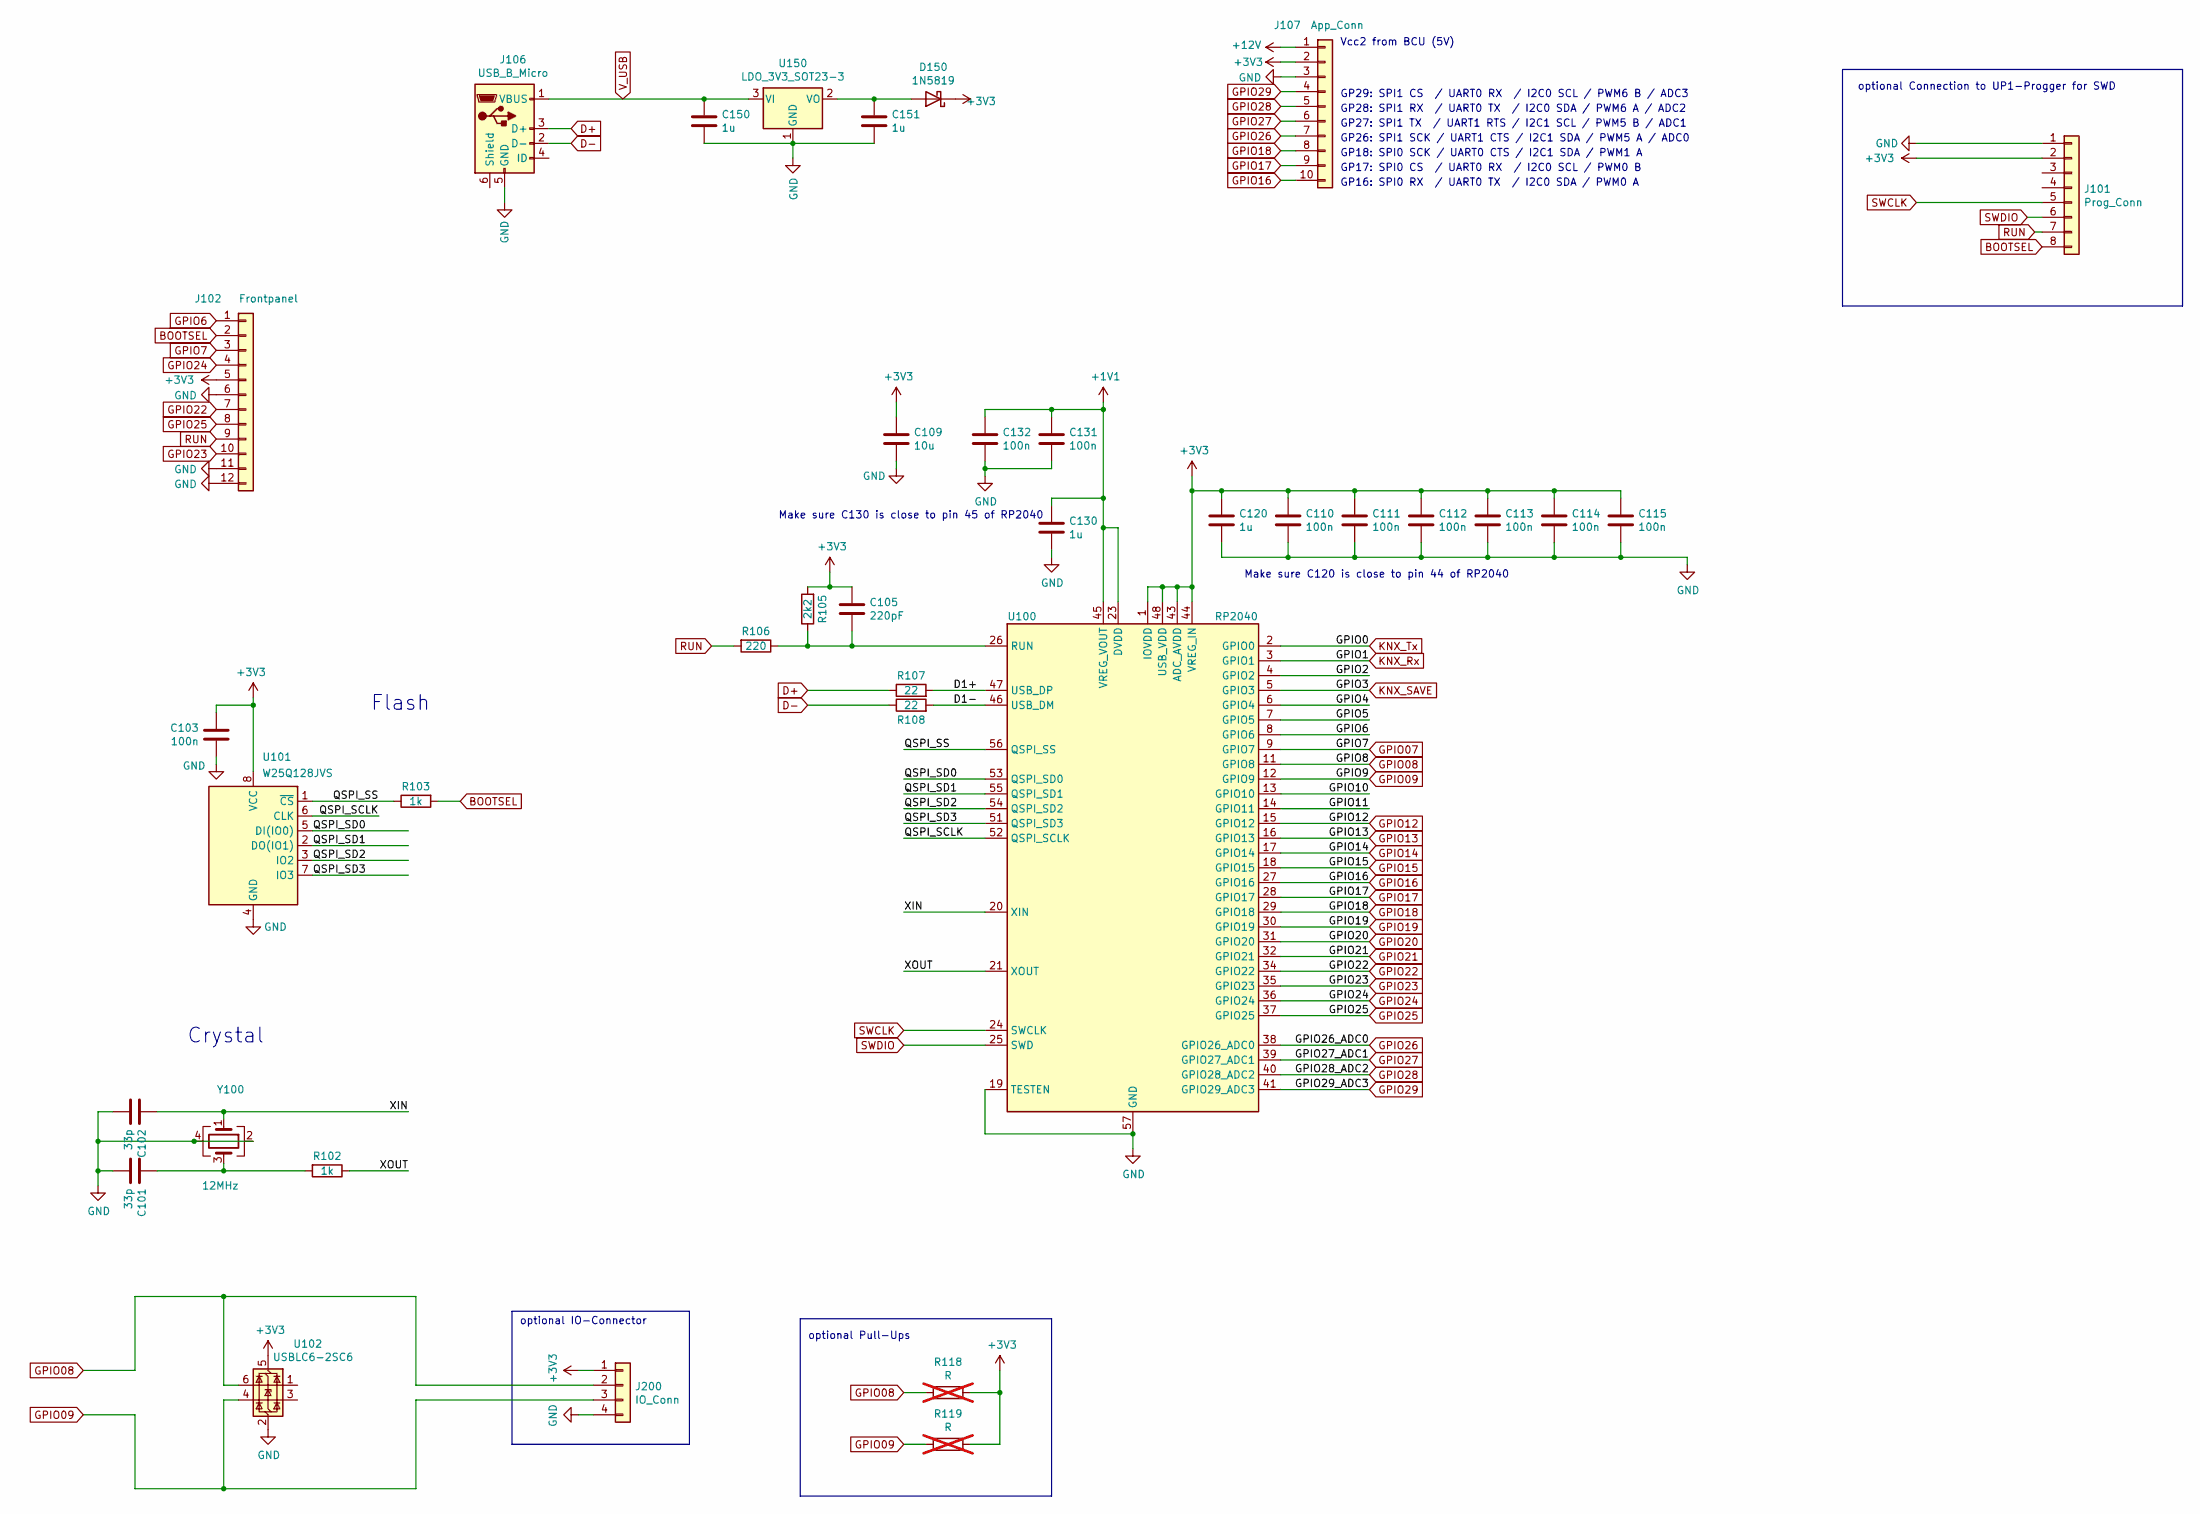
[picture p212: schematic controller.kicad_sch, REG1-Controller2040]

Parts:
C101, C102: 33p; C_0402_1005Metric
C103, C110, C111, C112, C113, C114, C115, C131, C132: 100n; C_0402_1005Metric
C105: 220pF; C_0402_1005Metric
C109: 10u; C_0805_2012Metric
C120, C130, C150, C151: 1u; C_0402_1005Metric
D150: 1N5819; D_SOD-323
J101: Prog_Conn; CONN-TH_1.25-8AW_reversed
J102: Frontpanel; CONN-TH-10P_AFC11-S10ICC-00
J106: USB_B_Micro; USB_Micro-B_JING_C10418
J107: App_Conn; PinHeader_1x10_P2.54mm_Vertical
J200: IO_Conn; PhoenixContact_MC_1,5_4-G-3.5_1x04_P3.50mm_Horizontal
R102, R103: 1k; R_0402_1005Metric
R105: 2k2; R_0402_1005Metric
R106: 220; R_0402_1005Metric
R107, R108: 22; R_0402_1005Metric
R118, R119: R; R_0805_2012Metric_Pad1.20x1.40mm_HandSolder; not fitted
U100: RP2040; RP2040-QFN-56_noThermalVias
U101: W25Q128JVS; SOIC-8_5.23x5.23mm_P1.27mm
U102: USBLC6-2SC6; SOT-23-6
U150: LDO_3V3_SOT23-3; SOT-23
Y100: 12MHz; Crystal_SMD_3225-4Pin_3.2x2.5mm

Connections:
+1V1: C130.1, C131.1, C132.1, U100.23 (DVDD), U100.45 (VREG_VOUT), U100.50 (DVDD)
+3V3: C103.1, C105.1, C109.1, C110.1, C111.1, C112.1, C113.1, C114.1, C115.1, C120.1, D150.1 (K), J101.2, J107.2, J200.1, R105.2, R118.1, R119.1, U100.1 (IOVDD), U100.10 (IOVDD), U100.22 (IOVDD), U100.33 (IOVDD), U100.42 (IOVDD), U100.43 (ADC_AVDD), U100.44 (VREG_IN), U100.48 (USB_VDD), U100.49 (IOVDD), U101.8 (VCC), U102.5 (VBUS); also elsewhere on the board
+12V: J107.1; also elsewhere on the board
/Controller/D1+: R107.2, U100.47 (USB_DP)
/Controller/D1-: R108.2, U100.46 (USB_DM)
/Controller/GPIO2: U100.4 (GPIO2)
/Controller/GPIO4: U100.6 (GPIO4)
/Controller/GPIO5: U100.7 (GPIO5)
/Controller/GPIO10: U100.13 (GPIO10)
/Controller/GPIO11: U100.14 (GPIO11)
/Controller/QSPI_SCLK: U100.52 (QSPI_SCLK), U101.6 (CLK)
/Controller/QSPI_SD0: U100.53 (QSPI_SD0), U101.5 (DI(IO0))
/Controller/QSPI_SD1: U100.55 (QSPI_SD1), U101.2 (DO(IO1))
/Controller/QSPI_SD2: U100.54 (QSPI_SD2), U101.3 (IO2)
/Controller/QSPI_SD3: U100.51 (QSPI_SD3), U101.7 (IO3)
/Controller/QSPI_SS: R103.1, U100.56 (QSPI_SS), U101.1 (~CS)
/Controller/XIN: C102.1, U100.20 (XIN), Y100.1
/Controller/XOUT: R102.1, U100.21 (XOUT)
BOOTSEL: J101.8, R103.2; also elsewhere on the board
D+: J106.3 (D+), R107.1
D-: J106.2 (D-), R108.1
GND: C101.2, C102.2, C103.2, C109.2, C110.2, C111.2, C112.2, C113.2, C114.2, C115.2, C120.2, C130.2, C131.2, C132.2, C150.2, C151.2, J101.1, J106.5 (GND), J107.3, J200.4, U100.19 (TESTEN), U100.57 (GND), U101.4 (GND), U102.2 (GND), U150.1 (GND), Y100.2, Y100.4; also elsewhere on the board
GPIO6: U100.8 (GPIO6); also elsewhere on the board
GPIO07: U100.9 (GPIO7); also elsewhere on the board
GPIO08: J200.2, R118.2, U100.11 (GPIO8), U102.6 (I/O1)
GPIO09: J200.3, R119.2, U100.12 (GPIO9), U102.4 (I/O2)
GPIO12: U100.15 (GPIO12)
GPIO13: U100.16 (GPIO13)
GPIO14: U100.17 (GPIO14)
GPIO15: U100.18 (GPIO15)
GPIO16: J107.10, U100.27 (GPIO16)
GPIO17: J107.9, U100.28 (GPIO17)
GPIO18: J107.8, U100.29 (GPIO18)
GPIO19: U100.30 (GPIO19)
GPIO20: U100.31 (GPIO20)
GPIO21: U100.32 (GPIO21)
GPIO22: U100.34 (GPIO22); also elsewhere on the board
GPIO23: U100.35 (GPIO23); also elsewhere on the board
GPIO24: U100.36 (GPIO24); also elsewhere on the board
GPIO25: U100.37 (GPIO25); also elsewhere on the board
GPIO26: J107.7, U100.38 (GPIO26_ADC0)
GPIO27: J107.6, U100.39 (GPIO27_ADC1)
GPIO28: J107.5, U100.40 (GPIO28_ADC2)
GPIO29: J107.4, U100.41 (GPIO29_ADC3)
KNX_Rx: U100.3 (GPIO1); also elsewhere on the board
KNX_SAVE: U100.5 (GPIO3); also elsewhere on the board
KNX_Tx: U100.2 (GPIO0); also elsewhere on the board
unnamed: C101.1, R102.2, Y100.3
unnamed: C151.1, D150.2 (A), U150.2 (VO)
unnamed: C105.2, R105.1, R106.1, U100.26 (RUN)
RUN: J101.7, R106.2; also elsewhere on the board
SWCLK: J101.5, U100.24 (SWCLK)
SWDIO: J101.6, U100.25 (SWD)
V_USB: C150.1, J106.1 (VBUS), U150.3 (VI)

Notes on the sheet:
GP18: SPI0 SCK / UART0 CTS / I2C1 SDA / PWM1 A
GP16: SPI0 RX / UART0 TX / I2C0 SDA / PWM0 A
optional Connection to UP1-Progger for SWD
Make sure C130 is close to pin 45 of RP2040
GP17: SPI0 CS / UART0 RX / I2C0 SCL / PWM0 B
Vcc2 from BCU (5V)
GP29: SPI1 CS / UART0 RX / I2C0 SCL / PWM6 B / ADC3
Flash
GP28: SPI1 RX / UART0 TX / I2C0 SDA / PWM6 A / ADC2
GP26: SPI1 SCK / UART1 CTS / I2C1 SDA / PWM5 A / ADC0
optional Pull-Ups
Crystal
GP27: SPI1 TX / UART1 RTS / I2C1 SCL / PWM5 B / ADC1
optional IO-Connector
Make sure C120 is close to pin 44 of RP2040

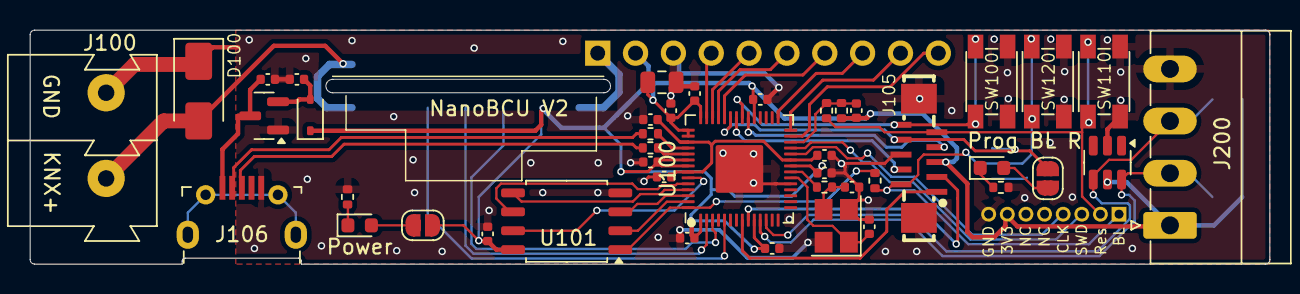
[picture p213: board REG1-Controller2040.kicad_pcb from above]

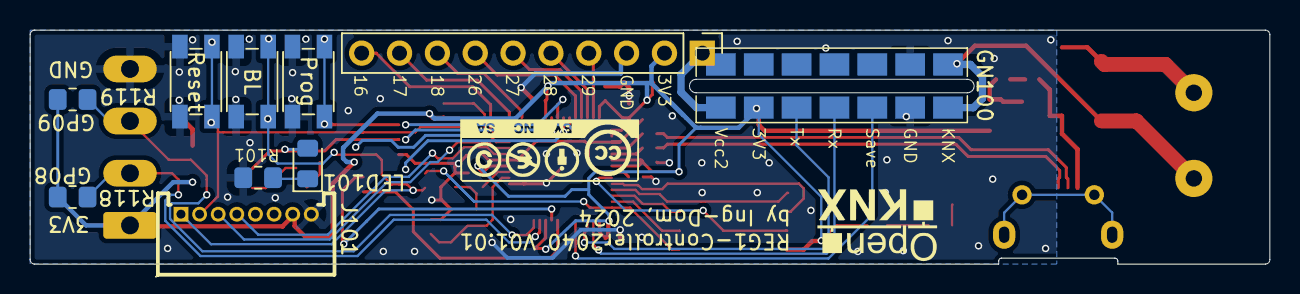
[picture p214: board REG1-Controller2040.kicad_pcb from below]

Board: 2 copper layers, 83.2 x 15.7 mm, 55 parts (12 on the bottom side), 48 nets.

Other parts of the board:
G1: LOGO; CC-BY-NY-SA_12x4
G2: LOGO; OpenKNX_Logo_10x10
J105: Frontpanel; CONN-TH-10P_AFC11-S10ICC-00

Their connections:
+3V3: J105.5; also elsewhere on the board
BOOTSEL: J105.2; also elsewhere on the board
GND: J105.6, J105.11, J105.12; also elsewhere on the board
GPIO6: J105.1; also elsewhere on the board
GPIO07: J105.3; also elsewhere on the board
GPIO22: J105.7; also elsewhere on the board
GPIO23: J105.10; also elsewhere on the board
GPIO24: J105.4; also elsewhere on the board
GPIO25: J105.8; also elsewhere on the board
RUN: J105.9; also elsewhere on the board
