OpenKNX/OpenKNX-REG1/hardware/EDA-Files/REG1-App-2xDALI/REG1-App-2xDALI.kicad_pcb

## KiCad design hardware/EDA-Files/REG1-App-2xDALI/REG1-App-2xDALI.kicad_pcb (2025-02-02)

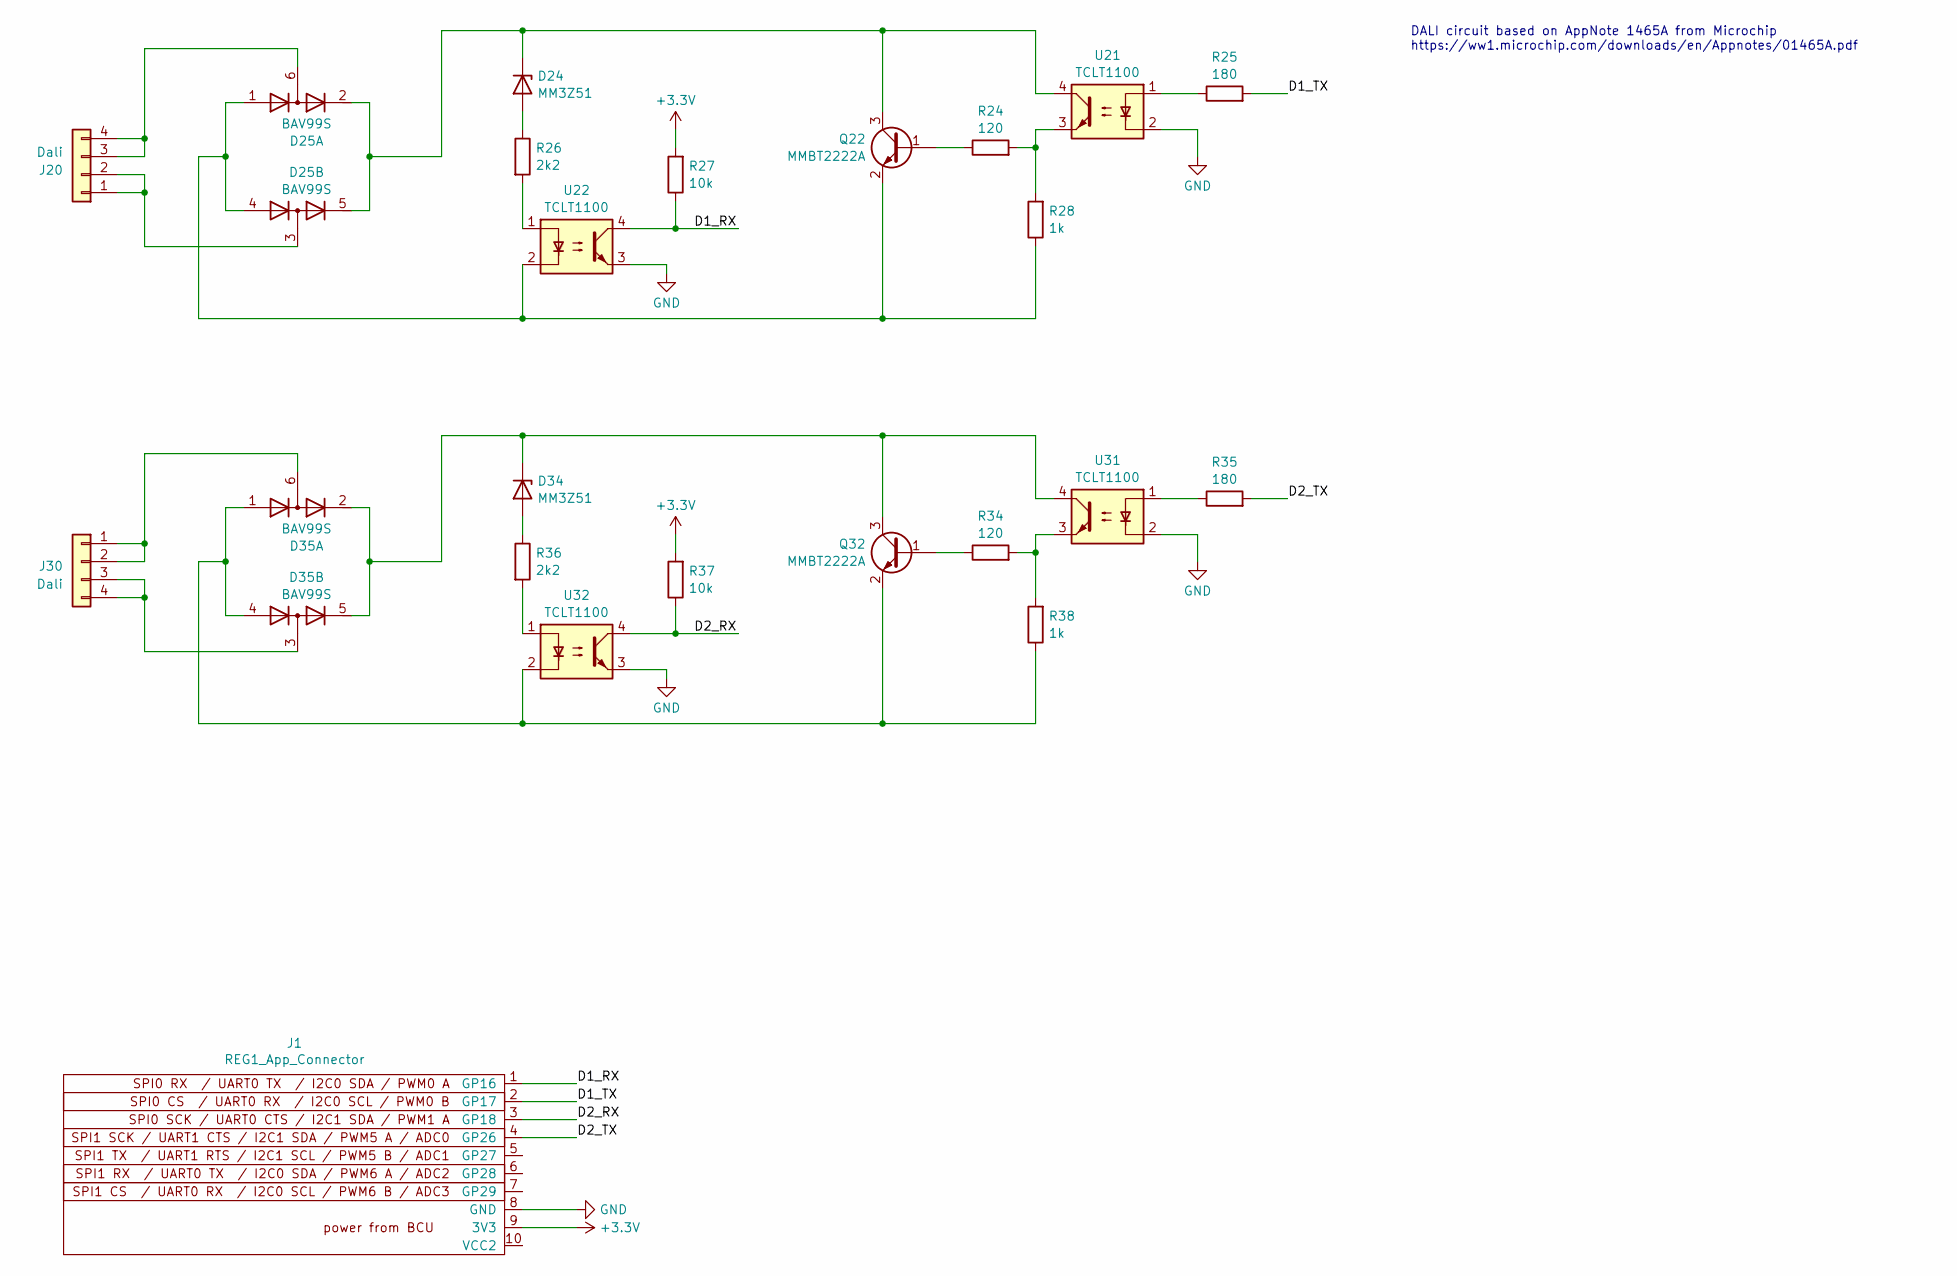
[picture p215: schematic REG1-App-2xDALI.kicad_sch]

Parts:
D24, D34: MM3Z51; D_SOD-323F
D25, D35: BAV99S; SOT-363_SC-70-6
J1: REG1_App_Connector; PinHeader_1x10_P2.54mm_Horizontal
J20, J30: Dali; PhoenixContact_MC_1,5_4-G-3.5_1x04_P3.50mm_Horizontal
Q22, Q32: MMBT2222A; SOT-23
R24, R34: 120; R_0603_1608Metric
R25, R35: 180; R_0603_1608Metric
R26, R36: 2k2; R_0603_1608Metric
R27, R37: 10k; R_0603_1608Metric
R28, R38: 1k; R_0603_1608Metric
U21, U22, U31, U32: TCLT1100; SOP-4_7.5x4.1mm_P2.54mm

Connections:
+3.3V: J1.9 (3V3), R27.2, R37.2
/D1_RX: J1.1 (GP16), R27.1, U22.4
/D1_TX: J1.2 (GP17), R25.2
/D2_RX: J1.3 (GP18), R37.1, U32.4
/D2_TX: J1.4 (GP26), R35.2
GND: J1.8 (GND), U21.2, U22.3, U31.2, U32.3
unnamed: D24.2 (A), R26.1
unnamed: D24.1 (K), D25.2 (K2), D25.5 (K4), Q22.3 (C), U21.4
unnamed: D25.1 (A1), D25.4 (A3), Q22.2 (E), R28.1, U22.2
unnamed: D25.6 (K3A4), J20.3, J20.4
unnamed: D25.3 (K1A2), J20.1, J20.2
unnamed: D34.2 (A), R36.1
unnamed: D34.1 (K), D35.2 (K2), D35.5 (K4), Q32.3 (C), U31.4
unnamed: D35.1 (A1), D35.4 (A3), Q32.2 (E), R38.1, U32.2
unnamed: D35.6 (K3A4), J30.1, J30.2
unnamed: D35.3 (K1A2), J30.3, J30.4
unnamed: Q22.1 (B), R24.1
unnamed: Q32.1 (B), R34.1
unnamed: R24.2, R28.2, U21.3
unnamed: R25.1, U21.1
unnamed: R26.2, U22.1
unnamed: R34.2, R38.2, U31.3
unnamed: R35.1, U31.1
unnamed: R36.2, U32.1

Notes on the sheet:
DALI circuit based on AppNote 1465A from Microchip https://ww1.microchip.com/downloads/en/Appnotes/01465A.pdf

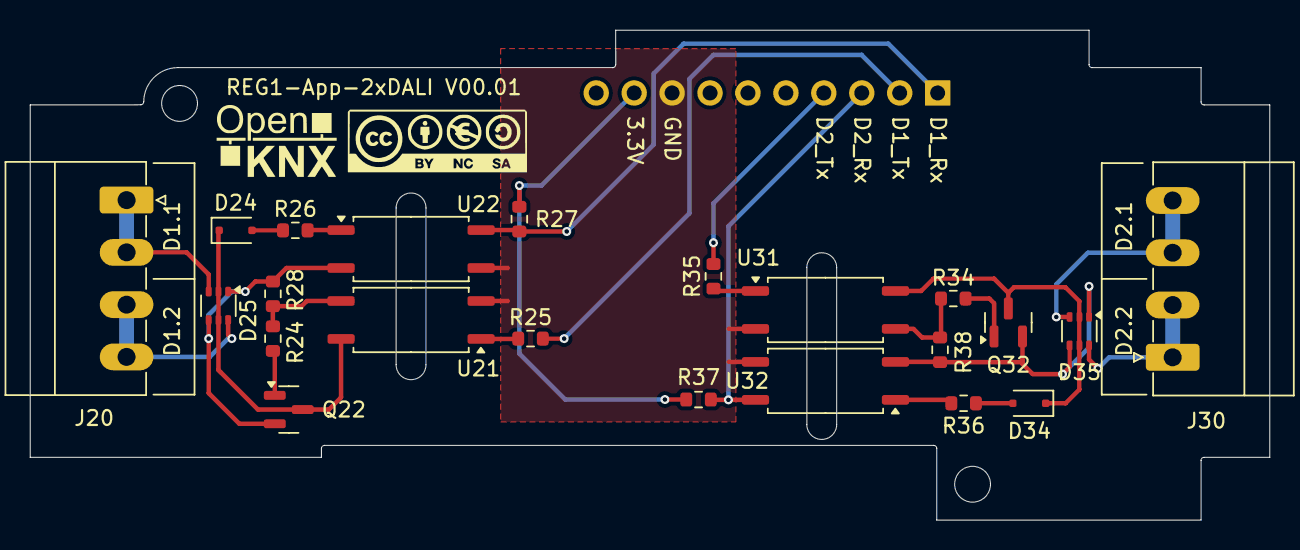
[picture p216: board REG1-App-2xDALI.kicad_pcb from above]

Board: 2 copper layers, 83.0 x 32.8 mm, 25 parts (1 on the bottom side), 24 nets.

Other parts of the board:
G1: LOGO; CC-BY-NY-SA_12x4
G2: LOGO; OpenKNX_Logo_10x10
