OpenKNX/OpenKNX-REG1/hardware/EDA-Files/REG1-App-Eth/REG1-App-Eth.kicad_pcb

## KiCad design hardware/EDA-Files/REG1-App-Eth/REG1-App-Eth.kicad_pcb (2025-01-09)

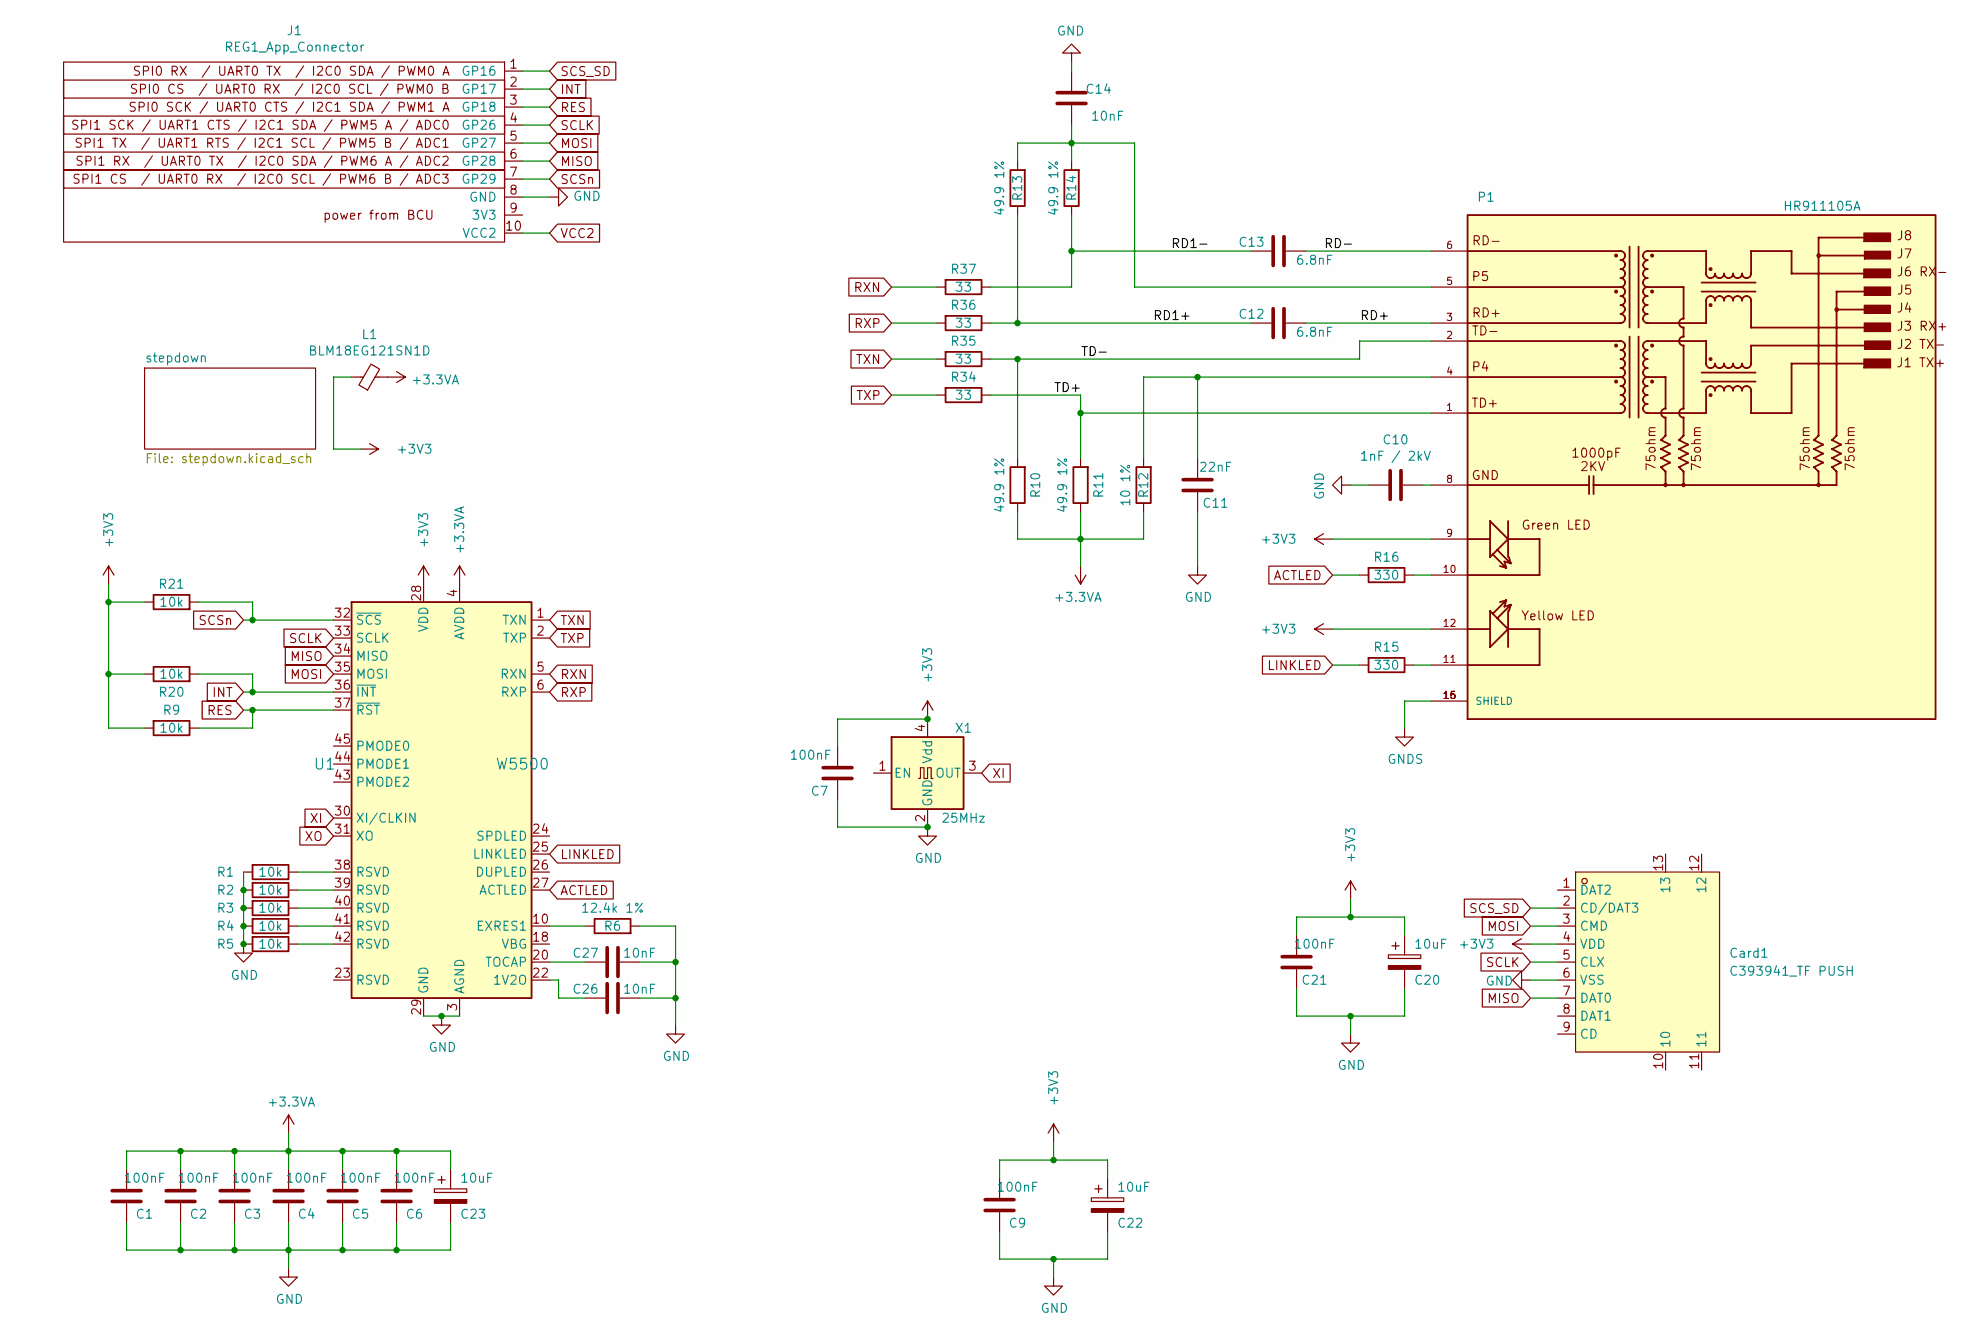
[picture p217: schematic REG1-App-Eth.kicad_sch]

Parts:
C1, C2, C3, C4, C5, C6, C7, C9, C21: 100nF; C_0402_1005Metric
C10: 1nF / 2kV; C_1206_3216Metric
C11: 22nF; C_0402_1005Metric
C12, C13: 6.8nF; C_0402_1005Metric
C14, C26, C27: 10nF; C_0402_1005Metric
C20, C22, C23: 10uF; CP_EIA-3216-18_Kemet-A
Card1: C393941_TF PUSH; C393941_TF-SMD_TF-PUSH_Handsolder
J1: REG1_App_Connector; PinHeader_1x10_P2.54mm_Horizontal
L1: BLM18EG121SN1D; L_0603_1608Metric
P1: HR911105A; HANRUN_HR911105A; PARTREV A
R1, R2, R3, R4, R5, R9, R20, R21: 10k; R_0402_1005Metric
R6: 12.4k 1%; R_0402_1005Metric
R10, R11, R13, R14: 49.9 1%; R_0402_1005Metric
R12: 10 1%; R_0402_1005Metric
R15, R16: 330; R_0402_1005Metric
R34, R35, R36, R37: 33; R_0402_1005Metric
U1: W5500; LQFP-48_7x7mm_P0.5mm; MPN W5500; Digi-Key_PN 1278-1021-ND
X1: 25MHz; Crystal_SMD_3225-4Pin_3.2x2.5mm

Connections:
+3.3VA: C1.1, C2.1, C3.1, C4.1, C5.1, C6.1, C23.1, L1.2, R10.1, R11.1, R12.1, U1.4 (AVDD), U1.8 (AVDD), U1.11 (AVDD), U1.15 (AVDD), U1.17 (AVDD), U1.21 (AVDD)
+3V3: C7.1, C9.1, C20.1, C21.1, C22.1, Card1.4 (VDD), L1.1, P1.9, P1.12, R9.2, R20.1, R21.1, U1.28 (VDD), X1.4 (Vdd); also elsewhere on the board
/RD1+: C12.2, R13.1, R36.1
/RD1-: C13.2, R14.1, R37.1
/RD+: C12.1, P1.3
/RD-: C13.1, P1.6
/TD+: P1.1, R11.2, R34.1
/TD-: P1.2, R10.2, R35.1
ACTLED: R16.2, U1.27 (ACTLED)
GND: C1.2, C2.2, C3.2, C4.2, C5.2, C6.2, C7.2, C9.2, C10.2, C11.2, C14.2, C20.2, C21.2, C22.2, C23.2, C26.1, C27.2, Card1.6 (VSS), J1.8 (GND), R1.2, R2.2, R3.2, R4.2, R5.2, R6.2, U1.3 (AGND), U1.9 (AGND), U1.14 (AGND), U1.16 (AGND), U1.19 (AGND), U1.29 (GND), U1.48 (AGND), X1.2 (GND); also elsewhere on the board
GNDS: P1.15 (SHIELD), P1.16 (SHIELD)
INT: J1.2 (GP17), R20.2, U1.36 (~INT)
LINKLED: R15.2, U1.25 (LINKLED)
MISO: Card1.7 (DAT0), J1.6 (GP28), U1.34 (MISO)
MOSI: Card1.3 (CMD), J1.5 (GP27), U1.35 (MOSI)
unnamed: C10.1, P1.8
unnamed: C11.1, P1.4, R12.2
unnamed: C14.1, P1.5, R13.2, R14.2
unnamed: P1.10, R16.1
unnamed: P1.11, R15.1
unnamed: R1.1, U1.38 (RSVD)
unnamed: R2.1, U1.39 (RSVD)
unnamed: R3.1, U1.40 (RSVD)
unnamed: R4.1, U1.41 (RSVD)
unnamed: R5.1, U1.42 (RSVD)
unnamed: C26.2, U1.22 (1V2O)
unnamed: R6.1, U1.10 (EXRES1)
unnamed: C27.1, U1.20 (TOCAP)
RES: J1.3 (GP18), R9.1, U1.37 (~RST)
RXN: R37.2, U1.5 (RXN)
RXP: R36.2, U1.6 (RXP)
SCLK: Card1.5 (CLX), J1.4 (GP26), U1.33 (SCLK)
SCS_SD: Card1.2 (CD/DAT3), J1.1 (GP16)
SCSn: J1.7 (GP29), R21.2, U1.32 (~SCS)
TXN: R35.2, U1.1 (TXN)
TXP: R34.2, U1.2 (TXP)
VCC2: J1.10 (VCC2); also elsewhere on the board
XI: U1.30 (XI/CLKIN), X1.3 (OUT)
XO: U1.31 (XO)

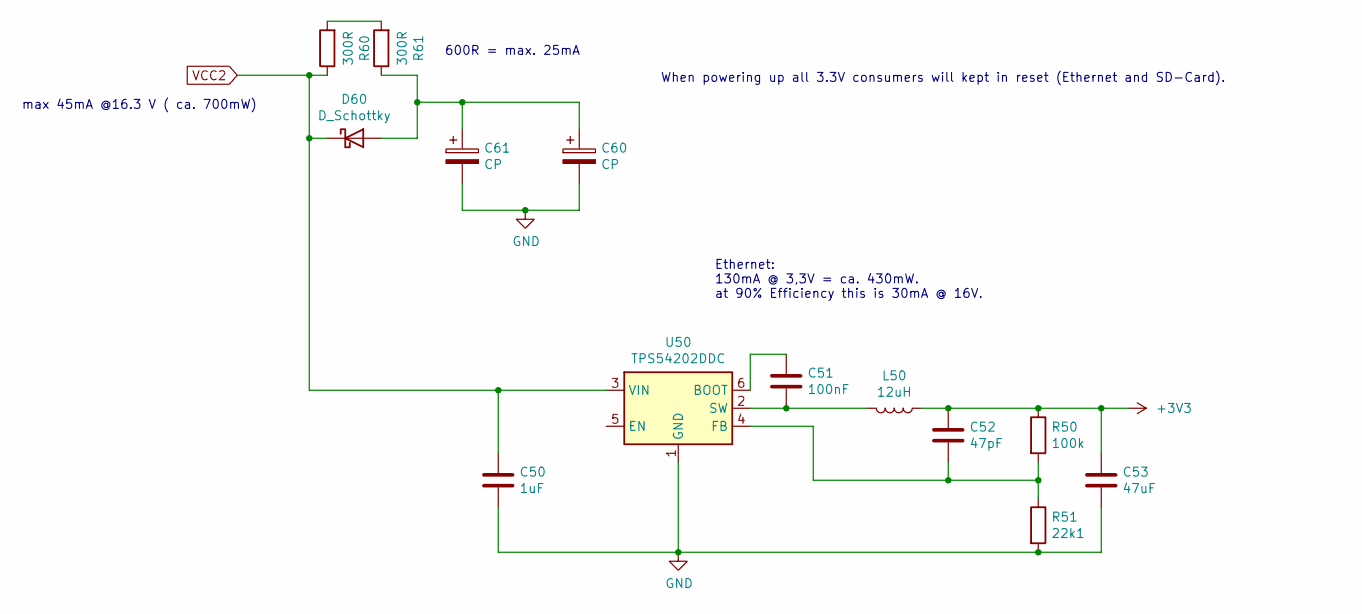
[picture p218: schematic stepdown.kicad_sch, REG1-App-Eth]

Parts:
C50: 1uF; C_0805_2012Metric
C51: 100nF; C_0603_1608Metric
C52: 47pF; C_0603_1608Metric
C53: 47uF; C_1206_3216Metric
C60, C61: CP; CP_Radial_D10.0mm_H20.0mm_P5.00mm_Horizontal
D60: D_Schottky; D_SOD-323
L50: 12uH; C96886_IND-SMD_L4.0-W4.0_Handsolder
R50: 100k; R_0603_1608Metric
R51: 22k1; R_0603_1608Metric
R60, R61: 300R; R_1206_3216Metric
U50: TPS54202DDC; SOT-23-6_Handsoldering

Connections:
+3V3: C52.1, C53.1, L50.1, R50.1; also elsewhere on the board
GND: C50.2, C53.2, C60.2, C61.2, R51.2, U50.1 (GND); also elsewhere on the board
unnamed: C60.1, C61.1, D60.2 (A), R61.1
unnamed: R60.2, R61.2
unnamed: C51.1, U50.6 (BOOT)
unnamed: C52.2, R50.2, R51.1, U50.4 (FB)
unnamed: C51.2, L50.2, U50.2 (SW)
VCC2: C50.1, D60.1 (K), R60.1, U50.3 (VIN); also elsewhere on the board

Notes on the sheet:
max 45mA @16.3 V ( ca. 700mW)
Ethernet: 130mA @ 3,3V = ca. 430mW. at 90% Efficiency this is 30mA @ 16V.
When powering up all 3.3V consumers will kept in reset (Ethernet and SD-Card).
600R = max. 25mA

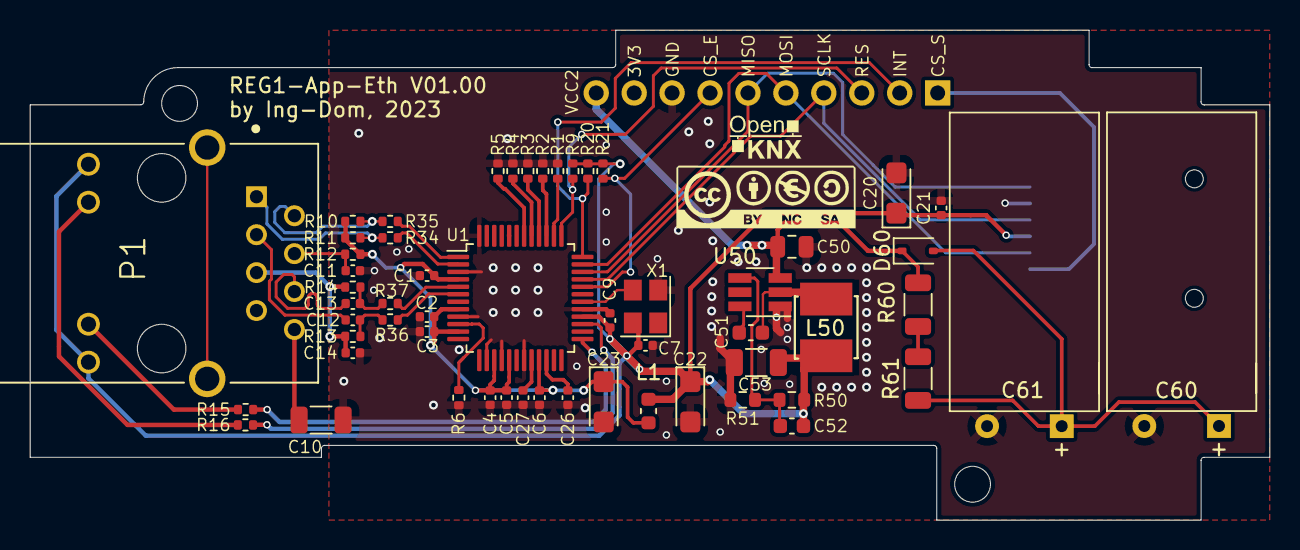
[picture p219: board REG1-App-Eth.kicad_pcb from above]

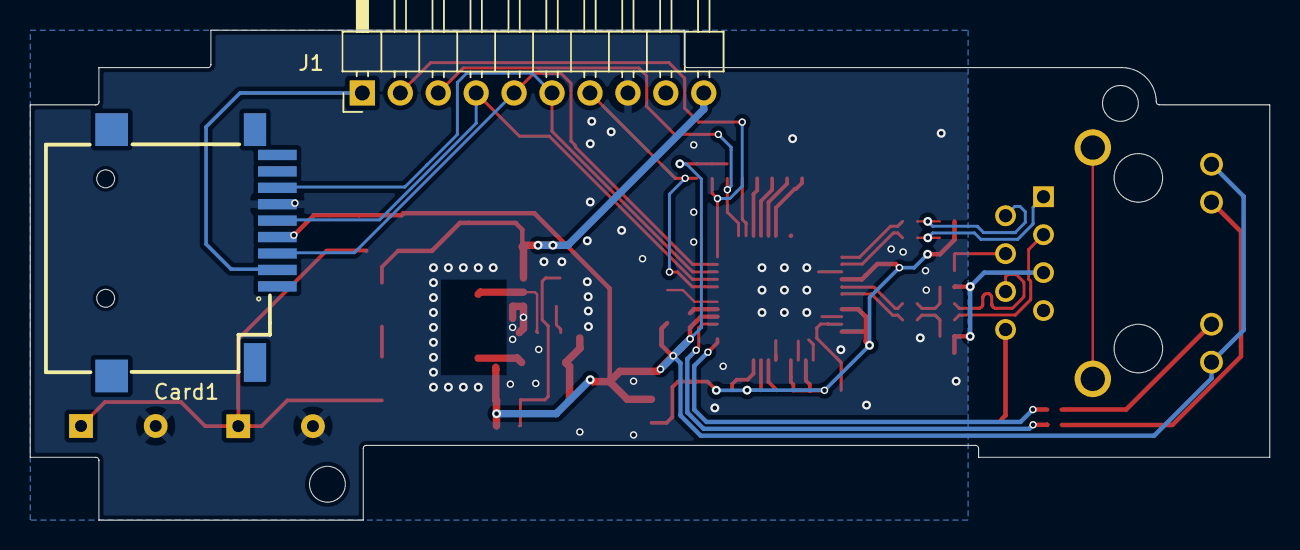
[picture p220: board REG1-App-Eth.kicad_pcb from below]

Board: 2 copper layers, 83.0 x 32.8 mm, 60 parts (2 on the bottom side), 43 nets.

Other parts of the board:
G1: LOGO; CC-BY-NY-SA_12x4
G2: LOGO; OpenKNX_Logo_6x6
