OpenKNX/OpenKNX-REG1/hardware/EDA-Files/REG1-Front-Universal/REG1-Front-Universal.kicad_pcb

## KiCad design hardware/EDA-Files/REG1-Front-Universal/REG1-Front-Universal.kicad_pcb (2025-01-09)

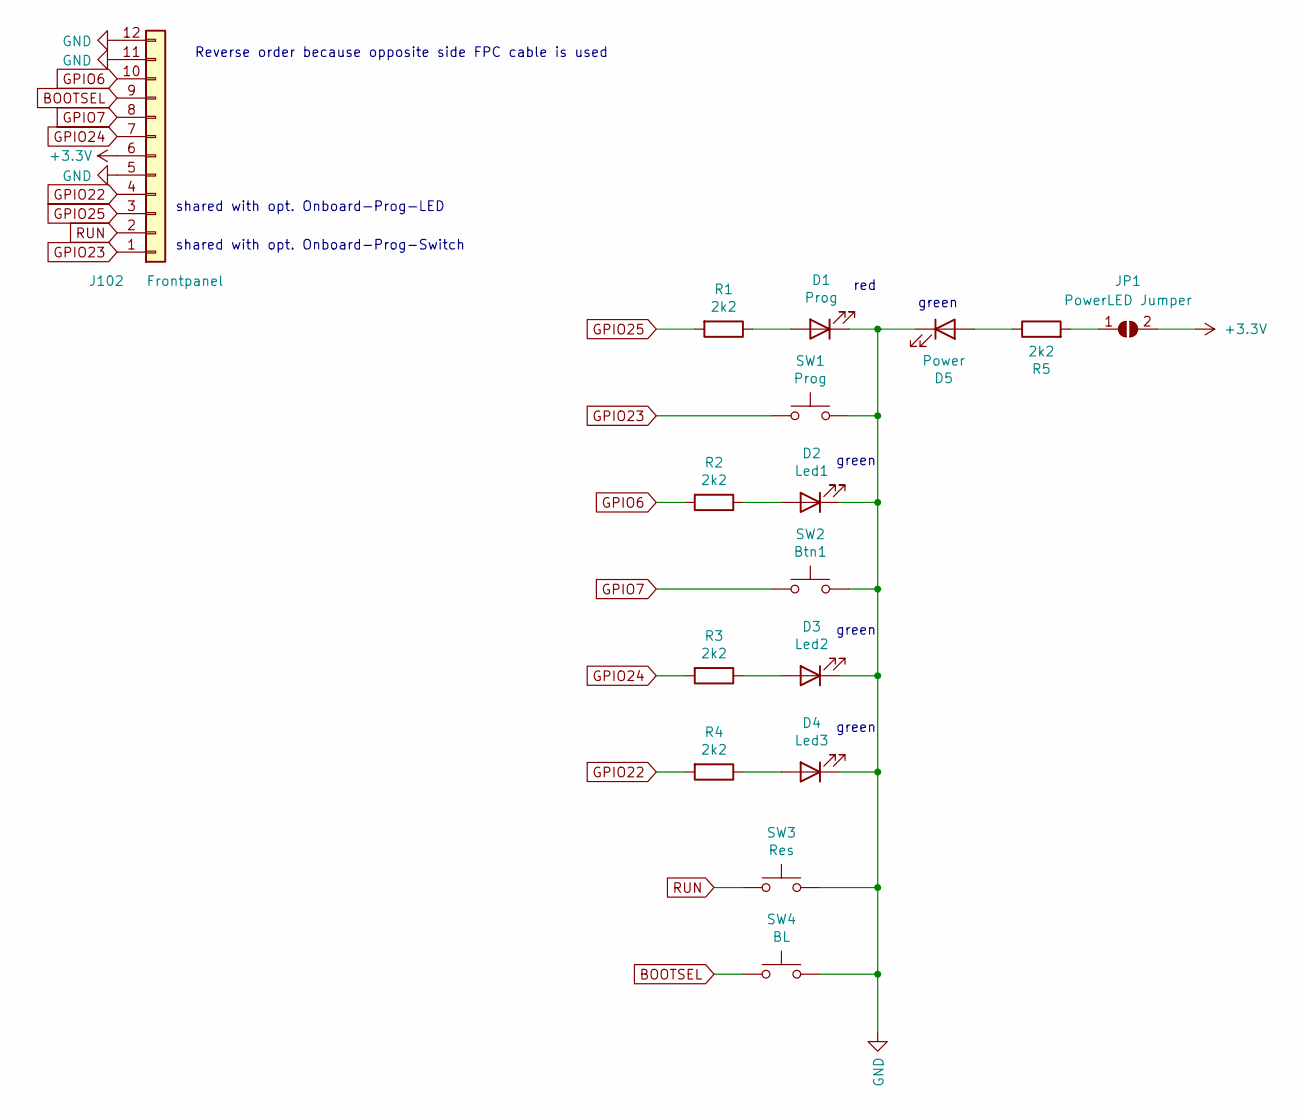
[picture p221: schematic REG1-Front-Universal.kicad_sch]

Parts:
D1: Prog; LED_0603_1608Metric
D2: Led1; LED_0603_1608Metric
D3: Led2; LED_0603_1608Metric
D4: Led3; LED_0603_1608Metric
D5: Power; LED_0603_1608Metric
J102: Frontpanel; C11050_FPC-SMD_P0.5-10P_LSXJ-H2.0-10P
JP1: PowerLED Jumper; SolderJumper-2_P1.3mm_Open_RoundedPad1.0x1.5mm
R1, R2, R3, R4, R5: 2k2; R_0402_1005Metric
SW1: Prog; C455282_SW-SMD_4P-L4.2-W3.3-P2.15-LS5.1
SW2: Btn1; C455282_SW-SMD_4P-L4.2-W3.3-P2.15-LS5.1
SW3: Res; C455282_SW-SMD_4P-L4.2-W3.3-P2.15-LS5.1
SW4: BL; C455282_SW-SMD_4P-L4.2-W3.3-P2.15-LS5.1

Connections:
+3.3V: JP1.2 (B); also elsewhere on the board
BOOTSEL: SW4.1; also elsewhere on the board
GND: D1.1 (K), D2.1 (K), D3.1 (K), D4.1 (K), D5.1 (K), SW1.2, SW2.2, SW3.2, SW4.2; also elsewhere on the board
GPIO6: R2.2; also elsewhere on the board
GPIO7: SW2.1; also elsewhere on the board
GPIO22: R4.2; also elsewhere on the board
GPIO23: SW1.1; also elsewhere on the board
GPIO24: R3.2; also elsewhere on the board
GPIO25: R1.2; also elsewhere on the board
unnamed: D1.2 (A), R1.1
unnamed: D2.2 (A), R2.1
unnamed: D3.2 (A), R3.1
unnamed: D4.2 (A), R4.1
unnamed: D5.2 (A), R5.1
unnamed: JP1.1 (A), R5.2
RUN: SW3.1; also elsewhere on the board

Notes on the sheet:
green
red
Reverse order because opposite side FPC cable is used
shared with opt. Onboard-Prog-Switch
shared with opt. Onboard-Prog-LED

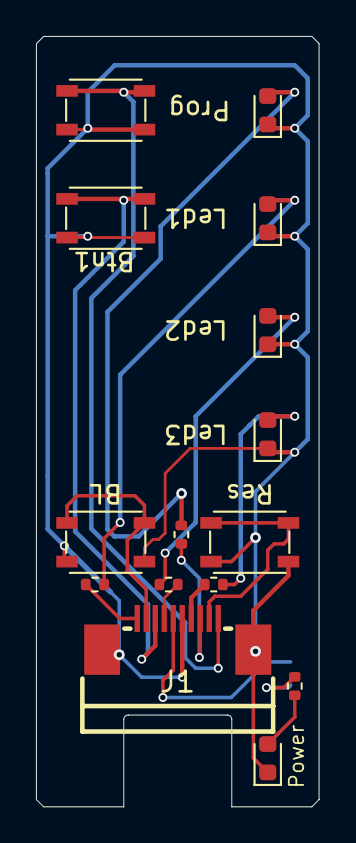
[picture p222: board REG1-Front-Universal.kicad_pcb from above]

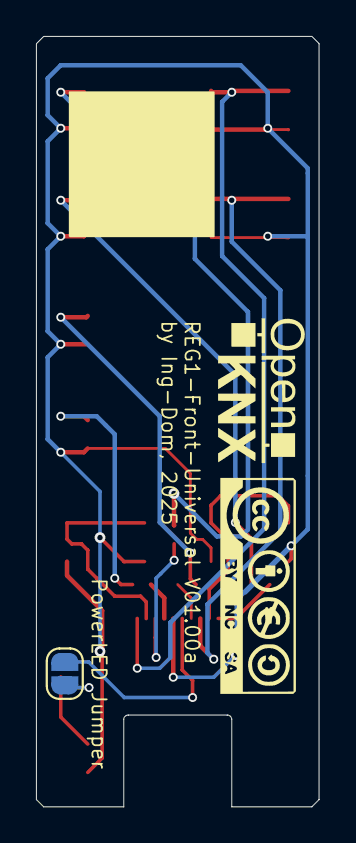
[picture p223: board REG1-Front-Universal.kicad_pcb from below]

Board: 2 copper layers, 15.7 x 42.8 mm, 18 parts (3 on the bottom side), 16 nets.

Other parts of the board:
G1: LOGO; OpenKNX_Logo_10x10
G2: LOGO; CC-BY-NY-SA_12x4
J1: Frontpanel; C11050_FPC-SMD_P0.5-10P_LSXJ-H2.0-10P

Their connections:
+3.3V: J1.6; also elsewhere on the board
BOOTSEL: J1.9; also elsewhere on the board
GND: J1.5, J1.11, J1.12; also elsewhere on the board
GPIO6: J1.10; also elsewhere on the board
GPIO7: J1.8; also elsewhere on the board
GPIO22: J1.4; also elsewhere on the board
GPIO23: J1.1; also elsewhere on the board
GPIO24: J1.7; also elsewhere on the board
GPIO25: J1.3; also elsewhere on the board
RUN: J1.2; also elsewhere on the board
