OpenKNX/OpenKNX-REG1/hardware/EDA-Files/REG1-App-Universal/REG1-App-Universal.kicad_pcb

## KiCad design hardware/EDA-Files/REG1-App-Universal/REG1-App-Universal.kicad_pcb (2024-12-03)

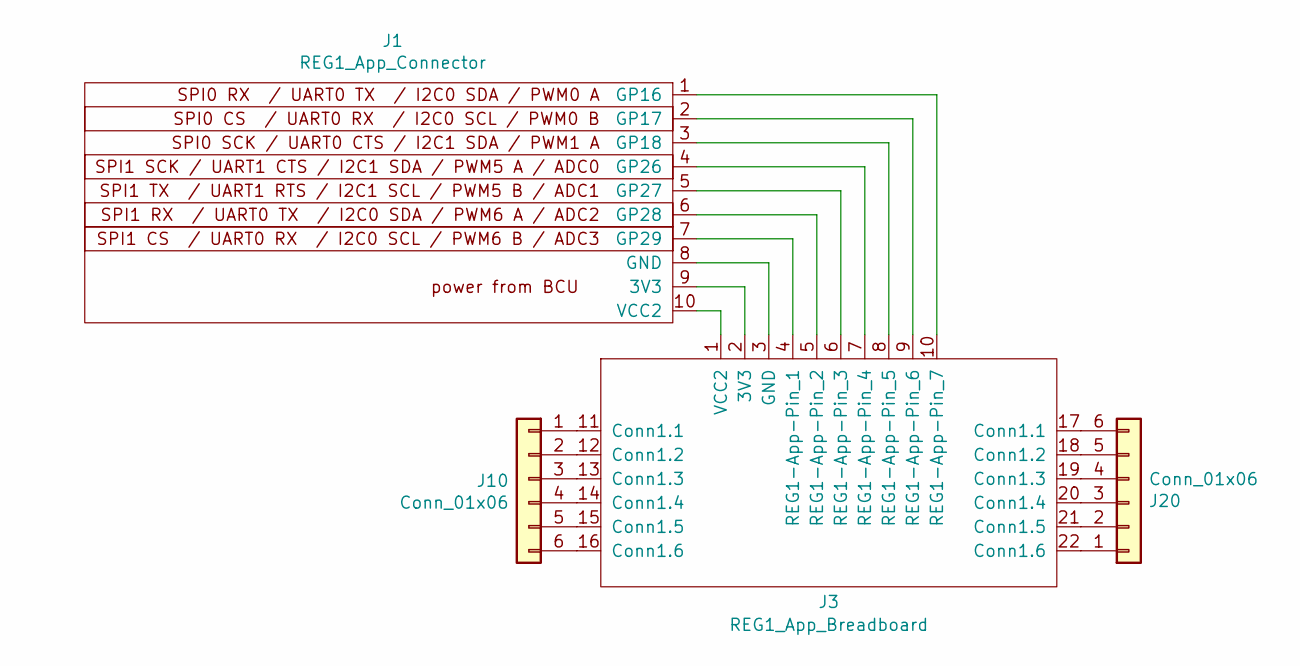
[picture p224: schematic REG1-App-Universal.kicad_sch]

Parts:
J1: REG1_App_Connector; PinHeader_1x10_P2.54mm_Horizontal; LCSC C706873
J3: REG1_App_Breadboard
J10, J20: Conn_01x06; PhoenixContact_MC_1,5_6-G-3.5_1x06_P3.50mm_Horizontal; LCSC C441175

Connections:
unnamed: J1.9 (3V3), J3.2 (3V3)
unnamed: J1.8 (GND), J3.3 (GND)
unnamed: J1.1 (GP16), J3.10 (REG1-App-Pin_7)
unnamed: J1.2 (GP17), J3.9 (REG1-App-Pin_6)
unnamed: J1.3 (GP18), J3.8 (REG1-App-Pin_5)
unnamed: J1.4 (GP26), J3.7 (REG1-App-Pin_4)
unnamed: J1.5 (GP27), J3.6 (REG1-App-Pin_3)
unnamed: J1.6 (GP28), J3.5 (REG1-App-Pin_2)
unnamed: J1.7 (GP29), J3.4 (REG1-App-Pin_1)
unnamed: J1.10 (VCC2), J3.1 (VCC2)
unnamed: J3.11 (Conn1.1), J10.1
unnamed: J3.12 (Conn1.2), J10.2
unnamed: J3.13 (Conn1.3), J10.3
unnamed: J3.14 (Conn1.4), J10.4
unnamed: J3.15 (Conn1.5), J10.5
unnamed: J3.16 (Conn1.6), J10.6
unnamed: J3.22 (Conn1.6), J20.1
unnamed: J3.21 (Conn1.5), J20.2
unnamed: J3.20 (Conn1.4), J20.3
unnamed: J3.19 (Conn1.3), J20.4
unnamed: J3.18 (Conn1.2), J20.5
unnamed: J3.17 (Conn1.1), J20.6

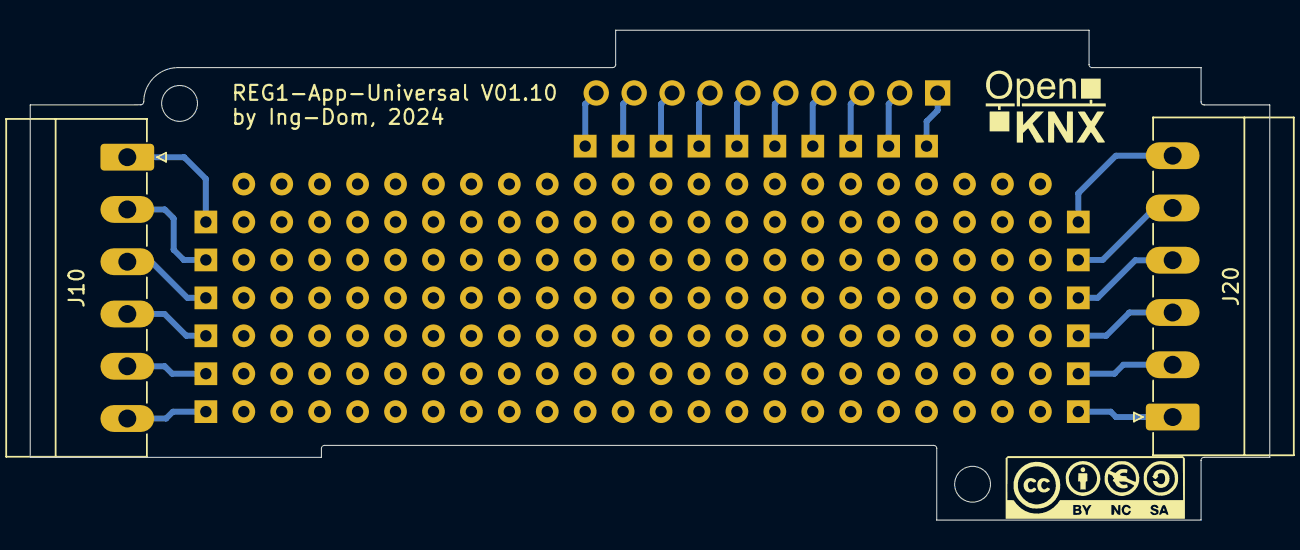
[picture p225: board REG1-App-Universal.kicad_pcb from above]

Board: 2 copper layers, 83.0 x 32.8 mm, 6 parts (1 on the bottom side), 22 nets.

Other parts of the board:
G*: LOGO; CC-BY-NY-SA_12x4
G*#2: LOGO; OpenKNX_Logo_10x10
