OpenKNX/OpenKNX-REG1/hardware/EDA-Files/REG1-App-GW-RF2G4/REG1-App-GW-RF2G4.kicad_pcb

## KiCad design hardware/EDA-Files/REG1-App-GW-RF2G4/REG1-App-GW-RF2G4.kicad_pcb (2024-07-29)

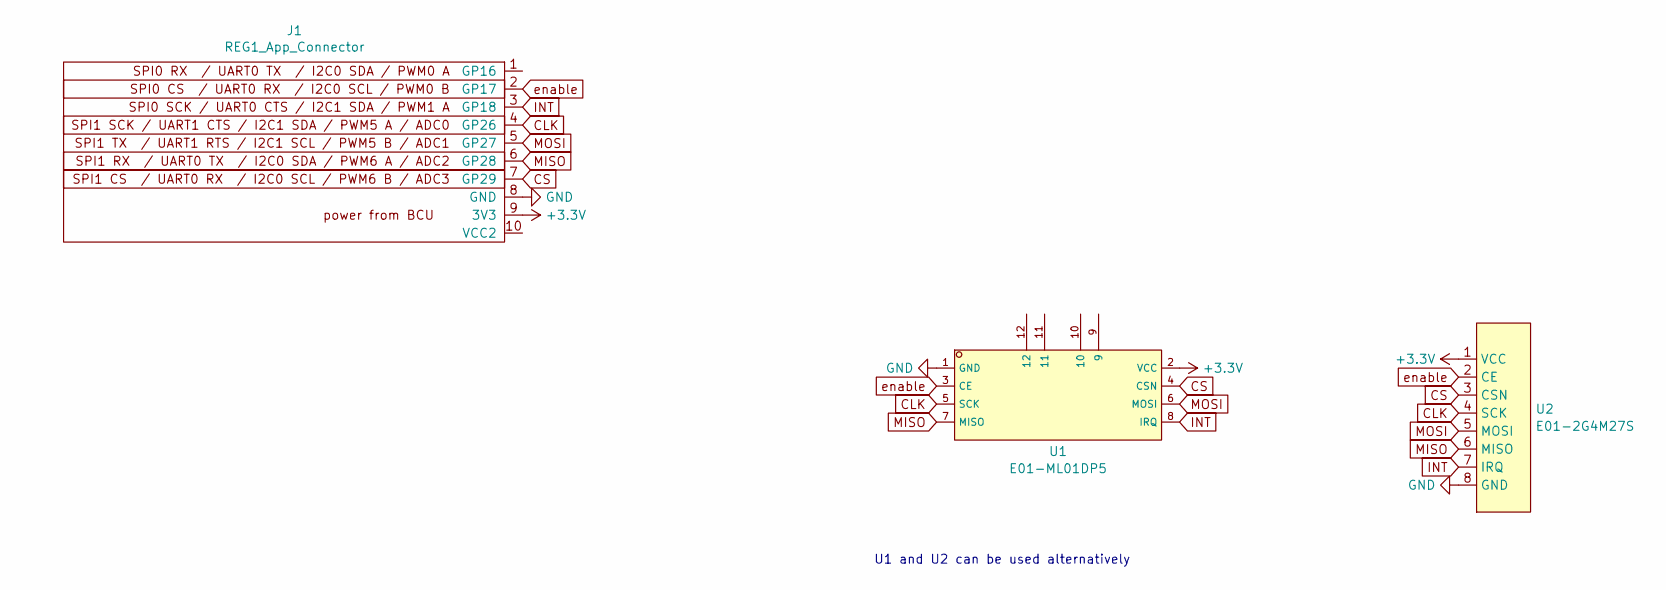
[picture p226: schematic REG1-App-GW-RF2G4.kicad_sch]

Parts:
J1: REG1_App_Connector; PinHeader_1x10_P2.54mm_Horizontal
U1: E01-ML01DP5; WIRELM-TH_E01-ML01DP5; LCSC C97339
U2: E01-2G4M27S; C2971732_WIRELM-SMD_10P-L23.0-W14.0-P1.27_E01-2G4M27S_Hands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; LCSC Part C2971732

Connections:
+3.3V: J1.9 (3V3), U1.2 (VCC), U2.1 (VCC)
CLK: J1.4 (GP26), U1.5 (SCK), U2.4 (SCK)
CS: J1.7 (GP29), U1.4 (CSN), U2.3 (CSN)
GND: J1.8 (GND), U1.1 (GND), U2.8 (GND), U2.9 (GND), U2.10 (GND)
INT: J1.3 (GP18), U1.8 (IRQ), U2.7 (IRQ)
MISO: J1.6 (GP28), U1.7 (MISO), U2.6 (MISO)
MOSI: J1.5 (GP27), U1.6 (MOSI), U2.5 (MOSI)
enable: J1.2 (GP17), U1.3 (CE), U2.2 (CE)

Notes on the sheet:
U1 and U2 can be used alternatively

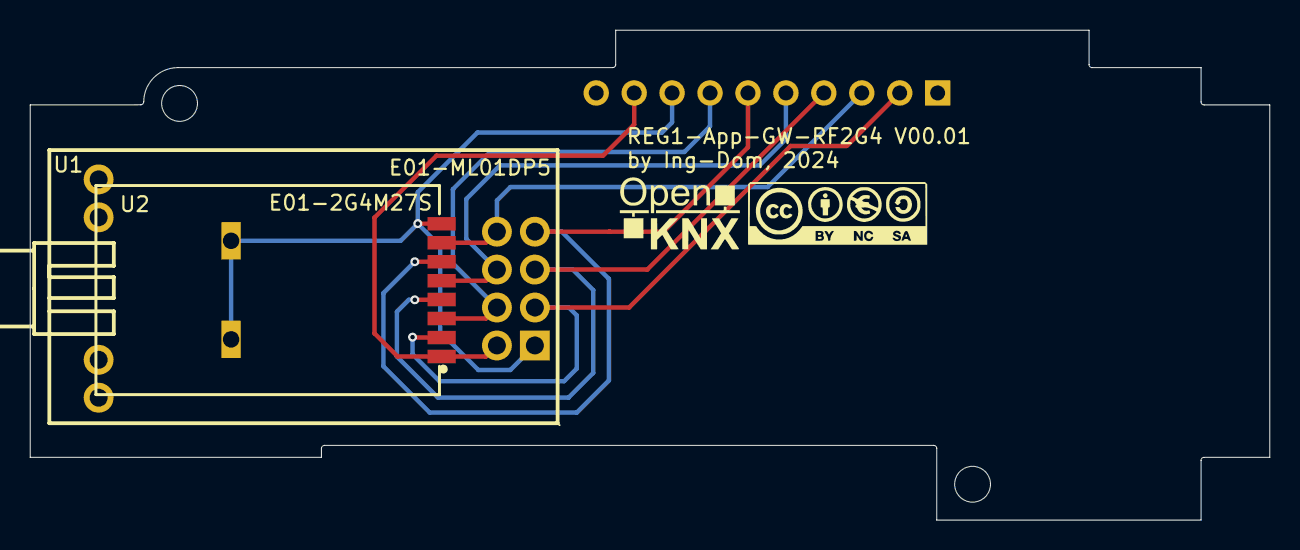
[picture p227: board REG1-App-GW-RF2G4.kicad_pcb from above]

Board: 2 copper layers, 83.0 x 32.8 mm, 4 parts (1 on the bottom side), 8 nets.

Other parts of the board:
G1: LOGO; CC-BY-NY-SA_12x4
