OpenKNX/OpenKNX-REG1/hardware/EDA-Files/REG1-App-Dali/REG1-App-Dali.kicad_pcb

## KiCad design hardware/EDA-Files/REG1-App-Dali/REG1-App-Dali.kicad_pcb (2024-01-25)

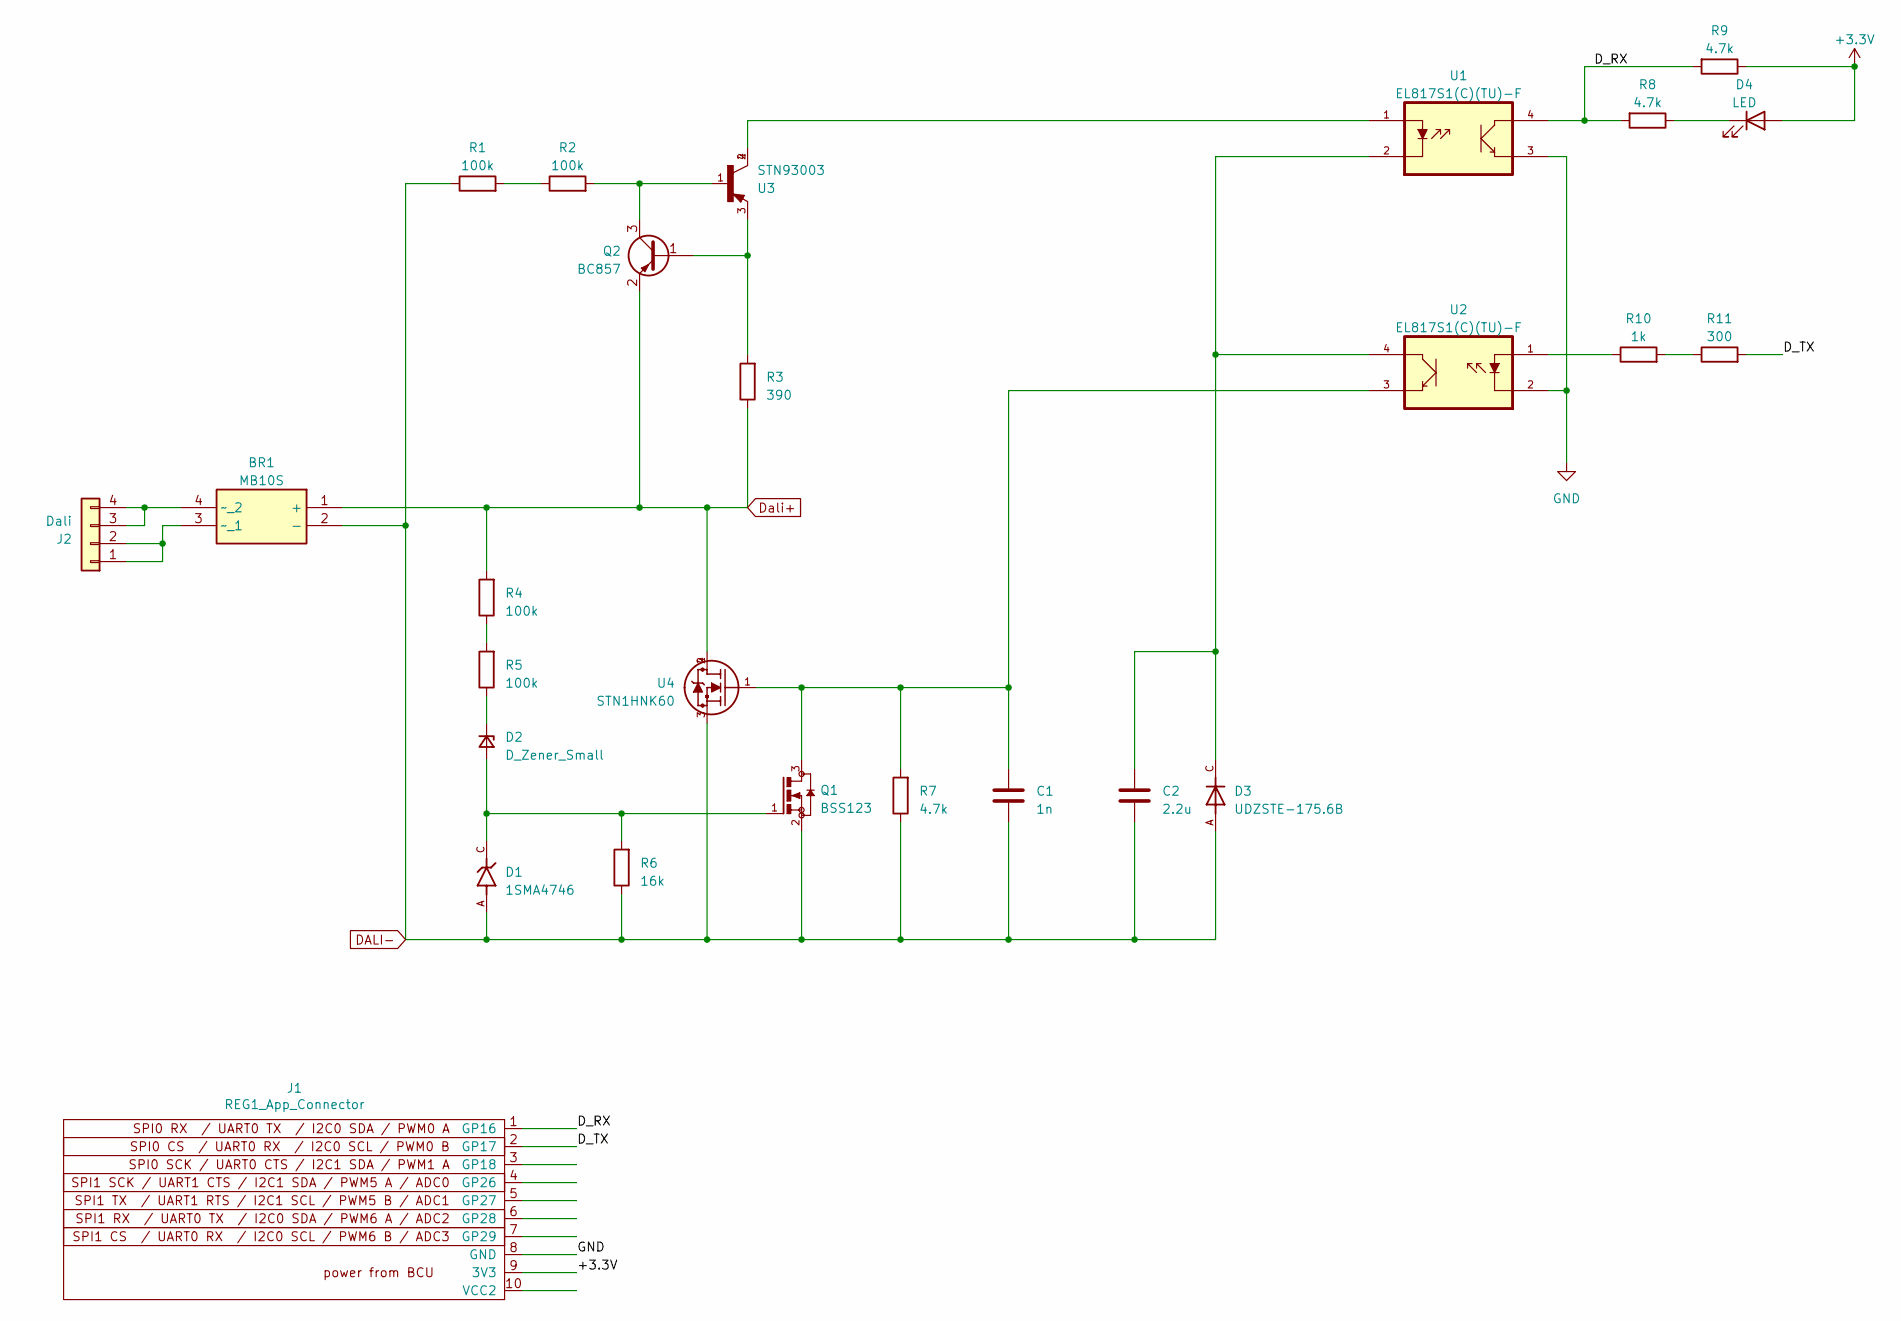
[picture p228: schematic REG1-App-Dali.kicad_sch]

Parts:
BR1: MB10S; SOP245P670X290-4N; Manufacturer_Part_Number MB10S; Mouser Part Number 512-MB10S
C1: 1n; C_0603_1608Metric; LCSC C1588
C2: 2.2u; C_0805_2012Metric; LCSC C49217
D1: 1SMA4746; DIOM4325X250N; PARTREV B2102; LCSC C260228
D2: D_Zener_Small; D_SOD-123; LCSC C111753
D3: UDZSTE-175.6B; SODFL2512X90N; LCSC C122985
D4: LED; LED_0603_1608Metric; LCSC C2290
J1: REG1_App_Connector; PinHeader_1x10_P2.54mm_Horizontal; LCSC C492418
J2: Dali; PhoenixContact_MC_1,5_4-G-3.5_1x04_P3.50mm_Horizontal; LCSC C441173
Q1: BSS123; SOT-23; LCSC C431506
Q2: BC857; SOT-23; LCSC C8666
R1, R2, R4, R5: 100k; R_1206_3216Metric; LCSC C17900
R3: 390; R_0603_1608Metric; LCSC C23151
R6: 16k; R_0805_2012Metric; LCSC C17490
R7, R8, R9: 4.7k; R_0603_1608Metric; LCSC C23162
R10: 1k; R_1206_3216Metric; LCSC C4410
R11: 300; R_1206_3216Metric; LCSC C17887
U1, U2: EL817S1(C)(TU)-F; SOIC254P1030X390-4N; LCSC C106900
U3: STN93003; SOT230P700X180-4N; LCSC C880083
U4: STN1HNK60; SOT-223; MANUFACTURER_PART_NUMBER STN1HNK60; LCSC C39303

Connections:
+3.3V: D4.2 (A), J1.9 (3V3), R9.1
/D_RX: J1.1 (GP16), R8.2, R9.2, U1.4
/D_TX: J1.2 (GP17), R11.2
DALI-: BR1.2 (-), C1.2, C2.2, D1.A, D3.A, Q1.2, R1.1, R6.1, R7.1, U4.3
Dali+: BR1.1 (+), Q2.2 (E), R3.1, R4.2, U4.2, U4.4
GND: J1.8 (GND), U1.3, U2.2
unnamed: BR1.3 (~_1), J2.1, J2.2
unnamed: BR1.4 (~_2), J2.3, J2.4
unnamed: C1.1, Q1.3, R7.2, U2.3, U4.1
unnamed: C2.1, D3.C, U1.2, U2.4
unnamed: D1.C, D2.2 (A), Q1.1, R6.2
unnamed: D2.1 (K), R5.1
unnamed: D4.1 (K), R8.1
unnamed: Q2.1 (B), R3.2, U3.3
unnamed: Q2.3 (C), R2.2, U3.1
unnamed: R1.2, R2.1
unnamed: R4.1, R5.2
unnamed: R10.1, U2.1
unnamed: R10.2, R11.1
unnamed: U1.1, U3.2, U3.4

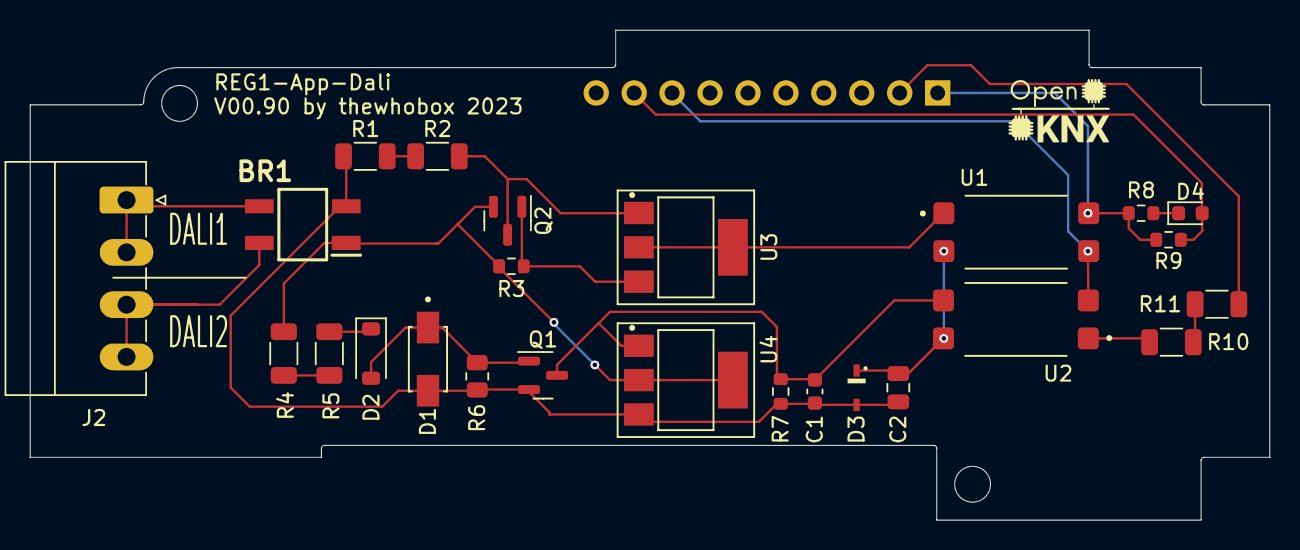
[picture p229: board REG1-App-Dali.kicad_pcb from above]

Board: 2 copper layers, 83.0 x 32.8 mm, 26 parts (1 on the bottom side), 20 nets.
