OpenKNX/OpenKNX-REG1/(commit log)

2022-11-02 added prototype renderings
2022-11-02 REG1-App-Universal V00.01 and REG1-Front-Universal V00.01
    [REG1-App-Universal-B_Cu.gbr, REG1-App-Universal-B_Mask.gbr, REG1-App-Universal-B_Paste.gbr, REG1-App-Universal-B_SilkS.gbr, REG1-App-Universal-Edge_Cuts.gbr, REG1-App-Universal-F_Cu.gbr, REG1-App-Universal-F_Mask.gbr, REG1-App-Universal-F_Paste.gbr]
2022-11-04 rotate connector, rotate switches, 0.2mm smaller on each side, corrected pinout of connector
    [REG1-Front-Universal.kicad_pcb, REG1-Front-Universal.sch]
2022-11-05 Front V00.02
    [REG1-Front-Universal-BOM-JLC.xls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]
2022-11-05 REG1-App-Universal V00.02
    [REG1-App-Universal-B_Cu.gbr, REG1-App-Universal-B_Mask.gbr, REG1-App-Universal-B_Paste.gbr, REG1-App-Universal-B_SilkS.gbr, REG1-App-Universal-Edge_Cuts.gbr, REG1-App-Universal-F_Cu.gbr, REG1-App-Universal-F_Mask.gbr, REG1-App-Universal-F_Paste.gbr]
2022-11-05 added missing drl files to App-Universal V00.02
    [REG1-App-Universal-NPTH.drl, REG1-App-Universal-PTH.drl]
2022-11-21 added pictures fo assembly
2023-01-04 added Case stls REG1-Controller-Module-Case_V01.00 REG1-Case_V01.00
    [REG1-Controller-Module-Case-Bottom.stl, REG1-Controller-Module-Case-Top.stl, Reg1_Case_Cover.stl, Reg1_Case_Cover_SWD.stl, Reg1_Main_Case.stl]
2023-01-28 fixed schematic
2023-01-28 added red led
    [REG1-Front-Universal-BOM-JLC.xls]
2023-01-28 added Panel
    [REG1-Front-Universal - Kopie-B_Cu.gbr, REG1-Front-Universal - Kopie-B_Mask.gbr, REG1-Front-Universal - Kopie-B_Paste.gbr, REG1-Front-Universal - Kopie-B_SilkS.gbr, REG1-Front-Universal - Kopie-Edge_Cuts.gbr, REG1-Front-Universal - Kopie-F_Cu.gbr, REG1-Front-Universal - Kopie-F_Mask.gbr, REG1-Front-Universal - Kopie-F_Paste.gbr]
2023-01-31 editorial V00.10 of App-Universal
    [REG1-App-Universal-B_Cu.gbr, REG1-App-Universal-B_Mask.gbr, REG1-App-Universal-B_Paste.gbr, REG1-App-Universal-B_SilkS.gbr, REG1-App-Universal-Edge_Cuts.gbr, REG1-App-Universal-F_Cu.gbr, REG1-App-Universal-F_Mask.gbr, REG1-App-Universal-F_Paste.gbr]
2023-10-15 REG1-App-Universal V00.90
    [REG1-App-Universal-B_Silkscreen.dxf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]
2023-10-18 added REG1-App-8xBE
    [REG1-App-8xBE.kicad_pcb, REG1-App-8xBE.kicad_sch, REG1-App-8xBE.sch, REG1-App-8xBE.xml]
2023-10-19 wip 8xBE
    [REG1-App-8xBE.kicad_pcb, REG1-App-8xBE.kicad_sch]
2023-11-06 REG1-Front-Universal V01.00
    [REG1-Front-Universal - Kopie-B_Cu.gbr, REG1-Front-Universal - Kopie-B_Mask.gbr, REG1-Front-Universal - Kopie-B_Paste.gbr, REG1-Front-Universal - Kopie-B_SilkS.gbr, REG1-Front-Universal - Kopie-Edge_Cuts.gbr, REG1-Front-Universal - Kopie-F_Cu.gbr, REG1-Front-Universal - Kopie-F_Mask.gbr, REG1-Front-Universal - Kopie-F_Paste.gbr]
2023-11-13 increased size of Front-Universal, WIP
    [REG1-Front-Universal.kicad_pcb]
2023-11-13 new V01.00 (some 0.1 bigger)
    [REG1-Front-Universal-B_Silkscreen.dxf, REG1-Front-Universal-F_Silkscreen.dxf, REG1-Front-Universal.kicad_pcb, REG1-Front-Universal_Panel1x5.kicad_pcb, REG1-Front-Universal_wo_frame-B_Silkscreen.dxf, REG1-Front-Universal_wo_frame-F_Silkscreen.dxf, REG1-Front-Universal_wo_frame.kicad_pcb, bom.csv]
2023-11-14 added Pictures for REG1 V1 devices
2023-12-09 added STLs for REG1-Case V1
    [REG1-Case-Front-Universal_V01.00.stl, REG1-Case-Front-Universal_V01.00_Base.3mf, REG1-Case-Front-Universal_V01.00_Dali.3mf, REG1-Case-Front-Universal_V01.00_Eth.3mf, REG1-Case-Front-Universal_V01.00_wLogo_wText_all.3mf, REG1-Controller-Module-Case-Bottom.stl, REG1-Controller-Module-Case-Top.stl, Reg1_CaseIP_Cover_V01.00.stl]
2023-12-14 added schematics
2024-01-25 added App-Dali
    [REG1-App-Dali.kicad_pcb, REG1-App-Dali.kicad_sch, REG1-App-Dali.xml]
2024-07-26 draft RF App
    [REG1-App-GW-RF2G4.kicad_pcb, REG1-App-GW-RF2G4.kicad_sch, REG1-App-GW-RF2G4.xml]
2024-07-28 wip GW RF
    [REG1-App-GW-RF2G4.kicad_pcb, REG1-App-GW-RF2G4.kicad_sch]
2024-07-29 App-GW-RF2G4 V00.01
    [REG1-App-GW-RF2G4.kicad_pcb, REG1-App-GW-RF2G4.kicad_sch, REG1-App-GW-RF2G4_V00.01.step, bom.csv, designators.csv, positions.csv]
2024-08-03 GW RF2G4 V00.01
    [REG1-App-GW-RF2G4.kicad_sch, REG1-App-GW-RF2G4_V00.01.step, bom.csv, designators.csv, positions.csv]
2024-08-05 remove draft for App-8xBE
    [REG1-App-8xBE.kicad_pcb, REG1-App-8xBE.kicad_sch, REG1-App-8xBE.sch, REG1-App-8xBE.xml]
2024-12-03 REG1-App-Universal - editorial rework V01.10
    [REG1-App-Universal-B_Silkscreen.dxf, REG1-App-Universal-F_Silkscreen.dxf, REG1-App-Universal.kicad_pcb, REG1-App-Universal.kicad_sch, REG1-App-Universal.sch, REG1-App-Universal_V01.00.step, REG1-App-Universal_V01.10.step, bom.csv]
2024-12-20 app eth done
    [REG1-App-Eth.kicad_pcb, REG1-App-Eth.kicad_sch, REG1-App-Eth.sch, REG1-App-Eth.xml, stepdown.kicad_sch, stepdown.sch]
2024-12-20 add IPController
    [REG1-App-Eth.kicad_sch, REG1-IpController2040.kicad_pcb, REG1-IpController2040.kicad_sch, controller.kicad_sch, stepdown.kicad_sch]
2025-01-09 completed schematics in doc
2025-02-02 add REG1-Dali V01.20 stuff
    [REG1-Case-Front-Universal_RGB_V01.20.stl, Reg1_Case_Cover_wDali_noDebug_noIO_V01.20.stl, Reg1_Case_Cover_wDali_wDebug_noIO_V01.20.stl, Reg1_Case_Main_wDali_noIO_V01.20.stl, Reg1_Case_SpringClamp.stp]
2025-02-05 add REG1-Controller2040
    [REG1-App-2xDALI.xml, REG1-App-Eth.xml, REG1-App-GW-RF2G4.xml, REG1-App-Universal.xml, REG1-Controller2040.kicad_pcb, REG1-Controller2040.kicad_sch, REG1-Controller2040.sch, bom.csv]
2025-07-13 REG1 Case V01.20 STL compilation
    [REG1-Case-Front-Universal_RGB_Diffusor_V01.20.stl, REG1-Case-Front-Universal_RGB_V01.20.stl, Reg1_CaseIP_Cover_ESP_LAN_V01.20.stl, Reg1_CaseIP_Cover_LAN-Dali_V01.20.stl, Reg1_CaseIP_Main_ESP_LAN_v01.20.stl, Reg1_CaseIP_Main_LAN-Dali_V01.20.stl, Reg1_Case_Cover_Universal_V01.20.stl, Reg1_Case_Cover_Universal_wDebug_V01.20.stl]
2025-07-31 update REG1-Case-IP
    [Reg1_CaseIP_Main_ESP_LAN_V01.20a.stl]
2025-11-26 add REG1-App-SEN-Multi
    [REG1-App-SEN-Multi.kicad_pcb, REG1-App-SEN-Multi.kicad_sch]
2026-04-14 NanoDCU V00.02
    [NanoDCU.kicad_pcb, NanoDCU.kicad_sch, NanoDCU.step]
2026-04-14 REG1-Front-RGB V00.01
    [REG1-Front-RGB.kicad_pcb, REG1-Front-RGB.kicad_sch]
2026-04-21 add older REG1-ControllerESP schematics
2026-05-01 REG1-App-SEN-Multi V01.00 - editorial change to V01.00 after Beta
    [REG1-App-SEN-Multi.kicad_pcb, REG1-App-SEN-Multi.kicad_sch]
