OpenKNX/OpenKNX-REG1/(notices)

Notices in the files:
hardware/EDA-Files/REG1-App-Eth/REG1-App-Eth.kicad_sch:
OpenKNX Open Hardware under CC BY-NC-SA 4.0
hardware/EDA-Files/REG1-IpController2040/REG1-IpController2040.kicad_pcb:
© Ing-Dom, 2023
hardware/EDA-Files/NanoDCU/NanoDCU.kicad_sch:
CC BY-NC-SA 4.0 https://creativecommons.org/licenses/by-nc-sa/4.0/legalcode.de
